2AMLogic/sky130-ldo/sim/README.md

# sim/ — the simulation harness and its evidence records

This directory holds the reproducible xschem + ngspice + sky130 harness and the
results it produces. Two rules from the root `CLAUDE.md` shape everything here:

- **Verification is the product.** No claim without a testbench. Every recorded
  result carries a PVT corner matrix unless the record states why a subset was
  used — the runner *enforces* that by refusing to write a subset record
  without a `--subset-reason`.
- **`sim/` is append-only evidence.** Records are never edited or deleted. A
  re-run — even one that corrects a mistake — mints a new record id; a
  correction points at what it replaces via a `Supersedes` field. The runner
  refuses to start if the record id it would mint already exists on disk.

The directory layout, record-id scheme and summary-record fields are ported
from the sibling [`sky130-bandgap`](https://github.com/2AMLogic/sky130-bandgap)
repo's harness (same PDK, same pin, issue #2), so the two evidence trails read
as one house style. `pdk-smoke` below is harness plumbing only (PDK/tool
liveness, not a spec claim). The block's own testbenches — `load-transient`,
`psrr-dc`, `dropout-vs-load` (issue #18), `loop-gain` (issue #25) and the three
protection/transient benches `current-limit`, `startup`, `enable-shutdown`
(issue #65) — each
exercise the LDO core-regulation-loop schematic from issue #14
(`design/ldo_3v3in_1v8out.sch`, instantiated via its companion subcircuit
symbol `design/ldo_3v3in_1v8out.sym`) against a row of
`spec/target-spec.md`. That table is **RATIFIED** (issue #1 / DR-006; the Iq
row is the one row DR-006 left open, and is set by `DR-009`, which is still
`proposed` and ratifies on its own PR merge), so every measurement bound
these testbenches use cites a ratified spec row verbatim rather than an
invented "final" number, and each experiment's `claim` says so. Records
minted before ratification quote the manifest `claim` as it then read, in
DRAFT wording — `sim/` evidence is append-only, so that wording stays as
history rather than being rewritten in place. Issues #18 and #25 stood the
harness up with explicit `--quick` subsets (3 corners, `--subset-reason`
cited in the record);
issue #19 ran the full 45-point PVT matrix declared in each experiment's
`experiment.json` for all four (`load-transient`, `psrr-dc`,
`dropout-vs-load`, `loop-gain`), plus a Monte Carlo/mismatch experiment
(`mc-output-accuracy/`, see "Monte Carlo / mismatch experiments" below) for the
one spec row that carries a statistical (population) claim rather than a
PVT-corner claim. Those full-matrix records are pinned to the *current*
schematic (post-#35/#36); the earlier `…-879f035` full-matrix set is superseded
— see "Which record set is authoritative" below. **All four testbenches still
record `FAIL`** against their spec bounds — an honest, expected finding given
this schematic's remaining known gaps (see `design/README.md`'s "Known gaps /
follow-on scope"), not a harness defect. Issue #65's three benches follow the
same two-step shape one issue later: their first records are `--quick`
subsets, and issue #74 then ran the full 45-point matrix each of their
manifests declares (39-42/45 PASS across the three; see "The protection /
transient testbenches (issue #65)" below for per-bench results and #93 for
a new finding the full matrix surfaced). Issue #19's own guardrail — that
none of this was a pass/fail verdict against a *ratified* spec, because #1 was
still open — has since been overtaken: issue #1 ratified the table (DR-006)
and closed 2026-09-18. Records minted before that date cite the row in its
then-current DRAFT wording; records minted since cite the same numbers as
ratified. Ratification fixes the targets — it does not turn any of the
`FAIL`s below into passes. Three further testbenches — `line-regulation`,
`load-regulation` and `iq` (issue #64) — landed later against the three rows
the four above don't cover; they still use discrete `.op` points rather than
the corner runner's usual `.dc`/`.tran` sweep style. They shipped
`--quick`-only at first; issue #104 then ran the full 45-point PVT matrix
each manifest declares for all three, mirroring issue #74's extension of the
#65 benches — see "Line regulation, load regulation and Iq (issue #64)"
below for why the
discrete-point convention was chosen and for the full results.

> **Record-generation note (2026-08-25, issue #69).** Issue #69 re-sized the
> thermal shutdown in the shared DUT schematic and re-ran **eight**
> experiments against it, minting a `…-4cb27f8` generation that supersedes
> the `…-81dc232` (the four PVT benches plus `mc-output-accuracy`) and
> `…-703a889` (the three #65 benches) record ids several per-testbench
> sections below still name. Those sections are kept as written because their
> *analysis* is what the superseded records actually say; for the current
> numbers and the old→new mapping, read "Which record set is authoritative,
> part 2 (issue #69)" below. One verdict changed outright: `current-limit`
> went **overall PASS** on its 3-point subset — though issue #74's later
> full-matrix record now supersedes that subset for the report's purposes,
> see part 2's parallel-landings table.
>
> **Four benches were deliberately *not* part of that re-run, because they
> landed on `main` in parallel with #69's branch and did not exist when it was
> cut**: `line-regulation`, `load-regulation` and `iq` (issue #64) and
> `thermal` (issue #66). All four instantiate the same DUT, so #69's re-sizing
> makes their committed netlist snapshots stale, and
> `measurements/characterization.md` now reports all four `STALE` — correctly,
> and by design rather than by oversight. `sim/thermal`'s 15-point record in
> particular characterizes the **pre-#69** trip points, so its 5/15 verdict
> and every trip/reset number in it must be re-read as "before the fix" until
> that bench is re-run. Two further parallel landings interact with #69's
> re-run the same way — #83's `dropout-vs-load` methodology fix and #76/#86's
> `current-limit` leg-3 enable ramp — and are spelled out in
> `design/README.md` → "Parallel landings on `main`, and what they leave
> stale".

> **Record-generation note (2026-09-23, issue #116).** #116 re-sized the shared
> DUT's **pass device** (`M_PASS` `W_total` 2500 µm → 5000 µm, and `M_SENSE`
> with it to hold the current-limit sense ratio) after DR-011 found DR-003's
> sizing derivation was taken at the wrong bias point — see
> `spec/decision-records/DR-011-pass-device-resize.md` (including its
> 2026-09-23 correction note: an early single-`.op`-point screen claimed a
> clean closure that does not reproduce — trust the full-matrix record below,
> not that screen). It re-ran **one** experiment against the re-sized DUT:
> `dropout-vs-load`, the row it was filed against. New record
> `20260923-123440-d71f4b3` supersedes `20260825-081240-4cb27f8`: **0/45 →
> 6/45 PASS** (best case 268 mV, was 365 mV) — real, substantial improvement at
> `−40 °C`/`27 °C` (all five process corners), but 125 °C corners are
> additionally volatile (5 of 15 points get numerically *worse*, consistent
> with the pre-existing mechanism-4 dc-solution-multiplicity finding
> `design/README.md` already documents, apparently made more pervasive by the
> resize) — read 125 °C `dropout-vs-load` numbers with that same caution, not
> as literal measurements.
>
> **Every other bench here instantiates the same DUT and was deliberately not
> re-run**, exactly as the #69 note above describes: their committed netlist
> snapshots are stale by construction and `measurements/characterization.md`
> reports them `STALE` — correctly, and by design rather than by oversight.
> Read every non-`dropout-vs-load` verdict in this directory as
> **"against the 2500 µm pass device"** until its bench is re-run. The
> `Stability` row deserves particular caution: a wider pass device moves the
> output pole and raises `gm_pass`, `C_COMP`/`R_CZ` were **not** re-derived,
> and `sim/loop-gain`'s 7/45 is a pre-#116 number. A follow-up issue owns the
> campaign re-run; #116's PR names it.

> **Record-generation note (2026-09-25, issue #118).** Three more of the benches
> the #116 note above leaves `STALE` have now been re-run against the re-sized
> DUT, and all three are `fresh` again:
> `mc-output-accuracy` (`20260925-110312-8280915`, supersedes
> `20260825-083111-4cb27f8`: **177/200 → 185/200**),
> `load-regulation` (`20260925-111601-7701e7e`, supersedes
> `20260910-032854-6c0436d`: **34/45 → 37/45**) and
> `line-regulation` (`20260925-114251-1f54ca6`, supersedes
> `20260910-030557-6c0436d`: **18/45 → 24/45**). Every row improved; every row
> still reports `FAIL`. `design/ldo_3v3in_1v8out.sch` is **unchanged** by #118.
>
> **More important than the counts is what #118 found underneath them**, and it
> changes how every number in these three records should be read: the failures
> are not accuracy failures at all. They are points where the circuit is not on
> its intended regulating branch — the mechanism-4 / second-stable-equilibrium
> family `#60`/`#71`/`#81` root-caused, which this issue shows binds all three
> rows and is reachable under **mismatch alone at 27 °C/1 mA**, not only at
> `#81`'s 125 °C/50 mA. Two consequences for reading this directory:
>
> - **Line regulation's own `supply_v` axis is a negative control** — the deck
>   `alter`s VIN itself, so that axis cannot reach the measured quantity — and
>   22 of 30 (group × measurement) cells disagree across it by more than 2×.
>   Its corner-level verdicts are branch-selection outcomes, not measurements.
>   (**#196 named what that axis was reaching instead**: `EN`'s high level,
>   which the bench keyed off `'vsup'` while `VIN` moved independently. With
>   `EN` at the instantaneous VIN the axis is inert by construction, and the
>   45-corner re-run under that convention — record `20260926-200304-35b7392`
>   — brings all 30 of those cells back **identical to every stored digit**:
>   the axis disagreed with itself because it was a stimulus axis after all,
>   through `EN`. See "#196" below.)
> - **On the regulating branch all three rows are inside their bounds**, with
>   exactly one exception in the whole set: `load-regulation`'s
>   `fs_125c_3.63v` at 19.93 mV against 18 mV. That single corner is the only
>   genuine DC-accuracy gap the three rows contain.
>
> The full decomposition, with the per-record numbers behind each claim, is in
> `design/README.md` → "#118: the three DC-accuracy rows do share one
> mechanism…". The design campaign it leaves open is **#164**; the `klt sim`
> request-shape gap that keeps both regulation matrices off the batch fleet is
> 2AMLogic/klayout-tools#2482.

---

## Contents

This file is the harness reference and index. The per-experiment and
per-topic sections below were moved verbatim to `sim/docs/`:

- [Initial-condition contract (issue #171)](docs/initial-condition-contract.md)
- [The LDO's own testbenches (issues #18 and #25)](docs/ldo-testbenches.md)
- [Line regulation, load regulation and Iq (issue #64)](docs/line-load-regulation-iq.md)
- [Monte Carlo / mismatch experiments](docs/monte-carlo-mismatch.md)
- [`sim/selftest.sh` — the harness acceptance test](docs/selftest.md)
- [`check:ci` vs. netlisting the LDO core (issue #38)](docs/check-ci-vs-netlisting.md)
- [Standalone regenerative thermal comparator (#229)](docs/thermal-regen-comparator.md)
- [Integrated regenerative comparator (#230)](docs/integrated-regen-comparator.md)
- [Experiment and solver freshness (#237)](docs/freshness.md)

## Quick start (cold machine)

```bash
# 1. install the pinned PDK (~1 min; see sim/pdk.json for the pin)
volare enable --pdk sky130 c6d73a35f524070e85faff4a6a9eef49553ebc2b

# 2. sanity-check the toolchain and PDK resolution
python3 sim/bin/corner-run.py --check-env

# 3. run the harness acceptance test (unit tests + a quick PVT subset)
sim/selftest.sh --quick

# 4. run the harness smoke test over the full PVT matrix (45 points, ~4 min)
python3 sim/bin/corner-run.py sim/pdk-smoke
```

Prerequisites, all machine-level (not vendored here): `ngspice`, `xschem`,
`volare`, `python3` (3.9+, standard library only). See
`docs/environment-setup.md` for the full reproducible bring-up.

### Driving the tools by hand

```bash
source sim/bin/pdk-env.sh      # exports PDK_ROOT, PDK, SKY130_MODEL_LIB, XSCHEM_RCFILE
xschem --rcfile "$XSCHEM_RCFILE" sim/pdk-smoke/testbench/tb_pdk_smoke.sch
cp sim/spiceinit ./.spiceinit  # ngspice needs these settings to read PDK libs
                               # -- and to pick the same linear solver the
                               # records were produced with (see "Reproducing
                               # a corner by hand" below)
```

`sim/bin/pdk-env.sh` is a thin wrapper around `corner-run.py --print-env`, so
interactive sessions and the runner resolve the PDK identically.

---

## How the harness is wired

| Piece | File | Role |
|---|---|---|
| PDK pin | `sim/pdk.json` | open_pdks commit, variant, model-library path, the process-corner names that actually exist in the PDK library |
| ngspice settings | `sim/spiceinit` | `ngbehavior=hsa` etc. required to read the sky130 libs; copied into the scratch run dir as `.spiceinit` |
| xschem config | `sim/xschemrc` | project-local rc that sources the PDK's own xschemrc (so `sky130_fd_pr/*.sym` resolves) and keeps generated netlists out of the tracked tree |
| corner runner | `sim/bin/corner-run.py` | netlist → deck → ngspice → parse → record; also `--check-env` / `--print-env` |
| Monte Carlo runner | `sim/bin/mc-run.py` | netlist → `klt sim` mismatch request → record; see "Monte Carlo / mismatch experiments" below |
| env helper | `sim/bin/pdk-env.sh` | `source` it for interactive xschem/ngspice work |
| acceptance test | `sim/selftest.sh` | unit tests + `--check-env` + an end-to-end PVT run; see below |
| unit tests | `sim/tests/` | PDK-free coverage of the runner's pure helper functions |
| experiment | `sim/<slug>/experiment.json` | what is being claimed, which corners, which measurements and their limits |

**PDK resolution order**: `$PDK_ROOT` → `volare path` → `default_pdk_root` from
`sim/pdk.json`; variant from `$PDK` → `variant` in `sim/pdk.json`. The runner
resolves the PDK directory symlink back to its volare version hash and
**refuses to run against a version other than the pin** unless
`--allow-pdk-mismatch` is passed — in which case the record says so.

> **The root the runner resolves is also the root `klt` reads** — which took a
> fix to be true (issue #211). A `klt sim` request names `models.lib` by a
> *relative* path, so `klt` resolves the PDK root itself if nothing says
> otherwise, and `mc-run.py` used to pass it no `PDK_ROOT`. On a host carrying
> two sky130A installs (e.g. a `volare` root and a `ciel` one, an ordinary state
> after following the tooling's own migration) that meant `mc-run.py` could
> verify one root against the pin and record `matches_pin: true` while `klt sim`
> read the *other* — a different open_pdks build whose
> `libs.tech/combined/continuous/models_fet.spice`, the FET cards a mismatch
> campaign draws from, is not byte-identical. A record naming a commit the
> simulation never read is a false provenance claim, and it is silent: the
> numbers look fine. `mc-run.py` now passes `PDK_ROOT` explicitly **and**
> asserts after the run that `klt`'s own `provenance.pdk.version` names the
> pinned commit (`--allow-pdk-mismatch` downgrades that to a warning, the same
> escape hatch the pre-run check offers), so this fails loudly instead. Any
> local `mc-output-accuracy*` record minted before #211 should be read with
> that in mind — check its response's `provenance.pdk` rather than only the
> record's `pdk` block. Filed generically upstream as
> [klayout-tools#2564](https://github.com/2AMLogic/klayout-tools/issues/2564).

**What the runner injects** (so one testbench serves the whole matrix): the
`.lib <models> <corner>` include, `.temp`, `.param vsup=<supply>`, `.option`s
from the manifest, and the `.control` block that runs the analyses, evaluates
each measurement expression into a `meas_<name>` vector and prints it. The
testbench schematic therefore contains no corner, no temperature, no numeric
supply and no analysis block.

**Per-corner artifacts**: each corner's `.log` embeds **both** inputs ngspice
was given (each prefixed with `|`) — the deck, and the `.spiceinit` that was in
the run directory, with its `sha256` — plus raw stdout/stderr, so a record is
auditable without regenerating anything. Scratch decks and xschem output live
in the gitignored `sim/build/`; only the netlist snapshot, the per-corner logs
and the record are committed.

### Reproducing a corner by hand (issue #190)

**The deck is only half the input. `.spiceinit` is the other half, and it is
not optional.** ngspice reads `.spiceinit` from its working directory at
startup; `sim/spiceinit` sets `option klu` (the KLU direct linear solver)
alongside the `ngbehavior=hsa` settings needed to read the PDK libraries. A
different linear solver can reach a different judgement about matrix
singularity on the same circuit — so a deck re-run **without** `.spiceinit` can
produce bit-identical measurements and yet emit none of the solver diagnostics
that the `#171` gate turned into the corner's recorded `FAIL` (measured; see
the `#179` section below). Reproducing a corner without it is therefore not
reproducing the corner.

The general recipe, for any corner of any record:

```bash
mkdir -p /tmp/repro && cd /tmp/repro
# 1. extract the `|`-prefixed deck from the corner log into <corner>.spice
#    (the log's own header block spells this out, including the ngspice line)
# 2. put the ngspice init settings in place -- REQUIRED, not a convenience:
cp "$REPO/sim/spiceinit" ./.spiceinit    # or the `|`-prefixed .spiceinit
                                         # block embedded in the same log
source "$REPO/sim/bin/pdk-env.sh"        # PDK_ROOT etc., same as the runner
ngspice -b <corner>.spice < /dev/null
```

Prefer the `.spiceinit` **embedded in that corner's log** over today's
`sim/spiceinit` when reproducing an older record: the log holds the settings
that record actually ran under, and the record's own `ngspice init settings`
field carries their `sha256` so you can tell whether the tree has moved since.
Logs written before `#190` embed only the deck — for those, `sim/spiceinit`
at the record's `Repo state` sha is the right source.

---

## Directory / naming convention

```
sim/
  README.md                          # this file
  pdk.json                           # PDK version pin
  spiceinit                          # ngspice init settings
  xschemrc                           # project-local xschem config
  selftest.sh                        # harness acceptance test (issue #2)
  bin/
    corner-run.py                    # PVT corner runner (+ --check-env / --print-env)
    mc-run.py                        # Monte Carlo (mismatch) runner, via `klt sim`
    yield-run.py                     # yield/capability analysis of a committed MC response, via `klt yield`
    pdk-env.sh                       # `source` for interactive use
  tests/
    test_corner_run.py               # PDK-free unit tests for corner-run.py's helpers
    test_mc_run.py                   # PDK-free unit tests for mc-run.py's helpers
    test_yield_run.py                # PDK-free unit tests for yield-run.py's helpers
  build/                             # gitignored scratch (decks, xschem netlists)
  <experiment-slug>/                 # e.g. pdk-smoke (PVT), mc-output-accuracy (Monte Carlo)
    experiment.json                  # manifest: claim, corners, measurements, limits
    testbench/                       # xschem schematic(s) for this experiment
    netlist-snapshots/
      <record-id>.spice              # frozen netlist used for this record
    corners/                         # PVT experiments only
      <record-id>/
        <corner-id>.log              # deck + raw ngspice output per PVT point
    klt-requests/                    # Monte Carlo experiments only
      <record-id>.json               # the `klt sim` request actually submitted
      <record-id>.yield-limits.json  # `klt yield` runs only (issue #203)
    klt-responses/                   # Monte Carlo experiments only
      <record-id>.json               # `klt sim`'s full per-sample response (the raw evidence)
      <record-id>.yield.json         # `klt yield` runs only — a *derived* report (issue #203)
    records/
      <record-id>.md                 # append-only summary record (human)
      <record-id>.json               # same record, machine-readable
```

- **`<experiment-slug>`** — kebab-case name for the claim under test. One
  directory per distinct claim, not per run.
- **`<record-id>`** — `<YYYYMMDD>-<HHMMSS>-<short-git-sha>` in UTC. The same id
  ties together the netlist snapshot, the per-corner logs and both record
  files for one run. Re-runs mint a new id. A **derived** record (a `klt yield`
  analysis of an already-committed sample set — see "`klt yield` records"
  below) mints its *own* id and names the source campaign's id in its
  `Source campaign` block, rather than reusing it.
- **`<corner-id>`** — `<process>_<temp>c_<supply>v`, e.g. `ss_-40c_1.62v`,
  `tt_27c_1.80v`, `ff_125c_1.98v`.
- **`testbench/`** is not versioned per record. If a testbench change could
  affect comparability across records, say so in the new record (the frozen
  netlist snapshot is what actually pins what ran).

## Summary record fields

Each run writes `records/<record-id>.md` (and a `.json` twin with every parsed
number, limit and verdict, for tooling):

| Field | Meaning |
|---|---|
| Record ID | matches the filename, the snapshot and the `corners/` subdirectory |
| Experiment | slug + title from the manifest |
| Claim | which spec parameter/line this substantiates (`spec/target-spec.md#<row>`, ratified by issue #1 / DR-006); `pdk-smoke` is harness-only, not a spec claim |
| Netlist provenance | `schematic` (`design/…`, `sim/…/testbench/…`) or `extracted` (post-layout) — required so post-layout re-runs are distinguishable |
| PDK | variant + open_pdks commit actually used, whether it matches `sim/pdk.json`, and the model library path |
| Tools | ngspice / xschem / OS / python versions used |
| ngspice init settings | `sim/spiceinit` and its `sha256` — the second input ngspice was given (copied into the run directory as `.spiceinit`); it selects the linear solver, so reproducing a corner by hand requires it (issue #190). Absent from records minted before `#190`. |
| Repo state | short sha, branch, and whether the working tree was dirty at run time |
| Corner matrix run | the (process, temperature, supply) points actually executed; must be the full PVT matrix unless a subset reason is recorded |
| Statistical convention | N samples and sigma level for distribution claims; `N/A` for corner-matrix claims |
| Result | per-corner pass/fail with measured values, plus an overall verdict |
| Links | testbench, manifest, netlist snapshot, raw logs, json record |
| Timestamp / author | UTC timestamp and who (human or agent) ran it |
| Supersedes | prior `<record-id>` this corrects or re-runs; `(none)` otherwise |

### Append-only rule

`records/*` files are never edited or deleted after creation — this applies
even to typo fixes, because the append-only guarantee is the whole point of an
evidence trail. Corrections mint a new record that references the prior one via
**Supersedes**.

### Concurrent and interrupted runs (issue #310)

Record ids are second-resolution UTC time + short sha, so two invocations for
the same experiment in the same second pick the same id. `corner-run.py`,
`mc-run.py` and `yield-run.py` therefore take an **atomic reservation** (an
exclusive `mkdir` of `sim/build/.reservations/<experiment-dir>/<record-id>/`,
git-ignored scratch) *before* creating any scratch directory or evidence and
before netlisting or submission. The loser exits with an "already reserved"
error and writes nothing; unrelated experiments or ids are not serialized.
Final publication (snapshots, requests, responses, logs, `records/*`) also
opens files exclusively, so a replacement is refused even if the reservation
were bypassed. The existing "already exists -- append-only" check stays.

- `--dry-run` and `--no-write` take no reservation and write nothing under
  `sim/<experiment>/`; their scratch lives in a `<id>.ephemeral-<pid>` directory.
- A reservation is never released or deleted by the tools: a consumed id stays
  consumed, whether the run finished, failed or was killed.
- **Recovery after an interrupted run**: just re-run (a later second mints a
  fresh id). Partial evidence under `sim/<experiment>/` is left for a human to
  review, never overwritten or auto-deleted; supersede it with a new record.
  Never delete another process's reservation or evidence. A reservation's
  `owner.json` (pid/host/time) shows who holds it; remove a stale one by hand
  only when that process is gone and no evidence carries the id.
- Reservations are per scratch tree (`sim/build/`), i.e. per checkout; the
  committed-evidence guard (#283) and the append-only check cover cross-clone
  reuse.

---

## Writing a new experiment

1. `mkdir -p sim/<slug>/{testbench,netlist-snapshots,corners,records}`
2. Draw the testbench in xschem (`--rcfile sim/xschemrc`). Leave out the
   corner include, `.temp`, the numeric supply (use `'vsup'`) and any
   `.control` block — the runner owns those. Name the nets you intend to
   measure; connectivity by `lab_pin` label is fine.
3. Write `sim/<slug>/experiment.json` — see `sim/pdk-smoke/experiment.json`
   for a worked example. Process-corner names must appear in `sim/pdk.json`
   `process_corners`.
4. Run it: `python3 sim/bin/corner-run.py sim/<slug>`
5. Commit the produced record, netlist snapshot and per-corner logs. (The
   root `.gitignore` ignores `*.log` globally but un-ignores
   `sim/*/corners/**/*.log`, which is committed evidence.)

### Writing a new diagnostic probe (issue #353)

Single-corner ngspice probes under `sim/*/diagnostics/` should import
`sim/bin/_probe_common.py` rather than copy scaffolding from an earlier probe:
`load_corner_run()` (the `corner-run.py` module), `sha()`,
`logical_lines()`/`find_card()` (netlist editing; accept a string or a list of
lines), `run_ngspice_deck(run_dir)` (returns `(log, elapsed_s, returncode)` and
writes `ngspice.log`), `git_provenance()` and `load_results()`. Existing
diagnostics run-id directories are append-only evidence and keep their own
copies unedited; the helper is forward-only. Tests: `sim/tests/test_probe_common.py`.

### Writing a new batch-fleet campaign driver (issue #574)

A campaign driver — one that netlists a testbench once, text-edits a per-case
variant of that body, writes one `klt sim` request per case and sends the lot to
the batch fleet — should import `sim/bin/_fleet_campaign.py` rather than copy an
earlier driver. It holds the whole shared core: `preamble()` (host worker cap,
refuse-to-overwrite, `pdk.json` + `PDK_ROOT`), `netlist()` (optionally with a
candidate patch applied for netlisting only), `sub_line()`, `insert_in_subckt()` /
`insert_loop_gain_probe()` + `LOOP_GAIN_PROBE` / `LOOP_TRANSFER_MEAS`, `deck()`,
`base_request()`, `submit()` and `submit_all()` (the executor, the status print and
the `SUBMIT FAILED (no local fallback)` branch — host rule: a refused submit is
reported, never re-run as a local grid).

Row shaping stays in the driver on purpose: `submit_all()` yields
`(key, meta, response, job_id)` and `corner_base()` supplies only the fields every
record shares, so each campaign keeps emitting the `summary.json` shape its own
append-only record family already uses. `sim/bin/bias-retopo-pvt.py`,
`sim/bin/rcz-fleet-confirm.py` and `sim/bin/rcz-adaptive-370.py` are the three
drivers on it. Tests: `sim/tests/test_fleet_campaign_574.py`.

### Runner options

| Flag | Effect |
|---|---|
| `--check-env` | check ngspice/xschem/volare/PDK are usable and exit (0 if all OK) |
| `--print-env` | print PDK env exports and exit |
| `--process tt,ss` / `--temp 27` / `--supply 1.8` | override a matrix axis (marks the run a subset) |
| `--quick` | run the manifest's `quick_subset` only |
| `--subset-reason "…"` | **required** for any subset; recorded verbatim |
| `--leg-order a,b,…` | for an experiment with a `window_grid`: run the legs in this order (must be a permutation of the declared legs) — the leg-order independence smoke check, "COUT/ESR window grid" below |
| `--supersedes <record-id>` | record which prior record this replaces |
| `--author`, `--timeout` | record author (default `git config user.email`), per-corner ngspice timeout |
| `--allow-pdk-mismatch` | run against a non-pinned PDK; the record flags it |
| `--backend {local,batch}` | `local` (default) runs ngspice here. `batch` is the opt-in `klt sim` batch backend, **`sim/pdk-smoke` and the `sim/load-transient` window grid only** — see "Batch backend" below |
| `--dry-run` | netlist, print the corner list and one deck, run nothing, write nothing (with `--backend batch`: print the `klt sim` requests, submit nothing) |
| `--no-write` | run every corner for real (ngspice included) but skip writing an evidence record — for CI/selftest liveness runs that should not mint new evidence on every push |

Exit status: `0` all checks passed, `2` a record was written (or would have
been, under `--no-write`) but something failed, `1` harness/setup error (no
record written).

### COUT/ESR window grid (issue #313)

An experiment may declare a `window_grid` in `experiment.json` to walk a
finite grid of an external-network window *inside one deck, per PVT corner*.
`sim/load-transient` does, for DR-002's ratified window (0.33-4.7 µF,
0-500 mΩ, no minimum ESR):

- **Grid.** COUT ∈ {0.33 µF, 4.7 µF} × ESR ∈ {0, 10 mΩ, 500 mΩ} = six legs,
  including the 4.7 µF / 10 mΩ reference point of #119. `window_grid.justification`
  says why these points; `window_grid.sampling_statement` says what they are
  not: the grid **samples** the window, it is not a continuous proof, and a
  passing grid cannot rule out an interior worst case.
- **Legs are independent.** For each leg the runner emits `reset`, `save all`,
  *all* of the leg's `alter` cards, its own `tran` (which re-solves the
  `.ic`-seeded operating point of the #171/#180 contract) and its own
  measurements. Nothing carries over between legs; `--leg-order` re-runs the
  same legs in another order so that independence can be checked (identical
  values required).
- **Zero ESR** is an electrically equivalent topology, not a tiny resistor: the
  testbench has a second capacitor `CDIR` wired straight from VOUT to ground. An
  ESR = 0 leg sets `CDIR` to the full COUT and the series `COUT`+`RESR` branch to
  0 F (open); ESR > 0 legs do the reverse.
- **Result naming.** A `per_leg` measurement template in `measurements` is
  expanded per leg to `<name>__<leg>` (e.g. `recovery_fall_us__c330n_esr500m`);
  each result row carries `leg`, `cout_f`, `esr_ohm` and `direction`
  (`rise` = 1→50 mA edge, `fall` = 50→1 mA edge) alongside the corner's
  process/temperature/supply. The 150 mV and 20 µs bounds are unchanged.
- **Baseline gate (issue #372).** The peak/recovery measurements are relative
  to the pre-step output, so each leg also carries `vout_pre_v__<leg>`
  (`direction: pre`), the absolute pre-step output bounded inclusively to the
  Output window, 1.764-1.836 V; a failing baseline fails the leg and corner.
  This adds a measurement per leg (8 per leg, 48 per corner), so grid counts
  and input fingerprints change: records made before #372 predate the gate and
  are stale for it; a new campaign mints new evidence.
- **Aggregation is conservative** (`grid_coverage` in `corner-run.py`). The
  expected set is derived from the manifest and the corner matrix, not from the
  results: the grid PASSes only if every declared (corner × COUT × ESR ×
  direction) measurement is present, finite, inside its bounds and flagged
  passing. A missing leg or corner, a NaN/unparsable value, or one failed
  condition ⇒ FAIL. The verdict is stored as the record's `window_grid` block and
  folded into `overall_pass`.
- **Two coverage axes.** The characterization report keeps PVT coverage (subset
  flag/reason) apart from COUT/ESR coverage. A record with no `window_grid`
  block — every record minted before #313 — is reported as "grid declared but
  not yet evidenced", with no claim of window qualification.
- **Scope.** Phase A (#313) is the harness, reporting and PDK-free tests plus a
  single-corner local smoke; no full-grid × PVT campaign is minted by it. The
  campaign (Phase B, #326) is separate and is never run as a local 45-corner
  grid on the dispatch worker: #326 added the batch path for it (see "Window
  grid on the batch backend (issue #326)"), and the campaign is minted only once
  the fleet runner accepts the job.

### Startup ramp monotonicity (issue #309)

`sim/startup` declares a `ramp_monotonicity` block in `experiment.json`;
`sim/bin/ramp_monotonicity.py` (standard library only, PDK-free) evaluates it
for each independent cold-enable leg of every corner: the four 10 mOhm legs
before issue #336, the twelve `window_grid` legs since (see "Startup ESR grid"
below; leg ids are `<cout>_<load>_<esr>`, e.g. `c4u7_50ma_esr500m`). This is local-only post-processing:
`--backend batch` refuses any manifest carrying the block.

- **Trace.** After each leg's `tran`, the deck runs
  `wrdata {corner_id}.{leg_id}.trace.dat v(vout)` (`{corner_id}`/`{leg_id}` are
  substituted by the runner). Writing a record copies the raw files next to the corner logs
  in `corners/<record id>/`; the per-leg sha256 is in the JSON record. Under
  `--no-write` the trace is graded but not retained.
- **Measurement window.** From the first sample at or after the enable instant
  (`t_enable_s`, 100 us) up to and including the first sample with
  `V(VOUT) >= v_low` (1.764 V, the lower edge of the ratified window). The
  metric is the maximum drawdown `running_max - v` over that window, reported
  with the interval (time of the running maximum, time of the trough) of the
  worst drawdown. Post-entry behaviour is not examined here: overshoot stays
  with `vpk_*` and the settled window with `vfloor_*`, so ramp monotonicity is
  kept distinct from post-settling ripple.
- **Verdicts.** PASS needs a valid trace with drawdown <= `tolerance_v`.
  FAIL is a valid trace with a larger drawdown. INVALID (never PASS, and the
  corner FAILs) is a missing/unreadable/empty file, mismatched columns,
  nonfinite values, non-strictly-increasing time, a trace that starts after
  enable, never enters the window, has fewer than `min_samples` window
  samples, or has a sample gap above `max_dt_s`.
- **Numerical uncertainty and resolution.** The claim is about the SAMPLED
  trace only. A dip shorter than the worst window sample gap (reported per leg
  as `resolution_s`; bounded by `max_dt_s` = 20 us, ngspice `tran` print step
  10 us) can be missed. Dips are compared at the ngspice-printed precision
  with `tolerance_v = 0.0` (strict, recorded in every result); solver noise
  below the printed precision is not distinguishable and is not separately
  budgeted. The tolerance is **not** a physical allowance: it must not be
  raised to pass a result.
- **Open decision-record question.** The ratified row says "monotonic"
  without a tolerance. If a physical dip (or noise) allowance is judged
  acceptable, that needs a decision record under `spec/`; none is chosen here
  and `spec/` is unchanged.
- **First observation (not a record).** A single-corner `--no-write` smoke
  run (tt, 27 C, 3.30 V; wiring check only, no evidence minted) shows all four
  legs at strict `tolerance_v = 0` FAIL with drawdowns of 2 uV to 32 uV: VOUT
  sags by that amount in the first ~18 us after the enable edge, while still at
  the sub-mV pre-ramp level, before the soft-start ramp takes over. That is
  physical-looking, far below any window edge, and exactly the case the open
  decision-record question above covers. The checker deliberately does not
  hide it with a tolerance; a decision record must say whether such a dip is
  acceptable (and over what window) before any tolerance is set.
- **Records.** Records minted before #309 did not measure monotonicity; they
  are untouched and, because the manifest's analyses, measurements and
  checker settings are part of the input fingerprint, the report marks them
  STALE rather than presenting them as having measured it. Full-matrix
  refresh remains #231.

### Startup ESR grid (issue #336)

`sim/startup` previously fixed R_ESR at 10 mOhm and left the ESR axis to
`sim/loop-gain`, which is a small-signal view and cannot show nonlinear startup
overshoot or ramp monotonicity at the DR-002 ESR boundaries. The operator
authorised sampling it (issue #336, 2026-10-15). The manifest now declares a
`window_grid` (the #313 mechanism) of **twelve legs**: C_out {0.33 uF, 4.7 uF}
x load {0 mA, 50 mA} x ESR {0, 10 mOhm, 500 mOhm}. The 10 mOhm legs are the
pre-#336 four points. Ratified targets, DR-002, the 3 ms reading of "a few ms",
the strict 0 V monotonicity tolerance and the sampled-trace scope are unchanged.

- **Independent cold starts.** Each leg is `reset`, `save all`, its own
  `alter cout/resr/cdir/rload`, then its own `tran` from the disabled
  (EN = 0 V until 100 us) t = 0 operating point; no leg inherits state. ESR = 0
  uses the testbench's `CDIR` direct-to-ground branch exactly as `sim/load-transient`
  does (no stand-in resistor). `--leg-order` permutes the blocks; the headless
  tests (`sim/tests/test_startup_esr_grid_336.py`) check leg expansion,
  coordinate identity, per-leg `alter` cards and that reordering changes order only.
- **Every leg retains** its `V(VOUT)` trace, `vpk_v`, `vfloor_v`, `tramp_ms`
  (names carry the leg id, `vpk_v__<leg>`) and the ramp drawdown / worst sample
  gap / window-sample count. A missing, unparsable or insufficiently sampled trace
  is INVALID and never qualifies.
- **Grid verdict.** `grid_coverage` counts the 36 per-leg measurements **and** the 12
  per-leg ramp verdicts per corner as declared conditions; a missing or failing one
  can only lower the verdict. A declared grid without results cannot qualify.
- **Sampling, not proof.** Twelve points sample the window; an interior worst case is
  not excluded. Characterization must disclose the grid actually evidenced.
- **Pilot (step 1, done).** `sim/startup/pilots/20261015-336-cold-start-pilot.md` is a
  single-corner (tt/27 C/3.30 V) independence pilot, **not** an evidence record:
  forward and reversed leg order give identical measurements and byte-identical
  traces. It also shows strict monotonicity FAILing on all twelve legs at 2-32 uV
  (the open decision-record question in "Startup ramp monotonicity" above).
- **Campaign (step 2, NOT done).** The append-only 45-point PVT record has not been
  minted. `--backend batch` still refuses `ramp_monotonicity` (it needs the raw
  `V(VOUT)` traces back, which the batch path does not hand back in the
  `wrdata` form the checker reads; klt can retain rawfiles but the converter is
  tracked upstream as 2AMLogic/klayout-tools#3360), and a 540-transient
  grid must not be hand-launched on a shared worker. Run it on an authorised capable
  runner once trace-returning execution exists; coordinate the rerun with #231.

### Batch backend (issue #298)

`python3 sim/bin/corner-run.py sim/pdk-smoke --backend batch` sends the PVT
grid to `klt sim --backend batch` instead of running ngspice here. It is
**opt-in and deliberately bounded**: the allowlist is `sim/pdk-smoke` with its
single `op` analysis and two scalar measurements (`vgs`, `isup`),
`sim/load-transient`'s COUT/ESR window grid (issue #326, below) and
`sim/dropout-vs-load`'s cold-start crossing in its validated shape (issue
#374, below) and `sim/line-regulation`'s four cold-start endpoints in their
validated shape (issue #379, below) and `sim/load-regulation`'s two
cold-start endpoints in their validated shape (issue #381, below) and `sim/iq`'s
two cold-start endpoints (issue #213, below). Every other
manifest — `current-limit`,
`enable-shutdown`, `ic-screen-125c-*`, `loop-gain`,
`psrr-dc`, `startup`, `thermal`, and the `mc-*` experiments (which have their
own runner, `mc-run.py`) — and any edited smoke, window-grid or dropout shape
is **refused before netlisting, submission or local ngspice**. The other
regulation grids stay deferred on translating their measurement cards.

- **Requests.** The supply is the netlist's `.param vsup`, not a klt corner
  axis (klt's supply override alters sources, which is not this harness's
  parameter). A full or CLI-overridden Cartesian matrix is therefore split
  **by supply**: the default run is three requests, each with five process
  values and three temperatures (45 unique points). `--quick` submits one
  singleton request per explicit tuple — never a Cartesian expansion of them.
  Each request's netlist opens with `.param vsup=<that supply>`, then the
  deck params/options (`.option wnflag=1`) and `.save all`, then the circuit.
  `options.ngspice_init` carries the non-empty lines of `sim/spiceinit`
  verbatim and in order; `PDK_ROOT` is passed to `klt` explicitly.
- **Grading stays local.** Results are reassembled in the local matrix order
  and graded by this harness: inclusive min/max limits, the `spread_checks`,
  and the strict solver-diagnostic gate applied to each retained engine log.
  klt's own verdict is never substituted for `overall_pass`, and a klt
  "recovered warning" is not the harness's gate. A missing/unreadable engine
  log cannot PASS.
- **Failures never become PASS and never fall back.** A malformed/error-envelope
  response, a nonzero tool exit without a valid response, a subprocess
  timeout, or a missing/duplicate/unexpected/malformed point, or a klt PDK
  provenance that does not name the pin (the shared check `mc-run.py` uses),
  aborts with exit `1`, **no record**, the klt stdout/stderr and any remote
  job ids kept in the scratch run dir (`sim/build/...`) and printed. There is
  no local fallback and no resubmission after an ambiguous timeout. The one
  retried failure is a fleet-capacity refusal (`exceeds
  BATCH_MAX_CONCURRENT_INSTANCES`) with no job id seen: it is resubmitted every
  90 s for at most 3 h, then aborts. Requests also carry
  `batch.capacity_wait_s` for a klt that waits on its own. An
  errored/inconclusive corner, an absent or non-finite value, or an out-of-
  limits value is a recorded FAIL (exit `2`) with its reason.
- **Evidence.** A batch record adds `klt-requests/`, `klt-responses/` (raw)
  and `klt-request-netlists/` files named `<record-id>.<request>.<ext>`, the
  per-corner engine logs under `corners/<record-id>/`, and an `execution`
  block / "Execution backend" line naming the requested backend, the
  backend, engine version and job id **as klt reported them**, and whether
  klt's PDK provenance names the pin. The record's ngspice is the remote
  executor's, and no local ngspice exit code is recorded for these corners.
  Local records are unchanged. The same append-only overwrite refusal,
  `--dry-run` and `--no-write` rules apply.

#### Window grid on the batch backend (issue #326)

`python3 sim/bin/corner-run.py sim/load-transient --backend batch` runs the
COUT/ESR window grid off-host. `sim/bin/batch_window_grid.py` (PDK-free)
translates `window_grid.leg_analyses` into a `klt sim` **`analysis_steps`**
request (klt >= 0.7) with exactly one step per leg:

| local leg block | klt request |
|---|---|
| `reset` | **one request per supply × leg**: every (corner, leg) is its own ngspice process, so nothing carries over between legs (klt's step sequence has no `reset`, 2AMLogic/klayout-tools#3103, so legs are never packed as several steps of one request) |
| `save all` | klt's control block already saves all |
| `alter <elem> = {placeholder}` | the step's `alter` map, same numbers as the local deck (`leg_values`, shared by both paths) |
| `tran 200n 3m` | the step's `analysis` (exactly one) |
| `meas tran <name> ...` | a step measurement with the card as `spice` |
| `let <name> = <expr>` | inlined, parenthesised, into each graded expression (a klt step measurement must be a scalar, so the vector helpers `outband`/`w_rise`/`w_fall` cannot be declared on their own; see 2AMLogic/klayout-tools#3055) |

- **Shape guard.** The leg block must be exactly that vocabulary (`reset`,
  `save all`, alters with a `{placeholder}`, one `tran`, then `meas tran`/`let`),
  every measurement must be `per_leg`, `deck.analyses` must be comments only and
  there must be no `spread_checks`; anything else is refused before netlisting.
  `--leg-order` is refused under `--backend batch` (no in-deck order exists).
- **Requests.** Full matrix: 3 supplies × 6 legs = **18 requests** of 15 points
  (5 process × 3 temperatures); `--quick`: 3 points × 6 legs = 18 singletons.
  Keys are `<supply group>-<leg>`, e.g. `v3.30-c330n_esr0`.
- **Reassembly.** klt reports `<leg>.<template name>`; the harness maps that
  back to `<template name>__<leg>`, merges the six leg parts of each corner into
  one result (manifest order; the corner passes only if every leg part passed;
  each leg's engine log is concatenated into the corner log under a
  `window leg <id>` header), then grades and aggregates (`grid_coverage`)
  exactly as for a local run. A failing leg request aborts the run with no
  record and no fallback, like any other batch request.
- **Parity probe (2026-10-11, recorded in #326's PR).** One leg at one corner
  (tt / 27 °C / 3.30 V) was run through `klt sim --backend local` (single unit)
  and reproduced the local harness's values for that corner exactly
  (`c4u7_esr10m` hand-built, and the harness-generated `c330n_esr0` request).
  The same single-unit request submitted with `--backend batch` was **refused
  by the fleet runner** (`batch_runner_version_mismatch`, runner klt 0.5.0 vs
  client 0.7.0; 2AMLogic/klayout-tools#2948). Until the runner image is
  updated, the Phase B campaign cannot run; it is not run locally instead.

#### Dropout cold-start crossing on the batch backend (issue #374)

`python3 sim/bin/corner-run.py sim/dropout-vs-load --backend batch` runs the
dropout matrix off-host. `sim/bin/batch_dropout.py` (PDK-free) translates the
manifest's deck into a klt **`analysis_steps`** request with **one step**,
`dropout`, per fixed supply (default run: 3 requests of 5 process × 3
temperatures; `--quick`: 3 singletons). klt renders that step back into the
same control commands the local deck runs, in the same order:

| local deck (`deck.analyses`) | klt request |
|---|---|
| `tran 10u 14m uic` | the step's `analysis` (`kind: tran`, `args` verbatim): the `uic` cold start, no operating-point solve |
| `meas tran dropout_vin_x find v(vin) when v(vout)=1.764 fall=1 td=6m` | a step measurement with the card as `spice` (klt emits `meas tran ...` against the step's own plot) |
| `meas tran vout_at_max_vin_v avg v(vout) from=5.5m to=6m` | likewise; graded directly, since the measurement's `expr` is the card |
| `let meas_dropout_v = dropout_vin_x - 1.764` | a step `expr` measurement `dropout_v` (klt emits `let dropout_v = dropout_vin_x - 1.764`) |
| VIN ramp, EN edge, 50 mA load step | the netlist, sent verbatim (`.param vsup=<supply>` first) |

Results come back as `dropout.<name>` and are graded **locally** with the
manifest's own bounds (`dropout_v < 0.3` strict, `max_inclusive: false`, so
exactly 0.300 V fails; issue #335). Grading uses the same `grade_bounds` as
the local path.

- **Shape gate (before netlisting).** The deck must be one
  `tran <tstep> <tstop> uic` followed only by `meas tran` cards of two forms:
  a crossing `find v(a) when v(b)=X fall|rise|cross=N td=T` (at least one)
  or a window `avg v(a) from=T1 to=T2`. Each graded measurement is either a
  card (identity) or an expression over card names, numbers and `+ - * / ( )`.
  `window_grid`, `per_leg` and `spread_checks` are refused. This is not a
  general SPICE translator.
- **Renewal pin.** `BATCH_ALLOWLIST["dropout-vs-load"]["manifest_sections"]`
  pins the record input-fingerprint digests of the manifest's execution
  sections: `analyses` (deck options, params and commands; comments ignored),
  `measurements` (names, expressions, bounds and inclusivity) and `matrix`
  (axes and `quick_subset`). **Any** intentional change to them (a bound, the
  threshold, the time grid, an option, a corner) refuses the batch backend
  until someone re-validates the translation and updates the pins.
  `TestDropoutShapeGate.test_pins_equal_the_committed_manifest` fails at the
  same moment, so the change cannot land unnoticed. Edits to prose (`claim`,
  `note`, comment lines) do not affect the pin.
- **Netlist gate (before any request is written).** The VIN/EN/load stimulus
  lines must equal the validated ones exactly (one definition each), and the
  netlist may not carry `.ic`, `.nodeset`, `.control`/`.endc`, analysis
  cards, `.meas`/`.measure` or `.temp`, because each would change the cold
  start or conflict with klt's control block. A testbench stimulus change
  therefore also needs renewed validation.
- **Never PASS without a completed, compatible remote run.** In addition to
  the general batch rules above: the response must name a remote job whose
  state is `done` (or `failed` with a ran-to-report exit 0/3/4), and
  `runner_compatibility` must be `match`. `mismatch` or `unknown` means klt
  could not confirm that the runner honoured `options.ngspice_init` (the
  solver settings) and `expr` measurements (2AMLogic/klayout-tools#2917).
  Otherwise the run aborts with exit 1, writes no record and does not fall
  back. A missing crossing (klt: `value: null`, `status: "error"`, an
  error-severity diagnostic), any error-severity or `step_failed` klt
  diagnostic, a solver-diagnostic marker in the retained engine log, a
  missing log, or a missing, duplicate or non-finite value is a recorded
  FAIL.
- **Provenance.** Records carry the usual batch `execution` block plus
  `execution.adapter` (step, analysis, cards, graded names, the pinned
  digests and the stimulus lines) and a "Batch adapter" line. The input
  fingerprint, subset disclosure (`--subset-reason`), PDK/tool provenance
  and append-only handling are the same as for any other record.
- **Fixtures.** `sim/tests/test_batch_dropout_374.py` is headless. It covers
  the dry-run content, translation, the strict 0.300 V boundary, no
  crossing, solver/step diagnostics, missing and duplicate corners, remote
  error envelopes, unfinished or incompatible jobs, and the shape, pin and
  netlist gates. It also includes two **real** klt 0.7.0 responses captured
  with `klt sim --backend local` under `sim/tests/fixtures/issue-374/`: the
  harness-generated tt / 27 °C / 3.30 V request (`dropout_v` 0.397658 V,
  `vout_at_max_vin_v` 1.798832 V) and a PDK-free RC deck whose crossing
  never fires.

**Client-side parity (2026-10-11, single corner, host ngspice-46).** The
harness-generated request for tt / 27 °C / 3.30 V was run once through
`klt sim --backend local`. It reproduced the local harness on the same
netlist exactly: `dropout_v` = 0.397658 V and `vout_at_max_vin_v` =
1.798832 V. These match record `20261011-092557-7a4e0cc`. The klt engine log
shows "Operating point simulation skipped by 'uic'" and no solver
diagnostic. This validates the translation on this host. **It is not a
remote result.**

**Live fleet qualification: NOT performed (blocked).** `batch-preflight.py`
was run twice on 2026-10-11 (shortly after 22:06 UTC and at 22:16 UTC). Both times it exited
`1` before any job existed:
`batch-fleet-provision.sh launch failed (exit 1): error: 12 instance(s)
already running + 1 requested exceeds BATCH_MAX_CONCURRENT_INSTANCES=8`
(fleet concurrency cap, 2AMLogic/klayout-tools#2917). The runner/client
version question (2AMLogic/klayout-tools#2948) was therefore not reached.
The paired check is tracked in #375 and runs after the preflight exits `0`:

```bash
python3 sim/bin/batch-preflight.py                       # must exit 0 first
python3 sim/bin/corner-run.py sim/dropout-vs-load --backend batch \
    --process tt --temp 27 --supply 3.3 \
    --subset-reason "issue #374 paired local/remote baseline check" --no-write
python3 sim/bin/corner-run.py sim/dropout-vs-load \
    --process tt --temp 27 --supply 3.3 \
    --subset-reason "issue #374 paired local/remote baseline check" --no-write
```

Run both at the same commit. **Comparison tolerance:** equal at the printed
precision, |Δ| ≤ 1 µV on `dropout_v` and `vout_at_max_vin_v`, when the
remote `engine_version` equals the local ngspice. If the engine versions
differ, report Δ together with both versions and the request netlist sha256
(klt `environment.netlist_sha256`), and do not claim equivalence. Do not
widen the tolerance to absorb tool drift. A failed or incompatible preflight
only defers this check. It does not permit a local multi-corner campaign.
After a passing paired check, the full campaign is
`python3 sim/bin/corner-run.py sim/dropout-vs-load --backend batch`. That is
the batch command above without `--process/--temp/--supply`,
`--subset-reason` or `--no-write`.

#### Line regulation endpoints on the batch backend (issue #379)

`python3 sim/bin/corner-run.py sim/line-regulation --backend batch` is
**opt-in** (local stays the default). `sim/bin/batch_line_regulation.py`
(PDK-free) translates the deck's four independent cold-start points into
**one single-step `klt sim` request per supply group x endpoint**. The step is
named `tran<N>` after the local plot it replaces, so klt returns
`tran<N>.<card>`, the same plot-qualified identity the manifest's expressions
use.

| local deck | klt request |
|---|---|
| `set vinpt` / `alter vvin` / `alter @ven[pwl]` / `alter iload` | that endpoint's **complete source state in the request netlist**: `VVIN VIN 0 <vin>`, `VEN EN 0 dc 0 pwl(0 0 100u 0 101u <vin> 10 <vin>)`, `ILOAD VOUT 0 <iload>` (EN's high level is the same literal as VIN, full rail, issue #196) |
| `tran 10u 200m uic` | the step's `analysis` verbatim (cold start, no operating-point solve) |
| `meas tran ... avg\|min\|max v(vout) from=199m to=200m` | a step measurement with the card as `spice` (windows unchanged) |
| `abs(1000*(tran2.x - tran1.y)/(3.63-2.97))` and the `tranN.card` identities | **not sent**: graded locally from the raw card values by `batch_line_regulation.evaluate`, with the manifest's own bounds and `grade_bounds` (slope < 5 mV/V strict; endpoint averages and tail min/max inside 1.764-1.836 V inclusive) |

Endpoint states (VIN / load): `tran1` 2.97 V / 1 mA, `tran2` 3.63 V / 1 mA,
`tran3` 2.97 V / 50 mA, `tran4` 3.63 V / 50 mA. The `alter iload = 50m`
carries into points 3 and 4 exactly as in the local deck; points 1 and 2 keep
the pinned netlist default (1 mA), so no request inherits another's load.

- **Why one request per endpoint, not four steps.** klt refuses a step
  `alter` on a source declared with an explicit PWL waveform and has no step
  field for `alter @ven[pwl]` (friction reported as
  2AMLogic/klayout-tools#3117), and steps have no `reset` between them
  (#3103). The per-point state therefore travels in the netlist. Each
  `uic` endpoint is independent by construction.
- **Requests.** Full matrix: 3 supply labels x 4 endpoints = **12 requests**
  of 15 points (5 process x 3 temperatures). The supply label is unused by
  this deck's stimulus, but its multiplicity is kept (the three supply
  columns are expected identical, a harness reproducibility check).
  `--quick`: each explicit tuple is a singleton request per endpoint (3 x 4 =
  12), never a Cartesian expansion. Keys are `<supply group>-tran<N>`.
- **Shape gate (before netlisting).** The deck must be exactly four points of
  the vocabulary above (EN's pwl tokens must be the pinned
  `0 0 100u 0 101u $vinpt 10 $vinpt`, so EN can never differ from VIN),
  each with a cold-start `tran ... uic` and `avg|min|max` cards with explicit
  windows; every graded expression must parse over `tran<N>.<card>`
  references, numbers, `abs`, `+ - * / ( )`. `window_grid`, `per_leg` and
  `spread_checks` are refused. This is not a general SPICE translator.
- **Renewal pin.** `BATCH_ALLOWLIST["line-regulation"]["manifest_sections"]`
  pins the `analyses`, `measurements` (bounds and inclusivity) and `matrix`
  digests, as for dropout; any intentional change refuses the batch backend
  until re-validated and re-pinned
  (`test_pins_equal_the_committed_manifest` fails at the same moment).
- **Netlist gate (before any request is written).** The baseline `VVIN`,
  `VEN` and `ILOAD` lines must equal the pinned ones (one definition each),
  and `.ic`, `.nodeset`, `.control`, `.tran`/`.dc`/`.ac`/`.op`, `.meas` and
  `.temp` cards are refused.
- **Response gate.** An unfinished/incompatible remote job, a malformed,
  missing, duplicate or unexpected corner, or an error envelope aborts with no
  record and no fallback. Per corner, an errored status, a klt error/
  `step_failed` diagnostic, a missing/duplicate/errored/non-finite endpoint
  value, an unexpected result identity, a missing log or a solver diagnostic
  in any endpoint's log is a recorded FAIL. The corner's log is the four
  endpoint logs concatenated under `line-regulation endpoint tran<N>` headers.
- **Provenance.** A batch record's `execution.adapter` is
  `line-regulation-endpoints` (issue 379) with each endpoint's VIN, load,
  source lines and cards, and the validated digests.
- **Offline vs paired validation.** `sim/tests/test_batch_line_regulation_379.py`
  is headless and PDK-free: four endpoint states, VIN/EN coherence, 50 mA
  load handling, windows, slope mapping, inclusive window and strict slope
  bounds, negative controls, request-matrix preservation and unchanged local
  behaviour. It proves translation and grading only. **No paired local/fleet
  comparison has been performed**, so remote equivalence is **unqualified**.
  After `python3 sim/bin/batch-preflight.py` exits `0`, run one corner both
  ways at the same commit and compare the raw endpoint values and both slopes:

  ```bash
  python3 sim/bin/batch-preflight.py                       # must exit 0 first
  python3 sim/bin/corner-run.py sim/line-regulation --backend batch \
      --process tt --temp 27 --supply 3.3 \
      --subset-reason "issue #379 paired local/remote baseline check" --no-write
  python3 sim/bin/corner-run.py sim/line-regulation \
      --process tt --temp 27 --supply 3.3 \
      --subset-reason "issue #379 paired local/remote baseline check" --no-write
  ```

  Comparison tolerance (an equivalence check, never a spec limit): when the
  remote `engine_version` equals the local ngspice, every endpoint average,
  min and max must agree to |Δ| <= 1 uV and both slopes to |Δ| <= 0.01 mV/V
  (1 uV over 0.66 V is 1.5e-3 mV/V per endpoint pair, so the slope bound is
  the propagated endpoint tolerance, rounded up). If the engine versions
  differ, report Δ with both versions and the request netlist sha256 and do
  not claim equivalence. A blocked preflight only defers the check; it does
  not permit a local multi-corner campaign. The full 45-point refresh belongs
  to #231 after equivalence is evidenced.

  **Paired check performed (issue #384, 2026-11-04, single corner tt / 27 C /
  3.30 V only): equivalence NOT established.** Preflight was accepted and
  both halves graded PASS, but the fleet runner used ngspice 46 and this
  worker's local ngspice is 42, so no equivalence claim is possible. The
  slopes agree (< 1e-6 mV/V) but `vout_50ma_hi_min`/`_max` differ by
  +62/-65 uV (limit 1 uV; the local half only prints 6 significant digits, so
  sub-5 uV rows are inconclusive). Evidence, comparison and reproduction:
  `sim/line-regulation/diagnostics/issue-384/` (checker:
  `sim/bin/compare_line_regulation_paired.py`). Broader PVT equivalence is
  unclaimed. Handoff for #231: **defer** until a same-engine local run with
  full-precision values exists.

#### Load regulation endpoints on the batch backend (issue #381)

`python3 sim/bin/corner-run.py sim/load-regulation --backend batch` is
**opt-in** (local stays the default). `sim/bin/batch_load_regulation.py`
(PDK-free) translates the deck's two independent cold-start points into
**one single-step `klt sim` request per supply group x endpoint** (`tran1` =
0 A, `tran2` = 50 mA), reusing the line-regulation request, preflight,
response-validation, provenance and record plumbing and its small shared
helpers (expression evaluator, measurement check, response extraction,
netlist forbidden-card/one-definition check). Admission rules are separate and
stricter-by-shape: exactly two endpoints, each `tran <tstep> <tstop> uic`
followed by exactly one `avg`, one `min` and one `max` `meas tran` card with an
explicit window; point 1 runs at the netlist's own load and point 2 carries
exactly one `alter iload = <amps>` to a different load; any other card
(`set`, `alter` of VIN/EN, `op`, `ic`, `reset`, ...) is refused. This is not a
general SPICE translator.

| local deck | klt request |
|---|---|
| (no VIN/EN `alter`) VIN = `'vsup'`, EN = `dc 0 pwl(0 0 100u 0 101u 'vsup' 10 'vsup')` | unchanged baseline lines in **every** request netlist: VIN and full-rail EN stay the corner supply (`.param vsup=<supply>` opens each request), not a copied number |
| point 1 at the netlist load; `alter iload = 50m` before point 2 | that endpoint's **complete load in the request netlist**: `ILOAD VOUT 0 0` (`tran1`) or `ILOAD VOUT 0 50m` (`tran2`), so no request inherits another's state |
| `tran 10u 200m uic` | the step's `analysis` verbatim (cold start, no operating-point solve; the 200 ms settling period is a documented method choice and is not shortened) |
| `meas tran ... avg\|min\|max v(vout) from=199m to=200m` (six cards) | six step measurements with the card as `spice`, windows unchanged, returned as `tran1.vout_0ma[_min\|_max]` and `tran2.vout_50ma[_min\|_max]` |
| `abs(tran2.vout_50ma - tran1.vout_0ma)`, `100*abs(...)/1.8` and the `tranN.card` identities | **not sent**: graded locally from the raw values with the manifest's own expressions and bounds (`load_reg_v` < 18 mV and `load_reg_pct` < 1 %, both strict so exactly 18 mV / 1 % FAIL; endpoint averages and tail min/max inside the 1.764-1.836 V Output window, inclusive) |

- **Renewal pin.** `BATCH_ALLOWLIST["load-regulation"]["manifest_sections"]`
  pins the `analyses`, `measurements` (bounds and inclusivity) and `matrix`
  digests; any intentional change refuses the batch backend until
  re-validated and re-pinned (`test_pins_equal_the_committed_manifest` fails
  at the same moment). `window_grid`, `per_leg` and `spread_checks` are refused.
- **Netlist gate (before any request is written).** One definition each of
  `VVIN`, `VEN` and `ILOAD`, equal to the pinned baseline (`'vsup'`-linked VIN
  and EN, `ILOAD VOUT 0 0`); `.ic`, `.nodeset`, `.control`, `.tran`/`.dc`/
  `.ac`/`.op`, `.meas` and `.temp` cards are refused.
- **Requests.** Full matrix: 3 supply values x 2 endpoints = **6 requests** of
  15 points, together preserving all 45 declared corner identities. `--quick`:
  each explicit tuple is a singleton request per endpoint (3 x 2 = 6), never a
  Cartesian expansion. Keys are `<supply group>-tran<N>`.
- **Response gate / provenance.** As for line regulation: any missing,
  duplicate, unexpected, errored or non-finite value, missing log or solver
  diagnostic is a recorded FAIL; structural problems abort with no record and
  no fallback. A batch record's `execution.adapter` is
  `load-regulation-endpoints` (issue 381) with each endpoint's state, source
  lines and cards, and the validated digests; the log is the two endpoint logs
  concatenated under `load-regulation endpoint tran<N>` headers.
- **Offline vs paired validation.** `sim/tests/test_batch_load_regulation_381.py`
  is headless and PDK-free: independent 0 A / 50 mA states, supply-linked
  VIN/EN, unchanged duration/windows, all six raw cards, plot-qualified
  mapping, both derived differences, strict delta bounds, inclusive window,
  negative controls (equal out-of-window endpoints, in-window averages with
  out-of-window extrema) and request-matrix preservation. It proves
  translation and grading only and does **not** establish local/fleet
  numerical equivalence. **Paired check performed (issue #381, 2026-11-05,
  single corner tt / 27 C / 3.30 V only): equivalence NOT established.**
  Preflight was accepted and both halves graded PASS, but the fleet runner
  used ngspice 46 and this worker's local ngspice is 42. All six raw values and
  both differences agree at the printed 7 significant digits (1 uV, equal to
  the raw tolerance), so no breach was seen, but no equivalence claim is
  possible. Evidence and reproduction:
  `sim/load-regulation/diagnostics/issue-381/` (checker:
  `sim/bin/compare_load_regulation_paired.py`). **Re-run 2026-11-06 (new
  record `run-20261106/`, same single corner):** the host ngspice is now 46,
  equal to the runner's, and the pair is `equivalent` (all six values and both
  differences within tolerance, with the committed logs and a runnable local
  deck). That covers tt / 27 C / 3.30 V only; the 45-corner matrix is
  unverified, so remote equivalence stays **unqualified** beyond that corner.
  Procedure: once `python3 sim/bin/batch-preflight.py` exits `0`, run one
  corner both ways at the same commit and compare:

  ```bash
  python3 sim/bin/batch-preflight.py                       # must exit 0 first
  python3 sim/bin/corner-run.py sim/load-regulation --backend batch \
      --process tt --temp 27 --supply 3.3 \
      --subset-reason "issue #381 paired local/remote baseline check" --no-write
  python3 sim/bin/corner-run.py sim/load-regulation \
      --process tt --temp 27 --supply 3.3 \
      --subset-reason "issue #381 paired local/remote baseline check" --no-write
  ```

  Comparison tolerance (an equivalence check, never a spec limit): when the
  remote `engine_version` equals the local ngspice, every endpoint average,
  min and max must agree to |Δ| <= 1 uV and both derived differences to
  |Δ| <= 2 uV / 1.2e-4 % (the propagated endpoint tolerance, rounded up). If
  the engine versions differ, report Δ with both versions and the request
  netlist sha256 and do not claim equivalence. Retain the raw logs. A blocked
  preflight only defers the check; it does not permit a local multi-corner
  campaign. The full 45-point refresh belongs to #231 after equivalence is
  evidenced.

#### Runner preflight (issue #356)

`python3 sim/bin/batch-preflight.py` is the one shared check for "does the
fleet runner accept this client yet?" (`batch_runner_version_mismatch`,
2AMLogic/klayout-tools#2948). It submits **one** single-unit `sim/pdk-smoke`
request (tt / 27 C / 1.8 V, built by `corner-run.py`'s own batch request
builder and runner) and reads `environment.remote`. klt 0.7.0's `klt sim` has
no compatibility-only check, so a single-unit submit is the cheapest probe;
run it once per re-check, never in a loop. Issues #345, #341 and #327 cite it
as their unblock check.

| exit | meaning |
|---|---|
| `0` | accepted: the runner ran the job to a completed, usable result (issue #359) — a remote job id, a terminal successful remote state (`done`, or `failed` with a ran-to-report `exit_code` 0/3/4), exactly one corner and it is the tt / 27 C smoke corner, that corner `pass` or `fail`, and no error-severity diagnostic or runner code |
| `3` | version mismatch (`runner_compatibility: mismatch` / `batch_runner_version_mismatch`); reported, never worked around; wins over any other finding |
| `1` | any other failure (no/malformed response, job still running or failed for another reason, missing/duplicate/unexpected or incomplete smoke corner, error diagnostics, missing klt/xschem/PDK), with the reason printed |

A completed measurement FAIL on the smoke corner still exits `0`: the probe
answers "does the fleet run this client to completion?", not "does the
circuit pass?" — electrical grading stays with `corner-run.py`.

It prints the job id and the runner/client klt versions (`--json` adds a
machine-readable line, `--keep` retains the scratch dir). It is a probe, not
evidence: scratch lives in a temp dir and nothing is written under any
`sim/<experiment>/` directory. Unit tests (canned responses only) are in
`sim/tests/test_batch_preflight.py`.

### Writing a new Monte Carlo experiment

Same testbench-authoring rule as above (no corner include, no numeric supply,
no `.control` block), but the manifest and runner differ — see "Monte Carlo /
mismatch experiments" below for the mechanism, and `sim/mc-output-accuracy/`
for a worked example manifest (`mc_corner`, `mc_analysis`, `mc_measurements`,
`monte_carlo_defaults` keys instead of `corners`/`deck`/`measurements`/
`quick_subset`). Run it with `python3 sim/bin/mc-run.py sim/<slug> --n <N>
--seed <seed>` (`--seed` is required and recorded verbatim — the seed
contract is what makes an MC record reproducible); commit the produced
record, netlist snapshot, and the `klt-requests/`/`klt-responses/` JSON.

---

## `pdk-smoke` — the harness's own testbench

`sim/pdk-smoke/` is not a spec claim. A 1 MΩ resistor biases a diode-connected
sky130 core `nfet_01v8` and the runner measures `vgs` and the supply current.
Both quantities are strongly process- and temperature-dependent, so this
experiment proves four things at once: the PDK models load, xschem netlists
headlessly, ngspice parses the deck, and the corner/temperature/supply knobs
actually reach the simulator (asserted by the `vgs` spread check, not just
eyeballed).

It deliberately uses the 1.8 V **core** device family (`nfet_01v8`), not the
pass-device flavor the "sky130 porting question" in `spec/target-spec.md`
settled (framing A — `pfet_g5v0d10v5` — ratified per DR-001 / issue #1, over
framing B's 1.8 V core devices) — this testbench is harness plumbing, stood up
ahead of and independent of that ratification decision, and its device choice
neither implements nor revisits it.

Keep it green: it is the first thing to run when a testbench misbehaves, to
tell "my circuit is wrong" apart from "my harness is broken".

## PSRR C_eff x ESR reduced sweep (issue #314, Phase 1 -- tooling only)

`sim/psrr-dc/cap-esr-sweep.json` declares a sampled grid (3 corners = the
`psrr-dc` `quick_subset`, C_eff {0.33, 1, 4.7} uF, ESR {0, 10 m, 500 m} ohm, both
load points). `sim/bin/psrr_cap_sweep.py` builds the per-point `klt sim` analysis steps
(`build_steps`; ESR 0 is a real zero-ESR topology via the `add_direct_cap` alters)
and selects the worst sampled point per sub-metric (min over corners, ties -> lower C_eff then lower ESR; any missing or
non-finite cell -> no finding, listed). Tests: `sim/tests/test_psrr_cap_sweep.py`.
The grid samples the window; it cannot prove the continuous-window or 45-corner
worst case.

**Runner (`sim/bin/psrr-cap-sweep-run.py`).** `corner-run.py --backend batch` still
refuses `psrr-dc` (its allowlist is untouched). This dedicated runner sends the sweep
to `klt sim` instead, as **one request per corner**. Each corner's deck walks every
point as ordered `analysis_steps`: for each point and load, an `op` step whose
`alter`s set COUT, RESR, CDIR and RLOAD explicitly, followed by the `ac lin 3 1e3 1e5`
step. The testbench's `.nodeset` seed (#171/#179) applies to every one of these
operating-point solves. Zero ESR uses the #313 realisation: the request netlist gains
a direct `CDIR` VOUT-to-ground branch, and an ESR = 0 point puts C_eff on CDIR and
opens the series branch (COUT = 0 F). The nominal 1 uF / 10 mOhm point is re-run at
the end of each deck, and its values must match the first run (order independence).

- `--backend batch` (default) submits every corner to the fleet. Any failed submit
  aborts with **no record and no local fallback**.
- `--backend local` runs **exactly one** `--corner`, as a spot check, and never
  writes a record.
- A record (`sim/psrr-dc/records/<id>.{json,md}`, `evidence_kind:
  "psrr-cap-esr-sweep"`) is minted only when all three corners return from the
  fleet. The characterization report's campaign-record selector skips it. Raw
  requests, responses, request netlists and engine logs go under
  `klt-requests/`, `klt-responses/`, `klt-request-netlists/` and `corners/<id>/`.
- `-o` is always passed as an absolute path. A relative `-o` makes `klt sim`'s
  local backend error out before ngspice starts (klayout-tools#2892).

**Status (2026-11-12): record minted.** The three-corner sweep ran on the fleet
(runner klt 0.9.2.dev850, ngspice 46, jobs `klt-sim-3cff2d3e59b5`,
`klt-sim-3279e45a866d`, `klt-sim-dc42591bb493`, all pass) and minted
`sim/psrr-dc/records/20261112-123922-1177e742.{json,md}`: the evidence path for
issue #314 Phase 1. The earlier runner-version wall (klayout-tools#2948) and the
capacity refusal are gone; the runner now passes `--wait-for-capacity 600` on every
batch submit. Worst sampled point per sub-metric (min over the 3 corners, fixed
rule; a sampled-grid finding, not the continuous-window or 45-corner worst case):
1 kHz / 1 mA at 4.7 uF, 0 ohm (21.304 dB, ff); 100 kHz / 1 mA at 0.33 uF, 0 ohm
(21.165 dB, ss); 1 kHz / 50 mA at 4.7 uF, 0 ohm (22.536 dB, ff); 100 kHz / 50 mA at
1 uF, 0 ohm (10.982 dB, ss). The nominal point (tt, 1 uF / 10 mOhm) agrees with
record `20260926-033606-4a9ec09` within 1e-5 dB on all four sub-metrics, including
100 kHz / 50 mA (11.3201 vs 11.3201 dB), so the earlier 0.03 dB spot-check gap did
not reproduce. No threshold or spec row was changed; the decision record (Phase 2)
and 45-corner qualification (Phase 3) remain separate follow-ups.

#### iq endpoints on the batch backend (issue #213)

`python3 sim/bin/corner-run.py sim/iq --backend batch` is **opt-in**.
`sim/bin/batch_iq.py` (PDK-free) translates the deck's two cold-start points
(no load, then `alter iload = 50m`) into **one single-step `klt sim` request per
supply group x endpoint** (6 requests for the full 45-point matrix), exactly the
load-regulation shape (issue #381): VIN and full-rail EN stay the corner supply
`'vsup'`, only the load differs per request. Each endpoint carries an
`avg v(vout)` and an `avg i(vvin)` card over 199 ms-200 ms; the affine Iq
expressions and the `min: 0` / Output-window gates are graded locally from the
raw `tran<N>.<card>` values. The manifest is pinned by digest in
`BATCH_ALLOWLIST["iq"]` and `sim/tests/test_batch_iq_213.py` is headless.

**Status (2026-10-14): no record.** The submit was accepted
(`batch-preflight.py` exit 0, runner klt 0.7.0) but the first job
(`klt-sim-d3e081d972dd`) failed in about 5 s with "request is missing required
field: analysis" on all 15 points: the fleet runner is the 0.7.0 release, which
predates `analysis_steps[]` (landed after the tag). The run aborted with no
record and no local fallback, and no result of any kind is claimed. Tracked
upstream as klayout-tools#3249. The 45-corner re-run (`--supersedes
20260910-034648-6c0436d`) still has to be done once the runner image carries
`analysis_steps`.

**Status (2026-11-05): record `20261105-052332-05df7a01`, FAIL, 40/45 corners
PASS.** The runner image was rebaked to klt 0.9.0; `batch-preflight.py` exited 0
and the full 45-point matrix ran as 6 `klt sim` requests (`--supersedes
20260910-034648-6c0436d`). Results against the seeded `tran ... uic` deck:

- **Solver-diagnostic gate (#171): 0/45** corners tripped it. (The superseded
  unseeded `.op` record tripped it on all 45.)
- **Regulation gate (#133): 45/45** within the 1.764-1.836 V Output window,
  every `iq_*` value > 0. #133's two named corners, `ss_-40c_3.30v` (no load,
  1.80157 V) and `ff_-40c_2.97v` (full load, 1.79895 V), now regulate and PASS;
  once seeded they were not non-regulating.
- **Iq budget (< 30 uA): 5 FAIL**, all `iq_full_load_ua` above max at 3.63 V on
  the fast-NMOS corners: `ff_-40c_3.63v` (31.3), `ff_27c_3.63v` (31.3),
  `ff_125c_3.63v` (30.7), `fs_-40c_3.63v` (30.4), `fs_27c_3.63v` (30.2).
  No-load Iq peaks at 16.7 uA. Gates and bounds were not changed; the FAIL is
  the recorded outcome.

The record's JSON twin lives in the artifact store (issue #436), so
`measurements/build_characterization_report.py` (which selects on committed
`records/*.json`) does not yet see this record: the Iq row of
`measurements/characterization.md` and the signoff item 8 pins were **not**
regenerated here and still cite `20260910-034648-6c0436d`.

## Bound inclusivity (issue #335)

A measurement's `min` / `max` are inclusive by default (value == bound passes).
Set `"min_inclusive": false` / `"max_inclusive": false` to make a bound strict
(value == bound fails), only where the ratified `spec/target-spec.md` row is a
strict `<` / `>`. Flags must be JSON booleans (anything else is a harness
error). One grader, `grade_bounds()` in `corner-run.py`, serves the local,
window-grid and klt-batch paths, and each check records both flags. In the
effective-input fingerprint the flags are added only when not `true`, so legacy
manifests (flags omitted or default) keep their previous digest; flipping a
flag to strict changes the `measurements` digest, so records made before the
change are reported as input-stale rather than regraded (records are
append-only and are never rewritten).

## Evidence bytes go to the artifact store (issue #436)

Runs of `corner-run.py`, `mc-run.py` and `yield-run.py` that write evidence no
longer commit the JSON twin, netlist snapshot, per-corner logs or batch
request/response files: they are stored with `klt artifact put` and the commit
carries `manifests/artifacts/<bench>-<run-id>.manifest.json` plus the
`records/<run-id>.md` summary (name, size, sha256 per object). Record `links`
name objects as `sim/<bench>/...` store names. `--dry-run` and `--no-write`
need no broker. Set `$KLT_ARTIFACT_BROKER` (environment only); with it unset,
`klt artifact put` missing, or the broker unreachable the runner exits nonzero
before simulating and writes nothing. See `manifests/README.md`. Records minted
before this change keep their committed files.

## Thermal-hysteresis staircase on the batch fleet (issue #511)

`sim/thermal/run_hysteresis.py` now has a batch route (default) for the #231
PVT qualification: 5 process x 3 supply corners, `hot` (T_reset) and `cold_exc`
(T_trip) searches.

- **Route**: `klt sim --batch-set`, one single-step `tran 400n 170u uic` request
  per (corner, scenario) carrying that round's temperatures as the klt
  temperature axis. The `klt sim --dry-run` of a request validated, so the
  Spot repo-script job kind is not needed: stimulus (`vsup`, `ix_amp`,
  `en_dip`) are `.param` cards in the request netlist and the observations are
  `.meas tran ... find v(xldo.ts_cmp) at=<t>u` cards (`sim/bin/batch_thermal_staircase.py`).
  Interpolated `find ... at` replaces the local nearest-sample read.
- **Rounds**: round 1 submits the 10 C grid; each later round one bisection
  midpoint per open (corner, scenario), until `--tol`. `plan()` is a pure
  function of recorded results, so a resume reproduces the same points.
- **Records**: each point is an exclusive-create file in
  `sim/thermal/hysteresis/<rec-id>/points/` (job id under `remote`). Refusals and
  flagged points go to append-only `refusals.jsonl` / `failures.jsonl`.
  `--resume <rec-dir>` skips recorded points and never rewrites one; an
  incomplete run writes `result-incomplete-*.json`, only a finished one `result.json`.
- **No local fallback**: a capacity refusal (after `--capacity-retries`, default 2,
  plus the request's `capacity_wait_s`) is recorded and the run exits 3.
  `--backend local` is accepted for exactly one corner (`--corners tt:3.30`).
  A solver diagnostic (#171) or a runner-version mismatch fails the point.
- **Dependent round (#541)**: once a corner's T_reset and T_trip brackets are
  recorded, one more `--batch-set` carries its cold-start (`cold`), EN re-enable
  (`en`, `en_dip=0`, DR-005) and amplitude (`hot_ix+0.25uA`, ... `cold_exc_ix-1uA`)
  points, chosen by the local flow's formula (`dependent_points`) and recorded
  like the staircase points (the scenario label is part of the key). States are
  recorded; no threshold is applied. `klt netlist` replaces raw `xschem`.
- **Smoke**: `hysteresis/20261105-191708-3609d978-batch-smoke` (tt / 3.30 V) gives
  T_reset 159.21875 C and T_trip 172.34375 C, brackets identical to the local
  record `20261008-190150-0275a8b-dev1`.
- **Smoke (#541)**: `hysteresis/20261112-083033-8b03ff5f-batch-dependent-smoke`
  (tt / 3.30 V, 22 dependent points, 18 fleet jobs under `result.json` `jobs`):
  same brackets, and every cold-start, EN re-enable and amplitude outcome equals
  the local record `20261008-190150-0275a8b-dev1`; EN-low comparator voltage
  differs by <= 0.1 mV (interpolated `find ... at` vs nearest sample). No
  disagreement to report.
- **15-corner qualification (#231)**: `hysteresis/20261112-095143-16b7450c-qual-15corner-dependent`
  (682 points, `result.json` complete) extends the staircase record
  `20261105-202028-97cd9a9e-qual-15corner` (left byte-unchanged) with the dependent
  round at all 15 corners. Minimum hysteresis 12.19 C (> 2 C, tol 0.3125 C), lowest
  trip 161.9 C (>= 150 C, DR-005); EN re-enable does not latch. ff is bisected only
  up to 180 C (`--grid-top`, default `ff:180`): ff at 188-190 C fails
  `timestep_too_small`, a disclosed PDK-model extrapolation limit, and dependent
  points above a process's bound are not run (`ff-bound-disclosure.md`). No spec row
  or DR-005 threshold changed. Hysteresis records do not feed
  `measurements/characterization.md`, so it is not regenerated.
