2AMLogic/sky130-ldo/layout/README.md

# layout/ — the klayout-tools (`klt`) DRC/LVS flow

Issue #2's layout-flow deliverable: a headless, repeatable DRC/LVS flow driven
by [`klayout-tools`](https://github.com/2AMLogic/klayout-tools) (`klt`),
**first proven on a trivial known-good cell** (`trivial-cell/`, below) before
being extended to the LDO's own layout (`ldo-core/`, issue #15 — see
"Extending to the LDO core" below): a placed floorplan skeleton for
`design/ldo_3v3in_1v8out.sch`, DRC-clean, with extraction/LVS deferred to
issue #17.

Two rules from the root `CLAUDE.md` shape this directory the same way they
shape `sim/`:

- **Verification is the product.** A DRC/LVS "pass" claim ships with the
  actual reports it came from, plus a negative control proving the flow can
  also report failure.
- **Friction protocol, with force.** Every `klt` gap/awkwardness hit while
  standing this up gets checked against the public
  [`2AMLogic/klayout-tools`](https://github.com/2AMLogic/klayout-tools)
  tracker and filed (or, if already tracked, cross-confirmed) there —
  tool-gap description only, never this repo's design/spec content.

## Quick start (cold machine)

```bash
# 1. install the pinned klt build (~10-60s; see requirements.txt for the pin)
layout/bin/setup-venv.sh

# 2. sanity-check the sky130A PDK resolves (same pin as sim/pdk.json)
layout/.venv/bin/klt pdk find --pdk sky130A

# 3. run the trivial-cell DRC/LVS proof (~a few seconds)
layout/bin/run-trivial-cell-flow.sh
```

The last command writes a fresh, timestamped record under
`trivial-cell/reports/<record-id>/` and updates
`trivial-cell/reports/LATEST` to point at it. **Read the newest
`trivial-cell/reports/<record-id>/record.md` first** — it is the actual
pass/fail evidence this issue delivers, not this README.

## Why `klt`, and why a git-commit pin (not a PyPI version)

`klayout-tools`'s PyPI release lags `main` by several verbs. This flow needs
`gen` (to build the trivial cell), `extract`, and `lvs` — documented on
`main` but not yet in a PyPI release
([2AMLogic/klayout-tools#342](https://github.com/2AMLogic/klayout-tools/issues/342)
tracks cutting one). The project's own README names installing from a git ref
as the sanctioned way to get the latest development verbs; `requirements.txt`
pins an **exact commit**, not floating `main`, for the same reproducibility
discipline `sim/pdk.json` applies to the PDK version. This repo's pin is the
same commit the sibling `sky130-bandgap` repo's own trivial-cell flow already
proved against this same sky130 PDK pin, so this repo's first layout-flow run
starts from a known-good baseline rather than an unverified new pin.

**There are two pins, deliberately.** `requirements.txt` is the build every
committed DRC/LVS/PEX record was produced on; those records are append-only
evidence, so bumping it invalidates their stated provenance and is done only
alongside a re-run. `erc-requirements.txt` is a second, newer pin for the
`klt erc` supply-spec flow, which needs capability (`nets[].kind`,
`stackup[0].active_layer`, `devices[]`, isolated `ties[]` extraction,
`well_layer: null` + `well_boxes`) that landed upstream long after the first
pin. That file names each capability and the upstream issue behind it. Two
pins, each naming the build its own evidence was produced on, beats one pin
that is wrong for one of the flows — cross-check any report against the
`provenance.klt_version` it carries.

## The flow

```
klt gen mos_array --pdk sky130A         (1) build the trivial known-good cell
        |
        v
klt drc <cell>.gds --deck sky130        (2) DRC against the sky130 deck
        |
        v
klt extract <cell>.gds --deck sky130    (3) layout -> schematic-equivalent netlist
        |
        v
klt lvs (extracted vs. hand-written      (4) LVS: topology compare
         reference netlist)
```

**The trivial cell**: `klt gen mos_array`'s documented defaults (a 2x2 array
of unit NMOS devices with a one-column dummy guard on each side, `nfet`
flavor, no well) are chosen because the project's own docs guarantee every
generator's default `params` pass `klt drc --deck sky130` clean — exactly a
"trivial known-good cell". `res_array` (the resistor-array generator — closer
in spirit to this repo's own poly-resistor-heavy topology, matching the
sibling `sky130-bandgap` finding) is not used for this proof: as of this
repo's `klt` pin, its output does not round-trip through `klt extract`'s
resistor recognition (already tracked upstream, see "Friction protocol"
below) — `mos_array` has no such gap.

**The reference netlist** (`trivial-cell/reference.spice`) is hand-written to
match `mos_array`'s pinned-default topology: 4 independent *real* unit NMOS
devices, each with its own isolated source/drain/gate net, bodies tied to one
shared `vsubs` pin. `klt lvs`/`NetlistComparer` compares topology, not net
*names* (see
[`docs/cli/lvs.md`](https://github.com/2AMLogic/klayout-tools/blob/main/docs/cli/lvs.md)
in the `klayout-tools` repo), so the reference's arbitrary net names do not
need to match the extracted netlist's own arbitrary `$N`-style names.
`mos_array` still physically draws 8 units (4 real + 4 dummy); at this repo's
pinned `klt` commit, sky130's curated deck recognizes the 4 dummy-column
units as dummies (no schematic counterpart by construction) and `klt extract`
drops them from the comparison, so the reference only needs to state the 4
that matter.

**Two negative controls** (`reference.broken-device.spice`,
`reference.broken-topology.spice`) prove the flow actually *fails* on a real
defect, not just that it produces a report — per `klt lvs`'s own documented
guidance, a device-parameter-only corruption and an independent topology
(shorted-net) corruption, since a single corruption class can pass by
accident on a compare that ignores the other axis. Both must (and do) report
`status: "mismatch"`.

## Directory layout

```
layout/
  README.md                  # this file
  requirements.txt           # pinned `klt` install for the DRC/LVS/PEX flows (git commit SHA)
  erc-requirements.txt       # SECOND pin, for the `klt erc` supply-spec flow (and why it differs)
  cap-requirements.txt       # THIRD pin, for the #254 MiM + rail overlay demonstrator (and why)
  bin/
    setup-venv.sh             # create/refresh a venv from one of the requirements files
    run-trivial-cell-flow.sh  # the repeatable driver: gen -> drc -> extract -> lvs -> report
    render-record.py          # renders + verdict-checks a record's record.md
    run-ldo-layout-flow.sh    # LDO-core driver: xschem netlist -> gen -> gen-compose -> route -> drc -> report
    gen-ldo-blocks.py         # netlist-driven klt gen + placement + gen-compose + the channel router
    render-ldo-record.py      # renders + verdict-checks an ldo-core record's record.md
    run-ldo-lvs-flow.sh       # issue #17: LDO-core LVS driver: xschem netlist -> reference -> extract -> lvs -> report
    gen-ldo-reference-netlist.py  # translates the schematic's xschem netlist into an LVS reference
    render-ldo-lvs-record.py  # renders + verdict-checks an ldo-core LVS record's record.md
    run-ldo-erc-flow.sh       # issue #112: T1 item 11 driver: pre-flight -> klt erc -> 4 controls -> record
    check-erc-supply-spec.py  # re-derives the spec's claims ABOUT the layout before each erc run
    render-ldo-erc-record.py  # renders + verdict-checks an ldo-core ERC record's record.md
    run-folded-res-qual-flow.py   # issue #253: resistor-only folded-series qualification (gen -> drc -> extract -> lvs -> .op)
    gen-folded-res-qual.py        # draws the unsplit / folded / open-chain resistor test blocks
    render-folded-res-qual-record.py  # renders a folded-res-qual record's record.md from summary.json
    _folded_res_analysis.py       # stdlib helpers (tolerance, .op deck, verdicts) -- unit-tested
    run-cap-rail-demo-flow.sh # issue #254: MiM + rail overlay demonstrator -> drc x2 -> extract -> lvs + controls
    gen-cap-rail-demo.py      # draws the stacked-MiM capacitors + rails, writes plan.json + LVS reference
    _cap_rail_plan.py         # stdlib-only sizing / plate / footprint arithmetic (unit-tested)
    render-cap-rail-record.py # renders + verdict-checks a demonstrator record's record.md
  .venv/                      # gitignored -- `klt` install, created by setup-venv.sh
  .venv-erc/                  # gitignored -- the ERC flow's own pinned `klt` install
  .venv-cap/                  # gitignored -- the #254 demonstrator's own pinned `klt` install
  cap-rail-demo/              # issue #254 demonstrator: README.md + reports/<record-id>/ (NOT the core)
  ldo-core/                   # the real LDO layout (see "Extending to the LDO core")
    floorplan.md               # device-to-block mapping, placement + routing rationale
    erc-supply-spec.json       # issue #112: the T1 item 11 `klt erc` supply spec (heavily commented)
    reports/
      LATEST                    # newest gen/compose/route/drc record, PASS or FAIL (#260:
                                # curated + official sky130A_mr.drc, see ldo-core/floorplan.md)
      LATEST-LVS                 # newest LVS record
      LATEST-ERC                 # newest ERC supply record
      <record-id>/             # xschem_out/, gen.<device>.json/<device>.gds per device,
                                # compose.*.json, floorplan.json, ldo_core.placed.gds,
                                # ldo_core.gds, drc.json, report.md, record.md
      <lvs-record-id>/         # xschem_out/, reference.spice, extract.json,
                                # ldo_core.extract.spice, lvs.request.json, lvs.json,
                                # report.md, record.md (see "LVS" below)
      <erc-record-id>/         # erc_supply.json, erc_control_C[1-4].json,
                                # erc-supply-spec.json, layout-record-id.txt,
                                # record.md (see "ERC supply spec" below).
                                # No GDS copy: the report's own input
                                # content-hash is of the layout record's
                                # committed ldo_core.gds, which
                                # layout-record-id.txt names.
  folded-res-qual/             # issue #253: resistor-only folded-series qualification (see its README)
    cases.json                 # cases + single-operating-point electrical settings
    reports/LATEST, <record-id>/  # append-only records; read <record-id>/record.md
  trivial-cell/
    reference.spice                    # known-good LVS reference netlist
    reference.broken-device.spice      # negative control 1: device.property corruption
    reference.broken-topology.spice    # negative control 2: net.merged corruption
    reports/
      LATEST                    # plain-text pointer to the newest record id
      <record-id>/              # <YYYYMMDD-HHMMSS>-<short-git-sha>, one per run
        gen.json, trivial_mos_array.gds
        drc.json
        extract.json, trivial_mos_array.extract.spice
        lvs.request.json, lvs.json
        lvs.broken-device.request.json, lvs.broken-device.json
        lvs.broken-topology.request.json, lvs.broken-topology.json
        reference*.spice           # snapshot of the reference(s) used for this record
        report.md                  # `klt report --format github-summary` rendering
        record.md                  # human-readable pass/fail summary (read this first)
```

`<record-id>` mirrors `sim/`'s `<YYYYMMDD>-<HHMMSS>-<short-git-sha>` (UTC)
convention (see `sim/README.md`) so the two evidence trails read the same
way. Unlike `sim/`, this flow does not yet enforce a PDK-version pin the way
`sim/bin/corner-run.py` does — `record.md` surfaces the resolved PDK version
as a manual cross-check against `sim/pdk.json` instead.

## Friction protocol: what was found

Standing this flow up on this repo surfaced no *new* `klt` gaps — the same
trivial-cell flow was already proven end to end against this same sky130 PDK
pin by the sibling `sky130-bandgap` repo, whose own friction filing already
covers the two real gaps that flow hit
([`klt gen res_array` doesn't draw the resistor-ID marker its own PDK deck
needs](https://github.com/2AMLogic/klayout-tools/issues/369),
[PyPI lagging `main` by several verbs](https://github.com/2AMLogic/klayout-tools/issues/342)).
Confirming this repo's own run reproduces the identical four-way verdict
(DRC clean, LVS match on the good reference, LVS mismatch on both negative
controls) is itself evidence those two gaps are still the only ones live at
this pin — no re-filing needed.

If a *new* gap (not already covered by the above) turns up in follow-on
layout issues — most likely once real LDO device geometry (poly resistors,
the `pfet_g5v0d10v5`/`pfet_01v8` pass-device candidates once #1 ratifies) is
drawn — file it at `2AMLogic/klayout-tools` per the root `CLAUDE.md`:
tool-gap description only, no spec values or design content from this repo.

### What routing the LDO core hit (issue #33)

Two `klt` gaps shaped how `ldo-core/` is generated. **Both were already
tracked upstream**, so this repo cross-confirmed rather than re-filed
(`klayout-tools` [#1116](https://github.com/2AMLogic/klayout-tools/issues/1116)),
and both have since been resolved on `klayout-tools`' `main` — *after* the
commit `layout/requirements.txt` pins:

- **`gen-compose`'s router was two-pin only**, and rejected any route
  crossing another block's bounding box — so no shared rail or fanout net in
  a real block was routable
  ([#1073](https://github.com/2AMLogic/klayout-tools/issues/1073), closed by
  bundle routing; the broader "no netlist -> placed+routed layout verb" gap
  is [#1116](https://github.com/2AMLogic/klayout-tools/issues/1116), still
  open). `gen-ldo-blocks.py` draws its own channel route instead.
- **`mos_array`'s `fingers>1` drew a series chain** with unstrapped interior
  diffusions and uncontactable gates, which extracts as N series devices
  rather than one folded device
  ([#777](https://github.com/2AMLogic/klayout-tools/issues/777)). Every
  device here is therefore drawn with `fingers=1`, splitting width across
  parallel `cols` units instead.

Bumping the pin to pick those up is a deliberate act (see
`requirements.txt`'s own note) that would need the whole ldo-core flow
re-verified against the new build — worth doing on its own issue, not as a
side effect of a layout change.

Issue #142 was that issue: the pin moved `acb0ae6c` → `040f3406` to pick up
sky130 voltage-flavor support, and the whole ldo-core flow (layout + DRC,
extract + LVS, then `sim/pex-post-layout`) was re-run against the new build
and re-landed as fresh records. Neither of the two gaps above changed how
this flow is generated — `gen-ldo-blocks.py` still draws its own channel
route and still uses `fingers=1` — so picking them up is available future
work, not something the bump did on its own. `requirements.txt`'s "Pin
history" section is the authority on what each pin does and does not carry.

### What the ERC supply spec hit (issue #112)

One new gap, filed at
[`klayout-tools#2389`](https://github.com/2AMLogic/klayout-tools/issues/2389):
**`klt erc`'s envelope never names a drawn conductor layer the spec's
`stackup` omits.** `nets[]` connectivity is computed only through declared
roles, and a committed supply spec is a long-lived artifact whose
correctness is a property of the layout it was written against — but nothing
in the report records that the stream drew a level the spec does not
mention, so the model can silently narrow as a block is re-routed.
`klt drc` already answers exactly this question about itself
(`coverage.layers_in_stream_without_rules`, which
`docs/design-evidence-tiers.md` item 3 leans on directly); `klt erc` has no
counterpart, so the equivalent item-11 disclosure cannot be made from the
envelope at all.

That is why `bin/check-erc-supply-spec.py` exists here: it is a local
stand-in for the missing disclosure, diffing "layers drawn" against "layers
declared" (and re-deriving the substrate assertion) with `klayout.db` before
every run. It should shrink to nothing if #2389 lands.

Everything else this flow needed was already present upstream, and several
of the item-11 capabilities it depends on are *recent* fixes to gaps other
canaries filed — isolated `ties[]` extraction
([#2169](https://github.com/2AMLogic/klayout-tools/issues/2169)), the
`poly ∩ diff` antenna denominator
([#1979](https://github.com/2AMLogic/klayout-tools/issues/1979)),
device-body carve-outs
([#2183](https://github.com/2AMLogic/klayout-tools/issues/2183)), and the
native-substrate tie
([#2255](https://github.com/2AMLogic/klayout-tools/issues/2255)). That is
what `erc-requirements.txt`'s second pin buys. It was a second pin rather
than a bump of the first because, when it was written, the DRC/LVS pin was
`acb0ae6c`, which predates all of them. Since #142 the DRC/LVS pin is
`040f3406`, which descends from the ERC pin `cb79a84f`, so one pin could now
serve both flows. Collapsing them is a deliberate follow-up; see
`erc-requirements.txt`.

## Extending to the LDO core (issues #15/#33)

`ldo-core/` is the real block layout for `design/ldo_3v3in_1v8out.sch`: one
`klt gen` block per active schematic device, placed via `klt gen-compose`'s
`placement.strategy: "explicit"`, wired net-for-net, DRC-clean and
LVS-matched. It is separate from `trivial-cell/` above (that stays tool-flow
proof only).

```bash
layout/bin/setup-venv.sh            # once, or after bumping requirements.txt
layout/bin/run-ldo-layout-flow.sh   # regenerate the layout + DRC record
layout/bin/run-ldo-lvs-flow.sh      # extract + LVS against the schematic
```

Read the newest `ldo-core/reports/<record-id>/record.md` for the DRC
evidence, the newest `<lvs-record-id>/record.md` for the LVS verdict, and
`ldo-core/floorplan.md` for the device-to-block mapping, the placement
rationale, and the routing topology.

**The device set is read from the schematic at run time** — the flow
netlists `design/ldo_3v3in_1v8out.sch` with `xschem` and generates one block
per element it finds, so the layout cannot describe a different circuit than
the schematic. Issue #15's first cut instead carried a hand-transcribed
device table; that table is what went stale (see "LVS" below), which is why
issue #33 replaced it rather than extending it.

### DRC (issue #16)

Issue #16 formalized the DRC-clean claim for this block as its own T1 re-read
(#12) item 3 evidence: re-running the flow fresh and confirming the clean
result reproduces. That still holds, and the coverage caveat it recorded no
longer applies.

Issue #16's record ran against a placed-but-unrouted skeleton, so
`drc.json`'s `coverage.rules_skipped` listed every `met1`/`met2`/`via`/`mcon`
rule (no metal existed to check) and `coverage.layers_checked` covered 4 of
the deck's 8 layers. Now that the block is routed, the newest record checks
**all 8 layers with 0 rules skipped** — the metal/via rules that were
structurally unexercised before are exercised for the first time, and the
result is still `status: clean`.

## LVS against the schematic (issue #17)

```bash
layout/bin/setup-venv.sh          # once, or after bumping requirements.txt
layout/bin/run-ldo-layout-flow.sh # (re)generate the layout/DRC record first
layout/bin/run-ldo-lvs-flow.sh    # xschem netlist -> reference -> extract -> lvs -> report
```

Read the newest `ldo-core/reports/<lvs-record-id>/record.md` (also pointed to
by `ldo-core/reports/LATEST-LVS`) for the actual evidence. **As of issue #33
this reports `status: match`** — every schematic net, device and port paired.

Three request-level hooks make that compare well-posed, each disclosed as its
own `warning` in `lvs.json` so a match reached through them is never
indistinguishable from one reached without (see `run-ldo-lvs-flow.sh`'s
header):

- `options.combine_devices` folds the layout's parallel unit devices (a wide
  device is drawn as N strapped units) back into the single `W_total`-wide
  device the reference states;
- `layout.declared_pins` keeps the block's interface to the schematic's own
  four ports, since every routed net is labelled with its schematic name;
- `reference.device_bulk` supplies the bulk net for the third terminal
  `klt extract` gives a drawn poly resistor and a schematic netlist has no
  node for.

**The first run (issue #17) reported `mismatch`**, against the then-committed
placed-but-unrouted skeleton: a device table that had gone stale against the
schematic, `M_PASS` drawn at `W` rather than `W * mult`, and no inter-block
routing. That record is kept as append-only evidence; issue #33 closed all
three gaps — structurally for the first (netlist-driven generation), not by
re-transcribing the table.

### What a `match` here does and does not certify

- It **does** certify that every drawn MOS/resistor device and every drawn
  net corresponds 1:1 with the schematic's, including both body nets (the
  layout draws a real n-well tie and a real substrate tie).
- It **does not** cover the schematic's four capacitors: the core flow
  does not integrate them, so they are drawn on neither side. (This once
  read "`klt gen` has no capacitor generator"; that tool gap closed with
  klayout-tools#1117's `cap_array`. The remaining gap is full-core
  integration -- see `ldo-core/floorplan.md`'s "Known gap".) The compensation network is exactly what the loop's stability
  depends on most, so this is a real coverage gap, not a formality.
- It **does not** distinguish device voltage flavor: `klt lvs` compares
  `klt extract`'s generic `nfet`/`pfet` classes, which the drawn `hvi`
  (75/20) marker does not split (re-measured at the current pin — see
  "Known klt-deck limitations" below). The marker *is* drawn on every MOS
  block and *is* load-bearing, but for `klt extract --pdk`'s model binding
  (`sim/pex-post-layout`), not for this compare.
- It says nothing about parasitics (issue #20). It also said nothing about
  whether the routing this flow draws is adequate for the load current
  `VIN`/`VOUT` actually carry — see "Power routing for the load-current nets"
  below, which replaces that caveat with a drawn, sized conductor and a
  measured statement about what can and cannot be verified about it here.

## Power routing for the load-current nets (issue #154)

Until issue #154 this flow drew **every** net as the same 0.30 µm met1
channel trunk, `VIN` and `VOUT` included — a signal-grade wire on the two
nets that carry every milliamp the block delivers. That is no longer true:
`gen-ldo-blocks.py` identifies the load-current nets mechanically (the widest
drawn MOS's own drain and source, so the layout cannot name a different pair
than the schematic does) and draws each of them as a strapped two-level rail
above the device row instead of a trunk below it.

**The width is computed, not chosen.** `layout/bin/_spec_constants.py` reads
the ratified `Load` and `Dropout @ 50 mA` rows out of `spec/target-spec.md`
itself — the same discipline `MOS_MODELS`/`MOS_VOLTAGE_FLAVORS` follow, and
the same reason issue #33 stopped transcribing the device table — and the
sheet resistances come from `klt`'s own parasitics deck, the deck the landed
layout is measured against. Each rail is then exactly as wide as it must be
for the ratified load current to drop no more than its share (5%, split
evenly across the two rails) of the ratified dropout budget across the span
over which it actually carries that current. The required width, the drawn
width, the resulting resistance and the resulting IR drop are all reported in
the layout record's own `floorplan.json`, and a clamp against the floorplan
cap would be reported rather than silent.

Each load-current terminal's li1 source/drain pad is also strapped over its
full height by met1 with an mcon every 2 µm, instead of being contacted at
one point mid-pad — without that, a 100 µm-tall unit device's share of the
load current runs up to half a device height along ~12.8 Ω/□ local
interconnect before it reaches metal.

### What this is verified against, and what it is not

- **DRC stays clean** on the resized geometry (`violation_count=0`, all
  layers checked) and **LVS still matches** — both in this directory's own
  newest records. The wider rails and the extra met3 level introduced no new
  width/spacing violation.
- **The drawn conductor's resistance is a computed claim, not a measured
  one.** It follows from the deck's own sheet resistances and the drawn
  geometry, and the arithmetic is unit-tested in `layout/tests/`, but no tool
  in this flow re-measures it from the stream.
- **`klt extract --parasitics` cannot confirm it at this pin**, and this is
  measured rather than assumed. Its lumped per-net R model reduces a net's
  geometry on each conductor level to one equivalent rectangle and then
  **sums the levels in series**, so (a) N parallel fingers read as one
  N-times-longer series wire and (b) strapping a rail onto a second level
  *raises* the reported resistance. Extracting the pre-#154 and post-#154
  GDS with `--parasitics` and comparing the per-level breakdown:

  | Net | role | pre-#154 | post-#154 |
  | --- | --- | --- | --- |
  | `VOUT` | `metal0` (li1, 12.8 Ω/□) | 165 467 Ω | 153 677 Ω |
  | `VOUT` | met1 + met2 | 386 Ω | 813 Ω |
  | `VIN` | `metal0` (li1) | 171 621 Ω | 160 404 Ω |
  | `VIN` | met1 + met2 + met3 | 1 012 Ω | 2 530 Ω |

  The routing levels this issue actually controls are **under 1%** of the
  reported total in both records; 98–99% of it is the li1 term, which is the
  device generator's own source/drain pads and is invariant under every knob
  this flow has (the modelled square count works out to `W_total / w_pad`
  however the width is folded). So the extracted netlist's full-load rows
  stayed non-physical after this fix — see `sim/pex-post-layout/README.md`
  for the record and the numbers.

  Filed generically per the friction protocol as
  [`klayout-tools#2458`](https://github.com/2AMLogic/klayout-tools/issues/2458)
  (per-level series summation), and cross-confirmed on the already-tracked
  [`klayout-tools#2391`](https://github.com/2AMLogic/klayout-tools/issues/2391)
  (parallel fragments summed in series) rather than re-filed.

**The honest summary**: the load-current nets are now drawn as power
conductors sized from the ratified spec, and that is a real change in the
layout; but this repo cannot yet *measure* the improvement, because the only
instrument it has for post-layout resistance is blind to conductor width on
exactly this geometry. Do not read a post-layout full-load number as a
statement about this routing until that instrument can distinguish the two
GDS files above. That is tracked as issue #162, blocked on the two upstream
issues.

One acceptance criterion a power conductor needs is also **not** checked here:
current density / electromigration. The curated sky130 deck `klt drc` runs
against declares no current-density rule, so "no new DRC violation" is not
"this rail carries the ratified load current indefinitely". The drawn widths
are far above any plausible EM minimum at this current, but that is an
argument, not a check.

## ERC supply spec — T1 item 11, power delivery (structural) (issue #112)

```bash
# its OWN pinned klt build -- see layout/erc-requirements.txt for why
layout/bin/setup-venv.sh --requirements layout/erc-requirements.txt
layout/bin/run-ldo-erc-flow.sh    # pre-flight -> klt erc -> 4 controls -> record
```

No PDK install is needed for this one: `klt erc --pdk sky130` reads its
antenna-limit table from `klt`'s own built-in transcription of SkyWater's
published rule tables, not from a local PDK tree.

Read the newest `ldo-core/reports/<erc-record-id>/record.md` (also pointed
to by `ldo-core/reports/LATEST-ERC`) for the actual evidence.
[`ldo-core/erc-supply-spec.json`](ldo-core/erc-supply-spec.json) is the spec
itself, and it carries an inline comment block justifying every layer number
against **two** independent sources — the sky130 PDK's own
`libs.tech/klayout/tech/sky130A.lyp` and klayout-tools' curated `sky130`
deck layer table — rather than copying them from another PDK's spec.

**What item 11 grades, and what it does not.** The item is the *structural*
power-delivery question ("is the supply connected to what it powers"), read
from the report's connectivity half:

- every declared supply (`VIN`, `0`, both `"kind": "supply"`) resolves to
  exactly **one** electrical island — no `erc.unconnected_net`, no
  `erc.supply_short`;
- zero `erc.missing_tie`, **from ties the run actually checked**.

It is *not* read from the report's top-level `status`, which is the antenna
verdict (klayout-tools#1994), and it deliberately excludes IR-drop and EM
(`klt power`) — the *analysis* question.

Three things about this repo's spec are worth knowing before reading it:

- **Both ties are declared and graded.** Issue #112 was written expecting
  the opposite: omit `ties[]`, because klayout-tools#2169 made a declared
  tie collapse a routed design into one island and report a false
  `erc.supply_short`. That is fixed on the pin in
  `erc-requirements.txt` (a tie now gets its own isolated extraction), and
  it matters for the verdict rather than for tidiness — a spec with zero
  `ties[]` grades `supply_spec_incomplete` (**unmet**), and a
  `ties_disclosure` of either kind grades unmet too.
- **The substrate tie rests on an asserted region.** sky130 NMOS sit in the
  native p-substrate and this block draws no pwell shape, so the substrate
  region is declared with `well_layer: null` + `well_boxes`
  (klayout-tools#2255) — a caller assertion, graded in its own
  `erc_coverage.checked_by_well_assertion` bucket.
  `layout/bin/check-erc-supply-spec.py` re-derives the box from the GDS
  before every run and fails if the committed one has gone stale or loose,
  so a floorplan change cannot leave the assertion standing unexamined.
- **Every run records four falsification controls.** Each item-11 check
  passes by reporting *nothing*, so the flow also mutates the committed spec
  four ways and records that each mutation does fire the rule the clean
  verdict is claiming the absence of (a moved substrate box, a tie pointed
  at the wrong rail, an undrawn supply name, and the feedback divider read
  as wire with the `devices[]` carve-out removed). They are generated from
  the committed spec at run time rather than committed as four more files —
  a control that silently stopped mutating the real spec would be worse than
  no control.

**What a clean ERC verdict here does and does not certify.**
`erc.missing_tie` asks a connectivity question — does each well (or asserted
substrate region) hold a tap that reaches its declared net. It says nothing
about tap **density**, and this block draws exactly one n-well tap and one
substrate tap across a 2.4 mm span. Latch-up and body-bias robustness are
layout-quality questions for DRC and the floorplan, outside what this item
can see.

## Known klt-deck limitations relevant to later, LDO-specific layout issues

Not gaps to file (documented, deliberate scope limits of the curated
`sky130` deck, not bugs) but worth flagging now for whichever later issue
takes on the LDO's own layout, since this issue's own scope stops at the
trivial-cell proof:

- **NMOS substrate-tap extraction needs a drawn tap** (superseded in
  practice, kept for the trivial cell). The curated deck falls back to a
  single global `vsubs` net when no substrate tie is drawn
  (`docs/cli/extract.md` → "Coverage"), which is what the trivial cell hits
  and what its `record.md`'s `device.body_unverified` note records. The deck
  *does* resolve a real tie: sky130's `tap.drawing` split by `nwell`
  containment gives a well tie inside the well and a substrate tie outside
  it. `ldo-core/` draws one of each, so its NMOS bodies extract as the
  schematic's own `0` rail and that warning does not appear on its LVS
  record.
- **No voltage-flavor distinction on MOS devices — on the LVS path.** `klt
  extract`'s `nfet`/`pfet` classes are flavor-agnostic — a 5 V-flavor
  (thick-oxide) device and a core-voltage device both extract as the same
  generic class, with no `L`/`W`/oxide-thickness-based disambiguation. This
  matters directly because the pass-device flavor is already ratified as
  `pfet_g5v0d10v5` (framing A, per DR-001 / issue #1) rather than the 1.8 V
  core devices: a future LVS reference netlist will need `hints`/manual review
  to confirm the *intended* flavor correspondence, since `klt lvs` cannot check
  it structurally.

  **Still true at the `040f3406` pin, and re-measured rather than assumed**
  (2026-09-24, issue #142): the newest LVS record's own `extract.json`
  reports `device_classes: ['nfet', 'pfet', 'pnp', …]` and
  `device_counts: {'nfet': 18, 'pfet': 74, …}` — generic classes, with the
  drawn `hvi` marker making no difference to them. `gen-ldo-reference-
  netlist.py` therefore still collapses both `g5v0d10v5` model names onto
  `nfet`/`pfet` and needs no flavor distinction of its own; adding one would
  only create a mismatch against a layout side that cannot express it.

  **The `--pdk` binding path is a different story, and is where the marker
  pays off.** `klt extract --pdk sky130A` binds each extracted gate to a real
  PDK subcircuit, and *that* table is marker-scoped: a gate overlapping `hvi`
  (75/20) binds `sky130_fd_pr__{n,p}fet_g5v0d10v5`, and an unmarked one binds
  the 1.8 V core flavor. `gen-ldo-blocks.py` draws that marker on every MOS
  block (see its `MOS_VOLTAGE_FLAVORS`, keyed on the same schematic model
  token as `MOS_MODELS`), which is what makes `sim/pex-post-layout`'s
  extracted-side leg re-simulate the design's own devices. So the flavor is
  expressed in the layout and checked by the `--pdk` bind — just not by
  `klt lvs`.
- The deck does recognize `pnp` (vertical bipolar) and poly-resistor
  sheet-rho flavors as distinct device classes (see `klt extract`'s own
  `device_classes` field) — the primitive families this repo's LDO will
  need are already modeled in principle; the `res_array` generator gap
  above is the one concrete blocker on the resistor family specifically,
  and only for the `klt gen`-generated fixture path, not for hand-drawn or
  PCell-instanced resistor geometry that already carries the marker layer.

## Core-area record (issue #236)

The ratified Area row (`< 0.1 mm²`, pass FET included, pads/sealring excluded)
is judged by `layout/bin/render-ldo-area-record.py`, which measures the routed
`ldo_core.gds` named by `reports/LATEST` with `layout/bin/_gds_area.py` (standard
library only; its module docstring is the single statement of the geometry
convention: the top cell's flattened bounding rectangle over all layers,
hierarchy and path widths included, database units read from the stream, strict
`<` so exactly 0.1 mm² fails). It mints a NEW append-only
`reports/<UTC>-<sha>/` directory (`area.json` + `record.md`, citing the GDS by
path and SHA-256) and moves `reports/LATEST-AREA`; earlier records are never
edited. `measurements/build_characterization_report.py` reads the record's
`verdict` verbatim and marks the Area row STALE when the routed GDS in the
current `LATEST` record no longer hashes to the recorded value -- re-run the
layout flow, then mint a new area record. The first record
(`20261008-161046-f4fbb86`) is a **FAIL**: 2430.17 µm × 183.86 µm = 0.4468 mm²,
cross-checked against `klt stats`. The target is unchanged; compaction is a
separate task. Tests: `layout/tests/test_gds_area.py`.

## ERC supply-spec checker tests (issue #249)

`layout/tests/test_check_erc_supply_spec.py` pins the three pre-flight checks in
`layout/bin/check-erc-supply-spec.py` (stackup covers drawn routing, drawn-well
narrative, substrate `well_boxes` assertion) with tiny in-memory `klayout.db`
layouts: one passing case and one negative control each, plus the `main()`
exit-code contract. No PDK is needed, but the `klayout` module is: the tests run
in the layout ERC venv (`layout/.venv-erc`) and are skipped, with an explicit
reason, where `klayout` is not importable (CI's headless `checks` job installs
no klayout wheel).

## MiM capacitor + supply-rail overlay demonstrator (issue #254)

`layout/cap-rail-demo/` holds a bounded demonstrator -- not the core -- that
draws the schematic's four capacitors as stacked sky130 MiM arrays over the
planned core outline, with the load-current rails on a proposed metal
assignment that confines met3 rail use to the column above the pass device.
`layout/bin/run-cap-rail-demo-flow.sh` checks it with the curated `klt drc`
deck, the PDK's own `sky130A_mr.drc`, `klt extract` (devices and parasitics) and
`klt lvs` against a schematic-derived reference plus two negative controls, and
renders a feasibility verdict against the unchanged Area row. It runs on its own
klt pin (`cap-requirements.txt`), so the ldo-core records keep theirs. See
`layout/cap-rail-demo/README.md` for the metal assignment, every disclosed LVS
condition and the five klayout-tools issues it filed. Tests:
`layout/tests/test_cap_rail_plan.py` (stdlib only).
