2AMLogic/sky130-ldo/sim/pex-post-layout/README.md

# `pex-post-layout`: post-layout (parasitic-extracted) verification (issue #20)

Item 7 ("Post-layout verification") of the T1/bronze checklist re-read (#12).
Produces a post-layout, parasitic-extracted netlist for the routed
`ldo_core` layout (#15/#17/#33) via `klt pex`, and re-runs a re-simulation
against it, per-corner, alongside the schematic-side run for comparison.

## Why this directory, not `sim/<slug>/experiment.json`

`klt pex <layout> <testbench>... --deck sky130` (Phase 1a of
[klayout-tools#709](https://github.com/2AMLogic/klayout-tools/issues/709))
takes `klt sim`-format request JSON files as its testbenches -- a different
schema from this repo's own `sim/<slug>/experiment.json` + `corner-run.py` +
xschem-`.sch`-testbench convention. This directory holds a `klt
sim`/`klt pex`-native testbench pair instead:

- `testbench/ldo_core_schematic_dut.spice` -- the schematic-side DUT (a
  `.SUBCKT ldo_core <pins>` circuit body).
- `testbench/tb_pex_post_layout.spice` -- the testbench: `.include`s the DUT
  above, adds sources/an output network, and instantiates it.
- `testbench/tb_pex_post_layout.request.json` -- the `klt sim` request
  (corners, analysis, measurements) both the schematic-side and
  extracted-side legs run under.
- `bin/gen-pex-testbench.py` -- regenerates the two `testbench/*.spice`
  files above from the current schematic + landed layout (see "Regenerating"
  below). The `.request.json` is static and not regenerated.
- `bin/run-pex.sh` -- regenerates the testbench pair, runs `klt sim`
  (schematic-side, standalone) and `klt pex` (both legs + delta) against the
  landed layout, and writes a new record.
- `bin/render-pex-record.py` -- called by `run-pex.sh`; renders the
  `records/<id>.{json,md}` pair below from the raw `klt` responses.
- `klt-requests/<record-id>.request.json`, `klt-responses/<record-id>.{sim-schematic,pex}.json`,
  `netlist-snapshots/<record-id>.{schematic-dut,pex.extract}.spice`,
  `records/<record-id>.{json,md}` -- append-only evidence per run, same flat
  per-record-id-file convention `sim/dropout-vs-load/`,
  `sim/mc-output-accuracy/`, etc. already use (a later run mints a new
  `<record-id>`, never overwrites an earlier one).

`layout/` and `design/` are read-only inputs to this experiment -- nothing
here modifies either.

## Why a fresh xschem netlist, not the committed LVS reference

Issue #17's LVS flow (`layout/bin/run-ldo-lvs-flow.sh`) and its committed
`layout/ldo-core/reports/<record>/reference.spice` translate the schematic
into a **generic-device-class** netlist (`nfet`/`pfet`/`res_high_po`/
`res_xhigh_po`, via `layout/bin/gen-ldo-reference-netlist.py`) for
topological LVS comparison -- adequate for `klt lvs`, but two problems for
*this* experiment:

1. **Staleness.** A landed LVS report pins the schematic commit it ran
   against (its own `record.md`'s "Schematic freshness" line). The schematic
   can move on after that record is cut -- it did: the currently-landed LVS
   record (`20260818-034303-d0b244d`) was cut against `design/
   ldo_3v3in_1v8out.sch` as of commit `d0b244d`, and a later commit
   (`fdd6ebf`, already on `main`) renamed a duplicate-named component
   (`M_ENP4` -> `M_ENP5`) that `d0b244d`'s netlist still carries under the
   old, colliding name -- confirmed by direct trial: `ngspice` refuses that
   stale `reference.spice` outright ("device already exists, bail out").
   Purely a naming fix (same symbol/geometry/connections both before and
   after, per `git diff d0b244d..HEAD -- design/ldo_3v3in_1v8out.sch`), so
   it does not change circuit behavior -- but it does mean the *committed*
   reference netlist cannot be directly ngspice-simulated as of current
   `main`. This experiment's generator (`bin/gen-pex-testbench.py`) always
   netlists `design/ldo_3v3in_1v8out.sch` fresh (the same headless
   invocation `run-ldo-lvs-flow.sh` uses) rather than reusing a committed
   report, so it is never stale relative to whatever schematic commit it is
   run against.
2. **Generic device classes turned out not to be directly simulatable for
   this layout at all** -- see "Why `--pdk sky130A`" below. The DUT this
   experiment uses is therefore the schematic's own **real**,
   `sky130_fd_pr__nfet_g5v0d10v5`/`pfet_g5v0d10v5`-modelled netlist (the
   same xschem output `design/README.md`'s "Validating this schematic"
   section documents), not the LVS translator's generic-class output.

## Why `--pdk sky130A` (and its cost -- read this before trusting a number)

`klt pex`'s own internal `klt extract` call has no `--pins` flag (unlike
`run-ldo-lvs-flow.sh`'s explicit `--pins VOUT,VREF,EN,VIN`), so its
extraction promotes **every** labelled net in the layout to a top-level pin
-- 28 of them for `ldo_core`, not just the schematic's 4 ports. `bin/
gen-pex-testbench.py` re-derives that exact 28-pin order live (a throwaway
probe extraction against the landed GDS) and widens the DUT's `.SUBCKT
ldo_core` header to match, so the testbench's single `X` instantiation wires
identically on both legs.

Two device-model choices were tried, in order, both confirmed by direct
trial rather than assumed:

1. **Bare (no `--pdk`) generic-class extraction.** `klt extract`'s
   sky130 deck always writes its drawn-resistor classes (`res_high_po`,
   `res_xhigh_po`) as a **3-terminal** `R` card
   (`R$68 VIN NB 0 1160477.00515 res_high_po` -- the third node is the
   resistor's own bulk/tap terminal), regardless of `--parasitics`. ngspice's
   native `R` element only ever accepts 2 nodes; simulating this card against
   a bare `.model res_high_po r` fails outright:
   `Error on line ...: unknown parameter (res_high_po)`. `docs/cli/extract.md`'s
   "Verified compatible with `klt sim`'s netlist convention" section
   documents the 2-terminal case (`res_generic_po`); sky130's 3-terminal
   resistor classes are a real, structural exception this repo's own trial
   surfaced, not a documented gap as of 2026-08-18 (searched
   `2AMLogic/klayout-tools` issues for "res_high_po"/"3-terminal
   resistor"/"resistor bulk terminal"/"unknown parameter" -- nothing found
   matching). **This means the bare, generic-class path is not currently
   usable for this design's post-layout re-simulation at all** -- filed as
   [klayout-tools#1157](https://github.com/2AMLogic/klayout-tools/issues/1157)
   (friction protocol, generic -- no design-specific detail); see that issue
   for status.
2. **`--pdk sky130A` binding (used here).** Sidesteps the resistor problem
   entirely -- every device (MOS and resistor alike) becomes a real PDK `X`
   subcircuit call, which supports arbitrary pin counts. Its own disclosed
   cost: `klt extract --pdk`'s MOS model-binding table
   (`src/klayout_tools/pdk_models.py`) is hardcoded to sky130's **01v8**
   core-device flavor, one flavor per class, with no caller override. This
   design's schematic uses the 5V-tolerant **g5v0d10v5** flavor throughout
   (`design/ldo_3v3in_1v8out.sch`'s own xschem netlist,
   `sky130_fd_pr__nfet_g5v0d10v5`/`pfet_g5v0d10v5`).

   **Update (2026-08-24, issue #67):** originally tracked as
   [klayout-tools#1089](https://github.com/2AMLogic/klayout-tools/issues/1089)
   ("#552's warning-only fix (PR #577) leaves DRC threshold selection and MOS
   model binding wrong for voltage-domain-marked geometry"). #1089 has since
   **closed** (2026-08-24, "tracking issue, work complete"), decomposed into
   #1110 (DRC-side) and #1111 (MOS-model-binding side) -- but re-checked live
   against current `main` (`3c14ac2`), both landed **gf180mcu-only**;
   #1111's own body states sky130 needs its `hvi` layer registered as a
   prerequisite first and is explicitly out of scope there.
   `pdk_models.py`'s `_MOS_MODEL_FLAVOURS` table confirms this directly: it
   has marker-scoped entries for `("gf180mcu", "gf180mcu")` and
   `("sg13g2", "sg13g2")` but none for `("sky130", "sky130")`, and
   `decks/sky130.py`'s `UNMODELED_VOLTAGE_MARKERS` is still empty. So this
   caveat is **unchanged in substance** -- every sky130 MOS device still
   binds to `*_01v8` regardless of its drawn flavor -- but #1089 no longer
   accurately describes it as tracked, since neither #1089 nor its
   sub-issues cover sky130. Re-filed sky130-specific as
   [klayout-tools#1369](https://github.com/2AMLogic/klayout-tools/issues/1369)
   (friction protocol, generic -- no design-specific detail; verified no
   existing open issue covered this before filing).

   **Update (2026-09-23, issue #122): #1369 is fixed upstream.** PR #1381
   (already contained in release `v0.5.0`) added the marker-scoped
   `("sky130", "sky130")["hvi"]` -> `sky130_fd_pr__{n,p}fet_g5v0d10v5`
   entry to `_MOS_MODEL_FLAVOURS`, with the `hvi` 75/20 pair
   cross-checked against three independent PDK sources, plus a follow-up
   (`a261706c`, #1912) fixing the `klt gen` side. The binding is
   **marker-scoped**: a device binds the g5v0d10v5 model only when its
   gate region overlaps an `hvi` (75/20) polygon. At that point the landed
   `ldo_core` GDS contained **no** `hvi` polygons at all (verified by a
   direct layer scan of `layout/ldo-core/reports/<LVS-record>/ldo_core.gds`:
   15 layer/datatype pairs, 75/20 absent), so all 67 MOS devices still bound
   `*_01v8` -- no longer an upstream gap but a repo-local layout omission,
   tracked in #142.

   **Update (2026-09-24, issue #142): the repo-local half is closed too.**
   `layout/bin/gen-ldo-blocks.py` now passes `voltage_flavor="hvi"` on every
   MOS block, keyed on the schematic's own model token
   (`MOS_VOLTAGE_FLAVORS`, the same schematic-derived discipline its
   `MOS_MODELS` map already followed) rather than a hand-transcribed
   per-device list, and hard-fails if `klt gen`'s
   `drc_hints.voltage_flavor_mark_present` comes back false instead of
   silently drawing nothing. The marker is now really in the stream and the
   bind really follows it -- both measured on the 2026-09-24 record, not
   assumed; see the record note at the end of this file for the numbers.

## A third gap: `--pdk`'s resistor X-card geometry convention itself fails

Running the actual `klt pex` command (not just a standalone `klt sim` on the
schematic side) surfaced a **third**, independent, and more severe gap:
`klt extract --pdk`'s resistor binding writes explicit-SI-unit-suffixed
geometry (`l=180U w=0.42U`), matching its own documented MOS-binding
rationale ("an explicit SI unit suffix is parsed identically by ngspice
regardless of any `.option scale`"). Confirmed by direct trial against the
**real, fetched** `sky130_fd_pr__res_xhigh_po` vendor subcircuit: this
convention is incompatible with that subcircuit's own internal `.param`
formula (`leff = l-0.0592`, which assumes `l` arrives as a **bare
micron-scale number**, not an absolute-SI value) -- the SI-converted `l`
(`1.8e-4`) is dwarfed by the `0.0592` offset, driving `leff` negative and
`log(leff/w)` to `NaN`, **regardless of the actual resistor dimension
chosen** (reproduced with a minimal, `klt`-free reproducer: bare `l=180
w=0.42` converges to a sane operating point; unit-suffixed `l=180U w=0.42U`
-- the exact form `--pdk` writes -- fails identically). Filed as
[klayout-tools#1159](https://github.com/2AMLogic/klayout-tools/issues/1159)
(friction protocol, generic -- confirmed real via a `klt`-free reproducer
before filing).

**Update (2026-09-23, issue #122): fixed upstream.** #1159 (and #1157
with it) closed COMPLETE via `2dc66ece` (PR #2336: "bare-mode 3-terminal
resistor cards become X subckt calls (#1157); lock sky130 resistor bare-um
geometry + vendor proof (#1159)"). The 2026-09-23 run below confirms both
fixes live at the pinned commit: the extracted netlist's resistor X-cards
carry bare-micron geometry (`l=180 w=0.42`) and the real
`sky130_fd_pr__res_{high,xhigh}_po` vendor models converge.

**Consequence: the extracted-side leg of `klt pex` does not converge for
this layout today**, for three independent, real, disclosed reasons (none
within this repo's control): the bare/generic path is blocked by #1157 (a
3-terminal resistor class ngspice cannot simulate as an `R` card at all);
the `--pdk` path resolves that but hits #1159 (NaN in the real resistor
vendor model, from `--pdk`'s own geometry-unit convention) *and* carries
the disclosed #1369 MOS-flavor-substitution caveat (sky130-specific; see the
"Update (2026-08-24, issue #67)" note above -- supersedes the now-closed,
gf180mcu-only #1089) even where it does converge. The latest
`klt-responses/<record-id>.pex.json` is the honest,
recorded result of the actual `klt pex` invocation against the landed
layout: `status: "error"`, every `delta[]` row's extracted-side leg
`null`/`"error"` (schematic-side values are real and populated). This is
**not a fabricated pass** -- it is the literal, reproducible output of the
command run against the landed layout and committed testbench, with root
cause traced and disclosed rather than hidden. It still satisfies issue
#20's actual acceptance criteria: a post-layout extracted netlist *is*
produced and committed (`extraction` step of `klt pex` succeeds
independently of the simulation step that follows it -- see the matching
`netlist-snapshots/<record-id>.pex.extract.spice`), and post-layout
verification *is* run and recorded as append-only evidence against the
layout as landed -- the evidence is an honestly-labeled `error`, not a
`pass` dressed up as one. The schematic-side leg's own full 45-point PVT
sweep (`klt-responses/<record-id>.sim-schematic.json`, run directly via
`klt sim` against the same testbench/DUT) is clean (`passed: 45`) and is
the closest thing to a spec-comparable number this experiment produces --
still not usable against `spec/target-spec.md`'s ratified rows, since there is
no matching extracted-side number to diff it against. See
`records/<record-id>.md` for the latest run's own summary and links.

**Update (2026-09-23, issue #122): the extracted-side leg now runs --**
**108/135 delta rows pass; the 27 surviving errors share one repo-local**
**root cause.** With the `klt` pin moved to the `040f3406b485` main-branch
commit (see the pin section below -- no release contained the #1157/#1159
fixes at recording time), the extracted leg converges and produces real
extracted-vs-schematic numbers: record
[`20260923-183915-d9900b5`](records/20260923-183915-d9900b5.md) reports
`passed: 108, failed: 0, errored: 27` (superseding
`20260825-125102-3b4e121` above), the 27 being 9 `ss`-corner delta rows x
3 measurements. Their root cause is the flavour substitution described in
the #1369 update above: with no `hvi` markers in the layout, all 67 MOS
devices bind `*_01v8` at g5v0d10v5 geometries, and at `ss` corners the
substituted model's binning fails ngspice's BSIM4 parameter check
outright (`Fatal: Pclm = -0.00876203 is not positive`, `dc
simulation(s) aborted` -- read in the run's own
`sim/build/pex-post-layout/<record-id>/pex/.../extracted/ss_*/ngspice.log`).
That is a **repo-local** layout task now (#142 draws the marker), not an
upstream gap; the residual upstream friction -- `klt extract --pdk` stays
silent when a deck declares flavour markers but the layout contains none
-- is filed as
[klayout-tools#2417](https://github.com/2AMLogic/klayout-tools/issues/2417)
(friction protocol, generic). Until #142 lands and this experiment is
re-run, **T1 item 7 remains unmet** (item 7 accepts a `klt pex` report
and nothing else; 27 errored corners are 27 errored corners).

**Update (2026-09-24, issue #142): every corner now runs -- and what that
exposes is a *different* problem, one this repo owns.** With the `hvi`
marker drawn (see the #142 update above), record
[`20260924-181248-50554fe`](records/20260924-181248-50554fe.md) reports
`status: pass, passed: 135, failed: 0, errored: 0`, exit code `0`
(superseding `20260923-183915-d9900b5`). The 27 `ss`-corner aborts are gone:
the extracted netlist binds `sky130_fd_pr__{n,p}fet_g5v0d10v5` on all 92 MOS
devices (18 n + 74 p, counted directly out of
`netlist-snapshots/20260924-181248-50554fe.pex.extract.spice`), so ngspice
no longer hits the `Pclm` BSIM4 parameter check that the substituted
`*_01v8` model's binning failed. Every `ss` extracted-corner log under
`sim/build/pex-post-layout/20260924-181248-50554fe/pex/.../extracted/ss_*/`
is clean.

**Do not read that `pass` as agreement between the two legs.** At the time of
that record this experiment's request
(`testbench/tb_pex_post_layout.request.json`) declared **no limits** on any of
its three measurements, so `klt pex` graded every `delta[]` row against
nothing and `pass` meant only "both legs produced a number". (Limits were
declared as of the next record — issue #154, see the 2026-09-24/#154 update
below — so this caveat is historical for `20260924-181248-50554fe` and does
not apply to the current record.) The record's own `delta[]`-spread table is
the number that matters, and it is large:

| Measurement | median \|delta\| % | max \|delta\| % |
| --- | --- | --- |
| `vout_light_load_v` (1 mA) | 1.9 | 161 |
| `vout_full_load_v` (50 mA) | 385 | 3543 |
| `vin_minus_vout_full_load_v` (50 mA) | 633 | 4775 |

At light load the extracted leg tracks the schematic within ~2% at most
corners -- a plausible parasitic delta. At **full load it is non-physical**:
the extracted `VOUT` lands at -5.7 V (`tt/2.970V/-40C`) to -61.9 V
(`ss/3.300V/-40C`).

The traced cause is this flow's routing, not the flavour fix and not the
extraction: `gen-ldo-blocks.py` draws every net as a `TRUNK_W_UM = 0.30`um
met1 trunk -- signal-grade, and the same "says nothing about whether the
signal-grade routing this flow draws is adequate for the load current
`VIN`/`VOUT` actually carry" caveat `layout/README.md` has carried since
issue #17. The extracted `VOUT` net's lumped star resistance runs 102 Ω to
**64.3 kΩ** per terminal across its 51 terminals (`VIN`: 259 Ω to 29.4 kΩ
across 145), so at 50 mA the IR drop swamps the loop and the solver leaves
the regulating branch entirely. **This is a real layout defect the
flavour-substitution error was previously masking** -- it is tracked
as #154 and is *not* in #142's scope, which was to make the extracted
netlist describe the design's own transistors.

**Update (2026-09-24, issue #154): the power routing was fixed, the
measurement barely moved, and the reason is now itself measured.** Record
[`20260924-230726-a947aa8`](records/20260924-230726-a947aa8.md) is cut against
a layout in which `VIN`/`VOUT` are no longer 0.30 µm signal trunks: they are
strapped two-level rails whose width is computed from the ratified full-load
current and dropout budget (0.15 Ω each by construction -- see
`layout/README.md`, "Power routing for the load-current nets"), and every
load-current terminal's li1 pad is strapped over its full height by met1. DRC
is still `clean` and LVS still `match` on that layout.

The full-load rows are still non-physical:

| Measurement | `20260924-181248` (pre-#154) | `20260924-230726` (post-#154) |
| --- | --- | --- |
| `vout_full_load_v` extracted, min | −61.937 V (`ss/3.300V/-40C`) | −37.909 V (`sf/2.970V/-40C`) |
| `vout_full_load_v` extracted, max | +1.635 V (`ff/3.630V/-40C`) | −3.801 V (`ss/3.630V/125C`) |
| `vout_full_load_v` extracted, median | −5.354 V | −5.141 V |
| corners with negative extracted `VOUT` | 44 of 45 | **45 of 45** |
| `vout_full_load_v` median / max \|delta\| % | 385 / 3543 | 381.5 / 2207 |
| `vin_minus_vout_full_load_v` median / max \|delta\| % | 633 / 4775 | 613.4 / 5043.6 |

The worst corner improved a lot (`ss/3.300V/-40C`: −61.9 V → −4.7 V) and the
spread tightened, but the median hardly moved and the one previously
non-negative corner went negative. (That corner was never a control worth
having: `ff/3.630V/-40C`'s *schematic* `vout_full_load_v` is 3.423 V, i.e. the
design itself is out of regulation there, so its +1.635 V extracted reading
was a coincidence rather than a regulating point.)

**Why, measured rather than inferred.** Extracting the pre-#154 and post-#154
GDS with `klt extract --parasitics` and reading the per-level breakdown
(`by_layer`, klayout-tools#1701):

| Net | role | pre-#154 | post-#154 |
| --- | --- | --- | --- |
| `VOUT` | `metal0` (li1, 12.8 Ω/□) | 165 467 Ω | 153 677 Ω |
| `VOUT` | met1 + met2 | 386 Ω | 813 Ω |
| `VOUT` | **total** | 165 901 Ω | 154 538 Ω |
| `VIN` | `metal0` (li1) | 171 621 Ω | 160 404 Ω |
| `VIN` | met1 + met2 + met3 | 1 012 Ω | 2 530 Ω |
| `VIN` | **total** | 172 681 Ω | 162 982 Ω |

98–99 % of the modelled resistance is the li1 term, and the routing levels
this repo actually controls are under 1 % of it. Two properties of `klt
extract --parasitics`' lumped-R model produce that:

1. **Parallel fingers are modelled as one series wire.** The per-level R is
   `sheet_rho x _n_squares(merged area, merged perimeter)`, which fits a
   single equivalent rectangle to the level's whole merged geometry. For N
   parallel `w x h` fingers that gives `W ~ w`, `L ~ N*h`, so `~N*h/w` squares
   -- N times *one* finger's resistance, where the physical parallel value is
   `(h/w)/N`. A wide device drawn the standard way (N parallel unit devices
   with strapped terminals) presents exactly that geometry on li1, and the
   modelled square count works out to `W_total / w_pad` however the width is
   folded -- invariant under every knob this flow has. Tracked upstream as
   [klayout-tools#2391](https://github.com/2AMLogic/klayout-tools/issues/2391);
   **cross-confirmed there rather than re-filed**, per `CLAUDE.md`'s friction
   protocol.
2. **Strapped levels are summed in series.** `base_r_ohm[net] += metal_r_ohm`
   per conductor level, so tying two levels together with a via array to halve
   a rail's resistance *raises* the reported number -- visible above as
   `VOUT`'s met1+met2 going 386 Ω → 813 Ω and `VIN`'s 1 012 Ω → 2 530 Ω. Filed
   generically as
   [klayout-tools#2458](https://github.com/2AMLogic/klayout-tools/issues/2458).

Both biases point the same way, so the reported per-net R for a power
conductor is **essentially insensitive to how that conductor is drawn**. That
is the operative finding: this experiment currently cannot tell an adequate
power rail from an inadequate one, so a full-load number out of it is not
evidence about the routing in either direction.

**What #154 did and did not settle.** It closed the layout defect it was filed
for -- the load-current nets are no longer drawn as signal wires, and the
sizing is derived from the ratified spec rather than picked. It did not make
the full-load rows physical, and the measurement above shows it could not
have: the drawn routing was under 1 % of what the model was reporting. The
residual -- making these rows physical, which now depends on the `klt` pin
moving to a build whose parasitic-R model can distinguish the two GDS files
above -- is tracked as **#162**, blocked on the two upstream issues.

**T1 item 7 status (unchanged in substance).** A `klt pex` report exists that
ran the design's real devices at all 45 corners, which is what item 7 asks
for, and as of this record its rows are graded against declared limits rather
than against nothing. But the full-load rows remain non-physical, so nothing
in it is comparable to `spec/target-spec.md` at full load. Item 7 stays
*substantiable in kind but not in substance*; the blocker has moved from this
repo's routing to the extractor's lumped-R model (the two `klayout-tools`
issues above). `signoff/block-manifest.json` therefore still declines to cite
a passing record for item 7 -- deliberately; see `signoff/README.md`, "Item 7
has a passing record that this manifest declines to cite".

**Update (2026-10-22, issue #162): the pin moved, the rows did not.** The
`klt` pin is now `dc136150` (carries klayout-tools#4038, so `klt pex
--resistance-graph` exists; DRC `PASS` and LVS `MATCH` re-verified on it --
see `layout/requirements.txt`'s pin history, and note the LVS reference now
adds the deck's width-normalized head term). `run-pex.sh` passes
`--resistance-graph --resistance-graph-r-cut 9.3` (the sky130A PDK's `mcon`
contact resistance, the largest per-cut value in its `contact` table).
Record [`20261022-232148-56dd87fe`](records/20261022-232148-56dd87fe.md)
is the result: **0 of 28 nets are graph-derived** -- every net, `VIN` and
`VOUT` included, reports `resistance_source: legacy` with
`unsupported_geometry` ("contact/via landing(s) lie in the interior of a
conductor; ports are only attached at conductor edges"; 4542 interior
landings on `VIN`, 5648 on `VOUT` in the post-#154 layout). The extracted
netlist therefore carries the legacy lumped values and the full-load rows are
still non-physical (median `vout_full_load_v` |delta| 378 %). The pre-/post-#154
GDS cannot be separated by the graph either. This is an extractor limit, not
a routing result; it is filed generically as klayout-tools#4061. `r_cut` 0
and 9.3 gave the same `unsupported` verdict. Item 7 stays unciteable, and no
spec, bound or rail sizing was changed.

**Limits are declared as of this record (issue #154).** All three measurements
now carry `limits`, so a `delta[]` row's `pass` means the extracted value sits
inside a bound rather than merely being non-null. The `vout_*_v` bounds are
the ratified `Output` row verbatim (1.764 V .. 1.836 V). The
`vin_minus_vout_full_load_v` bound is **not** the ratified `Dropout @ 50 mA`
row: this testbench sweeps `Iload` at a *fixed* `vvin`, so that measurement is
the supply-to-output headroom, not the dropout voltage (dropout is
`sim/dropout-vs-load`'s testbench). Its bounds are derived from this request's
own declared supplies and the ratified `Output` row -- `2.97 − 1.836 = 1.134 V`
to `3.63 − 1.764 = 1.866 V` -- so the row is a physicality check that asserts
no spec line this testbench cannot measure. See the request's own
`_limits_comment` for the full derivation; an earlier draft of these limits
did read the dropout row onto this measurement and failed 41 of 45 corners on
the *schematic* side as a result, which is how the category error was caught.

**`body_bias` (read per issue #122's scope).** The current record's
`body_bias` block reads `status: "biased", unbiased_device_count: 0,
unbiased_nets: []` -- unchanged across the last three records -- so no device
body sits on an anonymous deck-synthesized net and the
physically-wrong-resimulation hazard of
[klayout-tools#1983](https://github.com/2AMLogic/klayout-tools/issues/1983)
does not bite for this layout as landed. Any claim made from this
experiment must state this alongside the numbers (`klt signoff` surfaces
the block but does not grade on it).

**On the standalone schematic-side leg's timeouts.** Record
`20260923-183915-d9900b5`'s standalone `klt sim` leg reported 36/45 passed
with 9 `timeout` errors (`ngspice did not complete within 120s, killed` -- the
testbench's own `options.timeout_s: 120` knob) at cold/low-supply corners,
while the pex run's own schematic leg *completed* those same corners (every
delta row carried a real schematic value). The timeouts were host-load-induced
under the 120 s per-corner cap, not a model or deck failure, and have not
recurred in either record since; raise `timeout_s` in
`testbench/tb_pex_post_layout.request.json` if the standalone leg is needed
standalone again on a loaded host.

## Narrative summary for the latest record (hand-maintained here, not in `measurements/characterization.md`)

`measurements/characterization.md` is generated end-to-end by
[`measurements/build_characterization_report.py`](../../measurements/build_characterization_report.py),
and its "Post-layout PEX detail" paragraph can only ever reproduce the terse
`- Result:` lines that this directory's own `records/<record-id>.md` carries.
The triage *conclusions* below -- the `klt` pin, the per-corner root-cause
attribution, the issue cross-references -- are not fields in the record's
companion `.json` and cannot be regenerated from it, so **this file is where
they live**.

Hand-editing that generated paragraph (or its matching "Limitations" bullet)
into a richer form makes `build_characterization_report.py --check` report
`characterization.md` as stale indefinitely, because no generator run can ever
reproduce prose the record does not contain -- exactly the failure issue #146
was filed for. **When a new record is minted, update this section and re-run
the generator; do not hand-edit `characterization.md`.**

### Record `20260924-230726-a947aa8` (`klt 0.6.0+g040f3406b485`) — current

First record cut against a layout whose load-current nets are drawn as sized
power rails rather than 0.30 µm signal trunks (issue #154), and the first
whose `delta[]` rows are graded against declared limits.

- `klt sim` (schematic-side leg, standalone): `status=fail, corners=45,
  passed=38, failed=7, errored=0`. **This is the first record whose
  schematic-side leg can fail at all** — limits were declared for the first
  time here, and the 7 failures are 4 corners where the design misses the
  ratified `Output` row at full load (plus its derived headroom window) and 3
  where it misses it at light load. They are the design's own, already-known
  spec gap (`measurements/characterization.md`, Output row FAIL), not an
  extraction artefact. No `timeout` errors.
- `klt pex` (schematic + extracted legs + delta): `status=fail, passed=39,
  failed=96, errored=0, pin_count_mismatch=None`, exit code `3` (a delta row
  failed its own declared limits — the documented "ran, graded, something is
  out of bounds" code, not a tool failure). Extraction: `deck=sky130,
  device_count=97, net_count=28`.
- **The power routing was fixed and the measurement barely moved.** Extracted
  `vout_full_load_v` now spans −37.909 V (`sf/2.970V/-40C`) to −3.801 V
  (`ss/3.630V/125C`), median −5.141 V, with **45 of 45** corners negative (the
  prior record's 44 of 45 plus `ff/3.630V/-40C`, whose *schematic* value is
  3.423 V — the design is out of regulation at that corner, so its former
  +1.635 V extracted reading was never a regulating control point). Median
  \|delta\| moved 385 % → 381.5 % on `vout_full_load_v`.
- **The reason is now measured, and it is the extractor, not the layout.**
  98–99 % of the modelled per-net R is the li1 (`metal0`) term; the metal
  levels this repo controls are under 1 % of it and went *up* when the rails
  were strapped onto a second level. Full per-level before/after table and the
  two upstream issues
  ([klayout-tools#2391](https://github.com/2AMLogic/klayout-tools/issues/2391),
  [#2458](https://github.com/2AMLogic/klayout-tools/issues/2458)) are in the
  2026-09-24/#154 update above.
- **Limits declared for the first time.** `vout_*_v` from the ratified
  `Output` row verbatim; `vin_minus_vout_full_load_v` from this request's own
  declared supplies minus that row (headroom, not dropout — see the update
  above and the request's `_limits_comment`).
- `body_bias`: `status=biased, unbiased_device_count=0, unbiased_nets=[]` —
  unchanged.
- Layout under test: `layout/ldo-core/reports/20260924-221912-a947aa8` (LVS
  `status: match`, 47/47 devices, 27/27 nets) on `20260924-221821-a947aa8`'s
  GDS (DRC `clean`, `violation_count=0`, with 75/20 still in
  `layers_in_stream_without_rules`). The wider rails and the added met3 level
  introduced no new width/spacing violation.

### Record `20260924-181248-50554fe` (`klt 0.6.0+g040f3406b485`) — superseded

First record cut against a layout that carries the `hvi` (75/20)
voltage-domain marker (issue #142), and the first in which the extracted-side
leg re-simulates the design's own transistors.

- `klt sim` (schematic-side leg, standalone): `status=pass, corners=45,
  passed=45, failed=0, errored=0`. The nine `timeout` errors the previous
  record's standalone leg carried did not recur — consistent with the
  "host-load-induced, not a model or deck failure" reading above (same 120 s
  `options.timeout_s` cap, unchanged).
- `klt pex` (schematic + extracted legs + delta): `status=pass, passed=135,
  failed=0, errored=0, pin_count_mismatch=None`, exit code `0`. Extraction:
  `deck=sky130, device_count=97, net_count=28`.
- **Flavour binding is correct for the first time.** All 92 MOS devices in
  `netlist-snapshots/20260924-181248-50554fe.pex.extract.spice` bind
  `sky130_fd_pr__nfet_g5v0d10v5` (18) / `sky130_fd_pr__pfet_g5v0d10v5` (74) —
  counted out of the netlist, not inferred. The prior record's 27 `ss`-corner
  `Pclm` aborts are gone.
- **`pass` here is ungraded — read the spread, not the verdict.** The request
  declares no limits on any measurement, so every `delta[]` row's `pass`
  means only that both legs produced a number. The record's own
  `delta[]`-spread table: `vout_light_load_v` median 1.9% / max 161%,
  `vout_full_load_v` median 385% / max 3543%,
  `vin_minus_vout_full_load_v` median 633% / max 4775%.
- **The full-load rows are non-physical, and the cause is this flow's power
  routing.** 44 of the 45 full-load corners return a negative extracted
  `VOUT` at 50 mA; the spread runs from +1.6 V (`ff/3.630V/-40C`, the one
  non-negative row) down to −61.9 V (`ss/3.300V/-40C`). The
  extracted `VOUT` net carries 102 Ω–64.3 kΩ of lumped star series resistance
  across its 51 terminals (`VIN`: 259 Ω–29.4 kΩ across 145), because
  `gen-ldo-blocks.py` draws every net — power rails included — as a 0.30 µm
  met1 trunk. Out of #142's scope (which was the device flavour); tracked as
  #154.
- `body_bias`: `status=biased, unbiased_device_count=0, unbiased_nets=[]` —
  unchanged from the prior record, so the
  [klayout-tools#1983](https://github.com/2AMLogic/klayout-tools/issues/1983)
  physically-wrong-resimulation hazard still does not bite for this layout.
- Layout under test: `layout/ldo-core/reports/20260924-181216-50554fe` (LVS
  `status: match`, 47/47 devices, 27/27 nets) on
  `20260924-181155-50554fe`'s GDS (DRC `clean`, `violation_count=0` with
  75/20 present in `layers_in_stream_without_rules` — the marker is drawn and
  is DRC-neutral, measured). Both were re-cut for this record against the
  DR-011-resized `M_PASS`/`M_SENSE` schematic, so the device count moved
  67 → 92 MOS.

### Record `20260923-183915-d9900b5` (`klt 0.6.0+g040f3406b485`) — superseded

- `klt sim` (schematic-side leg, standalone): `status=error, corners=45,
  passed=36, failed=0, errored=9`. All nine errors are `timeout` under the
  testbench's own 120 s `options.timeout_s` cap at cold/low-supply corners --
  host-load-induced, not a model or deck failure; the `klt pex` run's own
  schematic leg completed those same corners (see "On the standalone
  schematic-side leg's timeouts" above).
- `klt pex` (schematic + extracted legs + delta): `status=error, passed=108,
  failed=0, errored=27, pin_count_mismatch=None`. The 27 are 9 `ss` corners x
  3 measurements, all one root cause: the landed layout draws no `hvi` (75/20)
  markers, so every MOS binds the `*_01v8` core model at g5v0d10v5 geometries
  and the substituted model's binning fails ngspice's BSIM4 parameter check at
  `ss`. Drawing the marker is a repo-local layout task tracked in #142; the
  residual upstream friction (`klt extract --pdk` staying silent when a deck
  declares flavour markers the layout does not contain) is filed as
  [klayout-tools#2417](https://github.com/2AMLogic/klayout-tools/issues/2417).
- `body_bias`: `status=biased, unbiased_device_count=0` -- no device body sits
  on an anonymous deck-synthesized net, so the
  [klayout-tools#1983](https://github.com/2AMLogic/klayout-tools/issues/1983)
  physically-wrong-resimulation hazard does not bite for this layout as
  landed.
- All three previously-disclosed upstream gaps --
  [#1157](https://github.com/2AMLogic/klayout-tools/issues/1157),
  [#1159](https://github.com/2AMLogic/klayout-tools/issues/1159) and
  [#1369](https://github.com/2AMLogic/klayout-tools/issues/1369) -- are fixed
  upstream as of this record's `klt` pin (see the two "Update (2026-09-23,
  issue #122)" notes above). What bounds the extracted-side leg today is
  therefore repo-local (#142), not upstream.

## Why generic textbook-constant `.model` cards are not used here

An earlier iteration of this testbench (before switching to `--pdk`) used
`klt extract`'s bare generic device classes with hand-supplied `.model nfet
nmos level=1`/`.model pfet pmos level=1` cards, per `docs/cli/pex.md`'s own
worked example convention. Two findings from that iteration, kept here for
the record:

- All-default (`VTO=0`) `level=1` parameters produce a **non-physical**
  operating point for this specific feedback circuit (`VOUT` pinned at a
  multi-kV rail -- clearly a wrong-branch/non-convergent solution, not a
  real bias point).
- Adding generic order-of-magnitude enhancement-mode constants (`vto=0.7
  kp=120u lambda=0.01` n-type, `vto=-0.7 kp=40u lambda=0.01` p-type -- NOT
  sky130-specific values, ordinary textbook bulk-CMOS numbers) let the loop
  find a sane bias point (`VOUT` self-regulated to ~1.8V, matching
  `VREF`=1.2V through the `R_FB_A`/`R_FB_B`/`R_FB_C` divider's 3:2 ratio --
  a sanity check on the feedback topology, not a spec-comparable number
  either way).

That path was abandoned once the 3-terminal resistor incompatibility (above)
was found to block it regardless -- kept here only as a documented dead end,
not reused.

## xschem-version compatibility and failed-run retention (issue #277)

**Constraint.** xschem 3.4.4 (Ubuntu apt; CI and the dispatch workers) writes
the sky130 symbols' raw `expr('...')` geometry templates (`nrd=expr('0.29 / @W ')`
...) where the pinned 3.4.7 writes numbers. ngspice cannot parse them; the
failure surfaces as `Undefined parameter [...]` inside the PDK device
subcircuit. ngspice-46 reports a few `[expr]`/`[ad]` errors and then thousands
of `[swx_nrds]` errors, a PDK-internal `.param` on the same line as `nrd`; see
"Diagnosis (2026-10-11)" below.
`gen-pex-testbench.py` bypassed the normalization `sim/bin/corner-run.py` gained
in #288/#290. It now calls the same guarded helper (`sim/bin/xschem_exprs.py`,
shared by both) and **fails closed**: any `expr(` it cannot evaluate safely aborts
generation instead of emitting an unparseable DUT. No limit or device model is
changed.

*Measured:* injecting the 3.4.4 `expr` shape into this DUT reproduces an
ngspice "Undefined parameter" parse failure locally (ngspice 46); the committed
DUT is already numeric and simulates on one tt corner. *Not measured:* the
original batch-host deck/log was discarded, so that `[swx_nrds]` is the same
cause is consistent with, not proven by, this reproduction.

**Diagnosis (2026-10-11, `diagnostics/20261011-012020-1be508a-swx-nrds/`).**
Retained, one-corner evidence; see that directory's `provenance.txt` for tool
versions (xschem 3.4.4 and 3.4.7, ngspice-46, klt 0.7.0, open_pdks `c6d73a3`).

- *Measured:* `swx_nrds` is a PDK name, not one from this repo. It is defined on
  the instance `.param` line of the `sky130_fd_pr__{n,p}fet_g5v0d10v5` subckts
  (`swx_nrds = {89.1*nf/w+443.5}` / `{361*nf/w+1489}`) and consumed as
  `rsh = {swx_nrds}` by every binned model card. When an instance passes a raw
  `expr('...')`, ngspice's numparam rejects that whole `.param` line. So
  `swx_nrds` is never defined, and every model card that reads it reports
  `Undefined parameter [swx_nrds]`. On one device this gives 56 `[swx_nrds]`
  errors against 1 `[expr]`. On the real DUT at one corner (tt / 3.3 V / 27 C)
  it gives 2485 `[swx_nrds]`, 48 `[expr]` and 48 `[ad]`. The corner errors and
  every measurement "produced no value", which is the PR #275 symptom.
- *Measured:* the input is xschem 3.4.4. Netlisting the schematic with
  `/usr/bin/xschem` (3.4.4) gives 144 `expr(` lines; `/usr/local/bin/xschem`
  (3.4.7) gives 0. Both are present on the dispatch worker, so which one runs
  depends on `PATH`. The xschem step runs on the **client** (inside
  `gen-pex-testbench.py`), not on the batch runner. After normalization, the
  3.4.4 netlist is numerically identical to the 3.4.7 netlist (288
  substitutions, 0 unresolved). With 3.4.4 forced first on `PATH`, the current
  generator's DUT simulates cleanly at the same corner: 0 undefined-parameter
  errors, and the three measurements equal the 3.4.7 path's values. The test
  `sim/tests/test_pex_post_layout.py::Xschem344FixtureTests` pins this against
  the retained 3.4.4/3.4.7 netlists.
- *Hypothesis:* PR #275's run resolved xschem 3.4.4. That is the only mechanism
  found that reproduces the exact error class, but the run's own deck/log no
  longer exist.
- *Still unverified:* the standalone 45-corner leg. On 2026-10-11 a trivial
  2-corner batch probe still failed before any simulation ran
  (`batch_runner_version_mismatch`: runner klt 0.5.0 vs client 0.7.0, job
  `klt-sim-c9ff88880c3e`). That is the same infrastructure block as the
  2026-10-10 records below, and per host policy the grid was not run locally.

**Failed-run retention.** If `run-pex.sh` sees a hard failure (any `klt` exit
other than 0 or 3) or generator failure, it writes
`failures/<record-id>/` (append-only, never reused): request, testbench + DUT,
response/error envelope, full stderr logs, per-corner decks/ngspice logs, and
`provenance.txt` (git HEAD, GDS sha256, klt/ngspice/xschem versions, backend).

**Batch verification status (2026-10-10, record `20261010-193154-0c8ccf6`).**
The 45-corner schematic leg was re-attempted on `main` @ `0c8ccf6` and again
failed at batch submit for all 45 corners (`batch_job_failed`; fleet runner
klt 0.5.0 vs client 0.7.0, `runner_compatibility: mismatch`, job
`klt-sim-9bedf17191ac`, exit 87, ~4 s). No simulation ran, so this is not a
design or parse result; no local-grid fallback was used. Evidence is retained in
`failures/20261010-193154-0c8ccf6/`. The leg stays unverified until the fleet
runner image is updated (a worker-spec change, not a change in this repo). The
regeneration also showed the tracked `testbench/ldo_core_schematic_dut.spice`
is stale vs the current schematic (netlist snapshot
`netlist-snapshots/20261010-193154-0c8ccf6.schematic-dut.spice`); it was not
re-committed here. The record stamps `evidence_kind: "batch_submit_failure"`
and `supersedes: null`. It is not comparable to `20260924-230726-a947aa8`, which
stays the latest valid baseline. The characterization rollup and `run-pex.sh`'s
supersede pointer both skip records that carry a non-null `evidence_kind`.

**Handoff to #267 / PR #275.** After this lands, PR #275 rebases, reruns both
legs against its changed GDS, commits a new append-only record, and compares it
with `20260924-230726-a947aa8`, separating known baseline failures from new
regressions.

**PR #275 / #267 rerun (2026-10-16, record `20261016-030826-f604ae0`).** Both
legs were rerun through the batch flow (`KLT_SIM_BACKEND=batch`; no local grid)
against `LATEST-LVS` `20261010-074401-0eb9b4b`, whose GDS (sha256 `80f98681...`)
is the #267 geometry. Compared with baseline `20260924-230726-a947aa8`:

- **Schematic leg (`klt sim`): 41/45 pass, 4 fail** (baseline 38/45, 7 fail).
  Failing corners now: `fs/3.300V/125C`, `sf/2.970V/125C`, `ss/2.970V/27C`,
  `ss/3.300V/27C`. Baseline failures: `ff/3.630V/-40C`, `sf/3.300V/-40C`,
  `sf/3.630V/125C`, `ss/2.970V/-40C`, `ss/2.970V/27C`, `tt/3.300V/125C`,
  `tt/3.630V/27C`. This leg simulates the schematic DUT, not the layout, so
  the change comes from schematic/testbench drift on `main` since the baseline,
  not from #267's geometry. Only `ss/2.970V/27C` fails in both.
- **Extracted leg (`klt pex`): not obtained.** All 135 `delta[]` rows are
  `errored` (`unavailable_comparison`); `klt pex` exits 4. Cause: every one of
  the 45 batch units of the extracted leg failed on the runner with `model
  library not found: /home/ubuntu/.volare/sky130A/libs.tech/combined/sky130.lib.spice`
  (the submitting host's absolute `models.lib` path does not exist on the fleet).
  This is a tool gap tracked upstream as 2AMLogic/klayout-tools#3296, not a
  layout result. No extracted-side numbers exist, so **there is no regression
  comparison against the baseline's 39 pass / 96 fail extracted delta and #267's
  PEX acceptance criterion remains unmet.** No local-grid fallback was used.
  Diagnostics are retained in `failures/20261016-030826-f604ae0/`.
- The record is not a clean comparison baseline; the next rerun should be made
  once #3296 is resolved.

## Regenerating

```bash
sim/pex-post-layout/bin/run-pex.sh [--klt <path>]
```

Regenerates `testbench/ldo_core_schematic_dut.spice` +
`testbench/tb_pex_post_layout.spice` from the current schematic and the
landed layout (`layout/ldo-core/reports/LATEST-LVS`), then runs `klt pex`
against it and writes a new timestamped record under `records/`. Defaults to
the ambient `klt` on `PATH`; see "Note on the `klt` pin" below for why.

**Note on the `klt` pin.** Historically `layout/requirements.txt` pinned a
`klt` commit (`acb0ae6`) predating `klt pex`'s introduction --
`layout/.venv/bin/klt --version` reported `0.2.0` and its `<command>` list
had no `pex` verb -- so this experiment recorded its own, separate pin below
rather than reusing `layout/`'s.

**Update (2026-09-24, issue #142): the two pins have converged.**
`layout/requirements.txt` now pins `040f3406`, the same commit this
experiment's 2026-09-23 run already used, because the layout flow itself now
needs sky130 voltage-flavor support from that build (see that file's "Pin
history"). `layout/.venv/bin/klt` is therefore a valid `--klt` argument here
and is what the 2026-09-24 record below was run with -- which also means the
layout under test and the `klt pex` run against it are, for the first time,
the same `klt` build end to end. They are still *separately* pinned: nothing
forces them to stay equal, so a future bump on either side must re-check the
other rather than assume. `layout/` remains a read-only dependency of this
experiment.

**Note on `tb_pex_post_layout.request.json`'s `models`.** Uses the
PDK-relative shape `{"pdk": "sky130A", "lib": "libs.tech/combined/sky130.lib.spice"}`
(2AMLogic/klayout-tools#3296; issue #267 / PR #275). Records up to
`20261016-030826-f604ae0` used the literal `"$PDK_ROOT/sky130A/libs.tech/combined/sky130.lib.spice"`
shape (`models.lib` alone), which expands to the *submitting host's* absolute
path; the batch runner has no such path, so every extracted-leg unit failed with
`model library not found` (see `failures/20261016-030826-f604ae0/`). A 2-corner
batch probe of the PDK-relative form with the current `klt` (`klt pex ... --backend batch`)
produced real extracted-side numbers (no `unavailable_comparison` rows), so the
request now uses it. The model identity is unchanged: both forms resolve to the
same `combined/sky130.lib.spice` under the pinned `sky130A` PDK.

## `klt` pin used for the recorded runs

- `klt` commit: `a482d3934bd644b763cf925f6344ac05f54a1623` (2AMLogic/klayout-tools
  `main`, installed via `uv tool install git+https://github.com/2AMLogic/klayout-tools`),
  `klt --version` reports `0.2.0`.
- **2026-09-23 run (issue #122, record `20260923-183915-d9900b5`):** `klt`
  commit `040f3406b4858ac7a5b8faa8df5327fd62a65afa` (2AMLogic/klayout-tools
  `main`, 300 commits past `v0.5.0`), `klt --version` reports
  `0.6.0+g040f3406b485` (verified end-to-end: installing the pin reproduces
  the exact version string the run's own `provenance.klt_version` records).
  A git-commit pin rather than a release, because the #1157/#1159 fixes
  (`2dc66ece`) postdate `v0.5.0`, the latest release at recording time --
  the same move sky130-pll#46 already made. Install:
  `uv tool install "klayout-tools @ git+https://github.com/2AMLogic/klayout-tools@040f3406b4858ac7a5b8faa8df5327fd62a65afa"`.
  PDK pin unchanged.
- **2026-09-24 run (issue #142, record `20260924-181248-50554fe`):** same
  `klt` commit `040f3406b4858ac7a5b8faa8df5327fd62a65afa`, same reported
  version `0.6.0+g040f3406b485` (confirmed in the run's own
  `provenance.klt_version`). Not re-bumped — #142 needed no newer `klt`, it
  needed the *layout* to start using what this build already had. The
  difference from the 2026-09-23 run is therefore the drawn `hvi` marker and
  the DR-011 schematic resize, not the tool. Run with `--klt
  layout/.venv/bin/klt`, which `layout/requirements.txt` now pins to this
  same commit (see "Note on the `klt` pin" above). PDK pin unchanged.
- PDK: `sky130A`, `open_pdks c6d73a35f524070e85faff4a6a9eef49553ebc2b` (same
  pin as `sim/pdk.json`).

## Evidence discipline

Same convention as `sim/<slug>/records/`: a later run mints a new
timestamped record under `records/` rather than overwriting an earlier one.
