2AMLogic/sky130-ldo/sim/loop-gain/diagnostics/20261011-104648-c7772a4-mitigation-screen/README.md

# Issue #324 -- phase-margin mitigation screen (bleed + passive compensation), tt/ss/ff individual probes

Diagnostic evidence, not a characterization record: nothing here is a `sim/loop-gain/records/` entry, no
spec value or decision-record status is touched (DR-007 unchanged, DR-009 Iq target unchanged), and
`design/ldo_3v3in_1v8out.sch` is NOT modified. Candidates are netlist-level edits of the current
schematic's testbench netlist (see "Method"). Append-only: a re-run mints a new `runs/<run-id>/`.

Source commit `c7772a4` (`origin/main` at start of work; schematic hashes in each `result.json`).
All numbers below are regenerated by `python3 -I compare.py . > tables.md` from `runs/*/result.json`;
the full per-point tables (PM / GM / crossover for every run) are in [`tables.md`](tables.md).

## Method (reuses the repo harness)

- `mitigation_probe.py` imports `sim/bin/corner-run.py` for xschem netlisting
  (`sim/loop-gain/testbench/tb_loop_gain.sch` -> current `design/ldo_3v3in_1v8out.sch`), `build_deck`,
  PDK resolution and the solver-diagnostic detector. The analyses are `sim/loop-gain/experiment.json`'s
  seven-point deck VERBATIM (same `.nodeset` branch seed, same `op` + `ac` per point, same measurement
  expressions), plus `print`s of the seeded-`op` VOUT and VIN current. Exactly one `ngspice -b`
  per invocation, run sequentially; no grid, no parallelism; ~3 s per run. No `klt sim` batch
  submission was made (nothing here needed a grid; see handoff for the batch gate).
- Seven points per run: C_out 0.33 uF / 10 mOhm at 50, 1, 0 mA; C_out 4.7 uF / 10 mOhm at 50, 1, 0 mA;
  C_out 0.33 uF / 500 mOhm at 50 mA. (Two capacitance endpoints; ESR 10 mOhm plus the one 500 mOhm leg.)
- Edits (applied to the xschem-generated netlist text; raw and edited netlists both saved and hashed):
  `RBLEED VOUT 0 (1.8 V / I)` for the bleed, `C_COMP` value, `XR_CZ` length (W fixed). R_CZ scaling was
  checked against the model (`rcz_resistance/`): L=26/52/104 um -> 150.2k / 300.6k / 601.3k ohm at tt/27C,
  i.e. 0.4998x / 1x / 2.0006x.
- Iq = VIN current (-i(VVIN) of the seeded `op`) minus external load current (VOUT / R_LOAD).
  The bleed resistor is internal, so it stays IN Iq. Cross-check against the `sim/iq` method
  (cold-start settled 200 ms transient, its own `experiment.json` deck, same netlist): Iq 13.871 uA /
  27.61 uA (transient) vs 13.871 uA / 27.604 uA (op method) at tt/27C/3.30V -- agree (run
  `iqxcheck2_*`). `iqxcheck_*` is the first attempt: the ngspice results are identical but the driver's own
  validity key names were wrong (reported `valid=False`); it is kept (append-only) and superseded by `iqxcheck2_*`.
- Validity rules (`classify()` in the driver; unit-tested in `sim/tests/test_mitigation_probe.py`): a point is
  INVALID, never PASS, if the operating point is non-regulating (VOUT outside 1.7-1.9 V), the unity-gain
  crossing, the phase at crossing or the -180 deg crossing (GM) is missing, or the run raised an ngspice
  solver diagnostic (`singular matrix`, `gmin stepping failed`, `out of range for ^`).
- Provenance in every `result.json`: source commit, SHA-256 of driver / experiment.json / testbench / DUT /
  raw and edited netlist / deck / spiceinit, PDK pin match, ngspice 42 and xschem 3.4.4 (both match the
  `sim/pdk.json` tool pins), ngspice exit code and elapsed time. Complete stimulus = `runs/*/deck.spice`;
  solver output = `runs/*/ngspice.log`.
- Disclosure: the driver was edited twice before the runs that are kept (a `dcg` print added to every
  point; the iq-bench key names fixed). The first three baseline runs were discarded UNCOMMITTED and re-run
  after the `dcg` change (their PM/GM were identical). `driver_sha256` differs between `base_tt_*` (and the
  other early loop-gain runs) and the `repro_*` runs solely because of the later iq-bench-only fix; the
  loop-gain code path is unchanged and `repro_*` reproduce `base_tt` / `rcz0p5_tt` bit-for-bit on every
  PM, GM, crossover, VOUT and Iq value with identical deck and netlist hashes.
- Lint-only edit (review fix, PR #344): `_kind` rename at line 100 to satisfy ruff F841 changes the driver SHA-256 to `71d58d8aa70e65bb63c0d556cf6a77314104aab54b8f5d652dfb9dc9410498b2`; the loop-gain code path is unchanged and no run was repeated, so all recorded `result.json` driver hashes (earlier driver) are left as-is.

## Sampled coverage (what was and was not run)

Run: tt/27C/3.30V (everything), ss/-40C/2.97V and ff/125C/3.63V (baseline + two variants). 16 loop-gain
decks + 2 repro decks + 2 iq transients (one superseded). NOT run: sf, fs, other temperatures and
supplies (the other 42 of the 45 PVT points), any ESR other than 10 mOhm (500 mOhm only at 0.33 uF / 50 mA),
any C_out other than the two endpoints, 1/0 mA at 500 mOhm, Monte Carlo. Nothing is extrapolated to unrun
conditions. No invalid probe occurred: all 20 loop-gain/iq runs exited 0 with no solver diagnostic, and
every point has a regulating operating point (VOUT 1.7987-1.8104 V; the 1.8104 V at ff/125C/0 mA is the
finite-DC-gain regulating branch, loop gain 41 dB there, not a pass-device-full-on state) and both
crossings. The only invalid *record* is the superseded `iqxcheck_*` driver flag described above.
The historical record's other-worst-corner question is not resolved by this PR: the three conditions are
the issue's named ones; the three sampled conditions showed different worst points (below), which is itself
evidence that three probes cannot select a single worst corner.

## 1. Current baseline (no edits) -- PM deg (GM dB), PASS iff PM >= 45 and GM >= 10

| point | tt/27C/3.30V | ss/-40C/2.97V | ff/125C/3.63V |
|---|---|---|---|
| 0.33 uF / 10 m / 50 mA | 40.5 (17.5) FAIL | 38.3 (17.2) FAIL | 44.5 (18.2) FAIL |
| 0.33 uF / 10 m / 1 mA | 82.6 (28.2) | 80.3 (27.5) | 85.8 (29.5) |
| 0.33 uF / 10 m / 0 mA | 19.7 (68.6) FAIL | 15.5 (68.0) FAIL | 89.1 (71.6) |
| 4.7 uF / 10 m / 50 mA | 83.3 (30.2) | 81.6 (29.9) | 86.0 (30.8) |
| 4.7 uF / 10 m / 1 mA | 51.9 (42.0) | 55.4 (41.2) | 47.3 (43.4) marginal |
| 4.7 uF / 10 m / 0 mA | 53.1 (72.4) | 38.1 (73.2) FAIL | 90.4 (76.3) |
| 0.33 uF / 500 m / 50 mA | 52.6 (27.4) | 51.1 (27.6) | 55.8 (27.4) |

Findings, separated by load: (a) the **50 mA / 0.33 uF / 10 mOhm** point fails at all three sampled
conditions (38-44.5 deg), so the gap is not exclusively 0 mA; the same C_out passes at 500 mOhm ESR.
(b) **0 mA** fails at 0.33 uF at tt and ss (15-20 deg, GM 68 dB: a low-frequency dip with a ~300 Hz
crossover, not a near-oscillation) and at 4.7 uF at ss (38 deg); it passes at ff/125C (crossover only 2-34 Hz,
loop gain ~41 dB at DC). (c) **1 mA** passes at every sampled condition; the 4.7 uF point is the thinnest
(47.3 deg at ff/125C). The spec narrative "all loads >= 1 mA are stable" is therefore not contradicted at 1 mA
here, but it does not cover 50 mA.
**Iq baseline (a finding, independent of any candidate):** 13.87 / 27.60 uA at 0 / 50 mA (tt),
11.82 / 23.92 uA (ss), 15.38 / **30.68 uA (ff/125C/3.63V, over the 30 uA target at 50 mA)**. Iq grows with
load current (about +13.7 uA at 50 mA vs 0 mA at tt; cause not extracted here), so the headroom is: tt 2.40 uA, ss 6.08 uA, ff/125C none (-0.68 uA) at 50 mA;
at 0 mA the headroom is 16.1 / 18.2 / 14.6 uA.

## 2. Bleed screen (tt/27C/3.30V; equivalent current at VOUT = 1.8 V)

| bleed | Iq 0 mA (d) | Iq 50 mA (d) | budget (<30 uA, tt) | 0.33uF/0mA PM | 4.7uF/0mA PM | other points |
|---|---|---|---|---|---|---|
| 0 (baseline) | 13.87 | 27.60 | ok | 19.7 | 53.1 | -- |
| 1 uA | 14.87 (+1.00) | 28.60 (+1.00) | ok (1.4 uA left) | 17.4 FAIL | 34.4 FAIL | no change (50/1 mA PM within 0.1 deg) |
| 3 uA | 16.88 (+3.01) | **30.60 (+3.00)** | REJECTED: 50 mA over budget | 19.2 FAIL | 24.7 FAIL | no change |
| 10 uA | 23.89 (+10.02) | **37.60 (+10.00)** | REJECTED: 50 mA over budget | 26.5 FAIL | 18.2 FAIL | no change |
| 100 uA (diagnostic only, outside the bound) | 114.0 | 127.6 | REJECTED (not a candidate) | 62.5 PASS | 22.4 FAIL | no change |

Rejections are by measured baseline plus cost (27.60 + 3 > 30) and the 3/10 uA runs were still performed
and recorded so that rejected options stay visible. No in-budget bleed improves any failing point; the
1 uA bleed makes both 0 mA points worse. The 100 uA row is a mechanism probe only (it is ~7x the 0 mA
Iq and far over budget).

## 3. Passive compensation screen (tt/27C/3.30V, one factor at a time)

PM deg at each point (GM and crossover in `tables.md`; no Iq change -- passives carry no DC current,
Iq identical to baseline to 0.001 uA):

| variant | 0.33u/50m | 0.33u/1m | 0.33u/0m | 4.7u/50m | 4.7u/1m | 4.7u/0m | 0.33u/500m/50m |
|---|---|---|---|---|---|---|---|
| baseline | 40.5 F | 82.6 | 19.7 F | 83.3 | 51.9 | 53.1 | 52.6 |
| C_COMP x0.5 (75 pF) | 40.6 F | 76.7 | 24.1 F | 75.7 | 37.7 F | 65.9 | 52.7 |
| C_COMP x2 (300 pF) | 40.4 F | 85.4 | 17.3 F | 86.9 | 67.9 | 40.7 F | 52.6 |
| R_CZ x0.5 (150 k) | 79.0 | 90.1 | 17.5 F | 87.8 | 33.9 F | 52.9 | 91.1 |
| R_CZ x2 (601 k) | 23.7 F | 53.3 | 23.8 F | 54.5 | 72.1 | 53.6 | 35.0 F |
| R_CZ x0.5 + C_COMP x2 (follow-up) | 79.0 | 102.9 | 14.2 F | 103.1 | 46.6 | 40.2 F | 91.5 |

(F = fails PM >= 45; GM >= 10 dB held at every valid point.) The 50 mA / 0.33 uF crossover (~178 kHz)
does not move with C_COMP (x0.5 to x2) yet moves with R_CZ, while the PM there moves strongly with R_CZ
(23.7 / 40.5 / 79.0 deg at x2 / x1 / x0.5). R_CZ trades the heavy-load points against the
4.7 uF / 1 mA point (33.9 at x0.5 vs 72.1 at x2); C_COMP x2 recovers part of that. No one-factor setting
touches the 0 mA failures (best: 24.1 deg).

## 4. Paired variant comparison (at most two): V1 = R_CZ x0.5, V2 = R_CZ x0.5 + C_COMP x2

Selected from section 3 as the best 50 mA fix (V1) and the fix plus a C_COMP compensation of V1's 1 mA
regression (V2; keeps the R_CZ*C_COMP zero constant while doubling C). Each ran at tt, ss and ff against the
paired baseline from the same session (full PM/GM/fc deltas in `tables.md`). Iq delta is 0.000 uA at 0 and 50
mA at all three conditions (absolute values in section 1). PM deg, baseline -> V1 -> V2:

| point | tt | ss | ff |
|---|---|---|---|
| 0.33u/50m | 40.5 -> 79.0 -> 79.0 | 38.3 -> 74.4 -> 74.4 | 44.5 -> 88.0 -> 88.2 |
| 0.33u/1m | 82.6 -> 90.1 -> 102.9 | 80.3 -> 92.5 -> 103.5 | 85.8 -> 86.4 -> 102.0 |
| 0.33u/0m | 19.7 -> 17.5 -> 14.2 | 15.5 -> 13.0 -> 11.3 | 89.1 -> 89.1 -> 87.8 |
| 4.7u/50m | 83.3 -> 87.8 -> 103.1 | 81.6 -> 89.2 -> 103.4 | 86.0 -> 86.4 -> 103.4 |
| 4.7u/1m | 51.9 -> **33.9** -> 46.6 | 55.4 -> **36.4** -> 50.0 | 47.3 -> **31.2** -> **42.6** |
| 4.7u/0m | 53.1 -> 52.9 -> **40.2** | 38.1 -> 37.6 -> **27.9** | 90.4 -> 90.4 -> 90.3 |
| 0.33u/500m/50m | 52.6 -> 91.1 -> 91.5 | 51.1 -> 87.6 -> 87.8 | 55.8 -> 98.7 -> 99.2 |

Neither variant meets the Stability row at all sampled conditions: both leave 0.33 uF / 0 mA failing at tt
and ss (14.2 and 11.3 deg for V2); V1 additionally fails 4.7 uF / 1 mA at all three; V2 fails 4.7 uF / 0 mA
at tt and ss and 4.7 uF / 1 mA at ff. Iq: both are Iq-neutral; the baseline's own ff/125C 50 mA Iq
(30.68 uA) already exceeds 30 uA, so no screened candidate "meets both targets" at that condition.
At the sampled conditions V2 does repair every 50 mA point (including the ESR-500 mOhm one) with ample GM
(>= 20.2 dB) at zero Iq cost; that is the part of the evidence that a passive change CAN address.

## 5. Recommendation: what the evidence supports and refutes

- **Refuted (within the sampled conditions): a fixed internal bleed within the Iq budget as the 0 mA fix.**
  1 uA is the only bleed that fits the tt/50 mA headroom (2.4 uA) and it lowers both 0 mA margins; 3 and 10 uA
  are over budget (and also do not help); at ff/125C there is no 50 mA headroom at all.
- **Partially supported, not within budget: a load-dependent low-frequency pole/doublet at 0 mA.**
  Raising the minimum current moves the 0.33 uF / 0 mA crossover up (283 Hz -> 4.5 kHz at 100 uA) and recovers
  PM only at that cost (62.5 deg at ~100 uA, ~7x the 0 mA Iq), while the 4.7 uF / 0 mA point does not recover
  (22 deg) and dips non-monotonically with bleed (53 -> 34 -> 25 -> 18 -> 22). The PM dip is non-monotonic in
  both bleed and C_COMP, consistent with the crossover landing inside a pole-zero doublet; it is not shown
  here to be a single load-dependent pole (no pole/zero extraction was run).
- **Supported: the 50 mA / 0.33 uF failure is governed by the R_CZ zero/Miller network** (PM follows R_CZ,
  is insensitive to C_COMP and to bleed), and a passive change fixes it at zero Iq cost at all three
  sampled conditions. It is NOT the same mechanism as the 0 mA failure.
- **No screened candidate meets both targets at the sampled conditions.** The 0 mA failures (and, for V1/V2,
  a 4.7 uF / 1 mA regression) remain. "Meets both targets" is also false for the unmodified ff/125C 50 mA Iq.
- **Load-adaptive compensation hypothesis (for a later design issue; not built here).** The data say the
  best R_CZ differs by load: ~0.5x at heavy load (>= ~10 mA) for the 0.33 uF point, ~1x-2x at <= 1 mA for
  4.7 uF. Hypothesis: make R_CZ load-adaptive by splitting it, R_CZ = R_a + (R_b || triode PMOS switch) with
  R_a ~ 0.5x and R_b ~ 0.5x of today's 300 k (so R_CZ_eff between 150 k and 300 k), the switch gate driven
  from the existing sense-mirror current (assumed to scale with load; not verified here, so any light-load Iq adder must be measured)
  with a threshold bounded to 1-10 mA of load. Bounded parameters to explore: R_a/R_b split 0.4-0.6x, threshold
  1-10 mA, switch Iq adder <= 0.5 uA at 0 mA. This addresses 50 mA and 1 mA only; the 0 mA doublet needs a
  separate light-load lever (suggested first look: a two-parameter C_COMP x R_CZ scan below 1 mA, and the
  error-amp tail current, neither screened here). Not developed further, per the issue.

## 6. Qualification handoff (nothing here certifies the window)

A follow-up qualification issue must: carry the selected variant (V2 is the best 50 mA / 1 mA repair
but regresses 4.7 uF at 0 mA and does not fix 0.33 uF at 0 mA, so a selection is a design decision still
open) and reproduce, through the batch backend, the FULL 45-point matrix
({tt,ss,ff,sf,fs} x {-40,27,125 C} x {2.97,3.30,3.63 V}) for BOTH baseline and candidate, including
no-load and full-load Iq (the ff/125C 50 mA Iq finding above needs its own look against DR-009).
Gates and coordination:
- **#327**: the batch runner/client incompatibility gates any fleet claim; #327's closure alone is not
  sufficient (it owns a PEX campaign) -- verify a compatible `klt sim` batch run of the loop-gain and iq
  experiments before qualifying. This PR made no batch submission, hence no batch failure to report.
- **#338**: expanded AC boundary/ESR/load coverage. The seven legs here (and three individual PVT probes)
  do not cover the continuous ESR/load window; the qualification deck should use #338's expanded deck.
- **#323**: 50 mA operating-point validity -- every 50 mA point here regulates (VOUT 1.7987-1.7988 V) with no
  solver diagnostic, but only at three conditions.
- DR-007 stays open; this evidence feeds that decision but changes no spec row or DR status.

## Files

- `mitigation_probe.py` (driver), `compare.py` (tables), `tables.md` (all tables), `rcz_resistance/` (R_CZ scale
  check), `runs/<run-id>/{result.json,deck.spice,netlist.raw.spice,netlist.edited.spice,ngspice.log,.spiceinit}`.
- Run ids: `base_*`, `bleed{1,3,10}uA_tt_*`, `diagbleed100uA_tt_*`, `ccomp{0p5,2}_tt_*`, `rcz{0p5,2}_tt_*`,
  `combo_rcz0p5_ccomp2_{tt,ss,ff}_*`, `rcz0p5_{ss,ff}_*`, `repro_{base,rcz0p5}_tt_*`, `iqxcheck{,2}_base_tt_*`.
- Reproduce one run: `python3 -I mitigation_probe.py --outdir <new-dir> --run-id X --process tt --temp 27 --supply 3.3 [--bleed-ua U] [--ccomp-scale S] [--rcz-scale S]`
  (host policy: one invocation at a time).
- Tool friction: none requiring a klayout-tools issue (this work used only the in-repo harness, xschem and ngspice).
