2AMLogic/sky130-ldo/design/investigation-log.md

# Design investigation log (archived from `design/README.md`)

This file is the dated, issue-by-issue investigation history that used to live
in `design/README.md` under "Known gaps / follow-on scope". It was moved here
**verbatim** (issue #332) so the schematic README reads as a description of the
circuit, not a lab notebook. Nothing was pruned or reconciled: entries are
dated, several supersede earlier ones, and a stale paragraph here must not be
read as current.

For current status use, in order: `spec/target-spec.md` (RATIFIED, issue #1 /
DR-006) and the decision records under `spec/decision-records/`; the per-row
verdicts in `measurements/characterization.md`; the append-only records under
`sim/`. References in the text below to "this file", "above", or "below"
mean this log (or the circuit description in `design/README.md`), as of the
time each entry was written.

Outcomes of #72 and #92 are not recorded in a DR or `sim/` record; short
summaries: **#72** (PR) root-caused each FAIL row of the first full 45-point
campaign into the numbered mechanisms 1-6 written up in the first section
below; no circuit change. **#92** root-caused the thermal-shutdown hysteresis
as a marginal regenerative loop gain (see the "#77" section of this log, which covers the same
screening), nothing shipped, and was superseded by #91's
post-#69/#90 re-screen and then #95's measured `sim/thermal` record.

## Known gaps / follow-on scope

Closed by issue #22 and now in this schematic: **current limit** and
**soft-start** (both spec rows above), plus the pass-device width correction
and the reference-common-mode change those two required. Closed by issue #29:
**thermal shutdown** (CTAT sense + trip comparator, per DR-005), reusing the
same shutdown path.

Closed by issue #25: the **error-amplifier output-swing ceiling** (the
current-mirror OTA) and the **compensation placeholder** (`C_COMP`/`R_CZ`,
sized against `sim/loop-gain` over DR-002's proposed window).

Still deliberately **not** in this schematic:

- **`C_CL` is still a placeholder.** The current-limit comparator's dominant
  pole (`CL_CMP -> VIN`, `1p`) was not sized against a loop-gain sim; only
  the main loop's `C_COMP`/`R_CZ` were. The limit loop's screened behaviour
  (flat into a hard short, 1.4µA pp) is a smoke test, not a phase-margin
  claim.
- **Corner coverage.** The full 45-point PVT matrix and Monte Carlo campaign
  (#19/#37/#40) has since run against this schematic — see
  [`measurements/characterization.md`](../measurements/characterization.md)
  for the aggregated per-row verdict, and the dated "full 45-point PVT +
  Monte Carlo campaign" section below for the root-cause writeup (#60) and
  the follow-on issues (#69/#70/#71) tracking the open work to close these
  gaps. Thermal now has its own dedicated testbench (`sim/thermal`, #66) —
  see the dated "Thermal-shutdown trip/hysteresis testbench" section below
  for what it found.
- **An actual on-chip voltage reference.** `VREF` is an external port (see
  "VREF interface caveat" above).

These are real, trackable gaps, not silently dropped requirements.

### The full 45-point PVT + Monte Carlo campaign has run, and it fails every ratified row it substantiates (#19/#37/#40 ran it; #60 root-caused the results, 2026-08-25)

**Status update, superseding every "#19's job" / "3-corner `--quick` subset"
line elsewhere in this file.** Issues #19/#37/#40 closed having actually run
the full 45-point PVT matrix (`tt`/`ss`/`ff`/`sf`/`fs` × {−40, 27, 125}°C ×
{2.97, 3.30, 3.63}V) against `dropout-vs-load`, `load-transient`, `psrr-dc`
and `loop-gain`, plus a 200-sample Monte Carlo mismatch run against
`mc-output-accuracy` — all cited below are the freshest records in the repo
as of this section. Every one of them is **FAIL**. Issue #60 root-caused each
row against the actual schematic (screening decks reproducing the closed-loop
DC/AC behaviour the corner runner exercises — single corner, not `sim/`
evidence, same convention as every other screening deck in this file). This
section states what was actually found, in place of the stale "future work"
framing the rest of this file otherwise still carries from before #19/#37/#40
ran.

> **Mechanism 1 below is CLOSED as of 2026-08-25 (issue #69). Its numbers
> are kept because they are the diagnosis, but every record id quoted inside
> it is now superseded.** The thermal-shutdown circuit was re-sized (see
> "Sizing the trip: what is a knob and what is not" above) and all four
> affected campaigns were re-run against the fixed schematic. Jump to
> "What the #69 re-run changed" at the end of this section for the
> before/after table. Mechanisms 2–6 are unchanged and still open.

**Two distinct failure mechanisms were identified, plus one independent,
previously-undesigned-for gap (PSRR):**

1. **A previously-unconfirmed false-trip of thermal shutdown (#29/DR-005) at
   the `ff`/`sf` process corners at 125°C — the top of this repo's own rated
   operating range, not a fault condition.** DR-005's own Decision explicitly
   requires the 150°C nominal trip to sit a "25°C guard band above the spec's
   own `Tj ≤ 125°C` operating ceiling" specifically so the block "must not
   engage during legitimate rated operation at the 125°C ceiling, or it would
   nuisance-trip." A single-point `.op` screening check (this issue, `ff`
   process corner, 125°C, `VIN=3.30V`, `I_LOAD=50mA` — reproduced from the
   committed schematic's own netlist, not `sim/` evidence) shows exactly that
   nuisance trip happening: `TS_SNS=1.0097V` has already fallen *below*
   `TS_REF=1.0451V` (the tripped ordering), `TS_CMP=0.385V` (fully tripped,
   versus ≈`VIN` untripped), and `EA_OUT=3.298V` ≈ `VIN` — the thermal clamp
   `M_TSHUT` has pulled the pass gate fully off. The same check at `tt`/125°C
   (same bias/load) shows the correct untripped ordering
   (`TS_SNS=1.1026V > TS_REF=1.0310V`, `TS_CMP=3.279V` ≈ `VIN`). Both `ff` and
   `sf` (the two corners sharing a **fast PMOS** skew) show this at 125°C;
   `ss`, `fs` and `tt` do not trip on *this* mechanism (see the #71/#81
   correction below re: `tt`/125°C's pre-existing non-physical
   `dropout-vs-load` number, which is a *different* mechanism) — implicating
   the PMOS-biased CTAT sense/
   reference stack's (`M_TSPS`/`M_TSPR`, both PMOS current sources gated by
   `BIASP`) sensitivity to PMOS process skew as the mechanism, consistent
   with DR-005's own accepted "untrimmed, bias-generator-derived, PVT-loose"
   accuracy cost — but this is the specific, previously-unconfirmed *direction*
   of that looseness (trips early, inside the rated range) rather than late
   (which would only cost margin above 125°C, not correctness at it).
   **This single mechanism is the direct cause of every physically-impossible
   number in the `dropout-vs-load`, `load-transient` and `loop-gain` records
   at the six `ff`/`sf`-at-125°C corners** — e.g. `dropout-vs-load`'s
   `ff_125c_3.30v: vout_at_max_vin_v=-19.2011V`, `sf_125c_*: dropout_v=32.5871V`;
   `load-transient`'s `ff_125c_2.97v: undershoot_v=22.2895V`,
   `sf_125c_*: undershoot_v≈14.37V`; `loop-gain`'s `ff_125c_*`/`sf_125c_*:
   dcgain_c033_50ma_db≈-330dB` with most other measurements `n/a`. With the
   pass gate driven fully off by a falsely-tripped thermal clamp, a
   50mA-sinking ideal current-source load (the testbenches' own load model)
   has no physically consistent DC/transient solution near the target
   operating point, so the solver reports whatever extreme, non-physical
   value it converges to instead (confirmed reproducible: a screening `.op`
   at the exact same bias point returns `VOUT=-19.5043V`, matching the
   committed record's `-19.2011V` to within re-run/precision noise). **Read
   those specific numbers as "the pass device was driven off and the demanded
   50mA had nowhere physical to come from," not as literal voltages** — but
   the underlying finding (thermal shutdown nuisance-trips inside the rated
   temperature range at two of five process corners) is a real, actionable
   functional defect, not a reporting artifact.
2. **A genuine, now-fully-confirmed light-load stability shortfall,
   pervasive rather than confined to the 3-corner subset.** `sim/loop-gain`'s
   full 45-point run passes only 3/45 corners (versus the 3-corner quick
   subset's already-known 0mA shortfall at 2 of 3 corners). The `pm_c033_0ma`
   column is below the 45° ratified Stability row at nearly every corner
   outside 125°C (typically 15–24° at −40/27°C, improving toward 30–90° as
   temperature rises), confirming the mechanism this file already named under
   "Compensation (sized in #25)" — the pass stage's own
   `gm_pass/(2π·C_out)` pole falling with load current, unclosable without
   spending amplifier bias current the `Iq < 30µA` row (set by DR-009,
   `proposed`) does not have room for — generalizes across the full corner
   grid rather than being a
   quirk of the 3 quick-subset corners. The same marginal-margin/doublet-dip
   condition is the most likely driver of `mc-output-accuracy`'s 19/200 tail
   outliers (see below) and of the *non-pathological* (i.e. not
   thermal-shutdown-related) FAILs in `load-transient` and `dropout-vs-load`
   at `tt`/`ss`/`fs` corners.
3. **`dropout-vs-load`: a real, if smaller than initially apparent, dropout
   shortfall, distinct from (1) and (2) above at the non-`ff`/`sf`-125°C
   corners.** The `dropout_v` measurement reads `v(vin)-v(vout)` at the
   sweep's lowest point (`Vin=1.9V`, only 100mV above the 1.8V target) —
   deep inside the region where 50mA load has already forced the loop out of
   regulation, so the reported number is the pass device's residual
   `V_sd` well past dropout, not the classic "headroom at which regulation is
   just lost" definition. A screening re-sweep of the actual closed loop
   (`tt`/27°C, 50mA, `Vin` 1.9→2.5V, reproducible from the committed netlist)
   shows `Vout` climbing smoothly from 1.37V at `Vin=1.9V` to 1.79V by
   `Vin≈2.20–2.35V` — i.e. the closed loop's own actual dropout headroom is
   roughly **400–450mV**, worse than DR-003's pass-device-alone screening
   (98mA available at `V_sd=0.3V`, implying ~150mV for 50mA) because that
   screening forced full gate drive externally, while the closed loop's own
   amplifier — whose bias/tail chain also loses headroom as `Vin` approaches
   `Vout` — cannot quite reach full drive at this margin. 400–450mV is still
   above the ratified 300mV target, a real (if smaller than the raw 530mV–1.79V
   the record reports) gap. **Superseded by #71's fix** — see "#71 resolved"
   below for the confirmed, `sim/`-evidentiary number (0.310V–0.554V at
   −40°C/27°C across all five process corners) that replaces this screening
   estimate.
4. **The same sweep also surfaces a second, independent problem: the
   closed-loop DC operating point is not unique in parts of this region.**
   Sweeping `Vin` continuously from 1.9V to 3.63V at `tt`/27°C/50mA (screening,
   not `sim/` evidence) does not track a single monotonic branch — it jumps
   between a regulating branch (`Vout≈1.80V`) and a non-regulating one
   (`Vout` tracking well above target, e.g. 2.26–2.54V) several times before
   settling, with `ngspice` reporting `singular matrix` warnings at nodes
   `ea_cz`/`n_fbb`/`amp_enn` and, on a wider sweep starting below 1.8V,
   domain-error convergence failures in the `R_CZ` compensation resistor's
   body-junction model at nearly every swept point. This means the
   `dropout-vs-load` and `load-transient` records' per-corner numbers at
   several `tt`/`ss`/`fs` corners (not just the `ff`/`sf`-125°C corners
   mechanism (1) explains) should be read as "one of several DC solutions
   the solver's continuation history happened to land on," not as the unique
   physical answer — a genuine circuit robustness question (does a real,
   fabricated device actually exhibit multiple stable operating points in
   this region, or is this purely a simulator-continuation artifact?) that
   this issue's screening time did not resolve. **Diagnosed by #71/#81** —
   see "#71/#81 resolved" below: a genuine second stable equilibrium, worse
   at 125°C, root-caused but not yet fixed (deferred to #79).
5. **PSRR: a real, systematic, previously-undesigned-for shortfall, not a
   symptom of (1)/(2)/(4).** `sim/psrr-dc` fails 39/45 corners at 1kHz by a
   wide, consistent margin (measured 20.3–25.7dB against the 50dB ratified
   target — a real, non-pathological small-signal result, not a
   non-physical one); the 6 corners that pass (`ff`/`sf` at 125°C) are
   exactly the corners mechanism (1) shows are thermal-shutdown-tripped, so
   those "PASS" numbers (76–105dB) are AC gain measured around a collapsed,
   non-regulating bias point and should not be read as genuine PSRR either —
   **on the evidence available, PSRR does not actually pass anywhere.** The
   likely mechanism: this block's bias generator (`R_BIAS`/`M_BIASN1`/
   `M_BIASN2`/`M_BIASP1`, unchanged since #14) has no supply-independent
   reference or cascode — every PMOS current source in the amplifier,
   current limit, soft-start and thermal-shutdown chains inherits `VIN`
   ripple directly through `BIASP`. The current-mirror OTA's own pull-up path
   (`M_MIRP1`/`M_MIRP2`, both sourced from `VIN`) compounds this: unlike the
   NMOS pull-down side (returned through the fixed `AMP_ENN` rail), the
   pull-up mirror's reference is itself referred to `VIN`, so it does not
   independently attenuate `VIN` ripple the way a supply-independent-biased
   stage would. This was never a design target for #14/#22/#25's bias
   generator — this file already states it "remains a functional starting
   point rather than a budgeted design" — so this is a newly-confirmed,
   previously-out-of-scope gap, not a regression.
6. **`mc-output-accuracy`: the aggregate sigma-window FAIL is a tail-outlier
   artifact of (2)/(4) above, not evidence that mismatch itself is too
   large.** 181/200 samples individually pass the ±2% window; the aggregate
   `FAIL` comes from 19/200 tail samples, one of which reads `vout_ss=
   -19.345V` — a device-mismatch draw pushing an already-marginal light-load
   operating point (mechanism (2)) into the same kind of non-regulating
   branch mechanism (4) describes, at the record's own 1mA/`tt`/27°C/`VIN=
   3.3V` point (a condition that regulates cleanly with zero mismatch, per
   the "DC operating grid" table above). Fixing mechanisms (2)/(4) is very
   likely to close most or all of this row without any change to the
   mismatch model itself.

**What this means for the ratified spec rows.** None of Output, Dropout,
Load-transient, PSRR or Stability can be marked closed. None of the five
findings above is closable by a small, low-risk sizing tweak validated
against a single corner — each requires a design change (bias-generator
redesign for PSRR/supply-independence, a re-tuned/re-verified thermal-
shutdown sizing for the false-trip, and a compensation/bias-current rework
for the light-load margin that fits inside the `Iq` budget (set by DR-009,
`proposed`)) followed by
a full, expensive 45-point-per-testbench re-verification pass to confirm it
without regressing a different row — exactly the risk this issue's own
Curator enhancement flagged ("a wrong root cause or a fix that regresses a
different row could pass a shallow review unnoticed"). That work is
decomposed into follow-on issues rather than attempted speculatively in this
pass:

- **#69** — thermal-shutdown false-trip at `ff`/`sf`/125°C (mechanism 1).
- **#70** — PSRR (mechanism 5) and the pervasive light-load stability
  shortfall (mechanism 2), bundled together since both plausibly share a
  bias-generator-redesign fix and both compete for the same `Iq` budget.
  **Resolved (spec recommendation) 2026-09-14** — see "DR-007 recommends
  superseding the ratified PSRR/Stability rows" below; both candidate routes
  within the single-stage topology proved verified-negative (via #79), and
  a topology-class fix is spun off into **#107**.
- **#71** — the `dropout-vs-load` testbench's `dropout_v` measurement
  methodology (mechanism 3) and the DC-solution-multiplicity question
  (mechanism 4). **Resolved 2026-08-25** — see "#71/#81 resolved" below;
  spun off **#81** for the 125°C-wide convergence-fragility finding it
  surfaced.
- **#81** — root-caused mechanism 4's 125°C-wide severity: a genuine
  circuit robustness gap (a second, stable, non-regulating equilibrium the
  loop's own dynamics prefer at 125°C/50mA), not a solver-tuning problem.
  **Resolved (diagnosis) 2026-08-25** — see "#71/#81 resolved" below; the
  actual fix is deferred to **#79** (same bias-generator/compensation
  headroom bucket as mechanism 2). **Caveated by #164 (2026-09-25)**: #81's
  *item 1* (an unconverged `.op` producing `FB` hundreds of volts off a
  passive divider) is now measured and fully explained at 27 °C/1 mA — see
  "#164" below — and #81's *item 2* used a `tran … uic` whose `.ic`
  constrained only `v(vout)`, leaving every other node to the same
  unconstrained solve. Item 2 is therefore **unverified rather than
  refuted**, and should be repeated with the full node set constrained
  before its design-change conclusion is relied on. **Withdrawn by #169
  (2026-09-25)**: repeated that way (and cold, and with #81's own method on
  #81's own circuit), every start regulates at 125 °C/50 mA; item 2's
  reported values are the regulating state's `EA_OUT`/`TS_SNS`/`TS_REF` — see
  "#169" below. The deferral to #79 no longer applies.

`mc-output-accuracy`'s tail-outlier FAIL (mechanism 6) has no issue of its
own — it is expected to close mostly or entirely as a side effect of #70.

#### #71/#81 resolved: `dropout-vs-load`'s `dropout_v` methodology fixed, mechanism 4 diagnosed and root-caused (2026-08-25)

**Methodology (mechanism 3).** `sim/dropout-vs-load/experiment.json`'s deck
now sweeps `VIN` downward (3.63V → 1.5V, 20mV resolution, vs #18's original
50mV upward 1.9V → 3.63V) and `dropout_v` is measured as the `Vin`-`Vout`
margin at the `Vin` where `Vout`, decreasing, first falls through 98% of the
1.8V target (`.meas dc ... find v(vin) when v(vout)=1.764 fall=1`) — the
classic "regulation just lost" definition — rather than the old fixed
`Vin=1.9V` endpoint (which measured deep past dropout). The new full
45-point record (`20260825-055423-c000414`, supersedes
`20260818-032811-81dc232`) confirms the screening estimate: at −40°C/27°C,
across all five process corners, `dropout_v` ranges **0.310V–0.554V**
(worst: `ff`/27°C; best: `ss`/−40°C) — still above the ratified 300mV target (a
real gap, not a testbench artifact) but well below the raw 530mV–1.79V the
old fixed-endpoint measurement reported. 125°C corners are excluded from
this range for the reason below.

**Mechanism 4 (DC-solution-multiplicity) — diagnosed, not one finding but
two depending on temperature.**

- **At −40°C/27°C: predominantly a `dc`-sweep continuation artifact, not
  genuine circuit bistability.** Independent per-point checks at several
  jump points (a fresh, unseeded `.op` with no sweep-continuation history;
  the same `.op` with a `.ic` seed copied node-for-node from a neighboring
  regulating point; and `.options gminsteps=0` to disable `ngspice`'s
  gmin-stepping homotopy fallback, forcing a direct Newton-Raphson solve)
  reliably reconverge to the *regulating* branch, matching the physically
  continuous curve neighboring corners trace out — i.e. it is the default
  `dc` sweep's continuation path that occasionally lands on a second,
  reachable-but-not-physically-preferred algebraic solution, not a second
  stable equilibrium the real circuit would settle into. These jumps were
  confirmed to never dip below the 1.764V departure threshold at these
  temperatures, so the new `dropout_v` measurement is unaffected by them.
- **At 125°C: markedly worse, and NOT confined to the `ff`/`sf`
  thermal-shutdown false-trip (mechanism 1) — it affects all five process
  corners.** A downward sweep at `tt`/125°C, 50mA frequently fails to find
  or hold the regulating branch at all: independent `.op` checks at
  `Vin=3.51–3.53V` converge to non-physical states (e.g. `FB=-985.7V`,
  `N_FBB=-1974.5V` — exactly the nodes `ngspice`'s "singular matrix"
  warnings already flag), and the continued `dc` sweep produces an outright
  non-physical point (`Vout≈-20.29V`) at the same corner. **Confirmed NOT
  the thermal-shutdown false-trip**: `TS_SNS`/`TS_REF` stay in the correct
  untripped ordering at this `tt`/125°C point. This also **corrects** an
  inaccuracy in mechanism 1's original writeup above ("`ss`, `fs` and `tt`
  do not [show physically-impossible numbers at 125°C]") — the pre-#71
  record (`20260818-032811-81dc232`) already contained
  `tt_125c_3.30v: vout_at_max_vin_v=-20.3922V`, a non-physical number at a
  `tt` corner that mechanism 1's single-point `Vin=3.30V` screening check
  didn't catch because it wasn't itself sweeping `Vin`. `fs`/125°C stayed
  numerically well-behaved across all three supply-corner variants
  (`dropout_v≈0.44V`, consistent with the −40/27°C trend), so a real
  solution is reachable there — this reads as a solver-conditioning problem
  at 125°C, not "no valid regulating solution exists," but it was not
  further isolated within this issue's scope.

**Consequence for reading this record**: `dropout-vs-load`'s 125°C corners
(all five processes — this widens mechanism 1's `ff`/`sf`-only exclusion)
should be read with the same "solver artifact, not a literal measurement"
caution already applied to mechanism 1's numbers, not evaluated as real
dropout results. The −40°C/27°C corners are trustworthy under the new
methodology.

#### #81 resolved: mechanism 4's 125°C severity root-caused — a genuine circuit robustness gap, not a solver-tuning problem (2026-08-25)

> **Corrected by #169 (2026-09-25) — item 2 below is withdrawn; read "#169"
> near the end of this file before relying on it.** Re-run as committed
> `sim/` experiments at `tt`/`ss`/`ff`/`sf`/`fs` × 125 °C × {3.30, 3.60,
> 3.63} V / 50 mA, #81's own method (`.ic v(vout)=1.8` only, `uic`), a full
> eleven-node seed with and without `uic`, and a cold EN-edged start all
> regulate at 1.7985–1.7987 V on all 60 points, agree with each other to
> ≤ 6 µV on every dumped node, and emit no solver diagnostics. #81's method on
> a frozen copy of #81's own circuit also regulates at `tt`/`ss`/`fs`, and its
> settled `EA_OUT`/`TS_SNS`/`TS_REF` are exactly the "`Vout`/`FB`/`N_FBB`"
> item 2 reports below (e.g. `tt`: 2.09267 / 1.11360 / 1.04796 V against
> "2.093 / 1.114 / 1.048 V"). There is no second equilibrium; item 2's numbers
> are other nodes of the regulating state, and its `FB`:`N_FBB` anomaly is
> `TS_SNS`:`TS_REF`. **Item 1 is unaffected** (#164 explains it). So the
> conclusion below that "no harness-level fix … can make `dropout-vs-load`'s
> 125°C corners produce trustworthy regulating-branch numbers" and that this
> is "a genuine circuit robustness gap requiring a design change" no longer
> has a basis: the remaining 125 °C problem is item 1, a bench problem
> (#168/#138). The section is kept as written because it is what #81
> recorded.

**Isolated to two distinct, compounding phenomena, both worse at 125°C than
−40/27°C (screening, reproduced from the committed schematic's own netlist,
not `sim/` evidence):**

1. **Outright Newton non-convergence at many `Vin` points, giving
   physically self-inconsistent garbage.** An independent (no
   sweep-continuation history) `.op` scan at `tt`/125°C/50mA across
   `Vin=3.63V→3.30V` shows values that do not even satisfy the feedback
   divider's own algebra (e.g. `Vin=3.63V`: `Vout=3.320V` with
   `FB=-985.6V` — a passive resistor divider cannot produce a node voltage
   400x its input) at most points tried (`3.63V`, `3.60V`, `3.57V`,
   `3.54V`, `3.53V` all inconsistent), while `Vin=3.52V` alone converges to
   a fully self-consistent point (`Vout=1.798V`, `FB=1.199V`,
   `EA_OUT=2.008V`). This is the direct cause of the campaign's most
   extreme numbers (`FB=-985.7V`, `N_FBB=-1974.5V`, etc.) — not a second
   real solution, just the solver's last unconverged iterate at nodes its
   own "singular matrix" warnings already flag (`ea_cz`/`n_fbb`/`amp_enn`).
2. **A second, genuinely self-consistent, stable equilibrium that a
   settled transient reaches instead of the intended 1.8V point — the
   deeper root cause.** Rather than trusting a single-shot `.op`/`.nodeset`
   result (which mechanism 4's -40/27°C diagnosis already showed can be
   steered by the solver's continuation path, not real dynamics), this
   issue ran a `tran ... uic` with `VOUT`'s own capacitor (`C_OUT`, the one
   node with a true reactive state in this loop) initialized exactly at the
   intended `1.8V` operating point (`.ic v(vout)=1.8 ...`), at
   `Vin=3.60V`/50mA/125°C, run 800µs (long enough to fully settle — final
   values flat to 6 significant figures) — a check that does not depend on
   Newton converging to the "right" branch on the first try, since the
   physically real state variable starts exactly where the intended branch
   says it should be. At every process corner tried this way (`tt`, `ss`,
   `fs`), `VOUT` **reliably drifts away from 1.8V to a different, stable
   equilibrium**: `tt`→`Vout=2.093V` (`FB=1.114V`, `N_FBB=1.048V`),
   `ss`→`Vout=2.014V` (`FB=1.191V`, `N_FBB=1.073V`),
   `fs`→`Vout=2.199V` (`FB=1.286V`, `N_FBB=1.100V`) — all with `EA_OUT`
   mid-rail (not saturated to either supply) and `TS_SNS`/`TS_REF` in the
   correct untripped ordering (confirmed not mechanism 1's thermal-shutdown
   false-trip). **This is a real, reproducible finding, not solver noise**:
   the one true state variable in the loop was placed exactly at the
   intended answer and the circuit's own dynamics carried it somewhere
   else. At this second equilibrium the `FB`:`N_FBB` ratio (≈0.94:1) is far
   from the ≈2:1 a passive divider of three equal resistors
   (`R_FB_A`/`R_FB_B`/`R_FB_C`, all `sky130_fd_pr__res_xhigh_po`) would
   produce, implicating a non-resistive current path into these nodes —
   most likely the same resistor family's body-junction leakage this file
   already flagged as a 125°C convergence hazard ("domain-error convergence
   failures in the `R_CZ` compensation resistor's body-junction model")
   becoming large enough at 125°C (junction leakage is exponential in
   temperature) to measurably distort the divider. Not confirmed to a
   specific model-parameter level — that would need device-level probing
   beyond this issue's screening scope.

**Hardening attempted, did not fix it — supports "genuine circuit
robustness gap," not "needs better solver options":**

- `.nodeset` seeded exactly at the intended 1.8V/1.2V/0.6V point on a plain
  `.op` at `tt`/125°C/`Vin=3.51V`: **no effect** — converges to the
  identical non-physical result as the unseeded run.
- `.options gminsteps=0` (the option that reliably fixes the −40/27°C
  continuation artifact per the diagnosis above): **no effect** at
  `tt`/125°C/`Vin=3.51V` (identical non-physical result), and at
  `ss`/125°C/`Vin=3.51V` combined with `.nodeset` seeding, this option made
  the point **worse** — the solve did not converge at all within 2 minutes
  (versus sub-second solves at −40/27°C), where it timed out and was
  killed.
- A properly self-consistent `.ic`-seeded settled transient (item 2 above)
  is the strongest test available and still does not hold the intended
  branch.

Because the deeper cause (item 2) is a real second stable equilibrium the
closed loop's own dynamics prefer at 125°C/50mA, not a solver-seeding
problem, no harness-level fix (`.nodeset`, `.ic`, `gminsteps`, a per-point
independent `.op` mode) can make `dropout-vs-load`'s 125°C corners produce
trustworthy regulating-branch numbers — **this is recorded as a genuine
circuit robustness gap requiring a design change, not fixed in this
issue.** It most plausibly shares root cause with mechanism 2's
already-documented light-load stability shortfall and the bias-generator/
compensation headroom questions #70 investigated (reverted, no fix shipped)
and **#79** continues — the same generalization mechanism 2's own writeup
above already anticipated ("the pass stage's own pole falling with load
current... unclosable without spending amplifier bias current"), now shown
to be severe enough at 125°C to cost the *existence* of a robust intended
operating point at 50mA, not just phase margin. **Recommendation for
#79**: verify any bias-generator/compensation redesign candidate against
this specific check (a `tt`/`ss`/`fs`/125°C/`Vin≈3.60V`/50mA settled
transient seeded at the intended `Vout`) before considering it a fix for
mechanism 2, since a redesign that only restores phase margin at moderate
temperature would not by itself address this.

**Campaign re-run: not repeated for `dropout-vs-load`.** The just-landed
`20260825-055423-c000414` record already reflects the 125°C-wide exclusion
this issue's diagnosis confirms is correct (and, per the above, not
resolvable by a harness change) — no `experiment.json`/testbench deck
change was made by this issue, so a fresh 45-point run against the
identical deck and PDK pin would reproduce the same numbers, not add
verification value; not run here to avoid a purely-redundant append-only
record. A future campaign naturally supersedes this one once #79 (or a
successor) actually changes the circuit.

**`load-transient` checked, no widened issue found.** Unlike
`dropout-vs-load`'s `dc` sweep, `load-transient` is a transient analysis
that starts from a single computed operating point and applies a load
step, rather than continuation-sweeping across many `Vin` points — the
exact mechanism (a long, ill-conditioned continuation path) implicated
above. The existing record
(`sim/load-transient/records/20260818-032755-81dc232.md`) confirms this
in practice: at 125°C, `tt`/`ss`/`fs` all report plausible, physically
sane `undershoot_v`/`overshoot_v` values (0.157V–0.284V — real spec
misses against the 0.15V ratified target, not solver artifacts), while only
`ff`/`sf` show the extreme non-physical values (`undershoot_v` up to
22.29V) mechanism 1's thermal-shutdown false-trip already explains. No
re-run needed — the existing record already answers this issue's
check.

### Bias-generator redesign investigated, reverted (#70)

**Status: investigated, not shipped.** Issue #70 set out to fix the PSRR
shortfall (mechanism 5 above) and the pervasive light-load stability
shortfall (mechanism 2) via a bias-generator and/or compensation redesign,
per its own acceptance criteria's instruction to screen any candidate at a
single corner (PSRR at 1 kHz/100 kHz, phase margin at 0 mA) before
committing to an expensive full 45-point re-run. Two PSRR candidates and
one stability candidate were built and screened; **none was shippable**,
so `ldo_3v3in_1v8out.sch` is **unchanged** by this issue — this section is
the record of what was tried, per this repo's "verification is the
product" discipline (a well-verified negative result is still evidence).
Follow-on work continues in **#79**, seeded with the data below so the
next attempt does not repeat the same failed sizing.

**Candidate 1: self-biased ("beta-multiplier") bias-generator reference.**
The suspected root cause named a bias generator with "no supply-independent
reference or cascode" — the standard textbook fix (e.g. Razavi ch.5) is a
self-biased reference: a PMOS mirror (`M_BIASP1`/`M_BIASP2`) forcing two
NMOS legs' currents equal regardless of `VIN`, with an unequal-width pair
(`M_BIASN2`/`M_SBN2`, `K=4`) plus a degeneration resistor `R_SB` pinning
the equilibrium current to `R_SB` and the device ratio instead of to
`VIN/R`, and a passive startup trickle (`M_ENSTART`/`R_START`) to break the
loop's degenerate `I=0` solution. This was fully implemented in place of
`R_BIAS`/`M_BIASN1`/`M_BIASN2`/`M_BIASP1`.

- *A real bug, found and fixed en route.* Both new resistors (`R_SB`,
  `R_START`) were missing their third (body) `lab_pin` terminal that
  `sky130_fd_pr__res_high_po`/`res_xhigh_po` require — xschem silently
  auto-named the unconnected pin a floating net (`net1`/`net2`) rather than
  erroring, and ngspice reported `"singular matrix: check node net1"` on
  every `.op`. Fixed by tying the body pin to `0`, the same convention
  `R_BIAS` already used.
- *After that fix, the loop still does not settle at its intended
  operating point.* A real transient startup check (`EN` ramping 0→`VIN`
  over a few µs, not a bare cold `.op` — this repo's own established
  convention for exactly this class of question, see "Thermal shutdown"
  and the `enable-shutdown` testbench's rising-edge note in
  `sim/README.md`) settles into a genuine, stable-but-wrong high-current
  branch at every load point tried (`tt`/27°C, `VIN=3.3V`, 0/1/50 mA):
  `NB` pulled to ≈3.297 V (≈`VIN`), `BIASP` pulled to ≈0.673 V, and total
  supply current ≈1 mA at 0 mA external load — over 30× the Iq
  `< 30 µA` row (set by DR-009, `proposed`), with `VOUT` collapsed to a few
  hundred µV to a few mV.
  This reproduces from a *settled* transient (500 µs, values steady well
  before the end of the run), not a one-shot `.op` artifact, and is
  independent of `.nodeset` hints biasing the solver toward the intended
  low-current point — the solver keeps returning to the same bad branch.
- *Working, not-fully-proven diagnosis.* `M_BIASN2` (narrow, its gate
  driven externally by `NB`) and the `M_BIASP1`/`M_BIASP2` mirror appear to
  form a positive-feedback path: `NB` rising turns `M_BIASN2` on harder,
  which pulls `BIASP` down, which raises `M_BIASP1`/`M_BIASP2`'s own
  `Vsg`, which mirrors *more* current back into `NB` — reinforcing the rise
  rather than correcting it. A rough hand estimate of the *intended*
  equilibrium (weak inversion, `Vgs1−Vgs2 ≈ n·V_T·ln(K)` with `K=4`, set
  against `R_SB≈1.22MΩ`) lands at tens of nA — three orders of magnitude
  below where the simulated bad branch actually settles — suggesting the
  positive-feedback loop's gain may never actually drop below unity at the
  intended weak-inversion point with this sizing, rather than this being a
  simple startup-kick sizing problem. Confirming that (and re-deriving a
  sizing where the loop gain genuinely does cross unity, a real large-
  signal stability analysis, not a trial-and-error re-tune) is **#79**'s
  scope, not this issue's.

**Candidate 2: cascode only the OTA's own PMOS pull-up mirror.** Narrower
than Candidate 1: keep the original `R_BIAS`-referenced generator
unchanged, and address only the second mechanism #60/#70's root-cause data
named — "the current-mirror OTA's own pull-up path (`M_MIRP1`/`M_MIRP2`)...
unlike the NMOS pull-down side..., the pull-up mirror's reference is
itself referred to `VIN`." Added `M_MIRP1C` (a diode-connected PMOS
stacked below `M_MIRP1`, generating a cascode-bias node `PBC`) and
`M_MIRP2C` (cascoding `M_MIRP2`, gate=`PBC`, inserted between `M_MIRP2`'s
drain and `EA_OUT`) — a standard low-voltage cascode-mirror bias generation
(Razavi ch.9), not a new gain stage (both new turnaround nodes are still
low-impedance/diode-loaded).

- Netlisted cleanly and **regulated correctly at all three DR-002 load
  points** (0/1/50 mA, `tt`/27°C/3.3V: `VOUT` 1.8007–1.8035V), unlike
  Candidate 1 — this alone is a real, isolated, working change.
- **Screened PSRR at 1 kHz did not show a material improvement, and
  regressed at one corner.** Quick 3-corner subset (`tt_27c_3.30v`/
  `ss_-40c_2.97v`/`ff_125c_3.63v`), against the pre-#70 baseline
  (`sim/psrr-dc` record `20260818-015127-01b7905`, 1 kHz: 23.3/23.6/22.4 dB):

  | Corner | Baseline (pre-#70) | Candidate 2 (cascode only) |
  |---|---|---|
  | `tt_27c_3.30v` | 23.3 dB | 23.2 dB (unchanged) |
  | `ss_-40c_2.97v` | 23.6 dB | **17.6 dB (regression)** |
  | `ff_125c_3.63v` | 22.4 dB | 76.6 dB* |

  \*`ff_125c_3.63v` is the thermal-shutdown false-trip corner #69 already
  root-caused — its high number is AC gain around a collapsed,
  non-regulating bias point, not real PSRR headroom, in either record.
  100 kHz PSRR improved modestly at `ss` (37.0 dB vs. the baseline record's
  31.7 dB) but both already clear the 20 dB bound there, so it changes no
  verdict. Given no material 1 kHz improvement and an outright regression
  at one corner, this candidate was **not committed** either.
- *Working theory for why cascoding the feedthrough path did not help.*
  1 kHz sits well below this bias point's own loop crossover — the
  0 mA/1 mA points' crossover is far lower than the 50 mA/0.33 µF corner's
  measured 150–190 kHz (see "Compensation (sized in #25)"), so PSRR at
  1 kHz is more likely **loop-gain-limited** than feedthrough-limited at
  this bias point, consistent with this file's existing "PSRR at a given
  frequency tracks loop gain at that frequency" note. Cascoding a
  feedthrough path that is not the dominant term at 1 kHz would not be
  expected to move the number much either way — which is what was measured.

**Candidate 3 (stability side): a preload resistor from `VOUT` to
ground.** Per #70's own "Suspected Cause" (b), raising the light-load pass
current should raise `gm_pass` and push the pass-stage pole up in
frequency, directly targeting the documented 15–24° 0 mA phase-margin
shortfall.

- A hand-rolled AC screening deck (fresh cold `.op`, `RLOAD` swept from
  1 MΩ down to 100 kΩ in parallel with the internal feedback divider, not
  routed through `corner-run.py`) showed the loop crossover frequency
  rising markedly — 283 Hz → 1647 Hz, ~5.8× — as total quiescent current
  rose from ≈13 µA to ≈31 µA. Directionally promising.
- **This result is not trustworthy evidence for the real 0 mA branch,
  and was not further pursued in this pass.** A real `sim/loop-gain
  --quick` corner run against the identical (Candidate-2, then fully
  reverted) schematic measured `pm_c033_0ma_deg` = 19.19°/15.64° at
  `tt`/`ss` — matching this file's already-documented baseline almost
  exactly. But the hand-rolled deck's own phase-margin figure at the
  nominal same operating point computed to ≈177°, wildly different. The
  most likely explanation: `corner-run.py`'s deck reaches the 0 mA point
  by `alter`-ing `rload` down from the 50 mA point's already-converged
  operating point, while the hand-rolled deck solved a fresh cold `.op`
  directly at the light-load point — and this schematic already has a
  documented DC-solution-multiplicity finding (mechanism 4 above, sibling
  issue **#71**'s scope) where a cold solve and an alter-continuation
  solve can land on different valid branches for the same nominal bias
  condition. **The crossover-frequency trend is real evidence the preload
  current changes the small-signal behaviour, but it was measured on a
  branch that is not confirmed to be the same branch the documented
  15–24° PM shortfall lives on**, so it is not treated as a validated fix
  here.
- Independent of that ambiguity, the `Iq` headroom for any preload is
  tight regardless: "Quiescent and shutdown current" above measures
  24.9 µA at 50 mA against the `Iq < 30 µA` row (set by DR-009, `proposed`),
  leaving only ≈5 µA
  of room for a preload that adds current at *every* load point (not just
  at 0 mA) before that row itself would be missed.

**Net effect on the ratified spec rows.** PSRR and Stability remain **open**,
exactly as mechanisms 2 and 5 in the campaign section above describe —
this investigation did not close either. Per `CLAUDE.md`'s "a row that
proves unmeetable is superseded by a new decision record, never silently
loosened" discipline, no ratified row was touched: both the 50 dB PSRR row
and the 45° Stability row stand as written, and the two screened-but-
rejected candidates above are recorded as real, if negative, findings
rather than folded into a claim of progress. **#79** carries the
investigation forward with this section's data as its starting point.

### Self-biased bias-generator re-derived and fixed; preload re-validated against the real branch — neither closes PSRR/Stability (#79, 2026-08-25)

**Status: both candidates investigated to a real, verified conclusion;
`ldo_3v3in_1v8out.sch` is unchanged by this issue too.** #70's own writeup
left two open threads: (1) whether Candidate 1's self-biased reference
could be *fixed* rather than merely re-tuned (its own working diagnosis:
"this needs a genuine large-signal loop-gain/stability re-derivation... not
a trial-and-error re-tune"), and (2) whether Candidate 3's preload-resistor
trend was real on the *actual* branch `sim/loop-gain`'s corner runner
reaches (its own finding: measured on a branch "not confirmed to be the
same branch the documented 15-24° PM shortfall lives on"). This issue
resolves both questions — (1) with a genuine fix, (2) with a real
negative result — and neither, once resolved, closes the PSRR or
Stability ratified rows.

#### 1. Self-biased reference: root-caused #70's regenerative-loop defect and fixed it

**Root cause, derived by hand before any resizing (per this issue's own
scope instruction).** #70's Candidate 1 wired the textbook beta-multiplier
with `M_BIASN1` (diode-connected, drain=gate=`NB`) as the *wide* (`K=4`)
device and `M_BIASN2` (externally driven, gate=`NB`, drain=`BIASP`) as the
*narrow*, source-degenerated-by-`R_SB` device. Writing the loop's DC
small-signal return ratio around `NB` (`M_BIASP1`/`M_BIASP2` PMOS mirror,
ratio `m`, closing the loop back into `NB` through the diode-connected
NMOS) gives, in the strong-inversion square-law approximation:

```
LG(m, K) = sqrt(m/K) + 2*(1 - sqrt(m/K))   [R_SB on the WIDE/diode leg]
         = 2 - sqrt(m/K)
```

For a 1:1 PMOS mirror (`m=1`, the natural default and what #70 built),
`LG = 2 - 1/sqrt(K)`, which is **strictly greater than 1 for every `K>1`**
— this specific device-role assignment is *structurally* regenerative, not
merely mis-sized. That single derivation explains #70's entire finding:
the loop was never going to settle at its intended few-µA point regardless
of which `K`/`R_SB` values were tried, because the topology as wired makes
the intended equilibrium an unstable fixed point (a latch, not a
regulator) — consistent with the ~1mA rail-clamped branch #70 actually
measured.

**The fix: put `R_SB` on the externally-driven (narrow) leg instead of the
diode leg, and re-derive.** Re-deriving the same loop with `R_SB` moved to
`M_BIASN2`'s source (leaving `M_BIASN1` an *undegenerated* diode) and
solving the same KVL/KCL gives a materially different result:

```
LG(m, K) = sqrt(m/K) / (2*sqrt(m/K) - 1)          [R_SB on the NARROW/driven leg]
```

This is monotonically *decreasing* in `r = sqrt(m/K)`, from `LG=1` at the
`m=K` boundary down to `LG->0.5` as `m/K->infinity` — i.e. **any mirror
ratio `m` exceeding the width ratio `K` gives `LG<1`**, the opposite
requirement from the failed placement, and with a comfortable design
margin available (not just barely crossing 1). This also resolves the
apparent contradiction in the R_SB-placement choice: with `R_SB` on the
diode leg, a physically valid (`R_SB>0`) solution requires `m<K`, which is
incompatible with `LG<1`(`m>K`) — the two requirements can never both hold
for that placement, which is *why* Candidate 1 could not have been fixed
by resizing alone, only by moving the resistor.

**Verified in SPICE (sky130 device models, not just the hand square-law
formula) three independent ways, per this issue's "not just `.op`/`.tran`"
instruction:**

1. **`.dc` loop-break sweep of the candidate feedback node**, `K=1`
   (`M_BIASN1`/`M_BIASN2` both `W=4 L=1`, no width mismatch needed — the
   derivation above shows only the ratio `r=sqrt(m/K)` matters, so `K`
   does not need to be large), `m=1.7` (`M_BIASP2` `W=17 nf=2` vs.
   `M_BIASP1`'s `W=10 nf=2`), `R_SB` tuned (`res_high_po` `W=0.42 L=16`,
   ~13.8kΩ) to reproduce the pre-#79 design's own `BIASP`/`I1` operating
   point (see below). Breaking the loop at `NB` and sweeping an
   independent drive from 0V to `VIN` finds **exactly one self-consistent
   crossing** across the full range (`NB_drive ≈ NB_out ≈ 0.89V`) with a
   measured local return-ratio slope of **0.74** — matching the hand
   estimate (`LG≈0.81` at this `m`,`K`) in both sign and rough magnitude,
   and confirming *no second (bad) branch exists anywhere in the swept
   range* — unlike #70's Candidate 1, which settled onto a real,
   reachable second branch.
2. **A settled transient startup check** (`EN` ramping 0→`VIN` over 1-3µs,
   the same convention #70 used and #70's Candidate 1 failed), with a
   passive startup trickle `R_START` (`res_high_po` `W=0.42 L=10000`,
   ~8.1MΩ, `VIN`→`NB` — replacing #70's reverted switched
   `M_ENSTART`/`R_START`; self-quenches at `EN=0` the same way the
   original `R_BIAS` did, since `M_ENN` cutting `M_BIASN1`'s ground return
   lets `NB` float to `VIN`, leaving 0V across `R_START` too): settles
   within ~3µs to `NB=0.900V`, `BIASP=2.237V` and holds flat through
   500µs — matching the `.op`/loop-break equilibrium, not a rail-clamped
   branch.
3. **A 15-point process×temperature spot-check** (`{tt,ss,ff,sf,fs}` x
   `{-40,27,125}°C`, `VIN=3.3V`, `.op` with a `.nodeset` near the expected
   point to work around a `125°C` cold-Newton convergence slowness this
   circuit shares with the rest of the schematic — see "#71/#81 resolved"
   above for the same phenomenon on the main loop): every corner converges
   to a physically sane point, `I1` ranging **1.46-3.56µA** monotonically
   with temperature and only mildly with process — no runaway branch found
   at any of the 15 points.

**Sizing was chosen to reproduce the pre-#79 operating point, not to
minimize current.** The pre-#79 `R_BIAS`-referenced design measures
`NB=0.864V`, `BIASP=2.236V`, `I1≈2.0µA` (`tt`/27°C/`VIN=3.3V`, `M_BIASP1`
unchanged `W=10 nf=2` in both designs) — `M_TAIL`/`M_CLP`/`M_SSCHG`/
`M_TSPS`/`M_TSPR`/`M_TSHYSB` all mirror off `BIASP`'s *voltage*, not off
`I1` directly, so matching `BIASP` (not just qualitatively "a few µA")
keeps every downstream bias current within its pre-#79 value and avoids
re-triggering #22's current-limit/soft-start timing or #25's compensation
sizing, which is out of this issue's scope. The chosen `R_SB`/`m` hit
`BIASP=2.238V`/`I1=2.05µA` at `tt`/27°C — a close match. The unavoidable
cost of the fix is the second leg's own current, `I2≈m*I1≈3.2-3.4µA`
(measured via total `VIN` current minus `I1`), which the pre-#79 topology
did not have to pay (a single-leg resistor reference has no second leg).
Against "Quiescent and shutdown current" above (24.91µA measured at
50mA/3.63V against the `Iq<30µA` row (set by DR-009, `proposed`), ~5µA
headroom), this ~3.3µA
addition is real but survivable in isolation.

**Does not move PSRR or 0mA phase margin — the reference-loop-stability
question and the PSRR/Stability spec gaps are different questions.**
Per this issue's own instruction ("re-screen PSRR at 1kHz/100kHz and 0mA
phase margin... before committing to any full 45-point re-run"), this
candidate was screened with the schematic edit actually in place (single
run, then reverted — see below) against the same 3-corner quick subset
#70 used:

| Corner | Baseline PSRR@1kHz (pre-#70/#79) | This candidate |
|---|---|---|
| `tt_27c_3.30v` | 23.3dB | 23.5dB (unchanged) |
| `ss_-40c_2.97v` | 23.6dB | **22.3dB (regression)** |
| `ff_125c_3.63v` | 22.4dB* | 76.6dB* |

\*`ff_125c_3.63v` is the #69 thermal-shutdown false-trip corner in both
records — not real PSRR evidence either way, same caveat as #70's table.

`pm_c033_0ma_deg` (0mA phase margin, `loop-gain --quick`): `tt=19.65°`,
`ss=14.63°` — statistically identical to the already-documented baseline
(`19.19°`/`15.64°`), not the material improvement a shippable candidate
would need. A standalone VIN-sensitivity check of the reference current
itself (independent `.op` at `VIN={2.97, 3.3, 3.63}V`, avoiding the same
`.dc`-continuation-branch pitfall "#71/#81 resolved" flags) shows a real
but modest reduction in `I1`'s own fractional VIN-sensitivity — **26.3%
(baseline `R_BIAS`) → 16.1% (this candidate)** across the ±10% `VIN`
window, roughly a 4dB improvement referred to the bias current alone —
but `BIASP`'s own *voltage* still tracks `VIN` at ~0.98V/V in both
designs (an inherent property of a PMOS-diode-referenced rail, not fixed
by what sets the diode's current), so the downstream mirror gate rail
still passes most of any `VIN` ripple through. This is consistent with
this file's own pre-existing diagnosis ("PSRR at a given frequency tracks
loop gain at that frequency") and with #70's Candidate 2 finding (cascoding
a feedthrough path that is not dominant at 1kHz does not move the number)
— **1kHz PSRR here is genuinely loop-gain-limited, and a bias-generator
supply-rejection fix, however well-verified its own internal stability is,
does not reach the actual bottleneck.** `pm_c033_0ma_deg` is independently
already explained by this file's "pass stage's own pole falling with load
current" mechanism (see the 45-point campaign section above), which a
bias-generator change does not touch either.

**Net effect: reverted, per the same "no material improvement -> not
committed" discipline #70 used for its own Candidate 2.** The derivation
and verification above are recorded as a genuine, useful result in their
own right — the open question of *whether a stable self-biased reference
is achievable for this topology at all* is now answered (yes, with `R_SB`
on the correct leg and `m>K`), closing that specific thread #70 left open
— but since it does not move either target metric and costs real,
non-refundable `Iq` budget (~3.3µA against a ~5µA headroom) for no
measured benefit, it is not shipped. `ldo_3v3in_1v8out.sch` is unchanged.

#### 2. Preload resistor: re-validated against the real corner-runner branch — does not cleanly fix it either

**Per this issue's scope, re-validated against `sim/loop-gain`'s actual
`corner-run.py` deck** (which reaches the 0mA point via `alter rload`
from the already-converged 50mA operating point — see its
`experiment.json`), not #70's hand-rolled cold-`.op` deck. A screening
`R_PRELOAD` (`res_xhigh_po`, `VOUT`->`0`) was added to the schematic (not
part of any shipped change — reverted after screening, see below) and run
through `sim/loop-gain --quick` at two sizes:

| Measurement | Baseline (no preload) | `R_PRELOAD≈300kΩ` (~6µA) | `R_PRELOAD≈600kΩ` (~3µA) |
|---|---|---|---|
| `tt_27c_3.30v` `pm_c033_0ma_deg` | 19.31° | **22.67° (+3.4°)** | 19.24° (~unchanged) |
| `tt_27c_3.30v` `pm_c47_0ma_deg` | 52.03° (PASS) | **20.12° (regression, now FAIL)** | 24.39° (regression, now FAIL) |
| `ss_-40c_2.97v` `pm_c033_0ma_deg` | 15.60° | **24.14° (+8.5°)** | 19.67° (+4.1°) |
| `ss_-40c_2.97v` `pm_c47_0ma_deg` | 38.06° | **16.88° (regression)** | 19.30° (regression) |

The 300kΩ preload's `pm_c033_0ma_deg` improvement (#70's own hoped-for
result, now confirmed real on the branch that matters, closing #70's own
"not confirmed to be the same branch" caveat) is genuine — but it comes
at the cost of a *larger* regression at the 4.7µF/0mA corner, which
**passed** at baseline and now fails by a wider margin than the 0.33µF
corner used to fail by. The 600kΩ (lighter) preload nearly eliminates
both the gain and the damage, netting out close to a wash. **Working
explanation, consistent with this file's own existing "two-sided
optimum, not a bigger-is-better knob" note about `R_CZ`:** the preload's
extra `gm_pass` shifts the pass-stage's output pole relative to the fixed
compensation zero (`R_CZ`/`C_COMP`) differently depending on `C_out`,
improving the pole/zero spacing at 0.33µF (where the pole was too low)
while worsening it at 4.7µF (where the pole was already reasonably
placed and gets pushed past the zero the other way) — a single passive
preload current cannot independently tune both corners of DR-002's
C_eff window at once, the same structural limit a fixed-value `R_CZ` has.

**Iq cost is real and, like the self-biased candidate, not free**: 300kΩ
costs ≈6µA and 600kΩ ≈3µA against the same ~5µA headroom "Quiescent and
shutdown current" above measures, present at *every* load point (not
just 0mA) as #70 already flagged — on top of costing budget, neither size
is a clean net win on phase margin. **Net effect: reverted, not shipped.**
`ldo_3v3in_1v8out.sch` is unchanged.

**What this resolves for #70's own open question.** #70 could not tell
whether its promising crossover-frequency trend was measured on the real
branch. It now is confirmed to be real *and* to genuinely raise
`pm_c033_0ma_deg` on the actual `sim/loop-gain` branch — but that trend
alone was never sufficient evidence of a net fix, and checking it against
the DR-002 window's *other* corner (`pm_c47_0ma_deg`) — which #70's
screening never covered — shows why: a preload is a one-parameter knob
being asked to fix a two-corner problem.

**Net effect on the ratified spec rows.** PSRR and Stability remain **open**,
same as after #70. Both avenues #70 identified as promising have now been
carried to a definitive, verified conclusion (one fixed a real defect but
does not move the metric; one is confirmed real on the correct branch but
does not net a clean win) rather than left as an open question for a
future issue to re-litigate. Per `CLAUDE.md`'s discipline, no ratified row
is touched. **What remains unexplored**, based on this and #70's combined
findings: closing `pm_c033_0ma_deg`/PSRR appears to require spending
additional amplifier-side (not bias-generator- or preload-side) `Iq` —
directly raising `M_TAIL`'s own tail current, which issue #25's own
"Quiescent and shutdown current" section already measured as effective
("keeps improving the no-load phase margin, up to ~40°" at 6x `M_TAIL`)
but rejected for exceeding the `Iq` row (33.6µA vs. 30µA, set by DR-009,
`proposed`) — meaning
a durable fix plausibly needs either a compensation/amplifier topology
change that does not cost `Iq` linearly, or a revisit of the
`Iq<30µA` row itself — the row `DR-009` sets (`proposed`; it ratifies on
its own PR merge) — through a new decision record superseding DR-009 (a
decision this repo's `CLAUDE.md` reserves for a spec decision record, not
a Builder default; issue #1, the original ratification gate, closed
`completed` 2026-09-18 and cannot set it). Filing a further follow-on
issue for that specific, narrower question is left to Curator/human triage
rather than decided here.

### DR-007 recommends superseding the ratified PSRR/Stability rows; no circuit change (#70, PR #106, 2026-09-14)

**Status: `proposed`, pending #1's two-key market-comparison mechanism. No
schematic change ships with this record — `design/ldo_3v3in_1v8out.sch`
remains exactly as #25 sized it and #70/#79 left it.** With both #70's own
candidates (PR #82) and #79's follow-on candidates (PR #88) carried to
definitive, verified-negative conclusions (see the two sections above), the
operator's 2026-09-14 scoping comment on #70 directed the next increment:
draft a decision record recommending one of the two paths #70's original
framing posed — spend further amplifier `Iq` chasing the ratified targets, or
treat the two negative results as evidence the ratified PSRR/Stability rows are
unmeetable by the shipped topology and need revision — rather than parking
the issue indefinitely as `loom:operator-only`/`loom:operator-decision`.

`spec/decision-records/DR-007-psrr-stability-vs-iq.md` recommends the
latter. It argues the ratified 50dB-@-1kHz PSRR row and 45°-PM-@-0mA
(worst-corner) Stability row are structurally unmeetable by the current
single-stage current-mirror OTA plus its shared, un-cascoded bias generator
within the `Iq < 30µA` row (set by DR-009, `proposed`) — not an unexhausted
design space a further
Iq-spend attempt is likely to close, since the one lever that ever moved
0mA phase margin at all (issue #25's 6x `M_TAIL` screen) already exceeds the
Iq budget by 12% and still misses the 45° floor by 5°, with no PSRR data
either way. It proposes replacement rows read directly off the existing
`sim/psrr-dc` (`20260825-082845-4cb27f8`) and `sim/loop-gain`
(`20260825-081257-4cb27f8`) records — PSRR ≥18dB @ 1kHz / ≥28dB @ 100kHz,
and PM ≥45°/GM ≥10dB for `I_load ≥ 1mA` with no floor stated at the literal
0mA point — against two public comparables (onsemi NCP170, Microchip
MCP1801) that both clear the original 50dB target at or below this design's
own Iq budget, so the market-comparison mechanism has real, cited numbers to
rule on rather than an unsubstantiated ask. The `Iq < 30µA` row itself (set
by DR-009, `proposed`)
is left untouched — neither verified-negative attempt showed it to be the
binding constraint.

**Documentation-only, per the operator's explicit scoping** ("do not
implement a circuit change or relax any `spec/target-spec.md` row in the
same PR" — #70, 2026-09-14). DR-007's own Consequences section notes a
genuine fix most plausibly needs a higher-DC-gain amplifier architecture
(two-stage or cascoded gain stage) rather than further `Iq` spent inside the
current topology — that is scoped to a new, future issue (**#107**)
informed by #70/#79/DR-007's combined data, not a further decomposition of
#70's own lineage, which DR-007 treats as closed by its two verified-negative
results (this record's own acceptance-criteria bookkeeping, not a claim that
#1's ratification question is settled).

### #60 closed: root-cause + decomposition is complete; #107 owns what remains (2026-09-15)

**Status re-check, not a new finding.** With #69, #70/#79/#81 and #71 all now
closed, this is a fresh read of `measurements/characterization.md` (verified
current: `python3 measurements/build_characterization_report.py --check`
passes as of this commit) against #60's own Acceptance Criteria, to confirm
their closure is real rather than assumed.

**Current evidence — none of the five rows #60 opened against has flipped to
PASS**, and none should have: no schematic change has landed since the
post-#69 thermal-shutdown resize (`design/ldo_3v3in_1v8out.sch` is unchanged
since PR #90), so the 2026-08-25 campaign (`*-4cb27f8`/`*-933dfdd` records)
remains the freshest evidence and needed no re-run this pass:

| Row | Verdict | Evidence |
|---|---|---|
| Output | FAIL | `mc-output-accuracy` `20260825-083111-4cb27f8` — 177/200 individual MC samples pass; aggregate sigma-window fails |
| Dropout @ 50mA | FAIL | `dropout-vs-load` `20260825-081240-4cb27f8` — 0/45 corners pass |
| Load transient | FAIL | `load-transient` `20260825-081255-4cb27f8` — 25/45 corners pass |
| PSRR | FAIL | `psrr-dc` `20260825-082845-4cb27f8` — 0/45 corners pass |
| Stability | FAIL | `loop-gain` `20260825-081257-4cb27f8` — 7/45 corners pass |

**Reading this against #60's own Acceptance Criteria:**

1. **Root-cause each FAIL row** — done (PR #72, this file's mechanisms 1–6
   above), and every mechanism has since been independently confirmed or
   resolved by its owning follow-up (#69/#70/#79/#71/#81), not merely
   asserted.
2. **Fix the design, or document a spec-change rationale, per row** —
   satisfied unevenly across the five rows, and that unevenness is the
   honest state, not a gap this issue can close alone:
   - **PSRR and Stability**: satisfied via a documented, evidence-backed
     spec-change rationale — DR-007 (status `proposed`, pending #1's
     market-comparison mechanism), which proposes specific replacement
     numbers read off the records above, cited against public comparables.
   - **Dropout, Load transient, Output accuracy**: *not* closed by a fix or
     by their own spec-change rationale. Each has a dated, traced
     explanation in this file of why it cannot close without a design
     change (dropout's real −40/27°C headroom is 0.310–0.554V, mechanism 3;
     the DC-solution-multiplicity finding at 125°C, mechanism 4/#81; the
     pervasive light-load stability shortfall driving both load-transient's
     non-thermal-shutdown FAILs and output accuracy's MC tail outliers,
     mechanism 2/6) — and each traces to the same bias-generator/
     compensation-headroom limitation DR-007 documents for PSRR/Stability,
     not an independent cause. No decision record proposes replacement
     numbers for these three rows specifically; the live path to closing
     them is a design fix, not a spec change, per **#107**'s scope (a
     higher-DC-gain amplifier architecture) — DR-007's Consequences section
     already flagged that a two-stage/cascoded topology is the most
     plausible route, and #107 is expected to inform all three of these
     rows as a side effect of its PSRR/Stability work, not just the two
     rows it names directly. #107 had not landed a result as of this pass.
3. **Re-run the full 45-point campaign after any design change** — no design
   change has landed since the post-#69 resize, so there is nothing new to
   re-run; the table above is the freshest evidence and still current.
4. **Regenerate `measurements/characterization.md`** — already current
   (`--check` passes); nothing to regenerate against.
5. **Update this "Known gaps" section** — done, repeatedly, by #72/#70/#71/
   #81's own landings and this section.

**Disposition.** #60's own job — root-cause each FAIL row, decompose the
fix-or-defer decision per row, and track each slice to either a landed fix
or a documented rationale — is complete. It has no further independent
code-level increment to contribute: the remaining path to flipping Dropout,
Load transient, Output accuracy, PSRR or Stability to PASS on the ratified
table runs entirely through **#107** (open, separately tracked), not through
a new #60 increment that would just restate this same conclusion. Closing
#60 on that basis, per this repo's "issues are suggestions" convention —
not because the underlying FAILs are gone, but because this issue's own
scope is exhausted and #107 is the correctly-scoped successor already
carrying it forward.

### Thermal-shutdown trip/hysteresis testbench ships (issue #66, 2026-08-25)

The Thermal ratified spec row's evidence gap — no dedicated `sim/` testbench for
the thermal-shutdown circuit's (#29/DR-005) actual trip/reset behavior — is
now closed by `sim/thermal/`. Two things had to happen first, per this
issue's own acceptance criteria:

1. **The 125 °C-vs-150 °C corner-coverage decision.** DR-005's Consequences
   section named this gap in advance: DR-004 pins this repo's PVT-corner
   verification temperature axis at `{−40, 27, 125} °C`, but DR-005's
   150 °C nominal trip target sits above it. **Decided: extend, scoped to
   this one testbench** — see DR-005's `2026-08-25 addendum` for the full
   reasoning, the empirical check that justified it, and the accepted
   tradeoff (points above 125 °C run the pinned models in extrapolation
   beyond DR-004's characterized range). This does not touch DR-004's
   binding for `load-transient`/`psrr-dc`/`dropout-vs-load`/`loop-gain`.
2. **An ngspice measurement-technique pitfall, found and worked around
   before the authoritative record.** `.meas dc ... find/when ... fall=1`
   returns a nonsensical result (observed: `1.15e7` instead of ≈`101`) when
   the crossing falls inside the sweep's very first interval. The first
   run (`20260825-050729-6fac47d`, superseded) hit this at `sf_27c_3.30v`
   with a 100 °C sweep floor; widening the floor to 80 °C (safely below
   every corner's actual trip point) fixed it for the authoritative record.
   See `sim/thermal/experiment.json`'s own comments for the full writeup —
   this is a testbench/tooling limitation, not a circuit finding.

**Method**: a continuous ngspice `.dc temp` sweep, 80→180 °C ascending then
180→80 °C descending in one session (DC continuation, so the descending leg
starts from the ascending leg's final operating point — the standard
technique for characterizing a hysteretic comparator's two trip points),
watching `V(VOUT)` collapse (trip) and recover (reset, auto-restart) across
the full `process × supply_v` matrix (`temperature_c` is a fixed manifest
placeholder — the real temperature axis is the swept analysis variable, not
a corner-matrix dimension, so `sim/thermal`'s auto-generated record's "Full
PVT matrix declared..." line renders the standard −40/27/125 °C boilerplate
inherited from the shared harness; read the experiment's own `claim` and
this section for the accurate picture instead).

**Authoritative record**: `sim/thermal/records/20260825-054043-6fac47d`
(supersedes `20260825-050729-6fac47d`), full 15-point `process × supply_v`
matrix:

| Corner | `trip_temp_c` | `reset_temp_c` | `hysteresis_c` | Verdict |
|---|---|---|---|---|
| `tt_27c_2.97v` | 135.0 | 137.0 | −2.0 | FAIL (hysteresis) |
| `tt_27c_3.30v` | 135.0 | 137.0 | −2.0 | FAIL (hysteresis) |
| `tt_27c_3.63v` | 135.0 | 135.0 | 0.0 | PASS |
| `ss_27c_2.97v` | 149.0 | 157.0 | −8.0 | FAIL (hysteresis) |
| `ss_27c_3.30v` | 145.0 | 145.0 | 0.0 | PASS |
| `ss_27c_3.63v` | 145.0 | 149.0 | −4.0 | FAIL (hysteresis) |
| `ff_27c_2.97v` | 121.0 | 121.0 | 0.0 | FAIL (trip < 125 °C) |
| `ff_27c_3.30v` | 117.0 | 123.0 | −6.0 | FAIL (trip < 125 °C, hysteresis) |
| `ff_27c_3.63v` | 115.0 | 121.0 | −6.0 | FAIL (trip < 125 °C, hysteresis) |
| `sf_27c_2.97v` | 99.0 | 105.0 | −6.0 | FAIL (trip < 125 °C, hysteresis) |
| `sf_27c_3.30v` | 101.0 | 101.0 | 0.0 | FAIL (trip < 125 °C) |
| `sf_27c_3.63v` | 95.0 | 105.0 | −10.0 | FAIL (trip < 125 °C, hysteresis) |
| `fs_27c_2.97v` | 165.0 | 165.0 | 0.0 | PASS |
| `fs_27c_3.30v` | 167.0 | 167.0 | 0.0 | PASS |
| `fs_27c_3.63v` | 165.0 | 165.0 | 0.0 | PASS |

**Overall: FAIL (5/15 PASS)** — an honest, expected finding given #69 was
already open before this testbench existed. Two distinct findings:

1. **Confirms and substantially quantifies #69.** `ff` trips at
   115.0–121.0 °C and `sf` at 95.0–101.0 °C — both process corners fall
   below the spec's own 125 °C operating ceiling at **every** supply corner
   tested, more severe than #69's single confirmed `.op` point (`ff`/125 °C/
   3.30 V) suggested. `tt` (135.0 °C), `ss` (145.0–149.0 °C) and `fs`
   (165.0–167.0 °C) all trip comfortably above 125 °C — `fs` in fact trips
   *above* the 150 °C nominal target. Still #69's job to fix, not re-scoped
   here.
2. **New finding, filed as #77: measured hysteresis is non-positive at every
   one of the 15 corners.** DR-005's Decision requires `reset_temp_c` to sit
   *below* `trip_temp_c` (auto-restart only after cooling further than the
   trip point). The data shows the opposite or a wash at every corner tested
   — `reset_temp_c ≥ trip_temp_c` at 10/15, exactly `0 °C` measured
   hysteresis at the remaining 5. See DR-005's `2026-08-25 addendum` and #77
   for the full writeup; not fixed by this issue.

### #77: thermal-shutdown hysteresis root-caused — a marginal regenerative loop gain, not a simple sign error (investigated, not shipped, 2026-08-25)

**Status: investigated, not shipped.** #77 set out to determine whether the
non-positive hysteresis the `#66` section above measured at every one of 15
corners is a real circuit-sizing defect or a DC-continuation
measurement-methodology artifact, and to fix it if a real defect was found.
**Answer: both, and neither cleanly** — a genuine but *marginal*
(corner-dependent) regenerative loop gain around `M_TSHYS`'s current
injection into `TS_REF`, which the default measurement technique also
mismeasures. `ldo_3v3in_1v8out.sch` is **unchanged** by this issue — this
section is the record of what was found and tried, per this repo's
"verification is the product" discipline, the same shape as the
"Bias-generator redesign investigated, reverted (#70)" section above.
Follow-on work continues in **#91**, seeded with this section's data.

**Diagnostic 1 — a nodeset-forced bistability probe proves a real (if
narrow) hysteresis window exists at `tt_27c_3.30v`, and that the default
sweep loses it.** At `T=134°C` — one 2°C grid step below the vanilla `.dc
temp` sweep's measured 0°C-hysteresis crossing (135°C) — an independent
`.op` seeded with a `.nodeset` biasing every hysteresis-path node toward the
*tripped* state converges to a genuine, self-consistent tripped solution:
`V(TS_REF)`≈1.065V (matching this same corner's naturally-tripped value at
`T=136°C`, ≈1.064V, and matching the schematic's own "raising the reference
by tens of mV" design-intent comment above — the boost mechanism does
exactly what it was designed to do), `V(TS_CMP)`≈0.48V (tripped),
`V(VOUT)`≈0 (collapsed). The default sweep's Newton continuation — despite
starting from the immediately-prior tripped point at 136°C — does not track
this branch, reconverging to the untripped branch at the very next 2°C step
instead. Re-running with `.options gminsteps=1` (reducing ngspice's default
gmin-stepping homotopy fallback — the same option the `#71`/`#81` section
above already found disrupts DC continuation on this schematic for an
unrelated bistability question) surfaces the real branch: measured
hysteresis flips from 0°C to a small, correctly-signed **+2°C**
(`trip_temp_c=133°C`, `reset_temp_c=131°C`) at this one corner.

**Diagnostic 2 — a fine-grid re-sweep at the worst-offending corner shows no
clean crossing exists at all.** `ss_27c_2.97v` (screening-reproduced against
current `HEAD`: `trip_temp_c≈147°C`, `reset_temp_c≈157°C`,
`hysteresis_c≈−10°C` — a couple of degrees off the
`20260825-054043-6fac47d` record's `149°C`/`157°C`/`−8°C` for this corner,
plausibly that record's own noted "working tree dirty at run time" rather
than a schematic difference; `git log 6fac47d..HEAD --
design/ldo_3v3in_1v8out.sch` returns no commits) does **not** show a clean
single crossing in either sweep direction even at a 0.25°C grid: `V(VOUT)`
flickers erratically between the tripped (~0V) and untripped (~1.8V) states
across a ~12°C-wide band (144–156°C on the ascending leg), including at
least one spurious intermediate operating point (~2.98V — matching neither
the regulated nor the tripped state), which a converged DC solve should not
produce. `.options gminsteps=1` does **not** resolve this corner (hysteresis
stays ≈−10°C) — unlike `tt_27c_3.30v`, this corner's loop gain is apparently
close enough to unity that the algebraic DC system has no single
well-defined answer over a wide band, not merely a narrow window the default
methodology loses track of.

**Interpretation: one root cause, two failure signatures.** A marginal,
corner-dependent regenerative loop gain explains both patterns the `#66`
section's table shows: the exact-`0°C` corners (`tt_27c_3.63v`,
`ss_27c_3.30v`, all three `fs` corners) most plausibly have a narrow, real,
correctly-signed window the default continuation-plus-gmin-stepping
methodology loses (as demonstrated for `tt_27c_3.30v` above); the strongly
negative corners (`ss`, `ff`, `sf` at several supplies) most plausibly sit in
a genuinely marginal/flickering regime where no single crossing is
well-defined and the first-crossing `.meas` reports whichever branch the
solver's exact numerical path happens to land on.

**Hardening attempted at `ss_27c_2.97v`, none shippable:**

- Scaling `M_TSHYSB`'s injected current 2×/3×/4×/13×/20×/30× the baseline
  width (`W=1.5, L=2`): none produced a clean, well-separated,
  correctly-signed trip/reset pair. Because `M_TSHYS`'s pre-trip "off"
  conduction is not exactly zero — the comparator's own finite gain lets
  `TS_CMP` droop gradually as the die approaches the crossing, so
  `Vsg(M_TSHYS)` is not exactly 0 pre-trip — a larger `M_TSHYSB` also couples
  progressively more current into `TS_REF`'s *pre-trip baseline*, dragging
  the entire transition colder as the boost grows (trip fell from ≈147°C at
  baseline to ≈95–97°C at the largest boosts tried). At those magnitudes
  this pushes the trip point well below the already-open #69 floor
  violation — worsening that finding rather than fixing this one
  independently.
- Strengthening the comparator's own gain instead (4× `M_TCTAIL`'s tail
  current, `W=1→4`, injection current unchanged): reduced but did not
  eliminate the sign inversion (−10°C → −4°C) without the trip-point
  collapse the injection-current approach caused — directionally the more
  promising of the two single-knob attempts on its own. Combining it with
  even a modest (2×, `W=1.5→3`) injection increase made the result *worse*
  (−12°C), evidence this is a multi-parameter loop-gain problem, not a
  single-knob fix reachable by trial-and-error sizing within this issue's
  own screening budget.

**Net effect.** Per `CLAUDE.md`'s "a row that proves unmeetable is
superseded by a new decision record, never silently loosened" discipline, no
ratified row or DR-005 Decision text is touched — DR-005's own `2026-08-25`
addendum (second one) records the same finding formally. This needs a
genuine large-signal loop-gain redesign of the trip-comparator/hysteresis
cluster (most plausibly a real regenerative latch/Schmitt-style element,
rather than a linear current injected into a diode-connected reference node
whose own DC operating point that same injection perturbs) — **#91** carries
the investigation forward with this section's data as its starting point.
**No new `sim/thermal` record was minted**: neither the testbench deck nor
the circuit changed, so a fresh 15-point run against the identical schematic
and PDK pin would reproduce the same numbers, not add verification value
(the same "no purely-redundant record" reasoning the `#71`/`#81` section
above already applied to `dropout-vs-load`) — `20260825-054043-6fac47d`
remains the authoritative record, and
`measurements/build_characterization_report.py --check` still passes
against it unchanged. **#69 unaffected**: none of the hardening attempts
above were shipped, so #69's own (still-open) `ff`/`sf` nuisance-trip
finding is neither worsened nor improved by this issue landing.

#### What the #69 re-run changed (2026-08-25): mechanism 1 closed, campaign re-run

Issue #69 re-sized the thermal shutdown (see "Sizing the trip: what is a
knob and what is not" above) and re-ran **every** experiment that
instantiates this schematic, because changing the shared DUT invalidates all
of their netlist snapshots at once. New append-only records, all pinned to
`4cb27f8`, each carrying a `Supersedes` pointer at the record it replaces:

| Experiment | Superseded record | New record | Verdict |
|---|---|---|---|
| `dropout-vs-load` | `20260818-032811-81dc232` | `20260825-081240-4cb27f8` | 0/45 → **0/45** PASS |
| `load-transient` | `20260818-032755-81dc232` | `20260825-081255-4cb27f8` | 23/45 → **25/45** PASS |
| `loop-gain` | `20260818-032819-81dc232` | `20260825-081257-4cb27f8` | 3/45 → **7/45** PASS |
| `psrr-dc` | `20260818-032803-81dc232` | `20260825-082845-4cb27f8` | 6/45 → **0/45** PASS (see below — this is a *correction*, not a regression) |
| `current-limit` | `20260825-045313-703a889` | `20260825-082847-4cb27f8` | 2/3 → **3/3 PASS, overall PASS** (3-point subset) |
| `startup` | `20260825-044139-703a889` | `20260825-082906-4cb27f8` | 3/3 → 3/3 PASS (3-point subset) |
| `enable-shutdown` | `20260825-044140-703a889` | `20260825-082908-4cb27f8` | 3/3 → 3/3 PASS (3-point subset) |
| `mc-output-accuracy` | `20260818-032827-81dc232` | `20260825-083111-4cb27f8` | 181/200 → 177/200 samples PASS, overall still FAIL |

**Every non-physical number mechanism 1 was blamed for is gone.** Not one of
the six `ff`/`sf`-at-125°C corners produces an out-of-range value in any of
the three campaigns any more:

| Quantity | Before (#60's evidence) | After (#69's re-run) |
|---|---|---|
| `dropout-vs-load` `dropout_v`, 45-corner range | 0.365 … **32.59 V** | 0.365 … **1.548 V** (no corner above 2 V; was 3) |
| `dropout-vs-load` `vout_at_max_vin_v`, negative values | **−19.2 V, −20.4 V, −29.0 V ×3** | **none** — every corner is now positive and physical |
| `load-transient` `undershoot_v`, 45-corner range | 0.102 … **22.29 V** | 0.102 … **0.393 V** (no corner above 1 V; was 6) |
| `loop-gain` measurements returning `n/a` | 6–9 corners per measurement | **0** |
| `loop-gain` `dcgain_c033_50ma_db`, 45-corner range | **−349.7** … 61.72 dB | **56.33 … 61.72 dB** |
| `loop-gain` `pm_c033_50ma_deg` failures | 6/45 (all the degenerate corners) | **0/45** |
| `current-limit` at `ff`/125°C/3.63 V | output collapsed to ~2 µV, ~0 mA of limit current, **FAIL** | regulates at **1.7977 V**, 148 mA short-circuit level, **PASS** |

**Three results in that table need reading carefully rather than
celebrating.**

- **`psrr-dc` went from 6/45 to 0/45 PASS, and that is the report becoming
  *more* accurate.** All six of the old "passes" (76–105 dB at 1 kHz) were
  the falsely-tripped corners — AC gain measured around a collapsed,
  non-regulating bias point, which #60 already flagged as not-real PSRR
  ("on the evidence available, PSRR does not actually pass anywhere"). With
  the trip gone those corners return honest numbers and the whole 1 kHz
  column collapses to **20.31–25.68 dB** (was 20.31–76.79 dB) against the
  50 dB ratified bound. #60's inference is now a measurement. Mechanism 5
  (#70) is untouched and unchanged by this fix.
- **`load-transient` gained four corners and lost two.** The two that
  regressed (`ff_27c_3.30v`, `ff_27c_3.63v`) did not get a worse transient
  — they moved onto the anomalous DC branch mechanism (4) describes. That
  branch is identifiable in the data: it is exactly the set of corners
  reporting `overshoot_v ≈ 0`, and it **shrank from 9/45 corners to 4/45**.
  Within the healthy branch every corner now measures `undershoot_v ≤
  0.268 V`; before, the same branch spanned up to 22.29 V. So the net
  movement is a smaller anomalous set and a strictly smaller spread, with
  two corners' membership reshuffled — a mechanism-(4)/#71 effect, not a
  transient regression.
- **`mc-output-accuracy` moved slightly the wrong way (181 → 177 of 200
  samples) and that is expected to be noise, not signal.** Its single
  sampled point is `tt`/27°C/1 mA, where the thermal clamp never tripped
  under any sizing, so #69 cannot help it; changing the DUT simply
  reshuffles which mismatch draws land on mechanism (4)'s non-regulating
  branch. The distribution actually tightened (stddev 2.154 → 1.544 V, worst
  outlier −19.3 → −18.8 V) while the individual-sample count moved the other
  way. Mechanism 6 still closes with #70/#71, not here.

**What is still open after #69.** Mechanisms 2, 4, 5 and 6 above are
untouched by this fix: `psrr-dc` is now honestly 0/45 (#70/#79),
`loop-gain`'s light-load `pm_c033_0ma` column still fails 36/45 (#70/#79),
`mc-output-accuracy`'s tail still fails its sigma window, and mechanism 4's
125 °C non-regulating equilibrium — root-caused above as a genuine circuit
robustness gap, with its fix deferred to **#79** — is untouched too and is
what moves two `load-transient` corners in the table above. Mechanism 3 is
no longer open: #71/#83 fixed `dropout-vs-load`'s `dropout_v` methodology
while this branch was in flight (see the "#71/#81 resolved" section above),
though the row is still `FAIL` — 0/45 before and after, on either method.
**The one ratified row #69 does move all the way is Current limit**, whose
only failing corner was this nuisance trip read through a resistive load.

Two further gaps #69 opens rather than closes, both named and neither
hidden: the layout (`layout/ldo-core`) has **not** been redrawn for the new
device sizes, so its DRC/LVS records join the already-stale PEX record in
being correctly reported `STALE` by `measurements/characterization.md`
(**issue #89** tracks the redraw and the re-run); and no Monte Carlo run of
the *trip point itself* exists, so the trip window's mismatch sensitivity is
estimated (≈2.5 °C per 10 mV of offset) rather than measured.

##### Parallel landings on `main`, and what they leave stale

#69's re-run covered every experiment that existed when its branch was cut.
Six records landed on `main` in parallel and are therefore **not** part of
the `…-4cb27f8` generation. None of them is wrong; each is simply pinned to
a tree that differs from the merged one, and the merge makes that visible
rather than papering over it:

| Landed by | Record(s) | Interaction with #69 | State after the merge |
|---|---|---|---|
| #66/#80 — `sim/thermal` ships | `20260825-054043-6fac47d` | Bench did not exist when #69 was cut; it measures the **pre-#69** CTAT pair | `STALE` at merge time. **Re-run and closed by #95** — see below. |
| #64/#73 — `line-regulation`, `load-regulation`, `iq` ship | `20260825-0405/0407/0409-6fac47d` | Benches did not exist when #69 was cut; all three instantiate the re-sized DUT | `STALE` at merge time. **Re-run and closed by #95** — see below. |
| #76/#86 — `current-limit` leg-3 cold EN ramp | `20260825-070327-d0bb614` | Revised `tb_current_limit.sch` **after** #69's re-run | #69's `…-4cb27f8` supersedes it by date but predates the bench revision, so the row reported `STALE`. Its **3/3 overall PASS** held for the pre-#86 deck only. Superseded in turn by #95's full-matrix re-run (below), which is fresh against the current deck. |
| #71/#83 — `dropout-vs-load` `dropout_v` methodology | `20260825-055423-c000414` | Rewrote the deck in `experiment.json`; touched only comments in the `.sch` | The freshness check compares schematic netlists, not decks, so `…-4cb27f8` still reads `fresh` despite being measured with the **superseded fixed-endpoint method**. Verdict is 0/45 either way; the `dropout_v` *numbers* to cite are #83's (0.310–0.554 V at −40/27 °C). Not touched by #95 — this bench's own deck did not change again, so no re-run was needed; the freshness-check blind spot itself remains open (see the "Two things that are not re-runs" note in issue #95). |
| #77/#92 — hysteresis root-cause, nothing shipped | (no new record) | Investigated the **pre-#69** sizing; `ldo_3v3in_1v8out.sch` unchanged by it | Superseded by **#91**'s post-#69/#90 manual re-screen (below), itself now corroborated by #95's measured `sim/thermal` record. |
| #74/#94 — full 45-point matrices for the three #65 benches | `20260825-085216-64c17cb` (`current-limit`), `…-073320-64c17cb` (`startup`), `…-073259-64c17cb` (`enable-shutdown`) | Ran breadth against the **pre-#69** DUT while #69 ran freshness against the new one | `STALE` at merge time; `current-limit`'s later run had the report citing **39/45 FAIL** there, while `startup`/`enable-shutdown` kept #69's fresher 3-point rows and lost matrix breadth. **All three re-run at full 45-point breadth against the post-#69 schematic by #95 — see below and `sim/README.md` → "#74 and #69 crossed".** |

#### #95: the seven parallel-landing gaps re-run against the merged (post-#69/#90) schematic (2026-08-25)

Issue #95 re-ran every bench the table above left `STALE` (or breadth-losing)
after PR #90 merged #69 into `main`, pinning each new record to `933dfdd` —
the commit `design/ldo_3v3in_1v8out.sch` was at post-merge — and pointing it
back at the record it replaces via `Supersedes`:

| Bench | Superseded record | New record (`933dfdd`) | Corners | Verdict |
|---|---|---|---|---|
| `sim/thermal` | `20260825-054043-6fac47d` | `20260825-104426-933dfdd` | 15/15 | **FAIL**, 12/15 PASS |
| `sim/line-regulation` | `20260825-040532-6fac47d` | `20260825-104914-933dfdd` | 3/3 (subset, per #64's precedent) | **FAIL**, 1/3 PASS |
| `sim/load-regulation` | `20260825-040748-6fac47d` | `20260825-105113-933dfdd` | 3/3 (subset, per #64's precedent) | **PASS**, 3/3 |
| `sim/iq` | `20260825-040934-6fac47d` | `20260825-105157-933dfdd` | 3/3 (subset, per #64's precedent) | **PASS**, 3/3 |
| `sim/current-limit` | `20260825-085216-64c17cb` (#74's full matrix) | `20260825-105322-933dfdd` | 45/45 | **PASS**, 45/45 |
| `sim/startup` | `20260825-082906-4cb27f8` (#69's 3-point re-run, the record the merged report actually cited) | `20260825-110456-933dfdd` | 45/45 | **PASS**, 45/45 |
| `sim/enable-shutdown` | `20260825-082908-4cb27f8` (#69's 3-point re-run, the record the merged report actually cited) | `20260825-111526-933dfdd` | 45/45 | **PASS**, 45/45 |

Three findings worth stating plainly:

- **#74's diagnosed `sf_125c`/`ff_125c` failures are confirmed fixed, at
  full-matrix breadth this time.** `current-limit`, `startup` and
  `enable-shutdown` all read a clean 45/45 `PASS` against the post-#69
  schematic — the six corners #74's pre-#69 matrices failed at (attributed to
  mechanism 1, the nuisance trip #69 re-sized) now pass, closing the question
  #93 posed on pre-#69 evidence. `startup`/`enable-shutdown` also regain the
  full-matrix breadth the merge's record-selection-by-timestamp quirk had
  cost them (`sim/README.md` → "#74 and #69 crossed" documents that quirk in
  full); their `Supersedes` field points at the 3-point `…-4cb27f8` record
  the merged report was actually citing, not at #74's pre-#69 45-point one,
  since that is the record this new one directly replaces in
  `measurements/characterization.md`.
- **`sim/thermal` turns #69's `.op`-screened trip estimate, and #91's manual
  re-screen, into a measured 15-corner `sim/` record.** `ff` trips at
  147.0–157.8 °C and `sf` at 138.8–149.0 °C — both comfortably above the
  125 °C rated ceiling, matching #90's own `.op`-screened 155.1–175.0 °C
  window. It also **corroborates #91's finding on #69's re-sized hysteresis
  rather than changing it**: `trip_temp_c`/`reset_temp_c`/`hysteresis_c` at
  all 15 corners match #91's manual re-screen table to three significant
  figures (e.g. `ss_27c_2.97v`: −2.37 °C here vs. #91's −2.4 °C), so the same
  three corners (`tt_27c_3.63v`, `ss_27c_2.97v`, `ff_27c_3.63v`) still read a
  small negative hysteresis. #91's redesign-needed conclusion stands; this
  record is the first `sim/`-evidence-trail substantiation of it, so #91's
  "no new `sim/thermal` record was minted" note (its "Net effect" paragraph)
  is superseded — `20260825-054043-6fac47d` is no longer the authoritative
  `sim/thermal` record, `20260825-104426-933dfdd` is.
- **`line-regulation` moves from `FAIL` (2/3) to `FAIL` (1/3), and the
  *failing corner moved*, not just the count — worth flagging plainly rather
  than glossing over.** Pre-#69, `ff_125c_3.63v` was the sole failure
  (1005.8/1010.2 mV/V, the documented mechanism-1 thermal-false-trip
  signature) and `tt_27c_3.30v`/`ss_-40c_2.97v` both read cleanly
  (0.2–0.4 mV/V). Post-#69, `ff_125c_3.63v` now reads cleanly
  (0.500/0.422 mV/V, consistent with the resize fixing that corner as
  expected) but `tt_27c_3.30v` newly fails both legs (1739/1317 mV/V) and
  `ss_-40c_2.97v` newly fails its 50 mA leg (2477 mV/V, its 1 mA leg still
  clean at 0.217 mV/V). The magnitude (three orders over the 5 mV/V bound) is
  the same non-physical signature already associated with this schematic's
  documented DC-solution-multiplicity behavior on sequential `alter`-based
  `.op` points (mechanism 4, `sim/README.md`'s "six degenerate corners"), now
  apparently landing on a different subset of corners post-resize rather than
  a new mechanism — but that is stated as the most likely explanation, not a
  confirmed root cause; #95's scope was re-running the bench, not diagnosing
  this. Flagged here as a genuinely new PVT-boundary observation for a future
  issue to root-cause if pursued, rather than left for a reader to notice
  quietly in the raw numbers. `load-regulation` and `iq` both move
  `FAIL → PASS` and `PASS → PASS` respectively (both already-PASS at their
  PVT subset), with the same `ff_125c_3.63v` corner fixed cleanly and no
  comparable new failure appearing at the other two points.

`measurements/characterization.md` is regenerated against these seven new
records; `python3 measurements/build_characterization_report.py --check`
passes.

**#74's failures are this fix's own strongest re-run argument.** All three
of its full matrices fail at `sf_125c` on all three supplies and attribute
it to mechanism 1 — the very nuisance trip re-sized here — so those six
`ff`/`sf` 125 °C corners are, in the merged tree, *diagnosed but not
retested* at full-matrix breadth. #93 (`sf` more susceptible than `ff`
during a ramped enable) rests entirely on that pre-#69 evidence.

**The consequential one is `sim/thermal`.** It is the only bench that
measures the very circuit #69 re-sized, so its record is the direct
before-picture of this fix (`ff` 115–121 °C, `sf` 95–101 °C — both below the
125 °C ceiling) and re-running it against `4cb27f8` is what will turn #69's
`.op`-screened trip estimate into a measured 15-corner result. It is also
the only way to settle whether #69's re-size moves #77's non-positive
hysteresis, which #92 root-caused as a marginal regenerative loop gain on
the old sizing and carried forward to **#91** — #69 changes `M_TSHYSB`
(`W=1.5 → 4.5`), one of the two knobs #92's screening swept, so that
question is genuinely re-opened rather than answered here. That re-run is
follow-on work, not part of this fix: it needs the same append-only
treatment every other record here gets, and #92's own `.options gminsteps=1`
/ nodeset-seeded technique rather than a vanilla continuation sweep.

### #91: re-screened against the #69/#90-resized circuit — still marginal, one new knob tried and also unshippable (investigated, not shipped, 2026-08-25)

**Status: investigated, not shipped.** #91 picked up exactly the question
the "Parallel landings" table above left open: does #69/#90's re-size (which
changed `M_TSD1`/`M_TSD2`/`M_TSR1`/`M_TSPR`/`M_TSPS`/`M_TSHYSB` but not the
comparator itself) move #77's non-positive-hysteresis finding? **Answer:
no — the same marginal, corner-dependent regenerative loop gain persists,
essentially unchanged in character**, and a new candidate knob #77 did not
try (the comparator's own differential-pair/mirror channel length) also
fails to produce a clean, correctly-signed window at more than one corner.
`ldo_3v3in_1v8out.sch` is **unchanged** by this issue, for the same
"verification is the product, no partial fix" reason `design/README.md`'s
`#70` and `#77` sections already used.

**Re-screen of the committed (post-#90) schematic, vanilla `.dc temp`
continuation sweep (the exact `sim/thermal` methodology, `.spiceinit` as
committed), all 15 corners** (screening decks — not `sim/` evidence; the
committed netlist is unchanged since `488bd61`, so a fresh `sim/thermal` run
would reproduce these within the harness's own timeout noise):

| Corner | trip_temp_c | reset_temp_c | hysteresis_c |
|---|---|---|---|
| `tt_27c_2.97v` | 155.9 | 155.9 | 0 |
| `tt_27c_3.30v` | 150.6 | 150.6 | 0 |
| `tt_27c_3.63v` | 147.0 | 149.0 | **−2.0** |
| `ss_27c_2.97v` | 150.6 | 153.0 | **−2.4** |
| `ss_27c_3.30v` | 144.8 | 144.8 | 0 |
| `ss_27c_3.63v` | 138.9 | 138.9 | 0 |
| `ff_27c_2.97v` | 157.8 | 157.8 | 0 |
| `ff_27c_3.30v` | 156.1 | 156.1 | 0 |
| `ff_27c_3.63v` | 153.0 | 161.0 | **−8.0** |
| `sf_27c_2.97v` | 149.0 | 149.0 | 0 |
| `sf_27c_3.30v` | 144.6 | 144.6 | 0 |
| `sf_27c_3.63v` | 138.8 | 138.8 | 0 |
| `fs_27c_2.97v` | 163.0 | 163.0 | 0 |
| `fs_27c_3.30v` | 158.5 | 158.5 | 0 |
| `fs_27c_3.63v` | 153.0 | 153.0 | 0 |

12/15 corners read exactly `0°C` (same "vanilla sweep loses a real window"
signature #77's Diagnostic 1 demonstrated on the pre-#90 sizing) and 3 read
small-but-real negative values — the same two-signature pattern #77's
Interpretation paragraph already named, now reproduced on the re-sized
circuit rather than resolved by it. `ss_27c_2.97v` remains the
worst-behaved corner, as it was pre-#90.

**New candidate tried: comparator differential-pair/mirror channel length
(`M_TCN1`/`M_TCN2`/`M_TCP1`/`M_TCP2`, `L=2 → L=3`, +50%, `W` unchanged).**
Rationale: at the sub-µA bias currents this comparator runs at, the diff
pair and mirror load sit deep in weak inversion, where a simple 5T OTA's
intrinsic gain (`gm·ro`) scales roughly with channel length rather than with
bias current — the physical reason #77's tail-current scaling (which
raises `gm` and lowers `ro` together, leaving `gm·ro` close to flat) moved
the result so little. Full 15-corner re-screen of this candidate, same
methodology:

| Corner | trip_temp_c | reset_temp_c | hysteresis_c |
|---|---|---|---|
| `tt_27c_2.97v` | 154.1 | 154.1 | 0 |
| `tt_27c_3.30v` | 150.5 | 150.5 | 0 |
| `tt_27c_3.63v` | 146.7 | 146.7 | 0 |
| `ss_27c_2.97v` | 171.5 | 148.4 | **+23.1** |
| `ss_27c_3.30v` | 144.7 | 144.7 | 0 |
| `ss_27c_3.63v` | 139.0 | 139.0 | 0 |
| `ff_27c_2.97v` | 159.2 | 159.2 | 0 |
| `ff_27c_3.30v` | 157.0 | 157.0 | 0 |
| `ff_27c_3.63v` | 152.3 | 152.3 | 0 |
| `sf_27c_2.97v` | 147.8 | 147.8 | 0 |
| `sf_27c_3.30v` | 144.3 | 144.3 | 0 |
| `sf_27c_3.63v` | 138.7 | 138.7 | 0 |
| `fs_27c_2.97v` | 160.1 | 160.1 | 0 |
| `fs_27c_3.30v` | 159.0 | 159.0 | 0 |
| `fs_27c_3.63v` | 153.0 | 153.0 | 0 |

The hypothesis was directionally right — `ss_27c_2.97v` flips from a
small negative (`−2.4°C`) to a clean, well-separated, correctly-signed
`+23.1°C`, the best single-corner result either this issue or #77 produced
— but 14 of 15 corners stay exactly flat at `0°C`, unmoved. This is not a
"needs more of the same knob" situation: bracketing `L` at `ss_27c_2.97v`
(the one corner the knob visibly affects) shows the usable window is a
knife-edge, not a margin —

| `L` (`M_TCN1`/`M_TCN2`/`M_TCP1`/`M_TCP2`) | `ss_27c_2.97v` hysteresis_c |
|---|---|
| 2 (baseline) | −2.4 |
| 3 | **+23.1** (clean) |
| 4 | 0.0 (collapsed back to no-window) |
| 5, 6 | never resets across the entire 80–180 °C descending sweep — a **permanent trip**, i.e. a direct violation of DR-005's auto-restart requirement, not merely a measurement miss |

— a 50% step in `L` (2→3) fixes the corner; the next 33% step (3→4) undoes
it; the step after that (4→5) turns it into a latch. That is the same
"marginal, corner-dependent, sometimes barely-above/below-unity loop gain"
character #77 already found with the injection-current and tail-current
knobs, now demonstrated on a third, independent knob.

**Combined attempt, at a corner the length knob alone does not move.**
`tt_27c_3.30v` (flat at `0°C` with `L=3` above) with `M_TSHYSB` also widened
past #69/#90's `W=4.5`: `W=6.75` (1.5×) → still exactly `0°C`
(`146.5 °C`/`146.5 °C`); `W=9` (2×) → still exactly `0°C` (`140.6 °C`/
`140.6 °C`), and the trip point itself drags colder as `W` grows (`146.5 →
140.6 °C`) — reproducing, on the new `L=3` baseline, the same "a bigger
`M_TSHYSB` also couples more current into `TS_REF`'s pre-trip baseline"
side effect #77 already characterized. More injection current does not
rescue a corner the comparator's own gain leaves flat.

**Ruling out a measurement artifact at the flat corners.** Two checks, both
at `tt_27c_3.30v` with `L=3`:

- Fine-grid re-sweep (0.25 °C, 130–170 °C both directions, #77's Diagnostic
  2 technique): `trip_temp_c` and `reset_temp_c` agree to sub-`0.001 °C`
  precision (`151.047 °C` both directions) — not a grid-discretization
  artifact; the point is genuinely flat at this resolution.
- `.options gminsteps=1` (#77's Diagnostic 1 technique, which flipped a
  lost window to a real `+2 °C` reading on the *pre-#90* schematic at this
  same corner): **no effect** here (`0 °C` with or without it), and no
  effect either at `ss_27c_2.97v`'s already-clean `+23.1 °C` reading. Unlike
  #77's `tt_27c_3.30v` finding, this is not a case of the continuation
  solver losing a real branch a different homotopy path would find — to the
  precision these two techniques can resolve, there is no branch to lose.

**Does not worsen #69/#90's nuisance-trip finding.** Across every corner
the `L=3` candidate was screened at, `trip_temp_c` stays in `138.7–171.5 °C`
— comfortably above the 125 °C rated ceiling and close to #90's own
measured `155.1–175.0 °C` baseline window at the 14 corners the candidate
leaves otherwise unmoved. Confirming this was part of this issue's own
acceptance criteria; it is confirmed for the one candidate that reached
full-matrix screening, even though that candidate does not ship for the
reasons above.

**Net effect.** Same disposition #70 and #77 already established for this
repo's two hardest open loop-gain problems: no ratified row or DR-005 Decision
text is touched (DR-005 gains an append recording this, not an edit).
`ldo_3v3in_1v8out.sch` is unchanged. **No new `sim/thermal` record was
minted** — the committed schematic did not change, so a fresh 15-point run
would reproduce the table above rather than add verification value (the
same "no purely-redundant record" reasoning `#71`/`#81` and `#77` already
applied); `20260825-054043-6fac47d` remains the authoritative (and, per
`measurements/characterization.md`, correctly `STALE`-flagged against the
`#69`/`#90` schematic change) record. A genuine fix needs the large-signal
regenerative-latch/Schmitt-style redesign #77 already identified as the
likely shape — three independent knobs (injection current, comparator tail
current, and now comparator channel length) have each moved one corner at a
time without ever producing a margin that holds across the corner set
simultaneously, which is itself evidence *against* any remaining linear
sizing knob on this topology closing the gap. That redesign, plus a
decision on whether `sim/thermal`'s own testbench should adopt the
nodeset/`gminsteps=1` technique as standard practice (mirroring `#71`/`#83`'s
fix to `dropout-vs-load`'s methodology) so a future record measures the
real branch rather than whichever one a vanilla continuation happens to
find, is future follow-on scope — no new issue is filed by #91 itself since
the repo's existing #77-authored trail already describes the needed shape
of work; a future builder picking this up should file the redesign as a new
issue once someone is ready to spend a full circuit-design cycle on it,
rather than inheriting a third open issue number for the same
still-unsolved problem.

### Cascoded NMOS mirror screened, does not close PSRR/Stability either — verified-negative (#107, 2026-09-15)

**Status: investigated, not shipped.** At the time of this investigation
`spec/target-spec.md` was still DRAFT — issue #1 had not yet ratified it;
it did on 2026-09-18, per DR-006 — and DR-007's proposed replacement
PSRR/Stability rows are still `proposed`, not ratified. So this
investigation screened against the same `Iq < 30µA` row DR-007 and #70/#79
used, then DRAFT; ratification (DR-006, Option A: ratify unchanged) carried
that number forward, and it is now set by `DR-009` (`proposed`).
`design/ldo_3v3in_1v8out.sch` is **unchanged** by this issue — the one
candidate built and screened here did not clear the screening bar, so per
this repo's "verification is the product, no partial fix" convention
(already used by `#70`, `#77`, `#91` above) it was reverted rather than
shipped.

**What this issue picked up.** DR-007's Consequences section named a
higher-DC-gain amplifier architecture — "two-stage or cascoded gain stage"
— as the most plausible remaining fix for the ratified PSRR/Stability rows,
and explicitly scoped that investigation to a new issue rather than a
further decomposition of #70/#79's lineage. This issue is that
investigation. Two candidate classes exist; only one was rebuilt and
screened fresh, for the reasons below.

**Candidate A: full NMOS-side cascode current mirror on the OTA's output
pull-down (`M_MIR1`/`M_MIR2`) — built, netlisted, screened, does not help.**
`#70`'s own Candidate 2 (`design/README.md` §"Bias-generator redesign
investigated, reverted (#70)") had already cascoded *only* the PMOS pull-up
mirror (`M_MIRP1`/`M_MIRP2`) and measured "no material improvement and a
regression at one corner" on 1kHz PSRR. That result has a clean
explanation once you write down `EA_OUT`'s small-signal output resistance
as `R_out ≈ ro,PMOS ‖ ro,NMOS`: raising only `ro,PMOS` cannot move a
resistance that is dominated by whichever side is *smaller* — and it also
cannot matter at all if the loop's crossover is set by `Gm/(2π·C_COMP)`
(true for a Miller-dominant-pole loop, which "Compensation (sized in #25)"
above establishes this one is), because in that regime loop gain at any
fixed frequency above the dominant pole is `≈ GBW/f`, independent of DC
gain — raising `R_out` only pushes the dominant pole *down* in frequency
without moving the −20dB/decade line the crossover sits on. That is a
textbook consequence of dominant-pole (single-stage) compensation, not
specific to which side of the mirror was cascoded, but #70's Candidate 2
did not test the NMOS side, so this issue built and screened it rather than
relying on the algebra alone: convert the plain `M_MIR1`/`M_MIR2` mirror
into a standard 4-device cascode current mirror (Razavi ch.9 textbook
technique — not derived from any third party's implementation) by adding
two NMOS devices, `M_MIR1C` (cascode diode stacked on `M_MIR1`, gate=drain=
`EA_D1`, source=new internal node `N_CASN`) and `M_MIR2C` (cascode mirror
stacked on `M_MIR2`, gate=`EA_D1`, drain=`EA_OUT`, source=new internal node
`N_CASN2`), both `L=4 W=10 nf=2` matching the devices they stack on. The
PMOS pull-up (`M_MIRP1`/`M_MIRP2`) was deliberately left untouched, so the
upper output-swing ceiling issue #25 fixed (`EA_OUT` must reach near `VIN`
at light load) is not reintroduced — only the *lower* end of `EA_OUT`'s
swing (needed at heavy load) gains an extra series device.

Screening method: same convention as the "Screening checks" section above
and DR-007's own citations — single corner (`tt`, 27°C, `VIN=3.30V`), via
`sim/bin/corner-run.py <experiment> --process tt --temp 27 --supply 3.3
--no-write --subset-reason "..."` (screening only, no `sim/` record
written), against the committed harness's own `sim/loop-gain` and
`sim/psrr-dc` testbenches, matching the acceptance criteria's "screen
cheaply... before committing to a full corner run."

- **DC operating grid unaffected.** A `.op` sweep at the same nine `VIN` x
  load points "Screening checks" §1 uses (2.97/3.30/3.63V x 0/1/50mA)
  regulates at every point, `VOUT` 1.786–1.790V (vs. baseline 1.798–1.802V,
  a consistent ≈−0.6% shift, still inside the ratified ±2% row) and `EA_OUT`
  essentially unchanged from baseline at every point, including the
  light-load/high-`VIN` ceiling case (`VIN=3.63V`/0mA: `EA_OUT`=3.0726V
  candidate vs. 3.0726V baseline) — confirming the PMOS-side swing ceiling
  #25 fixed is **not** reintroduced, as intended.
- **1kHz PSRR: no material change**, exactly as the algebra above predicts
  and exactly the pattern #70's PMOS-side cascode already showed:
  `psrr_1khz_db` = **23.19dB** (candidate) vs. **23.25dB** (baseline,
  re-measured this session at the same corner) — a 0.06dB difference, noise
  not signal. `psrr_100khz_db` is likewise unchanged (33.04dB vs. 33.0dB
  baseline).
- **0mA phase margin: not merely unimproved, but unmeasurable — a
  regression, not a wash.** Baseline `pm_c033_0ma_deg` = 19.3° (matches the
  documented `sim/loop-gain` record). With the cascode candidate, the same
  `meas ac fc when lgdb=0 cross=1` statement **fails to find any 0dB
  crossing** at both 0mA sub-points (`pm_c033_0ma_deg` and `pm_c47_0ma_deg`
  both read `n/a`) — the loop gain magnitude does not cross unity anywhere
  in the swept band at the operating point the testbench's `alter`-sequence
  reaches (50mA → 1mA → 0mA, not a cold `.op`; see `sim/loop-gain/
  testbench/tb_loop_gain.sch`'s own header for why it reaches 0mA that way).
  A hand-rerun of the same deck confirms the failure is a genuine "no
  crossing found," not a harness fluke. This is evidence the candidate's
  small-signal behavior at light load is *different in kind*, not just
  degree, from baseline — not the outcome a gain-only change was expected
  to produce.
- **50mA/0.33µF corner (already-passing) regressed.** `dcgain_c033_50ma_db`
  dropped **59.51dB → 53.16dB** and `gm_c033_50ma_db` dropped **19.13dB →
  18.47dB** (`pm_c033_50ma_deg` essentially unchanged, 58.51° → 58.31°). The
  likely mechanism: at this corner `EA_OUT` sits at its lowest measured
  value (1.36–2.06V across the `VIN` range, per the DC grid above), closest
  to the new cascode device `M_MIR2C`'s own headroom limit — the classic
  cascode swing/gain tradeoff (trading output-swing headroom for output
  resistance) landing exactly where this design's headroom is already
  tightest, per DR-003's device-characterization framing. This was not
  re-derived further since the PSRR/0mA results already settle the
  screening verdict.

**Candidate A does not screen well: no PSRR improvement, a broken (not
merely unimproved) 0mA phase-margin measurement, and a regression at the
one corner that was already passing.** Per the issue's acceptance criteria
("if a candidate screens well" / "if no candidate screens well... document
the negative result"), this stops here — no full `sim/psrr-dc` /
`sim/loop-gain` / `sim/mc-output-accuracy` 45-point re-run was performed,
and `measurements/characterization.md` is unchanged. The schematic edit was
reverted; it never reached a committed state.

**Candidate B: a second gain stage — not rebuilt, on the strength of
already-verified-negative data plus this issue's own reasoning.** Issue #22
already built and screened a PMOS common-source second stage (`M_G2`:
`VIN → EA_OUT`, gate=stage-1 output) — see "Closed in #25: light-load
regulation" above. It closed the *DC-accuracy* gap (since superseded by
#25's current-mirror-OTA fix, on the same schematic this issue also leaves
untouched) but oscillated at exactly the corner this issue's own hypothesis
names as the risky one (`C_out=0.33µF`/50mA/`VIN=3.63V`: 351mV pp on
`VOUT`), and the oscillation survived every compensation remedy #22 tried
(`C_COMP`=10p and 30p, a Miller cap around stage 2, a lower-gain stage 1, a
higher stage-2 bias current) — a genuinely exhausted, not merely
under-explored, design space for that specific second-stage topology. This
issue did not spend a fresh build-and-screen cycle re-testing it, for two
reasons stated plainly rather than left implicit: (1) #22's oscillation is
a three-pole-loop compensation failure, not a sizing shortfall — the same
class of problem Candidate A's algebra above describes (a second
high-impedance node adds a pole a single Miller cap cannot place correctly
against the pass stage's own load-proportional pole), so a fresh attempt
without a materially different compensation architecture (nested Miller,
feedforward, or an RHP-zero-cancellation scheme #22 never tried) would very
likely reproduce the same failure; (2) even setting the oscillation aside,
Candidate A's own measured result — 1kHz PSRR unchanged despite a DC-gain-
raising change — demonstrates empirically, on this exact schematic's
compensation, that raising DC gain alone does not raise loop gain at 1kHz
in this dominant-pole-compensated loop. A second gain stage's DC-gain
contribution would face the identical GBW-invariance limit unless paired
with a compensation scheme that also raises crossover — which is a
materially different (and more invasive) redesign than "add a stage,"
matches DR-007's own diagnosis ("more DC gain alone... runs into the same
bandwidth wall"), and is a large enough departure that it deserves its own
issue with its own screening, not a same-session rebuild grafted onto this
one's already-answered verdict.

**Verified-negative conclusion.** Per DR-007's own diagnosis and this
issue's data, closing the ratified PSRR/Stability rows within the Iq
`< 30µA` row (set by DR-009, `proposed`) needs either raising the OTA's
`Gm` (input-pair
transconductance, i.e. more tail current — already screened by issue #25's
6x `M_TAIL` candidate, which DR-007 cites as exceeding the Iq budget by 12%
while still missing the 45° floor by 5°) or a compensation architecture
that raises crossover alongside any added gain (nested Miller, feedforward,
or similar) — not a plain cascode (screened here, no effect) and not a
second gain stage retried on the same compensation architecture #22 already
showed oscillates. No lever tested across #25, #70, #79, and this issue has
closed the PSRR gap; DR-007's recommendation to supersede the ratified
PSRR/Stability rows via #1's ratification mechanism stands unchanged by
this issue. No new decision record is filed — DR-007's Consequences section
already anticipates exactly this outcome ("Hands to design, unresolved":
this issue was that hand-off, and it comes back with a negative result, not
a topology change that would need a superseding DR). A materially different
compensation architecture, if anyone wants to pursue it, is new,
differently-shaped issue's scope — screened from a real crossover-raising
design, not a further decomposition of this issue's own two candidates.

### Stability: binding mechanism confirmed, a feedback-divider feedforward zero screened and reverted, coupling thesis tested against the other four DRAFT-turned-RATIFIED rows and not confirmed (#115, 2026-09-23)

**Status: investigated, not shipped.** `spec/target-spec.md`'s Stability row
is now **RATIFIED** (DR-006/#1) at `PM >= 45 deg, GM >= 10 dB worst corner,
0-50 mA` — this issue does not touch that row, per `CLAUDE.md`'s "never
relax a ratified spec line to make a result pass." `design/ldo_3v3in_1v8out.sch`
is **unchanged** by this issue: one new compensation-network candidate was
built, netlisted, and screened; it did not clear the bar, so per this repo's
established "verification is the product, no partial fix" convention
(`#70`, `#77`, `#91`, `#107` above) it was reverted rather than shipped.

**1. Binding mechanism — re-confirmed, not re-derived.** The record this
issue was filed against
([`sim/loop-gain/records/20260825-081257-4cb27f8.md`](../sim/loop-gain/records/20260825-081257-4cb27f8.md))
and this file's own "Compensation (sized in #25)" section and DR-007's
Context section already establish the mechanism in full, and re-reading the
raw per-corner JSON (`sim/loop-gain/records/20260825-081257-4cb27f8.json`)
confirms it rather than finding anything new:

- **It is a margin shortfall, not outright instability.** Gain margin at
  every failing corner's binding sub-metric is 68.9-72.2 dB (`gm_c033_0ma_db`)
  — tens of dB clear of the 10 dB floor. The failure is a phase-margin
  *doublet dip* (the loop's phase swings toward -160 deg while the magnitude
  is still far from crossing unity), not a magnitude/phase pair that ever
  gets close to a genuine 0 dB/-180 deg coincidence.
- **The binding sub-metric is `pm_c033_0ma_deg`/`pm_c47_0ma_deg` — the
  literal-0 mA points** — at every corner except the 125 C row. Of the 38
  FAIL corners, **36** fail on a 0 mA sub-metric (`below min 45` on
  `pm_c033_0ma_deg` and/or `pm_c47_0ma_deg`). The two exceptions are
  `ff_125c_2.97v` and `fs_125c_2.97v`, which fail *only* on the 1 mA
  sub-metric `pm_c47_1ma_deg` (44.38 deg and 44.09 deg against the 45 deg
  floor) with both of their 0 mA sub-metrics passing comfortably (59.3 deg /
  87.1 deg and 78.9 deg / 89.3 deg respectively). They do not change the
  conclusion: both sit in the 125 C row this bullet already excepts — the hot
  row where the `gm_pass` argument below predicts the 0 mA points recover —
  and both miss by under a degree, the same margin-shortfall character as the
  other 36 rather than a different failure mode. The 1 mA and 50 mA
  sub-metrics clear 45 deg almost everywhere (see DR-007's Context section
  for the exact counts: 50 mA clears at all 45 corners, 1 mA at 40/45 — and
  those 5 shortfalls are exactly the 5 `125c_2.97v` corners, two of which are
  the exceptions named here).
- **The 7 PASS corners are exactly the 7 `125 C` corners in the matrix**
  (`{tt,ff,fs}_125c_{3.30v,3.63v}` + `ss_125c_3.63v`) — temperature is what
  moves this corner from FAIL to PASS, not process or supply, because the
  pass stage's own `gm_pass = I_load/(n*V_T)` in weak inversion rises with
  `V_T` (thermal voltage) at fixed (near-zero) `I_load`, pushing the
  collapsing output pole back up in frequency enough to clear 45 deg at the
  hottest corner. This is the same physical mechanism DR-007's Context
  section and this file's "Compensation" section already name — confirmed
  again here at the full-matrix level rather than re-derived.

**2. Re-compensation attempt: a feedback-divider feedforward capacitor —
a genuinely untried lever, screened, does not close the gap either.**
Three prior decomposed campaigns already exhausted the compensation-network
and topology-change design space this issue's own scope item 2 asks about:
issue #25's `R_CZ`/`C_COMP` two-sided-optimum sweep and `M_TAIL` 2x/6x
screen (this file's "Compensation" section), #70/#79's bias-generator
redesign and preload-current candidates, and #107's NMOS-cascode and
second-gain-stage candidates (all cited above, all verified-negative). None
of them tried reshaping the *feedback path* itself. A capacitor in parallel
with `R_FB_A` (`VOUT -> FB`, the divider's top unit resistor) is a classic,
textbook (Razavi-class, non-reverse-engineered) feedforward-zero technique
that places a zero at `1/(2*pi*R_FB_A*C_FF)` in the loop's feedback factor,
independent of `Iq` — a materially different lever from anything tried
before, so this issue built and screened it rather than assuming the
compensation space was exhausted without testing it.

Screening method: same convention as the sections above — single corner
(`tt`, 27 C, `VIN=3.30V`), `sim/bin/corner-run.py sim/loop-gain --process tt
--temp 27 --supply 3.3 --no-write --subset-reason ...`, against the
committed `sim/loop-gain` testbench, sweeping `C_FF` from 10 fF-class
(effectively off) to 20 nF:

| `C_FF` | `pm_c033_0ma_deg` | `pm_c033_50ma_deg` | `pm_c033_esr500m_50ma_deg` |
|---|---|---|---|
| 0 (baseline) | 19.3 | 58.5 | 70.4 |
| 10 pF | 19.7 | 48.8 | 62.95 |
| 50 pF | 21.1 | 47.1 | 61.2 |
| 300 pF | 27.8 | 46.8 | 60.9 |
| 500 pF | 29.7 | 46.8 | 60.9 |
| **550-600 pF (peak)** | **29.7** | **46.7-46.8** | 60.8-60.9 |
| 1 nF | 27.5 | 46.7 | 60.8 |
| 5 nF | 19.7 | 46.7 | 60.8 |
| 20 nF | 17.8 | 46.7 | 60.8 |

A genuine two-sided optimum, same shape as `R_CZ`'s own table in
"Compensation (sized in #25)": `pm_c033_0ma_deg` peaks at **29.7 deg**
around `C_FF` = 550-600 pF (a real +10.4 deg gain over baseline) and falls
off on both sides — but that peak is still **15.3 deg short of the 45 deg
floor**, and it is bought by degrading the already-passing 50 mA corner from
58.5 deg to 46.7-46.8 deg (still nominally PASS at this one screened corner,
but with far less margin against the rest of the 45-point PVT grid than
baseline carries, and the ESR-ceiling sub-metric drops 70.4 -> 60.9 deg
alongside it). A combined candidate (`C_FF`=550 pF plus `R_CZ` doubled,
`L=52 -> L=104`, ~300k -> ~600k ohm) pushes `pm_c033_0ma_deg` further to
34.4 deg but **breaks** the 50 mA corner outright (`pm_c033_50ma_deg` =
25.9 deg, `pm_c033_esr500m_50ma_deg` = 40.2 deg, both below the 45 deg
floor) — trading a hard new FAIL for a softer partial improvement elsewhere,
net negative. Per this issue's own screen-before-full-run instruction and
the "if no candidate screens well, document the negative result" fallback,
this stops here: no full `sim/loop-gain` 45-point re-run was performed for
either candidate, and the schematic edits were reverted (`git checkout --`
on `design/ldo_3v3in_1v8out.sch`) rather than committed.

**Why this result is expected, not surprising, once written down
algebraically.** DR-007's own diagnosis (dominant-pole/Miller compensation
means crossover ~= `Gm/(2*pi*C_COMP)`, largely independent of the feedback
factor's own high-frequency shape) explains why a feedback-path zero moves
the picture only modestly: `C_FF` changes *where the loop's phase recovers*
near the doublet, but the doublet itself is still set by the same
`gm_pass(I_load)` collapse this file's "Compensation" section already
names, and pushing the zero low enough to meaningfully help the 0 mA case
inevitably drags it into the frequency range the 50 mA/`0.33 uF` corner's
own crossover (~174-224 kHz) needs clear of the feedback path's own
poles/zeros. Same two-sided-optimum shape, same root cause, new lever,
same outcome.

**Ratified `C_out`/ESR window: unchanged, and not itself the blocker.**
No candidate in this issue touches DR-002's ratified 0.33-4.7 uF / 0-500 mOhm
/ no-minimum-ESR window, and nothing in this screening campaign suggests the
window's numeric bounds (as opposed to the compensation network behind them)
are what is unreachable — consistent with the existing "Compensation" section's
own finding that even DR-002's own 500 mOhm ESR ceiling would place its zero
three decades above the light-load crossover and would not help either.

**Conclusion: this issue adds a fourth verified-negative data point to the
lineage DR-007 already closed (#25, #70/#79, #107), and does not surface
anything that would change DR-007's standing recommendation.** `DR-007`
(`proposed`, pending #1) already recommends superseding the RATIFIED
Stability row with a floor scoped to `I_load >= 1 mA` (no 0 mA floor) on
exactly this evidence trail; this issue's new `C_FF`/`R_CZ` data is
consistent with, not contradictory to, that recommendation, and is added
here rather than triggering a new decision record, per DR-007's own
Consequences section anticipating exactly this kind of follow-on negative
result. No spec row is touched by this issue, per `CLAUDE.md` and per the
issue's own guardrail.

**3. Full 45-point `sim/loop-gain` re-run: not performed, on purpose.**
Since no schematic change ships, a fresh 45-point run would reproduce
[`20260825-081257-4cb27f8`](../sim/loop-gain/records/20260825-081257-4cb27f8.md)
to within simulator noise — the same "not run against the committed
(unchanged) schematic since it is byte-identical to the prior baseline"
convention `#79`/`#107` used above. `measurements/characterization.md` is
unchanged; `python3 measurements/build_characterization_report.py --check`
passes against the pre-existing records.

**4. Coupling thesis — tested against the full 45-corner grid, not
confirmed.** Issue #115's own framing hypothesized that the Stability row's
7/45 pass rate is "upstream" of the Load transient (25/45), Load regulation
(34/45), Line regulation (18/45), and PSRR (0/45) rows, and asked that the
coupling be *confirmed rather than assumed*. A per-corner join of all five
current `fresh` records
([`sim/loop-gain/records/20260825-081257-4cb27f8`](../sim/loop-gain/records/20260825-081257-4cb27f8.md),
[`sim/load-transient/records/20260825-081255-4cb27f8`](../sim/load-transient/records/20260825-081255-4cb27f8.md),
[`sim/load-regulation/records/20260910-032854-6c0436d`](../sim/load-regulation/records/20260910-032854-6c0436d.md),
[`sim/line-regulation/records/20260910-030557-6c0436d`](../sim/line-regulation/records/20260910-030557-6c0436d.md),
[`sim/psrr-dc/records/20260825-082845-4cb27f8`](../sim/psrr-dc/records/20260825-082845-4cb27f8.md))
on the shared `corner_id` key gives, for the 7 corners where Stability
PASSes (all and only the 125 C corners named above):

| Downstream row | Overall PASS rate | PASS rate *at the 7 Stability-PASS corners* | Reading |
|---|---|---|---|
| Load transient | 25/45 (55.6%) | **0/7 (0%)** | **Anti-correlated.** Every one of the 7 corners where Stability passes *fails* Load transient, on the `undershoot_v` peak-excursion sub-metric (e.g. `tt_125c_3.30v`: 171.3 mV vs. the 150 mV ceiling, `phase margin` a comfortable 69.9-92.2 deg at every sub-point). Peak excursion at 125 C is not phase-margin-limited here — a different, temperature-dependent mechanism (large-signal recovery dynamics, not small-signal loop shape) is what fails this row at the corners where the loop is best-behaved. |
| Load regulation | 34/45 (75.6%) | 6/7 (85.7%) | Marginally above the base rate, but `n=7` and the base rate is already 75.6% — not a clean signal, and the one mismatch (`tt_125c_3.63v`: Stability PASS, Load regulation FAIL) shows the two are not simply tied together either. |
| Line regulation | 18/45 (40.0%) | 4/7 (57.1%) | Mildly above the base rate; `n=7` is too small to call this a confirmed effect either way. |
| PSRR | 0/45 (0%) | **0/7 (0%)** | **Uninformative for confirming coupling, but directly consistent with DR-007's independent finding that 1 kHz PSRR here is loop-gain-limited by the dominant-pole crossover, not by the specific 0 mA phase-margin-doublet mechanism** — if Stability were straightforwardly upstream of PSRR, the 7 best-behaved-loop corners would be the most likely to clear at least the easier PSRR sub-metric, and none do. |

**Conclusion: the coupling thesis is not confirmed by this data, and is
actively contradicted for the row it predicted most clearly (Load
transient).** The two rows with the clearest signal both point away from a
simple "fix the loop, the rest follows" story: Load transient is
anti-correlated with Stability at the corner level, and PSRR fails
uniformly regardless of Stability's own pass/fail state (matching DR-007's
independent loop-gain-limited diagnosis for PSRR specifically). Load and
line regulation show weak, statistically thin positive skew that a 7-corner
sample cannot distinguish from noise. **Practical consequence for the
sibling rows in #114's decomposition** (`#116` dropout, `#117` PSRR, `#118`
DC accuracy, `#119` load transient): none of them should be sequenced to
wait on a Stability fix, and a future Stability fix (if #1 ratifies a
topology change or DR-007's replacement row makes one worth attempting)
should not be assumed to move any of the four downstream rows without its
own re-verification — exactly the caution `CLAUDE.md`'s "no claim without a
testbench" discipline already asks for, now with corner-level data behind
it rather than an assumption either way.

### #117: the PSRR row's 50 mA half is now testbenched — and the 100 kHz sub-metric fails there (measured, no circuit change, 2026-09-23)

**Status: testbench corrected and re-run; `design/ldo_3v3in_1v8out.sch` is
unchanged.** Three circuit candidates aimed specifically at this row were
screened and all three were rejected on measured evidence; they are recorded
below with their numbers, per this file's "#70/#77/#91/#107" convention of
writing down verified-negative results rather than discarding them.

**What was actually wrong with the evidence, not just the circuit.**
`spec/target-spec.md`'s ratified PSRR row names **four** conditions — two
frequencies × two load points (`> 50 dB @ 1 kHz and > 20 dB @ 100 kHz, at
1 mA (light-load, binding) and at 50 mA`) — and the row's own status column
said so: *"0/45 PVT corners **at the ~1 mA point currently covered**; 50 mA
point not yet testbenched."* The v1 `sim/psrr-dc` deck measured two of the
four. Its stated reason was correct **when it was written and is now
obsolete**: the pre-#25 five-transistor amplifier had an output-swing
ceiling pinned to the reference common mode and did not hold regulation at
50 mA, so there was no valid DC operating point to linearize an AC sweep
around. Issue #25's current-mirror-OTA rebuild removed that ceiling. A
direct `.op` re-check at `tt`/27 °C/3.30 V measures **`VOUT` = 1.7980 V at a
36 Ω (50 mA) load — regulating**, so the caveat no longer holds and the deck
now sweeps both load points (`alter rload = 36`, the same single-deck /
multi-point pattern `sim/loop-gain` uses for the DR-002 window).

**Result of the corrected 45-corner run**
([`sim/psrr-dc` record `20260923-125412-d71f4b3`](../sim/psrr-dc/records/20260923-125412-d71f4b3.md),
supersedes `20260825-082845-4cb27f8`). The two 1 mA sub-metrics reproduce
the superseded record **digit-for-digit** at every corner, so the deck change
is a pure extension, not a re-measurement:

| Sub-metric | Ratified floor | Measured range, 45 corners | Verdict |
|---|---|---|---|
| `psrr_1khz_1ma_db` | > 50 dB | 20.31 dB (`fs_125c_2.97v`) – 25.68 dB (`sf_-40c_3.63v`) | **0/45** |
| `psrr_100khz_1ma_db` | > 20 dB | 31.53 dB (`fs_-40c_3.63v`) – 34.77 dB (`ss_125c_2.97v`) | **45/45 PASS** |
| `psrr_1khz_50ma_db` | > 50 dB | 20.25 dB (`fs_125c_2.97v`) – 25.70 dB (`sf_-40c_3.63v`) | **0/45** |
| `psrr_100khz_50ma_db` | > 20 dB | **13.80 dB** (`ff_-40c_2.97v`) – **16.06 dB** (`ss_125c_2.97v`) | **0/45** |

**The new fact is the last row.** The row has *two* failing sub-metrics, not
one, and they fail for different physical reasons. This also bears directly
on `DR-007`, which states of the 100 kHz sub-metric *"this sub-metric was
never the problem and the row should say so"* and recommends a replacement
floor of `≥ 28 dB` — a recommendation derived, correctly for the evidence
that existed, from the 1 mA-only data (31.53–34.77 dB). At the 50 mA point
the same sub-metric measures 13.80–16.06 dB, i.e. it misses **both** the
ratified 20 dB floor and DR-007's own proposed 28 dB floor. That is input
for whoever next revisits DR-007 through #1's ratification mechanism; it is
**not** changed here, since decision records are append-only and the
spec row is an operator gate, not a design-time knob.

**Why 1 kHz fails: measured, not inferred — it is loop gain at 1 kHz, and
nothing else.** DR-007 and #107 reached this conclusion from the
GBW-invariance algebra; this issue measured the two terms separately. Break
the loop at the feedback tap (a 1 GH series inductor from the divider tap to
`M_IN1`'s gate plus a 1 GF shunt to ground — DC path intact, AC path open)
and sweep the same stimulus at `tt`/27 °C/3.30 V, 1 mA:

| Quantity at 1 kHz | Measured |
|---|---|
| Open-loop supply→output gain (loop broken at `FB`) | **−1.12 dB** |
| Closed-loop PSRR | **23.25 dB** |
| ⇒ loop gain available at 1 kHz | **≈ 24.4 dB** |

To reach the 50 dB floor from a −1.12 dB feedthrough the loop would need
≈51 dB of gain at 1 kHz, i.e. a crossover near **355 kHz** at the *light-load*
operating point — against a measured crossover of ≈4 kHz there. That is the
"bandwidth wall" DR-007 names, now with the two terms measured individually
rather than deduced.

**The compensation trade, measured as a frontier rather than described.**
`C_COMP` is the one knob that moves 1 kHz PSRR at all. Screening convention
as elsewhere in this file: single corner (`tt`, 27 °C, `VIN = 3.30 V`),
`sim/bin/corner-run.py --no-write`, no `sim/` record minted. PSRR column:
`C_COMP` varied alone, `R_CZ` left at its shipped ≈300 kΩ. Phase-margin
columns: `R_CZ` scaled to hold `R_CZ·C_COMP` (the nulling zero, ≈3.5 kHz)
constant, so the comparison is bandwidth-vs-bandwidth and not a zero
displacement:

| `C_COMP` | PSRR @ 1 kHz, 1 mA | PM 0.33 µF/50 mA | PM 0.33 µF/1 mA | PM 0.33 µF/0 mA | PM 4.7 µF/50 mA | PM 4.7 µF/1 mA | PM 4.7 µF/0 mA | PM 500 mΩ/50 mA |
|---|---|---|---|---|---|---|---|---|
| **150 pF (shipped)** | **23.25 dB** | 58.5° | 90.0° | **19.3°** | 90.4° | 50.8° | 52.0° | 70.4° |
| 50 pF | 32.43 dB | **22.6°** | 50.3° | **31.7°** | 57.7° | 62.2° | 71.9° | **34.5°** |
| 15 pF | 42.71 dB | **10.8°** | **18.0°** | 49.4° | **22.4°** | 51.3° | 83.5° | **22.1°** |
| ≈0 (1 fF, bound only) | 69.09 dB | — | — | — | — | — | — | — |

(Bold = below the ratified 45° floor. The 1 fF row is a bandwidth ceiling
probe, not a candidate.)

The PSRR column is a clean **+20 dB per decade of `C_COMP` reduction**, which
is what a Miller-dominant-pole loop must give. Extrapolating it, the 50 dB
floor needs `C_COMP ≈ 7 pF` — more than a decade below the point at which
the 0.33 µF/50 mA corner has already fallen to ≈11°. The two ratified rows
are therefore not merely *hard* to satisfy together on this topology: they
are on **opposite sides of a single monotone knob**, with no overlap
anywhere along it. Note also that reducing `C_COMP` *helps* the 0 mA
stability corner (19.3° → 31.7° → 49.4°) — the currently-failing stability
sub-metric — while destroying the 50 mA one, which is why "just recompensate"
does not resolve either row.

**Three candidates aimed at the newly-exposed 100 kHz/50 mA failure —
screened, all rejected.** Unlike the 1 kHz half, the 100 kHz half *is*
supply-feedthrough-limited (`gm_pass · v_sg · Z_out`, plus the pass device's
own `ro` divider), so it is attackable without more loop bandwidth. It was
attacked, and the attacks cost stability:

1. **Gate-ripple feedforward cap `C_PSR` (`VIN → EA_OUT`)** — a textbook
   `C_gs`-boost that makes the pass gate follow its own source at high
   frequency, so `v_sg → 0`. It works, and by a lot: 100 kHz/50 mA PSRR
   **14.80 → 24.50 dB** at 20 pF and **→ 31.45 dB** at 50 pF, clearing the
   20 dB floor, with 1 kHz untouched (23.25 → 23.18 dB) exactly as the
   loop-gain diagnosis predicts. But the cap is a real load on the
   high-impedance `EA_OUT` node, and the loop-gain deck says so: at 20 pF,
   PM at 0.33 µF/50 mA falls **58.5° → 36.1°**, at the 500 mΩ ESR ceiling
   **70.4° → 41.6°**, and at 4.7 µF/1 mA **50.8° → 43.3°** — three
   currently-*passing* stability sub-metrics converted to failures to fix
   one PSRR sub-metric. It also deepens the (unspecified) mid-band notch,
   9.32 dB at ≈40 kHz vs. 13.84 dB baseline. Not shipped.
2. **Longer pass device at constant `W/L`** (so dropout is unchanged) —
   raises `ro,pass` and hence lowers the `VIN → VOUT` conductive divider.
   `L = 0.5 → 1 µm`, `W_total = 2.5 → 5 mm`: 100 kHz/50 mA **14.80 →
   18.44 dB**, still short of the 20 dB floor, and PM at 0.33 µF/50 mA falls
   **58.5° → 40.6°** with the 500 mΩ point **70.4° → 48.0°**. `L = 2 µm`,
   `W_total = 10 mm` does clear it (**30.93 dB**) but was ruled out on area
   before a stability screen: ≈20,000 µm² of gate area against a 0.1 mm²
   total-core row that already carries ≈75,000 µm² of `C_COMP` MIM. Not
   shipped.
3. **Output-stage output resistance** (`M_MIR1`/`M_MIR2` `L = 4 → 16`,
   `W = 10 → 40`, `W/L` held so the mirror ratio is unchanged) — 1 kHz PSRR
   **23.25 → 23.25 dB**, unchanged to four digits. This independently
   reproduces #107's cascode-mirror result by a different mechanism (plain
   channel lengthening rather than a cascode), and is further confirmation
   that DC gain is not the binding term. A companion null test — replacing
   `R_BIAS` with an ideal, supply-independent 2 µA source — likewise moved
   1 kHz PSRR by **0.01 dB** (23.25 → 23.24 dB), reproducing #79's
   bias-generator conclusion. Neither is a candidate; both are recorded as
   the controls they were.

**Conclusion, unchanged in direction from DR-007 but sharper in content.**
The 1 kHz half of the ratified PSRR row is unreachable on this topology by
any compensation setting, and the measured frontier above says by how much
(a decade and a half of `C_COMP`). The 100 kHz half is reachable at 50 mA by
feedforward or by pass-device geometry, but only at a stability or area cost
that trades a passing ratified sub-metric for a failing one — which is not a
fix. Both halves point at the same place DR-007 does: a compensation
architecture that raises crossover (buffer-driven pass gate with an
output-pole-dominant loop, nested Miller, or similar), which is a different
design, not a re-sizing of this one, and belongs to its own issue with its
own screening.

### Dropout: 0/45 → 6/45 — the pass device was under-sized, and re-sizing it is real but partial progress (#116, DR-011, 2026-09-23)

**First ratified row this campaign has moved off a whole-matrix failure, but
not to a clean pass — read the corner count, not just the headline.**
`Dropout @ 50 mA` was failing **0/45** corners (best case 365 mV against a
`< 300 mV` row) on record `20260825-081240-4cb27f8`. The re-sized device's own
full 45-corner record (`20260923-123440-d71f4b3`) goes to **6/45 PASS** (best
case 268 mV) — real, substantial, physically-coherent improvement at
`−40 °C`/`27 °C` (dropout down 60–880 mV across all five process corners
there; `ss` closes the row outright), but **not** the clean closure an earlier
draft of this section and of DR-011 claimed from a single `.op`-point screen.
That screen does not reproduce (see DR-011's own correction note) and its
"regulates to `V_in` = 2.000 V, dropout < 236 mV" number should not be cited.
125 °C corners are additionally noisy — 5 of 15 get numerically *worse*,
consistent with (and apparently worsened by the resize, not newly caused by
it) the already-documented mechanism-4 dc-solution-multiplicity fragility a
few sections below.

Issue #116 asked for the `gf180-ldo#139` check first — *is `M_PASS` built to
the width this repo's own derivation called for?* — and the answer is **yes**:
2500 µm against DR-003's ≥ 2468 µm, matching to 1 %. **The derivation was the
defect.** DR-003 finding 3 measured `R_on` in deep triode (`V_sd` = 50 mV) and
spent it at the row's own `V_sd` = 300 mV (15 % optimistic), and assumed an
ideal 0 V gate the amplifier cannot supply (`EA_OUT` floors at 0.24–0.31 V, a
further ~30 %). Compounded, the real requirement is 3709 µm, not 2468 µm — and
at the binding `sf`/125 °C corner the shipped 2500 µm device delivered only
44.0 mA at `V_sd` = 300 mV *with an ideal 0 V gate*, i.e. it missed the
ratified row at **every** gate drive — that part of the diagnosis is
device-level current-table screening (not a closed-loop `.op` point) and does
reproduce. Shipped: `M_PASS` `mult` 25 → 50 (5000 µm), `M_SENSE` `mult` 1 → 2
(0.84 µm) so the 1:5952 current-limit sense ratio is held. Full derivation,
the corrected consequences, and the rejected alternatives:
[`DR-011`](../spec/decision-records/DR-011-pass-device-resize.md); design
narrative: "[Pass-device re-size (#116/DR-011)](#pass-device-re-size-116dr-011)"
above.

**Three findings this issue produced that are *not* in the change**, recorded
so they are not re-discovered:

- **A single isolated `.op` point is not a reliable closed-loop dropout
  measurement for this circuit at this device size.** The same screening
  script, same schematic, same nominal operating point gave a healthy
  regulating answer on some runs and a non-physical (singular-matrix-flagged)
  answer on others. Always use the continuation-based `dc` sweep
  (`sim/bin/corner-run.py`'s own methodology) for a closed-loop dropout claim;
  see DR-011's correction note for the detail.

- **The amplifier's tail is collapsed at the ratified dropout test point.**
  With the 1.2 V input common mode, `EA_TAIL` pins near 2.09 V regardless of
  `VIN`, leaving `M_TAIL` **6.7 mV** of `V_sd` at `VIN` = 2.10 V. Real, but not
  this row's root cause — the 0.6 V-common-mode fix for it was built and
  measured and moves `VOUT` by 7 mV against the ~90 mV needed. See the
  "Rejected here, but real" subsection above.
- **DR-003's sizing *methodology* generalises past this block.** Any
  pass-device screen that holds the gate at 0 V and measures `R_on` in deep
  triode will over-promise by ~1.5× at a 300 mV dropout point. DR-011 states
  the amended rule.

**What this deliberately leaves open, rather than silently absorbing.** A wider
pass device moves the output pole and raises `gm_pass`, and `Stability` was
already at 7/45; `C_COMP`/`R_CZ` are **not** re-derived here and the re-size is
**not** claimed to be stability-neutral. #116's own scope note asks for the two
to be coordinated rather than landed independently — so the dropout row lands
with its own evidence and the interaction goes to a named follow-up, instead of
an unmeasured compensation re-design riding along inside a sizing fix. The
125 °C dc-sweep volatility noted above (5 of 15 points get numerically worse)
is likewise handed to a follow-up (#138) rather than root-caused here, since
it is the same loop-dynamics question #81/#79 already own. *(#169, 2026-09-25:
there is no such loop-dynamics question — #81's second equilibrium does not
exist, see "#169" below — so #138 is a `dc`-sweep initial-condition question
in `#168`'s family, not one waiting on a design change.)* Every other `sim/` bench
instantiates this DUT, so their committed netlist snapshots are stale against
it and `measurements/characterization.md` reports them `STALE` — the same
correct-by-design outcome #69's re-run produced, and a follow-up owns
re-running the campaign against the re-sized DUT. `layout/ldo-core`'s DRC/LVS
records characterize the 2500 µm device and are likewise stale by
construction.

### #118: the three DC-accuracy rows do share one mechanism — but it is not matching, loop gain or supply rejection (measured, no circuit change, 2026-09-25)

**Status: investigated and re-measured; `design/ldo_3v3in_1v8out.sch` is
unchanged, and deliberately so.** Issue #118 grouped three rows — `Output`
(Monte Carlo), `Line regulation` and `Load regulation` — on the reasoning that
"three DC-accuracy rows fail together, which is usually one mechanism rather
than three," and proposed three candidate mechanisms: device **mismatch** for
`Output`, DC **supply rejection** for `Line regulation`, and **loop gain** for
`Load regulation` ("loop-gain-bound almost by definition"). The premise is
right and all three candidates are wrong. Each row's own evidence, read
sample-by-sample and corner-by-corner instead of as an aggregate pass count,
shows the same thing: **wherever the circuit is on its intended regulating
branch, all three rows sit comfortably *inside* their ratified bounds; every
failure is a point that is not on that branch at all.** The binding mechanism
is the mechanism-4 DC-solution-multiplicity / second-stable-equilibrium family
`#60`/`#71`/`#81` already root-caused above, not an accuracy shortfall.

All three rows were re-run in full against the current (post-#116) DUT, since
the records #118 was filed against all predate that re-size and
`measurements/characterization.md` reported all three `STALE`. Each new record
supersedes the one the issue cites, and all three rows now read `fresh`:

| Row | Record #118 cites | New record | Then → now |
|---|---|---|---|
| Output | `20260825-083111-4cb27f8` | [`20260925-110312-8280915`](../sim/mc-output-accuracy/records/20260925-110312-8280915.md) | 177/200 → **185/200** |
| Line regulation | `20260910-030557-6c0436d` | [`20260925-114251-1f54ca6`](../sim/line-regulation/records/20260925-114251-1f54ca6.md) | 18/45 → **24/45** |
| Load regulation | `20260910-032854-6c0436d` | [`20260925-111601-7701e7e`](../sim/load-regulation/records/20260925-111601-7701e7e.md) | 34/45 → **37/45** |

Every row improved and every row still reports `FAIL`. The improvement is
#116's pass-device re-size, not anything this issue shipped — and the
decomposition below is why the *remaining* failures will not move for any
amount of accuracy work.

Because no candidate mechanism this issue was asked to size against turned out
to be binding, **no sizing change was made** — per this file's standing
"verification is the product, no speculative fix" convention (`#70`, `#77`,
`#91`, `#107`, `#115`). Widening the divider's unit-resistor string or the
error-amp input pair for matching, which #118's Scope asked for conditionally
("*if* nominal is centred and 23/200 samples fall outside"), is specifically
**contra-indicated** by the decomposition below and was not done.

**1. `Output` (Monte Carlo): not a spread failure, and never has been.**
`sim/bin/mc-run.py` now computes a nominal-vs-spread decomposition into every
MC record (see that function's docstring for the reading rule), so this is
stated in the evidence rather than only here. New record
[`20260925-110312-8280915`](../sim/mc-output-accuracy/records/20260925-110312-8280915.md)
supersedes [`20260825-083111-4cb27f8`](../sim/mc-output-accuracy/records/20260825-083111-4cb27f8.md)
(N=200, `tt_mm`, 27 °C, VIN=3.3 V, 1 mA, seed `20260817` — same seed contract,
so the sample sequence is the prior record's, re-run against the post-#116
DUT):

| Population | n | Reading |
|---|---|---|
| In the ratified ±2 % window | **185** | mean **1.80168 V**, stddev **8.33 mV**, full range 1.77941–1.82498 V |
| Out of window, valued | **12** | **11 of them at 3.284–3.308 V** (VOUT pinned at/just above VIN), **1 at −18.09 V** |
| Errored (no measurement) | 3 | `mc36`, `mc70`, `mc122` |

- **Nominal is centred.** The in-window mean is **+1.68 mV** from the window
  centre — **+0.093 %** of the 1.8 V target, against a ±2 % (±36 mV) window.
  There is nothing to re-centre.
- **Spread is not the constraint either.** That population's own 3σ is
  **±25.0 mV** inside a ±36 mV window; the nearer window edge is **4.12σ** from
  its mean (the far edge 4.52σ). A normal population with exactly these
  moments puts **≈22 ppm** outside the window — a **99.998 %** yield. The
  observed failure rate is **6.1 %**, four orders of magnitude larger. No
  plausible matching improvement closes a gap that matching is not opening.
- **The failures are a separate mode with an empty gap in between.** Not one
  sample of 197 lands between 1.825 V and 3.284 V. The nearest out-of-window
  sample is **174σ** past the window edge. Eleven of the twelve are VOUT sitting
  at the input rail: the pass device fully on, the loop not regulating.
- **This is a settled-transient result, not a `.op` artifact.** The bench runs
  `tran 10u 3m` and averages 2.5–3 ms, i.e. the one true state variable
  (`C_OUT`) is carried there by the circuit's own dynamics over 3 ms. That is
  exactly the strong test `#81` item 2 used to distinguish a real second stable
  equilibrium from a solver-seeding artifact — so these are real equilibria,
  now shown to be reachable at **nominal 27 °C and 1 mA** under mismatch alone,
  not only at `#81`'s 125 °C/50 mA.
- **It has been this mode in every generation, and #116 halved it.** Re-reading
  all four committed MC responses on the same axis:

  | Record | in-window n | mean | σ | out-of-window population |
  |---|---|---|---|---|
  | `20260817-235656-e500d71` | 194 | 1.8165 V | 7.33 mV | 5 at 3.28–3.31 V, **1 genuine tail miss at 1.840 V** |
  | `20260818-032827-81dc232` | 181 | 1.80039 V | 8.71 mV | 17 at 3.28–3.31 V, 2 at ≈−19 V |
  | `20260825-083111-4cb27f8` | 177 | 1.80065 V | 9.13 mV | 22 at 3.28–3.31 V, 1 at −18.8 V |
  | **`20260925-110312-8280915`** | **185** | **1.80168 V** | **8.33 mV** | **11 at 3.28–3.31 V, 1 at −18.1 V** |

  Across four generations and 800 samples, **exactly one** sample has ever
  missed the window by a genuine distribution tail (1.840 V, in the pre-#25/#36
  record). Every other miss is the rail mode. σ has never exceeded 9.2 mV, so
  the regulating population has always fit the window with >3.9σ to spare.
  #116's pass-device re-size cut the rail-mode rate from 22/200 to 11/200 —
  real, measured progress, and corroboration that the mode is about the pass
  stage's operating point rather than about matching.

**2. `Line regulation`: its own corner matrix contains a negative control, and
the measurement fails it.** `sim/line-regulation`'s testbench wires VIN to a
**fixed literal** (`VVIN VIN 0 3.3`) and only the enable pin to the corner
runner's supply (`VEN EN 0 'vsup'`); the deck then `alter vvin`s to 2.97 V and
3.63 V at every one of its four measured points. So `corners.supply_v` cannot
reach the measured quantity at all — it changes only how far above threshold a
logic-high enable sits, and it sets the DC starting point the first `.op` solve
begins from. **The three supply points inside one (process, temperature) group
must therefore return the same number.** New full-matrix record
[`20260925-114251-1f54ca6`](../sim/line-regulation/records/20260925-114251-1f54ca6.md)
(supersedes [`20260910-030557-6c0436d`](../sim/line-regulation/records/20260910-030557-6c0436d.md);
**24/45 PASS**, up from 18/45 against the pre-#116 pass device), joined on that
axis:

- **22 of 30** (group × measurement) cells vary by more than **2×** across it,
  and **21** of those by more than **10×** — e.g. `ff_125c` at 1 mA:
  **85.16 / 0.1828 / 0.5613 mV/V**; `ss_-40c` at 50 mA:
  **1519 / 2557 / 0.2817 mV/V**.
- Exactly **one** group (`ff_-40c`) is self-consistent to within 1.1× on both
  measurements, and it agrees to **four significant figures**
  (1 mA: 0.2412 / 0.2416 / 0.2417 mV/V; 50 mA: 0.2714 / 0.2793 / 0.2793 mV/V).
  That is what a well-posed measurement on a variable it does not depend on
  looks like — so the spread in the other 14 is not numerical noise, it is
  branch selection.
- **On the regulating branch the row passes with room to spare**: every
  in-bound reading is **0.017–1.62 mV/V** at 1 mA (n=34) and
  **0.093–3.14 mV/V** at 50 mA (n=29), against a **5 mV/V** ratified bound.
- The five readings that are neither clearly on-branch nor grossly off it
  (**6.7, 18.3, 31.2, 43.9, 85.2 mV/V**) all occur at **`*_125c_2.97v`** — one
  single point on the negative-control axis, at the temperature `#81` already
  identified as the fragile one. They cannot be read as a partially-degraded
  physical line-regulation number either, for the same reason the gross ones
  cannot.

A DC supply-rejection shortfall cannot be a function of a variable the
measurement does not depend on. Line regulation is not supply-rejection-bound
here; it is branch-selection-bound.

> **Resolved (2026-09-26, issues #196 / #200).** The clause above that says
> `corners.supply_v` "changes only how far above threshold a logic-high enable
> sits" named the whole mechanism without following it: because `EN` was driven
> at `'vsup'` while the deck `alter`-ed VIN to 3.63 V, that axis reached the
> measurement **through `EN`** — at the `*_2.97v` corners the high-VIN point ran
> with `EN` 0.66 V *below* VIN, and this block's shutdown clamps
> (`M_ENP`/`M_ENP2`/…) are PMOS with their sources at VIN, so their gate drive is
> `VIN − EN`. That is #187's geometry, measured there at 39 pA → 1.377 µA and
> 62 pA → 1.639 µA of clamp current against a 1.003 µA amplifier tail. The
> "branch selection" this section attributes to the DUT was therefore, for this
> bench, largely the **bench's own conventions** selecting the branch — in two
> distinct instalments, both of them harness-side. Counting the same
> (group × measurement) cells that disagree across the negative-control axis by
> more than 2×: **22 / 30** in the record this section reads
> (`20260925-114251-1f54ca6`), **15 / 30** after #172 replaced the unconstrained
> `.op` with the #171 cold-start contract (`20260926-001833-228fbc7`), and
> **0 / 30** after #196 put `EN` at the instantaneous VIN. With that convention
> the 45-corner matrix
> [`20260926-200304-35b7392`](../sim/line-regulation/records/20260926-200304-35b7392.md)
> is **45/45 PASS** at 0.2167–0.5955 mV/V (1 mA) and 0.2712–0.3682 mV/V (50 mA)
> against the 5 mV/V bound, and the negative-control axis is now **exactly**
> negative: all 15 groups agree across their three supply columns to 0.000000
> mV/V. The bullets above
> stand as the #118-era reading of the #118-era records and are not rewritten;
> this note records what they turned out to be measuring. **No design change
> follows from it** — the DUT is unchanged, and the mismatch/rail-mode findings
> in item 1 and the genuine `load-regulation` miss in item 3 are untouched.
> Full evidence: `sim/README.md` → "#196".

**3. `Load regulation`: bimodal, non-monotonic in the one axis that is real —
and exactly one genuine miss.** Unlike line regulation, this bench's
`corners.supply_v` does reach VIN (`VVIN VIN 0 'vsup'`), so the axis is
physical. New full-matrix record
[`20260925-111601-7701e7e`](../sim/load-regulation/records/20260925-111601-7701e7e.md)
(supersedes [`20260910-032854-6c0436d`](../sim/load-regulation/records/20260910-032854-6c0436d.md);
**37/45 PASS**, up from 34/45):

- **37 corners read 2.62–14.50 mV** against the **18 mV** ratified bound (1.2×
  to 6.9× inside it). **7 corners read 881 mV – 1.62 V.** Nothing lands between
  19.93 mV and 881 mV — a **44×** empty band. A loop-gain-limited DC error is a
  continuum; it does not produce an empty band a decade and a half wide.
- **The 45th corner is the interesting one.** `fs_125c_3.63v` reads
  **19.93 mV (1.107 %)** — an 11 % overshoot of the bound, and the only reading
  in the entire matrix that is a *marginal* miss rather than either clean or
  catastrophic. Its own group is monotone and physically coherent
  (`fs_125c`: **10.99 / 14.50 / 19.93 mV** rising with VIN). **This is the one
  place in all three rows where a real, loop-limited DC accuracy shortfall is
  visible**, and it is 2 mV over the bound at the single hottest, fastest-NMOS
  corner — an ordinary design-margin problem, nothing like the 8-corner failure
  count the aggregate verdict reports.
- **4 of the 5 groups that contain a gross failure are non-monotonic in VIN**:
  `ff_-40c` and `fs_-40c` fail only at the *middle* supply while both
  neighbours pass; `sf_27c` fails only at the *highest*; `tt_125c` fails at
  both ends and passes in the middle. More headroom cannot make a
  loop-gain-bound DC error worse, and no physical mechanism is non-monotonic in
  three samples. The verdict pattern is not a function of the physical axis
  either.

**Conclusion, and what it means for the three rows.** One mechanism, as #118
suspected — the non-regulating-branch family of `#60` mechanism 4 as root-caused
by `#71`/`#81`, now shown to bind all three DC-accuracy rows and, via the MC
evidence above, to be reachable under mismatch alone at nominal temperature and
light load rather than only at 125 °C/50 mA. The practical consequences:

- **Matching sizing is contra-indicated** for the `Output` row and was not
  done. Upsizing the divider string or the input pair would buy margin on the
  one axis that already has 4.1σ of it, and would move the rail-mode rate not
  at all.
- **Neither regulation row's pass count should be read as an accuracy result.**
  Both are a mixture of two populations, so the count measures how often the
  intended branch was found, not how well the loop regulates when it is. On the
  branch, `Line regulation` clears its 5 mV/V bound at **every** point measured
  (worst 3.14 mV/V), and `Load regulation` clears its 18 mV bound at every point
  but one (`fs_125c_3.63v`, 19.93 mV). **That single corner is the only real
  DC-accuracy gap in all three rows**, and it is the honest remaining target —
  a 2 mV margin problem at one hot corner, not a 34-corner failure.
- **This is consistent with, and independent of, `#115`'s coupling finding.**
  `#115` tested whether these rows move with `Stability` and could not confirm
  it (Load regulation 6/7, Line regulation 4/7 at the 7 Stability-PASS corners,
  `n=7`). This section explains *why* that join was uninformative: the rows'
  verdicts are set by branch selection, which is not what the `Stability` row
  measures. Sequencing them behind a compensation fix remains the wrong call,
  for a now-positively-identified reason rather than only a null result.
- **No ratified bound is touched**, per `CLAUDE.md`'s "spec is a gate". The
  ±2 % / <5 mV/V / <1 % rows stand exactly as ratified; this section changes
  what the failures are attributed to, not what is required.

**What this leaves open, handed to a follow-up rather than absorbed here.**
`#81` closed with the second stable equilibrium characterized at 125 °C/50 mA
and explicitly *not* fixed ("a genuine circuit robustness gap requiring a
design change"). The MC evidence above extends its reach — same failure shape,
at 27 °C, at 1 mA, triggered by mismatch alone, at a ≈6 % rate — and that
extension is invisible to `sim/startup`, which reports 45/45 PASS because it
runs nominal devices only. Closing it is a design campaign (the amplifier's
start-up/anti-latch behaviour under mismatch), not a measurement change, and is
filed as **#164** rather than attempted inside a DC-accuracy issue. #164 also
carries the harness corollary: #133 already reports `sim/iq` grading
non-physical numbers at non-regulating corners, and this decomposition shows
that is general — no bench in `sim/` currently gates its measurement on
"was the DUT regulating at this point?", so a point that is off-branch is
scored as an accuracy result in whichever direction its bound happens to face.

> **Corrected by #164 (2026-09-25) — read the next section before relying on the
> `Output` half of this one.** #164 dumped the settled node set of the twelve
> out-of-window samples and they are not circuit states: `FB` sits at ±668 V to
> 1.3e15 V *above* the `VOUT` node that is the only thing feeding it through a
> passive divider. The "settled transient, therefore a real equilibrium"
> argument above does not hold, because the `tran` inherits the suspect `.op`
> as its initial condition — 43 of those 200 draws carry `singular matrix`
> warnings at the `res_xhigh_po` instances. Given any physically realizable
> start, all 200 draws regulate. This is `#81` **item 1** (unconverged `.op`)
> reaching 27 °C/1 mA, not item 2. This section is kept as written because its
> *analysis* is what the record it cites actually says — the same convention the
> #69 record-generation note uses — but its "real equilibria at nominal 27 °C
> and 1 mA" reading is superseded. Its matching-is-contra-indicated conclusion
> and its two regulation-row decompositions are **not** affected.

**Harness note: why these two matrices still ran locally.** `sim/bin/mc-run.py`
gained a `--backend batch` passthrough for this issue, and the `Output` re-run
above executed on the remote fleet (the record names the job id and the remote
engine version). `sim/bin/corner-run.py` has no equivalent, and cannot easily
get one: both regulation benches define their figure **across several `.op`
solves within one corner**, with `alter` cards between them, and a `klt sim`
request declares exactly one `analysis` per corner with `.meas`-card
measurements scoped to it. There is no way to express either deck as a request,
so neither grid can reach any `klt sim` backend. Filed generically as
2AMLogic/klayout-tools#2482 per `CLAUDE.md`'s friction protocol; until it
closes, these two matrices run serially through `corner-run.py` (one `ngspice`
at a time, `nice -n 19`), which is what produced the records cited below.

### #164: the 27 °C/1 mA "rail mode" is the bench's operating-point seed, not a second equilibrium — `design/ldo_3v3in_1v8out.sch` is unchanged (measured, 2026-09-25)

**Status: characterized and closed with a testbench change, not a circuit
change.** Issue #164 was filed off the section above to own what #118 would not
attempt: the ≈6 % of `mc-output-accuracy` mismatch draws that settled with VOUT
at the input rail at the block's most benign operating point (27 °C, VIN 3.3 V,
1 mA), read as `#81` item 2's *second stable equilibrium* reaching a nominal
corner. Its Scope asked for an anti-latch / start-up-assist / input-stage
re-bias. **None was designed, because the characterization it asked for first
shows the mode is not an equilibrium of this circuit at all.** It is `#81`
item 1 — the solver's own unconverged operating point — reaching 27 °C/1 mA,
mistaken for item 2 because the bench's `tran` inherits that `.op` as its
initial condition, which makes "it is a settled transient" *not* the
independent evidence #118 took it for.

**1. The settled node set is not a circuit state (Scope item 1).** The MC
record `#118` cites reports only `vout_ss`, so the campaign was re-run on the
batch fleet against the *same* netlist snapshot, seed (`20260817`) and N (200),
with fourteen extra hierarchical `.meas` cards added purely to dump the settled
node set. It reproduced the record exactly — 185 pass / 12 fail / 3 error — and
the twelve are this (record
[`20260925-145526-5168438`](../sim/mc-ic-screen-a/records/20260925-145526-5168438.md),
whose `klt-responses/` twin carries all 15 measurements on all 200 samples):

| Node | The 185 regulating draws | The 12 "rail mode" draws |
|---|---|---|
| `VOUT` | 1.779–1.825 V | 3.284–3.308 V (`mc17` at −18.09 V) |
| `FB` | 1.19–1.21 V | **±668 V to ±1984 V**, and **1.34e15 V** (`mc152`) |
| `N_FBB` | 0.59–0.60 V | **±651 V to ±1974 V**, and **1.33e15 V** (`mc27`) |
| `EA_CZ` | = `EA_OUT` | ±7.6e14 V on `mc17`/`mc97` |
| `EA_OUT` | 2.37–2.39 V | 1.38–1.68 V (mid-rail) on 11 of 12; `mc17` 4.35 V |
| `SS` | 3.30 V | 3.30 V — soft-start fully released |
| `TS_CMP` | 3.30 V | 3.30 V — thermal shutdown **not** tripped |
| `CL_CMP` | 3.298 V | 0.95–2.40 V on 11 of 12 (`mc17` 3.30 V) — current limit **not** the holder |
| `AMP_ENN` | ≈2 mV | 1.7–254 mV — enable path **not** holding the amp off |

`mc17` is called out separately in three rows above because it is the one draw
whose `VOUT` went *negative* (−18.09 V) rather than to the rail: its `EA_CZ`
blew up to −7.58e14 V and its `EA_OUT`/`CL_CMP` sit at the top rail instead of
mid-rail. It is the same defect wearing a different sign — `EA_CZ` is a
`res_xhigh_po` terminal too — but it is not a "rail mode" draw, and the ranges
quoted for the mode itself are the other eleven.

Scope item 1 asked which of soft-start, the enable path, the current-limit
comparator or the amplifier's input-stage inversion holds `EA_OUT` low enough
to keep the pass device fully on. **The answer is none of them, and `EA_OUT` is
not low** — it sits mid-rail at 1.4–1.7 V, with `SS` released, `TS_CMP`
untripped, `CL_CMP` off its rail and `AMP_ENN` at ground. The input stage *is*
inverted on some draws (`mc97`: `EA_D1`/`EA_D2` = 0.21/0.94 V against 0.875/0.875 V
regulating), but that is *driven by* `FB`, not a cause of it.

**And `FB` is above `VOUT`.** `FB` is the tap of a passive three-leg
`sky130_fd_pr__res_xhigh_po` string whose only source is `VOUT`, so any
realizable state has `0 ≤ V(N_FBB) ≤ V(FB) ≤ V(VOUT) ≤ VIN`. A draw with
`VOUT = 3.285 V` and `FB = +1984 V` violates the divider's own algebra by three
orders of magnitude — the identical argument `#81` item 1 already made about its
`FB = −985.6 V` points ("a passive resistor divider cannot produce a node
voltage 400× its input"), and the reason it classified *those* as the solver's
last iterate rather than a second solution.

**2. What admits it: the poly resistor's voltco term, measured.**
`sky130_fd_pr__res_xhigh_po`'s body element is
`rbody0 · (1 − bp2 + bp2·sqrt(1 + (bq2·|v(t1,t2)|·Efac)²))` with
`bp2 = −0.1228`, `bq2 = 1.304` — a multiplier that is *non-monotone* in the
voltage across the element and crosses zero. Measured on one W=0.42 unit by DC
sweep (`ngspice-46`, `tt`, 27 °C, local single-point probe):

| V across the element | 1 V | 400 V | 1200 V | 1300 V | 1400 V | 1800 V |
|---|---|---|---|---|---|---|
| Chord resistance, L=180 µm | 1.041 MΩ | 793 kΩ | 105 kΩ | 24.9 kΩ | 3.46 kΩ | 800 Ω |

A 1300× collapse, asymptoting onto the two 107 Ω head resistors. The fitted
multiplier's zero crossing is at `|v|·Efac = 6.97`, i.e. **≈1.32 kV for the
L=180 µm divider legs** and **≈440 V for the L=52 µm `R_CZ`** — both ~400×
outside anything the model was fitted over. Probing the divider's internal body
nodes in the pathological state puts `XR_FB_A`'s body at
`t1 = 2.904 V → t2 = 1984.0 V`, i.e. **1981 V across it, 1.5× its zero
crossing, with 3.56 mA flowing from the low side to the high side** — an
effective `rbody` of **−556 kΩ** against its nominal +360 kΩ. The leg is acting
as a ~2 kV source pumping the `FB` node up. That is the whole mechanism.

**3. It needs no mismatch, and it is locally reproducible.** With **nominal**
devices (`tt`, no `_mm`) and a deliberately hostile
`.nodeset v(xldo.fb)=1984 v(xldo.n_fbb)=996 v(vout)=3.29 v(xldo.ea_out)=1.55`,
a plain `.op` converges to `VOUT = 3.2849 V`, `FB = 1983.6 V`,
`N_FBB = 997.5 V`, `EA_OUT = 1.591 V` — the campaign's failing draws to three
decimals — and a subsequent `tran 10u 3m` holds it flat for the full 3 ms.
**Mismatch is therefore not the trigger**; it only perturbs which branch an
unseeded Newton finds. The issue's framing ("triggered by per-instance
mismatch alone") and #118's rate arithmetic ("6 % of mismatch draws") both
describe the solver's hit rate, not a device-variation sensitivity — which is
also why #116's pass-device re-size "halved" it (22/200 → 11/200) without
touching anything causal.

**4. Neither a start-up failure nor a latch (Scope item 2).** The pair `#81`
item 2 used, run as two full 200-sample campaigns on the batch fleet plus two
more to decompose the fix — the four-variant screen. **All four have committed
record quadruplets** (`records/` + `klt-requests/` + `klt-responses/` +
`netlist-snapshots/`); every number in this table is re-derivable from them with
`jq`, and the three diagnostic variants live in their own experiment slugs for
the reason given under "Where the screen's evidence lives" below:

| # | Initial condition | Record | Verdict | `vout_ss` mean / σ | Solver diagnostics | Max abs internal node |
|---|---|---|---|---|---|---|
| A | as-committed: unconstrained `.op`, EN DC-high | [`20260925-145526-5168438`](../sim/mc-ic-screen-a/records/20260925-145526-5168438.md) | **185 / 12 fail / 3 error** | 1.78397 V / 1.4639 V | **61 warnings over 43 samples**, 3 with no measurement | **1.34e15 V** (`mc152`, `FB`) |
| B | `.op` seeded **at** regulation (`.ic v(vout)=1.8 …`) | [`20260925-145937-5168438`](../sim/mc-ic-screen-b/records/20260925-145937-5168438.md) | **200 / 0 / 0** | 1.80156 V / 8.5228 mV | none | 3.3 V |
| D | `uic` cold start, EN DC-high | [`20260925-150129-5168438`](../sim/mc-ic-screen-d/records/20260925-150129-5168438.md) | **200 / 0 / 0** | 1.80156 V / 8.5228 mV | none | 3.3 V |
| C | `uic` cold start + EN edge at 100 µs (**shipped**) | [`20260925-131502-808cece`](../sim/mc-output-accuracy/records/20260925-131502-808cece.md) | **200 / 0 / 0** | 1.80157 V / 8.5229 mV | none | 3.3 V |

The A/B/D rows' "max abs internal node" is measured, not asserted: A, B and D
each carry the same 14 hierarchical `.meas` node-dump cards on top of `vout_ss`,
so B's and D's 3.3 V is the largest magnitude *any* of the 15 measured nodes
reaches on *any* of the 200 samples (it is `TS_CMP` on `mc30`, i.e. the supply
rail — nothing internal exceeds VIN), against A's 1.34e15 V.

- **Not a latch.** B starts the loop *at* 1.8 V and all 200 draws stay there —
  including all 12 that failed in A. The loop never falls out of regulation.
- **Not a start-up failure.** D starts every node at 0 V and all 200 draws
  arrive at 1.8 V. The loop always starts.
- **There is exactly one equilibrium.** B and D are **bit-identical on all 200
  samples**; C differs from them by at most **17 µV (9.4 ppm)** on 198 of 200,
  the residual of starting 100 µs later. Three unrelated physically-realizable
  initial conditions — cold, cold-with-enable-sequencing, and seeded at the
  answer — land on the same point to 10 ppm on every draw.
- **A and B agree bit-for-bit on the 185 samples that regulated in A**, so the
  seeding changes nothing where the solve already found the branch; it only
  rescues the 15 that did not.
- **The 43 warned-about samples matter too, but they are a nearly *disjoint*
  set from the 12 — corrected 2026-09-25 against the artifacts.** A's
  `singular matrix` warnings name `xldo.fb` (5), `xldo.xr_fb_b.t2` (7) and
  `xldo.xr_cz.t1` (13) — three of the four `res_xhigh_po` instances — and with
  38 `dynamic gmin stepping` non-convergence warnings make 61 diagnostics over
  43 of 200 draws. An earlier draft of this section said "31 of which *passed*
  anyway", which was `43 − 12` arithmetic on the assumption that the 12
  out-of-window draws are a subset of the 43 warned ones. **They are not**:
  **42 of the 43 passed**, and the warned set intersects the 12 in exactly one
  draw (`mc142`). The already-committed
  [`20260925-110312-8280915`](../sim/mc-output-accuracy/records/20260925-110312-8280915.md)
  says the same thing — it always did — and variant A's record reproduces it
  sample-for-sample. So the honest reading is *stronger*, not weaker, than the
  original: the eleven rail-mode draws and the −18 V draw are states ngspice
  converged to **without complaint**, which is precisely why a settled
  transient looked like evidence of an equilibrium. B/C/D report **zero**
  diagnostics on all 200. The mode's visible 6 % sits alongside a 21.5 %
  rate of draws where the `.op` warned and still landed on the right branch —
  both symptoms of the same unconstrained solve, not one inside the other.

**Where the screen's evidence lives, and why not under
`sim/mc-output-accuracy/`.** Variants A, B and D each got their own experiment
slug — `sim/mc-ic-screen-a/`, `-b/`, `-d/` — rather than being appended to the
shipped bench's `records/`. This is not filing by preference: the `Output` row's
evidence is resolved by `measurements/build_characterization_report.py`'s
`EVIDENCE_MAP`, and `latest_sim_record()` picks the **lexicographically last**
`records/*.json` under the mapped slug. A screen variant dropped into
`sim/mc-output-accuracy/records/` would sort *after* the shipped record
`20260925-131502-808cece` (later timestamp, same-day id) and silently become the
row's evidence — regenerating `measurements/characterization.md`'s `Output` row
from variant A's deliberately-broken bench (185/12/3, `FAIL`) and breaking the
`signoff/` content-hash pin that covers it. Nothing maps a spec row to these
three slugs, the same way `sim/pdk-smoke` is harness-only rather than a spec
claim, so they are inert to that pipeline while still being ordinary, re-runnable
`mc-run.py` experiments with full provenance. Each one's `experiment.json` says
in its own `claim` that it substantiates no spec row.

Provenance of the three, checkable in one command each:

- Variant A's netlist snapshot differs from the **committed** pre-#164 snapshot
  `sim/mc-output-accuracy/netlist-snapshots/20260925-110312-8280915.spice` in
  exactly one line, the `** sch_path:` comment — so variant A demonstrably is
  the as-committed bench, not a re-drawing of it.
- Variants A and D share one testbench *file* (D's manifest points at A's), so
  their netlist snapshots are **byte-identical** (`sha256`
  `c08789a9dc87…`) and the only difference between the two records is the
  analysis card: `tran 10u 3m` vs `tran 10u 3m uic`. That is what makes "`uic`
  alone is what closes it" a measurement rather than an inference.
- Variant B's snapshot is variant A's plus the single `.ic` card (and the
  `sch_path` comment), nothing else.

**5. What shipped, and what deliberately did not.** Only the bench's
initial-condition contract: `tran 10u 3m` → `tran 10u 3m uic` in
`sim/mc-output-accuracy/experiment.json`, and `VEN` from a DC level to
`PULSE(0 'vsup' 100u 1u 1u 100 200)` in
`sim/mc-output-accuracy/testbench/tb_mc_output_accuracy.sch`. Variant D shows
**`uic` alone is what closes it** — the EN edge is house-convention alignment
with `sim/startup`, not the load-bearing half, and it is kept because "EN high
with every node at 0 V" is not itself a state of this block while "EN low with
every node at 0 V" is. `design/ldo_3v3in_1v8out.sch` is **untouched**, per this
file's standing "verification is the product, no speculative fix" convention
(`#70`, `#77`, `#91`, `#107`, `#115`, `#118`): there is no anti-latch to add to
a loop with one equilibrium, and a start-up assist would be sized against a
failure the circuit does not have. **No ratified bound was touched** — the
±2 % `Output` row stands exactly as ratified (issue #1 / DR-006); what changed
is what the bench starts from.

**6. The `Output` row's verdict flips FAIL → PASS, and that is the honest
read.** Record [`20260925-131502-808cece`](../sim/mc-output-accuracy/records/20260925-131502-808cece.md)
supersedes [`20260925-110312-8280915`](../sim/mc-output-accuracy/records/20260925-110312-8280915.md)
(same seed, same N, same DUT): **200/200 PASS**, mean 1.80157 V (+0.087 % of
the 1.8 V window centre), σ 8.52 mV, range 1.77942–1.82499 V, 3σ window
[1.7760, 1.8271] V inside [1.764, 1.836] V with **+8.86 mV** of margin. This is
the same population #118 measured and called a 99.998 %-yield distribution; it
now has no second population sitting next to it. Read with its scope intact:
**one** mismatch-enabled point (`tt_mm`, 27 °C, VIN 3.3 V, 1 mA), not a PVT
sweep, and the other eight `FAIL` rows in
`measurements/characterization.md` are untouched by this issue.

**7. What this does *not* close, and what it puts back in doubt.**

- **`#81`'s 125 °C/50 mA finding is now unverified, not refuted.** Its item 2
  reported a second equilibrium with *physical* node voltages
  (`tt` → `VOUT = 2.093 V`, `FB = 1.114 V`, `N_FBB = 1.048 V`) — a different
  shape from anything above, and its `FB`:`N_FBB` ≈ 0.94:1 against a passive
  2:1 still wants an explanation. But it was reached by a `tran … uic` whose
  `.ic` set only `v(vout)` and left every other node to the same unconstrained
  solve this section has now shown to be unreliable at a far gentler corner.
  That check should be repeated with the full node set constrained before its
  "genuine circuit robustness gap requiring a design change" conclusion is
  relied on — filed as **#169**, **not** claimed closed here. `#138` (the same
  mechanism's 125 °C severity in `dropout-vs-load`) inherits the same caveat.
  **Resolved by #169**: item 2 does not reproduce under any initial condition
  and its numbers are other nodes of the regulating state (see "#169" below),
  so `#138` is a bench question in `#168`'s family, not a design one.
- **Every other bench in `sim/` has the same exposure, and it is measurable
  today.** `line-regulation` and `load-regulation` define their figure as a
  chain of four `.op` solves with `alter` cards between them (see
  `sim/line-regulation/experiment.json` → `deck.analyses`) — no transient, no
  initial condition, pure unconstrained Newton, and the *worst* case of the
  defect rather than a milder one. All 45 committed corner logs of
  [`20260925-114251-1f54ca6`](../sim/line-regulation/records/20260925-114251-1f54ca6.md)
  carry solver warnings: 73 `singular matrix` at `xldo.ea_cz`, 28 at
  `xldo.n_fbb`, 47 at `xldo.amp_enn` — the same fingerprint, on the same
  resistor instances, at every corner. Converting those decks is a harness
  campaign, not this issue, and is filed as **#168**, which also absorbs
  `#133`'s regulation gate (`#118` already showed #133's finding is general: no
  bench in `sim/` asks "was the DUT regulating?" before grading).
- **`sim/startup` is unaffected and was not re-run.** It runs nominal devices
  through its own EN edge and reports 45/45; neither the DUT nor that bench
  changed here, so a re-run would reproduce it identically. Its 45/45 was never
  wrong — it simply cannot see a defect that lives in a *different* bench's
  `.op`.
- **The regulation matrices were not re-run either**, for the same reason: this
  issue changes one testbench's analysis card and nothing in the DUT, so a
  fresh 45-point grid against an unchanged deck and PDK pin would reproduce the
  committed numbers exactly. Per this file's standing "no purely-redundant
  append-only record" convention (`#81`, `#77`, `#107`).

**8. Reproducing any of it.** The local probes are single operating points and
run in seconds; the four campaigns are 200-sample Monte Carlo grids and go to
the batch fleet (`KLT_SIM_BACKEND=batch`) per the host rules.

```bash
source sim/bin/pdk-env.sh
# (a) the resistor's own voltco collapse -- 1 V to 1800 V across one unit
cat > /tmp/probe.spice <<'EOF'
.lib $SKY130_LIB tt
VA A 0 1
XRA A 0 0 sky130_fd_pr__res_xhigh_po W=0.42 L=180 mult=1
.control
dc VA 1200 1800 20
print v(a) v(a)/(-i(va))
quit
.endc
.end
EOF
# (b) the non-physical branch, nominal devices, no mismatch: prepend
#     .nodeset v(xldo.fb)=1984 v(xldo.n_fbb)=996 v(vout)=3.29 v(xldo.ea_out)=1.55
#     to sim/mc-output-accuracy/netlist-snapshots/20260925-110312-8280915.spice,
#     then `op` (lands on it) vs `tran 10u 3m uic` (ignores it, gives 1.8006 V).

# (c) any of the three screen variants, end to end, from committed files
#     (200-sample grids -- these go to the fleet, never hand-launched locally):
python3 sim/bin/mc-run.py sim/mc-ic-screen-a --seed 20260817 --backend batch
python3 sim/bin/mc-run.py sim/mc-ic-screen-b --seed 20260817 --backend batch
python3 sim/bin/mc-run.py sim/mc-ic-screen-d --seed 20260817 --backend batch
```

Or re-derive this section's numbers from the committed responses without
simulating anything — e.g. variant A's twelve out-of-window draws and their `FB`:

```bash
jq -r '.corners[]
       | {s: (.corner_id|split("/")|last),
          v: (.measurements[]|select(.name=="vout_ss").value),
          fb: (.measurements[]|select(.name=="fb_ss").value)}
       | select(.v != null and (.v < 1.764 or .v > 1.836))
       | [.s, .v, .fb] | @tsv' \
  sim/mc-ic-screen-a/klt-responses/20260925-145526-5168438.json

# B and D bit-identical on all 200 (prints nothing if they are):
for v in b d; do jq -S '[.corners[] | {s:(.corner_id|split("/")|last),
    v:(.measurements[]|select(.name=="vout_ss").value)}]' \
    sim/mc-ic-screen-$v/klt-responses/*.json > /tmp/$v.json; done
diff /tmp/b.json /tmp/d.json
```

**One note for whoever re-runs a Monte Carlo campaign.** A given
`monte_carlo.seed` does **not** reproduce the same per-instance draws across
`ngspice` versions: `mc0` of this exact sequence measures 1.797831 V under the
fleet's `ngspice 42` and 1.795 V under a local `ngspice-46`, a 2.5 mV
difference against a 7 µV batch-to-batch delta. The seed contract is
reproducible *given the engine*, which every record already pins in its
**Tools** and **Execution backend** lines — but draw-for-draw comparison
between a local probe and a fleet record is not valid, which is why every
campaign above ran on the fleet. Filed generically as
2AMLogic/klayout-tools#2490 per `CLAUDE.md`'s friction protocol, alongside
2AMLogic/klayout-tools#2489 for the grading half: `klt sim` scored all twelve
of variant A's non-circuit states as ordinary accuracy misses, and the 31
warned-about samples that passed as ordinary passes, because a solve's
convergence diagnostics do not reach `corners[].status`.

### #119: Load transient's recovery-time clause (added to the harness here) fails universally — the peak-excursion clause closes with a C_out fix, screened across 21 of 45 corners; a full re-verification is blocked by host instability, not by the design (2026-09-25)

**Status: a real, in-scope fix ships (testbench `C_out` only —
`design/ldo_3v3in_1v8out.sch` itself is untouched); the AC's "new full-45-corner
record superseding `20260825-081255-4cb27f8`" deliverable does not — three
independent attempts at a clean 45-point re-run were blocked by severe,
non-deterministic per-corner ngspice cost (90 s–25 min, occasionally hitting
the runner's own timeout) and, once, by an unexplained termination of the
harness process mid-run at corner 22/45, on this shared dispatch host. What
follows is real, unfabricated `sim/bin/corner-run.py` output — 21 of the 45
corners, cross-checked against the superseded record's own 8 re-verified
FAILs — presented as **screening data**, the same convention this file's own
"#115" and "R_CZ/C_FF" sections already use for a result that does not clear
the bar for a full append-only record. **#166** tracks the remaining
full-matrix re-run.**

**1. What the superseded record's 20 FAILs were actually bound by — read
directly, not inferred.** `20260825-081255-4cb27f8`'s own measurement list
is `undershoot_v`/`overshoot_v` only; `spec/target-spec.md`'s Load transient
row's *second* clause ("recover to ±1% in ≤20 µs") was never instrumented.
By construction, every one of that record's 20 FAILs is therefore bound by
`undershoot_v` (peak excursion) — `undershoot_v` fails at all 20, `overshoot_v`
co-fails at 4 of those 20 but is never the larger of the two, so it is never
independently binding. There is no ambiguity to resolve about which clause
bound the historical FAILs; the ambiguity this issue actually had to resolve
was whether a *second*, never-measured clause would also bind once
instrumented (it does — see finding 3).

**2. `C_out`/`overshoot_v` root cause: charge-limited, and addressable inside
DR-002.** `spec/decision-records/DR-002`'s ratified window is 0.33–4.7 µF /
0–500 mΩ; the superseded record's testbench sat at 1 µF (DR-002's own
recommended nominal), the low-current end of that window. Peak excursion
during the 1→50 mA step is, to first order, `ΔQ / C_out` — the charge C_out
must supply before the loop's own response brings the pass device's current
up to match the new load — so a larger in-window `C_out` reduces it
proportionally, independent of loop bandwidth. This is a testbench/board
parameter, not a core-loop change: `design/ldo_3v3in_1v8out.sch` is
byte-identical before and after this issue.

**3. The never-before-measured recovery clause — added to the harness here,
per this issue's own scope — fails universally, for two different and
*opposite* reasons, neither of which `C_out` sizing can fix.**
`sim/load-transient/experiment.json` gained three measurements: `recovery_rise_us`
(µs from the 1→50 mA edge until `v(vout)` re-enters and stays inside the ±1 %
band — implemented as `vecmax` of an arithmetic 0/1 window-and-band indicator,
not ngspice's own `<`/`>` operators, which its `.control` parser reads as I/O
redirection), `recovery_fall_us` (same, for the 50→1 mA edge), and
`settle_err_50ma_pct` (a no-bound diagnostic: steady-state 50 mA error, so a
corner that never enters the band is legible as "the DC point is outside the
window", not conflated with a slow transient). Screening 21 of the 45 corners
(`tt`/`ss`/`ff` × all 3 temperatures × all 3 supplies, `C_out` = 4.7 µF, run
via the unmodified `sim/bin/corner-run.py` pipeline, corner-run scratch
directory `20260925-115609-8280915`, superseded before completion — see
finding 5):

| Measurement | Result across the 21 screened corners | Mechanism |
|---|---|---|
| `undershoot_v` | **20/21 PASS** (0.063–0.117 V), **1/21 FAIL** (`tt_-40c_3.63v`, 0.155 V, marginal) | `C_out`-addressable (finding 2) |
| `overshoot_v` | **21/21 PASS** (0.049–0.090 V, or ≈0 V on the one anomalous-branch corner) | `C_out`-addressable |
| `recovery_rise_us` | **0/21 PASS** — 75–130 µs against the 20 µs bound (3.8×–6.5× over), rising with temperature, flat across process | **Bandwidth-bound, not `C_out`-bound** |
| `recovery_fall_us` | **0/21 PASS** — 430–796 µs (21×–40× over) | **`C_out`-bound, in the OPPOSITE direction from `undershoot_v`** |
| `settle_err_50ma_pct` (diagnostic) | −0.079 % to −0.138 %, comfortably inside ±1 % everywhere | confirms recovery FAILs are transient-speed, not DC load-regulation (sim/load-regulation, #118), failures |

**`recovery_rise_us` is bandwidth-bound, and this file's own existing
loop-gain data already explains why `C_out` cannot move it.** Under Miller
compensation the loop's own crossover is `Gm/(2π·C_COMP)` — this file's
"Compensation (sized in #25)" section already measures that crossover at
≈900 Hz at the 1 mA/4.7 µF point, giving a settling time constant on the
same order as the 76–130 µs this screen measures, and *independent of
`C_out`* by construction (my own two-`C_out`-point comparison, 1 µF vs.
4.7 µF, at two spot corners moved `recovery_rise_us` by under 2 %: 128.9 µs
→ 129.7 µs at one corner, 92.5 µs unchanged-within-noise at another — the
undershoot/overshoot at those same two points moved 30–40 % over the same
`C_out` range). This is the same "#115" anti-correlation finding restated in
the transient domain: the corners where this repo's own Stability row does
best (125 °C) are exactly the ones with the *largest* `recovery_rise_us`
here (113–130 µs, vs. 75–93 µs at −40 °C) because the mechanism is
temperature-dependent bandwidth, not the small-signal margin Stability
measures. Closing this gap needs more loop bandwidth, which DR-007/#115's
already-exhausted campaign (§"#25", §"#70", §"#107", §"#115" above) ties
directly to the `Iq < 30 µA` budget — out of a C_out-sizing issue's scope,
and not re-attempted here.

**`recovery_fall_us` is `C_out`-bound, but in the direction that makes
`undershoot_v`'s fix actively worse for it — a genuine, two-sided,
in-window tradeoff.** `M_PASS` is a single PMOS pass device (`design/
ldo_3v3in_1v8out.sch`'s header) — it can source current into `VOUT` but
cannot sink it. Once the 50→1 mA edge leaves `VOUT` overshot, the error
amplifier drives the pass gate toward off, and the *only* path that removes
the excess charge is the 1 mA light load itself: `t_fall ≈ C_out ·
(overshoot_v − 0.01·V_out) / I_light`, a floor set by `C_out` and the
ratified 1 mA light-load stimulus, independent of loop bandwidth. Direct
measurement confirms both the direction and the order of magnitude: moving
the same two spot corners from `C_out` = 1 µF to 4.7 µF raised
`recovery_fall_us` 207 µs → 766 µs and 217 µs → 789 µs (≈3.5×, close to the
4.7× capacitance ratio, exactly as the floor formula predicts) while
`undershoot_v` fell by the same ratio in the *other* direction. This is the
same two-sided-optimum shape this file's own `R_CZ` and `C_FF` compensation
tables already show for unrelated knobs (§"Compensation", §"#115" ¶2) — the
window is wide enough (`Q = 20 µs` bound; the ratified `Iq`/50 mA row) that
no point in it clears both `undershoot_v` and `recovery_fall_us` at once: at
1 µF `recovery_fall_us` is "only" 10–14× over budget but `undershoot_v`
itself already fails at most mid/high-temperature corners (the superseded
record's own 20 FAILs); at 4.7 µF `undershoot_v` clears almost everywhere
but `recovery_fall_us` is 20–40× over. Since `undershoot_v` was this issue's
literal scope (finding 1) and `recovery_fall_us` fails at *every* `C_out`
this repo has measured — including the pre-existing 1 µF point, which was
never a PASS on this clause either — moving to the window ceiling is a
strict improvement on the addressable clause and not a regression on the
unaddressable one (both ends of the window fail `recovery_fall_us`; only
the specific FAIL margin changes).

**4. The fix shipped: `C_out` 1 µF → 4.7 µF (DR-002's own ratified ceiling,
not a new number) in `sim/load-transient/testbench/tb_load_transient.sch`
only.** Of the 8 corners in the 21-corner screen that are also named FAILs
in the superseded record (`tt_27c_2.97v`, `tt_125c_{2.97,3.30,3.63}v`,
`ss_27c_2.97v`, `ss_125c_{2.97,3.30,3.63}v`), **all 8 now clear
`undershoot_v`** — e.g. `tt_27c_2.97v`: 0.268 V → 0.093 V; `ss_125c_2.97v`:
0.191 V → 0.117 V. **One corner not in the original 20 — `tt_-40c_3.63v` —
newly lands on the marginal side** (0.104 V → 0.155 V, 3 mV over the 150 mV
bound): its `overshoot_v` collapses to ≈0 and `settle_err_50ma_pct` reads
−4.3 %, the same "anomalous branch" signature (a different DC/transient
solution than its neighbors) this file's mechanism-4 discussion already
documents at other corners — a corner-specific side effect of the larger
`C_out` shifting which solution the solver lands on, not a general
regression (the other 20 screened corners all improve or are unaffected).
This is disclosed, not smoothed over: a full 45-corner run is the only way
to know whether `sf`/`fs` process corners (0 of 45 screened here) show more
of this branch-shift behavior at 4.7 µF than they did at 1 µF.

**5. Full 45-corner re-verification: attempted three times, not completed —
documented as an operational finding, not folded into a fabricated
record.** `sim/bin/corner-run.py sim/load-transient --supersedes
20260825-081255-4cb27f8` was run unmodified (same tool every other record in
this repo uses) three times against the schematic/testbench state this issue
ships:
- **Attempt 1** reached 21/45 corners with clean, consistent results (the
  table above) before the harness process itself terminated with no
  traceback, no `sim/` write (the tool only persists a record after *every*
  corner completes), and no `journalctl`/OOM-killer evidence naming the
  process — an unexplained loss on a shared host, not a bug in the deck (the
  21 corners that did complete are internally consistent to 3 significant
  figures across process/temperature).
- **Attempts 2 and 3** each hit the harness's own 1500 s per-corner timeout
  on `tt_-40c_2.97v` (`Attempt 3` additionally timed out on
  `tt_-40c_3.30v`, a corner that completed in under 2 minutes in Attempt 1)
  — the same corner ran anywhere from 90 s to 25 min across the three
  attempts with an unchanged deck, which is solver non-determinism (this
  file's own "mechanism 4" dc-solution-multiplicity discussion already
  documents exactly this kind of corner-specific fragility, previously only
  in `dc` sweeps; this issue is the first evidence it also reaches transient
  analyses) compounded by this host's own shared, variable load (`uptime`
  load average 10–37 observed across the attempts on an 8-vCPU box).
This is stated as a fact about this run, on this host, at this time — not a
claim that the design cannot be verified, or that a future run on a quieter
host would not complete cleanly. A background instance of Attempt 3 was
still in flight, past corner 2/45, when this issue's PR was opened; if it
completes, its record supersedes this section's screening numbers exactly
as `sim/README.md` prescribes. **#166** tracks bringing that formal record
home.

**6. What this issue does and does not close.** `spec/target-spec.md`'s
Load transient row is **not** touched (peak excursion and recovery bounds
are both still 150 mV / 20 µs, exactly as ratified). `DR-002`'s window is
**not** touched (`0.33–4.7 µF` unchanged; this issue's fix sits at the
ceiling the window already had). `measurements/characterization.md` is
**not** regenerated by this issue, because no new `sim/` record exists to
regenerate it from — the superseded record `20260825-081255-4cb27f8`
remains, byte-for-byte, the file's own citation, and it is still accurate
to what it claims (25/45 PASS against the two clauses it measured; it does
not claim anything about `recovery_rise_us`/`recovery_fall_us`, which did
not exist as measurements when it was written). The addressable half of the
row (peak excursion) has a real, screened, in-window fix ready to be
confirmed by a clean 45-point run; the unaddressable half
(`recovery_rise_us`, bandwidth; `recovery_fall_us`, PMOS-only-pass-device
architecture) is now — for the first time — actually measured, and both of
its failure mechanisms are root-caused to gaps this repo's own DR-007/#115
lineage already tracks, not new ones this issue discovered independently.

### #169: `#81` item 2's 125 °C/50 mA "second equilibrium" does not exist — its reported numbers are the regulating state's `EA_OUT`/`TS_SNS`/`TS_REF` (measured, 2026-09-25)

**Status: item 2 withdrawn; `design/ldo_3v3in_1v8out.sch` is unchanged.**
#164 left `#81` item 2 "unverified, not refuted" (§7 above) because the check it
rested on — a `tran … uic` whose `.ic` set only `v(vout)` — leaves every other
node to the solve #164 showed unreliable at 27 °C/1 mA. #169 re-ran it at its
own corner under four initial-condition contracts, plus #81's exact method on
#81's exact circuit as a historical control. **Neither outcome #169 anticipated
occurred.** Item 2 is not a real second equilibrium (every contract regulates),
and it is not #164's solver artifact either (every contract regulates *without
a single solver diagnostic*, #81's own included). It is a reporting error: the
three numbers #81 recorded as `VOUT`/`FB`/`N_FBB` at `tt`/`ss`/`fs` are, to
every digit #81 reported, `EA_OUT`/`TS_SNS`/`TS_REF` of the ordinary
regulating state.

**1. The screen.** One circuit per variant — `sim/dropout-vs-load`'s DUT,
`C_OUT` = 1 µF / 10 mΩ, ideal 50 mA sink, `VREF` = 1.2 V, `VIN` held at the
corner supply — varying **only** the initial condition. Each variant is its
own `corner-run.py` experiment slug, for the same reason #164's screen was
(`EVIDENCE_MAP` resolves a row's evidence from the lexicographically last
record under its slug; nothing maps to these, so none can become
`dropout-vs-load`'s `Dropout` evidence). Every variant dumps the same 14
hierarchical nodes and grades the four realizability slacks of
`0 ≤ V(N_FBB) ≤ V(FB) ≤ V(VOUT) ≤ VIN` (#169 Scope item 3) as `min = 0`
measurements, so a violation is a recorded `FAIL`, not a reading.

| Variant | Initial condition | Record | Points | Regulating | Min realizability slack | Solver diagnostics |
|---|---|---|---|---|---|---|
| V | #81's own: `.ic v(vout)=1.8` only, `uic`, EN DC-high | [`20260925-172756-6989d23`](../sim/ic-screen-125c-v/records/20260925-172756-6989d23.md) | 15 | **15/15** | +0.5993 V | none |
| F | the same `uic`, all **eleven** nodes #169 names seeded | [`20260925-172757-6989d23`](../sim/ic-screen-125c-f/records/20260925-172757-6989d23.md) | 15 | **15/15** | +0.5993 V | none |
| B | #164's variant B: the same full `.ic`, **no** `uic` (constrained `.op`, then released) | [`20260925-172757-6989d23`](../sim/ic-screen-125c-b/records/20260925-172757-6989d23.md) | 15 | **15/15** | +0.5993 V | none |
| C | cold: all-zero `uic`, EN edge at 100 µs, 50 mA ramped on at 2.5 ms | [`20260925-172757-6989d23`](../sim/ic-screen-125c-c/records/20260925-172757-6989d23.md) | 15 | **15/15** | +0.5993 V | none |
| H | V's deck exactly, on a **frozen copy of #81's DUT** (`64c17cb`) at #81's `VIN` = 3.60 V | [`20260925-173928-a30ee60`](../sim/ic-screen-125c-h/records/20260925-173928-a30ee60.md) | 5 | **4/5** (`sf` — see 4) | +0.5990 V on the four | none |

V/F/B/C's matrix is all five process corners × 125 °C × {3.30, 3.60, 3.63} V
(3.60 V is #81 item 2's own `VIN`; 2.97 V is deliberately excluded — see each
manifest's `corners_note`). The eleven-node seed for F/B is not invented: it is
variant C's own settled node set at `tt`/3.60 V from a local probe, with the
`VIN`-tracking nodes written relative to `vsup` so the seed is realizable at
every supply (`sim/ic-screen-125c-b/testbench/tb_ic_screen_125c_seeded.sch`
header). "Solver diagnostics" is the `# ==== ngspice stderr ====` section of
every committed corner log, which is where the harness captures `Warning:
singular matrix` / `gmin stepping` messages (the committed `line-regulation`
logs #164 cites carry them there): it is empty on all 65. B is the variant for
which that is load-bearing, since it is the only one that runs a full `.op`.

**2. Warm-constrained and cold agree — to the microvolt.** This is the
comparison #169's Scope item 2 named as the discriminator (#164's B and D were
bit-identical at 27 °C/1 mA). Across all 15 points and all 14 dumped nodes, the
largest difference between **any** two of V, F, B and C is **6 µV** (B against
the others, `VOUT` at `tt_125c_3.30v`); V vs C is ≤ 0.6 µV and F vs C ≤ 1 µV.
`vout_ss` spans **1.79848–1.79870 V** over all 60 runs, the settled window's
peak-to-peak is ≤ 1 µV everywhere, `FB`/`N_FBB` sit at 1.1992–1.1993 V /
0.5997–0.5998 V (the passive 2:1 exactly), and the largest magnitude any dumped
node reaches is 3.63 V — the supply. A cold start with the enable edge, a start
seeded at the answer, a start seeded at the answer and re-solved, and #81's own
start all arrive at the same point. **There is one equilibrium at
125 °C/50 mA, and #81's own method finds it.**

**3. Why #81 recorded something else: the numbers are other nodes.** The
current DUT differs from #81's (#90 re-sized the thermal shutdown, #116/DR-011
the pass device), so a negative result on it could in principle mean those
changes cured item 2. Variant H closes that door by running #81's method on
#81's circuit (the frozen copy at
`sim/ic-screen-125c-h/dut/ldo_3v3in_1v8out_at81.sch` differs from
`git show 64c17cb:design/ldo_3v3in_1v8out.sch` only by its header comment). It
too regulates at `tt`/`ss`/`fs` (`VOUT` 1.79749–1.79758 V, flat from 800 µs —
#81's own time point — to 3 ms). And its node dump contains #81's numbers:

| Corner | #81 reported "`VOUT` / `FB` / `N_FBB`" | H's settled `EA_OUT` / `TS_SNS` / `TS_REF` | H's actual `VOUT` / `FB` / `N_FBB` |
|---|---|---|---|
| `tt` | 2.093 / 1.114 / 1.048 V | 2.09267 / 1.11360 / 1.04796 V | 1.79758 / 1.19858 / 0.59938 V |
| `ss` | 2.014 / 1.191 / 1.073 V | 2.01422 / 1.19072 / 1.07259 V | 1.79749 / 1.19851 / 0.59935 V |
| `fs` | 2.199 / 1.286 / 1.100 V | 2.19873 / 1.28578 / 1.09960 V | 1.79755 / 1.19856 / 0.59937 V |

Nine of nine values agree to all four significant figures #81 quoted. #81's
deck was a local probe that was never committed, so *how* the labels were
transposed cannot be recovered from it — but #81's own text says it also read
`EA_OUT` ("mid-rail") and the `TS_SNS`/`TS_REF` ordering from the same run, so
all three quantities were in the output it was reading. The reading also
dissolves the one detail #81 could not explain: the "`FB`:`N_FBB` ≈ 0.94:1
against a passive 2:1" is `TS_SNS`:`TS_REF`, two thermal-sensor nodes with no
reason to be in any ratio. There was no divider distortion, and the
body-junction-leakage hypothesis #81 offered for it has nothing left to explain.

**4. The one violating point is mechanism 1, not item 1.** H's `sf` point is
the only one of 65 that fails the invariant: `VOUT` = −28.97 V, `FB` =
−19.29 V, `N_FBB` = −9.62 V. It is **not** #81 item 1 / #164's kilovolt
artifact, although #169's Scope rule ("any violation is item 1") would file it
there: the divider algebra *holds* (`FB`/`VOUT` = 0.666, `N_FBB`/`VOUT` =
0.332 — the passive 2/3 and 1/3), no diagnostic was emitted, and `TS_SNS`
(0.936 V) < `TS_REF` (1.050 V) with `TS_CMP` at 0.30 V and `EA_OUT` at the
rail. The pre-#90 thermal shutdown has tripped inside the rated range
(mechanism 1, `#69`, fixed by #90 — V/F/B/C's `sf` rows regulate with `TS_CMP`
at `VIN`), the pass device is off, and the testbench's *ideal* 50 mA sink pulls
the undriven output negative. The invariant's `0 ≤` link presumes a load that
cannot pull a node below ground, which an ideal current sink can. #81 checked
only `tt`/`ss`/`fs` and excluded `sf` for exactly this reason, so the point
bears on nothing #81 claimed; it is why H's record reads `Overall: FAIL`.

**5. What this changes.**

- **`#81`'s "genuine circuit robustness gap requiring a design change" is
  withdrawn.** Its item 1 (unconverged `.op`, `FB` hundreds of volts off the
  divider) stands as #164 explained it; its item 2 was never a circuit state.
  The "#81 resolved" section above is kept as written with a correction note,
  per this file's convention for superseded analyses (`#118`'s section).
- **`dropout-vs-load`'s 125 °C-wide exclusion is a bench problem, not a
  circuit one.** What remains of it is item 1 alone: the `dc` sweep's
  unconstrained, continuation-seeded `.op` at 125 °C — the exposure #164 §7
  found in every `.op`-chain bench and filed as **#168**. Nothing in this
  screen says the 125 °C `dropout_v` numbers are right; it says the reason they
  are unreadable is the harness, not the loop.
- **Sequencing re-pointed.** `#79` (closed `COMPLETED` 2026-08-25 — a
  bias-generator fix for PSRR/Stability that never ran the item-2 check #81
  recommended to it) and `#107` (closed `COMPLETED`) were not held up by item 2
  in practice, so nothing re-opens there, and #81's "Recommendation for #79" is
  moot. **`#138`** is the one open item sequenced behind it: its Ask is to
  re-check a future #79-style design fix against "the existing mechanism-4
  recipe" at 125 °C. With no second equilibrium to fix, #138 is now a
  **bench** question — does `dropout-vs-load`'s 125 °C volatility after #116's
  re-size survive a realizable initial condition? — in #168's family, and
  **not** gated on any design change. This issue does not take that up.
- **No design change, no spec change.** `design/ldo_3v3in_1v8out.sch` is
  untouched; no ratified row is touched. `DR-009` and `DR-011` mention #81
  item 2 in rationale text as a known 125 °C gap; decision records are
  superseded by new records rather than edited, and neither DR's *decision*
  rests on it, so neither is amended here.

**6. Scope, stated plainly.** Nominal devices only (no mismatch) and 125 °C
only — #81 item 2 was reported at 125 °C/50 mA with nominal devices, and #164
already covered 27 °C under mismatch. 2.97 V is not in the matrix. The load is
the ideal sink `dropout-vs-load` uses. Item 1's own 125 °C `.op` failures were
not re-run; they are #164's mechanism and #168's harness campaign.

**7. Reproducing it.** From committed files (≈2–5 min per point on a loaded
host):

```bash
for v in v f b c h; do python3 sim/bin/corner-run.py sim/ic-screen-125c-$v; done
# or, without simulating: #81's numbers inside H's own record
jq -r '.corners[] | [.corner_id] + [.measurements[]
       | select(.name|test("^(vout|ea_out|ts_sns|ts_ref)_ss$")) | "\(.name)=\(.value)"]
       | @tsv' sim/ic-screen-125c-h/records/20260925-173928-a30ee60.json
```

### #323: dropout @ 50 mA at tt / 27 C / 3.30 V — the gate-headroom hypothesis is not supported; the loop loses regulation from amplifier-headroom collapse and an early current-limit clamp, with the pass device at its saturation edge (measured, single corner, 2026-10-11)

**Scope, stated first.** One PVT point only: **tt / 27 C / VIN start 3.30 V /
50 mA ideal sink**, the existing `sim/dropout-vs-load` cold-start
`tran 10u 14m uic` with the constant 266.3 V/s downward VIN ramp and the first
falling VOUT = 1.764 V crossing after 6 ms. This is attribution, not
qualification: it says nothing about the other 44 corners and does not
re-grade the ratified `< 300 mV` row (still FAIL at this point; DR-006 target
and the `pfet_g5v0d10v5` flavor are unchanged). `design/ldo_3v3in_1v8out.sch`
is untouched. The historical 0/45 record `20260926-102849-0b63ae4` is not
used as evidence of today's mechanism.

**1. Baseline (new, append-only).** Record
[`20261011-092557-7a4e0cc`](../sim/dropout-vs-load/records/20261011-092557-7a4e0cc.md)
(`python3 sim/bin/corner-run.py sim/dropout-vs-load --process tt --temp 27
--supply 3.3 --backend local --subset-reason '...'`): source commit `7a4e0cc`
(clean tree), netlist snapshot sha256 `eac4cf44...1f883`
(`netlist-snapshots/20261011-092557-7a4e0cc.spice`), ngspice-42, xschem 3.4.4,
sky130A open_pdks `c6d73a35...`, `sim/spiceinit` sha256 `3cf811e1...`. Result:
**crossing VIN = 2.161658 V, dropout_v = 0.397658 V** (FAIL vs `< 300 mV`),
`vout_at_max_vin_v` = 1.79883 V (regulating, -0.07% from 1.8 V),
zero solver diagnostics (no singular-matrix / gmin / non-convergence lines; the
runner's "ngspice diagnostics" heading is only the FAIL log pointer), 3.3 s wall.
It reproduces the retired-`dc` record's neighbour (0.397657 V, 8 ms ramp) to
1 uV, so the DUT's tt/27C behaviour has not moved. The characterization report
now selects this record and labels the row "FAIL (PVT subset)" with its own
coverage (0/1) and freshness (fresh).

**2. Node/current evidence (baseline, instrumented copy).** The instrumented
deck (`sim/dropout-vs-load/diagnostics/issue-323/probe0.deck.spice`, extra
saves + `wrdata` only) reproduces dropout_v = 0.397658 V exactly. Hierarchical
names resolved from the fresh netlist (`xldo.xm_pass` etc.).

| quantity | settled pre-ramp (VIN 3.30 V, 5.9 ms) | VIN 2.26 V (crossing + 0.1 V) | crossing (VIN 2.162 V) |
|---|---|---|---|
| VOUT | 1.7988 V | 1.7896 V | 1.7640 V |
| EA_OUT (pass gate) | 1.939 V | 0.827 V | **0.711 V** |
| M_PASS Id / Vsg / Vds / Vdsat | 50.0 mA / 1.357 / 1.492 / 0.362 V | 50.0 mA / 1.430 / 0.463 / 0.400 V | 49.7 mA / 1.446 / **0.389** / **0.409** V |
| M_TAIL Id / Vds | 3.274 uA / 0.769 V | 0.945 uA / 0.030 V | **0.313 uA / 0.009 V** (Vdsat 0.076) |
| M_MIRP2 (output-stage pull-up) Id | 1.655 uA | 0.455 uA | 0.126 uA |
| M_MIR2 (pull-down) Id | 1.655 uA | 0.499 uA | 0.191 uA |
| M_CLIM Id (EA_OUT pull-up clamp) | 0.04 pA | 11.5 pA | **49 nA** (Vsg 0.685 V) |
| M_TSHUT Id (thermal clamp) | 0.03 pA | 0.03 pA | 0.03 pA (never active) |
| M_SENSE Id | 12.8 uA | 14.1 uA | 14.5 uA |
| CL_CMP | 3.258 V | 1.966 V | 1.476 V |

- **EA_OUT is not at a rail.** At the crossing it sits 0.71 V above ground; the
  pull-down device M_MIR2 stays saturated (Vds 0.71 V vs Vdsat 0.055 V). The
  gate still has roughly 0.7 V of downward range that the loop does not use.
- **The pass device is at the saturation/triode boundary, not gate-starved.**
  Vsg is 1.446 V, Vds 0.389 V, Vdsat 0.409 V at 50 mA (VIN - VOUT = 0.398 V;
  the ~9 mV difference is the series-resistance drop the model carries
  outside its internal Vds). Pass device Vth is 0.93 V.
- **Amplifier tail headroom collapses exactly at the crossing.** The PMOS
  input pair's tail node sits at ~Vref + |Vgs_in| = 2.15 V; M_TAIL's Vds falls
  from 0.769 V to 9 mV (below its 76 mV Vdsat) as VIN reaches 2.16 V, so tail
  current drops 10x (3.27 -> 0.31 uA) and the amplifier's gain and output-stage
  currents fall with it (M_MIRP2 1.66 -> 0.13 uA).
- **The current-limit clamp starts conducting before the crossing.** CL_CMP
  falls with VIN (1.98 V -> 1.48 V) because the sense mirror current (13-14.5 uA
  x CLN2/CLN1 ratio) wins against the bias-referred M_CLP source current,
  which itself falls with the R_BIAS-derived bias; M_CLIM's Vsg reaches 0.685 V
  and it sinks 49 nA into EA_OUT, ~4000x its 11.5 pA level 0.1 V earlier. It remains
  small in absolute terms but is comparable with the amplifier's own
  collapsing output-stage currents (0.13-0.19 uA).

**3. Diagnostic probes (two, bench copies only; same PVT/stimulus/solver as the
baseline; neither is evidence about the production DUT).** Generated by
`sim/dropout-vs-load/diagnostics/issue-323/make_probe_deck.py`; decks, logs,
gzipped `wrdata` and summaries are committed alongside. Both are identical to
the baseline until VIN < ~2.5 V.

| probe | explicit diff vs baseline deck | dropout_v | crossing VIN | EA_OUT @ crossing | M_PASS Vds / Vdsat @ crossing |
|---|---|---|---|---|---|
| baseline (probe0) | none (instrumentation only) | 0.397658 V | 2.1617 V | 0.711 V | 0.389 / 0.409 V |
| A: ideal tail | `XM_TAIL` (3-line instance) replaced by `ITAIL_IDEAL` 3.2744 uA from a separate 3.3 V rail (= the baseline's settled tail current) | **0.381108 V** (-16.6 mV) | 2.1451 V | 0.690 V | 0.372 / 0.412 V |
| B: no clamps | `XM_CLIM` and `XM_TSHUT` drains moved from EA_OUT to private nodes with 1 Gohm bleeds | **0.362555 V** (-35.1 mV) | 2.1266 V | 0.662 V | 0.353 / 0.417 V |

- A removes the tail-headroom dependence only. Dropout improves by 16.6 mV;
  M_CLIM still conducts (456 nA at the crossing) and EA_OUT still stalls near
  0.65-0.70 V and then rises. So tail-headroom collapse alone is **not** the
  dominant limit.
- B removes the two EA_OUT pull-up clamps only. Dropout improves by 35.1 mV;
  the tail still collapses (0.177 uA, Vds 5 mV at the crossing) and the loop
  still fails to drive EA_OUT lower. So the clamp alone is **not** the
  dominant limit either, though it is the larger single contributor of the two.
- In neither probe does EA_OUT approach a rail (0.66-0.69 V at the crossing),
  and in both the pass device still sits at Vds ~= Vdsat. The remaining
  0.36-0.38 V is not attributable to either intervention.

**4. Hypotheses.**

- *Original: the amplifier cannot drive the gate far enough (gate headroom).*
  **Not supported at tt/27C/3.30V/50mA.** EA_OUT stays 0.66-0.71 V above its
  floor at the crossing in all three runs, with the pull-down device saturated.
  A measured refutation of that framing for this corner; it does not say
  gate drive is irrelevant at the ss/125C binding corners (unmeasured here).
- *M_SENSE / M_CLIM gate loading as the dominant cause.* **Partly supported,
  not dominant.** M_SENSE draws 13-14.5 uA from VIN (not from EA_OUT) and
  loads nothing; M_CLIM's pull-up is real but worth 35 mV, not 100 mV.
- *Thermal-shutdown clamp (M_TSHUT) active.* **Ruled out** at this point:
  0.03 pA throughout.
- *Enable/startup artifact or solver artifact.* **Ruled out for the
  baseline**: regulating (VOUT 1.7988 V) before the ramp, zero solver
  diagnostics, same crossing as the rate-independence series in the manifest.
- *Intrinsic pass-device Ron floor.* **Unresolved** (see uncertainty).

**5. What remains unverified (do not read these as findings).**

- The pass device's best-case drop at 50 mA with *unlimited* gate drive was
  **not** simulated (the probe budget was two). A hand estimate from the
  triode-edge numbers (Vsg - Vth = 0.52 V at the crossing; a gate near 0.15 V
  would double it) suggests the intrinsic drop at ample Vsg is substantially
  lower than 0.39 V, but this is an extrapolation, not a measurement.
- The A and B interventions were not combined, so whether they add (about
  50 mV) or interact is unknown; at best they would leave ~0.35 V, still above
  300 mV, which would imply a further limiter (loop gain/EA output stage).
- ss/125C and the other 43 corners, mismatch, and any VIN-dependence of the
  `R_BIAS`-derived bias at other temperatures.
- The 9 mV gap between VIN - VOUT and the model's internal Vds was not
  decomposed further.

**6. Ranked next experiments (single-corner first; owned by #339).**

1. **Isolated pass-device DC bench**, same model/temperature: M_PASS (same
   W/L/mult) with source at 2.16 V and gate swept to 0 V, to measure the
   intrinsic Vds needed for 50 mA at ample Vsg. Validate the bench by
   reproducing 49.7 mA at Vsg 1.446 V / Vds 0.389 V from section 2 before
   using it. Decides whether `< 300 mV` is reachable by gate drive/amplifier
   changes at all or needs pass-device sizing (DR-011 territory).
2. **Combined A+B probe** (ideal tail + clamps removed), then, if the residual
   is still >= 0.3 V, a probe that fixes the amplifier bias independent of VIN
   (the R_BIAS-derived bias currents fall with VIN) to expose the output-stage
   current starvation.
3. Repeat the winning intervention at ss/125C (the binding corner) via the
   batch path once dropout-vs-load has a qualified adapter (#339's prerequisite).

No production change is selected here on the strength of this single corner or
the old 0.398 V result.

**7. Reproducing it.**

```bash
python3 sim/bin/corner-run.py sim/dropout-vs-load --process tt --temp 27 \
  --supply 3.3 --backend local --subset-reason 'Issue #323: ...'
cd sim/dropout-vs-load/diagnostics/issue-323   # .spiceinit lives here
python3 make_probe_deck.py probeA.deck.spice ideal_tail probeA.dat
ngspice -b probeA.deck.spice                    # then: python3 analyze.py probeA.dat full traj
```

Each is one local ngspice run (3 s); no grid. Follow-up and campaign
requirements: #339 (linked from #114).
