2AMLogic/sky130-ldo/measurements/characterization.md

# LDO characterization report (against the ratified spec)

Generated by [`measurements/build_characterization_report.py`](build_characterization_report.py) — the capstone rollup of the block's own append-only evidence (DRC #16, LVS #17, full PVT-corner + Monte Carlo/yield #19, post-layout extracted-netlist #20), keyed to each row of [`spec/target-spec.md`](../spec/target-spec.md).

**This is not a compliance claim — it is the opposite: a live conformance check against `spec/target-spec.md`, which is ratified (issue #1, DR-006).** Every verdict below is stated explicitly as *against the ratified row*, per the same guardrail issue #19's own records already use. A `PASS`/`FAIL`/`MATCH`/`clean` value here is read verbatim from the cited record's own stated result — this script never recomputes a verdict from raw measurements (see the module docstring in `build_characterization_report.py` for the full extraction/freshness/no-re-derivation rules).

This file is a **generated rollup**, not itself append-only evidence in the `sim/README.md` sense: it is overwritten in place each time the generator runs, and git history — not a per-run record id — is its audit trail. Regenerate it (and commit the result) whenever the evidence it cites changes:

```bash
python3 measurements/build_characterization_report.py --out measurements/characterization.md
# or verify the committed file is not stale:
python3 measurements/build_characterization_report.py --check
```

Re-running this generator against an unchanged tree with the same pinned toolchain (`sim/pdk.json`) reproduces this file byte-for-byte — no wall-clock timestamps and no generating-commit identity are embedded, so `--check` passes both before and after the commit that lands a regenerated report. The per-`sim/` **Freshness** column below is a live check (a fresh `xschem` re-netlist of the current testbench schematic, compared verbatim against the committed netlist snapshot); on a machine without the PDK toolchain it degrades to `unverified` rather than a false claim of freshness (`--no-netlist-freshness` forces this explicitly). The separate **Inputs** column / `Experiment/solver inputs` clause is a headless check (no `xschem`/PDK): it compares the cited record's versioned input fingerprint (analyses, measurement expressions/bounds, declared matrix, solver settings — an allow-list of execution-relevant manifest keys, so prose edits do not invalidate a simulation; `sim/README.md`) with the current `experiment.json` and `sim/spiceinit`, and reports a legacy record without that provenance as `unverified` rather than guessing. It is compared even under `--ignore-sim-freshness`. The layout (DRC/LVS/PEX) **Freshness** column instead compares the schematic/layout commit each record itself cites against the current git history / `LATEST*` pointers, and the stored GDS bytes against the content hash each checker recorded for its input (DRC: the curated deck's `provenance.input.content_hash` and the official deck's `input_sha256`; LVS: `environment.layout_sha256`) — no toolchain required. A record missing that provenance is `unverified`, never assumed fresh.

No generating-commit SHA is stamped into this file, deliberately: a commit that regenerates this report cannot contain its own resulting hash, so such a line would make `--check` fail by construction on the very commit that ships the regenerated file. Provenance instead comes from the record ids cited per row (each of which is itself an append-only, commit-pinned record) plus this file's own git history.

## Per-spec-row characterization

| Parameter | Ratified target | Verdict (vs ratified target) | Evidence | Inputs | Freshness |
|---|---|---|---|---|---|
| Input | 3.3 V ±10% (2.97–3.63 V) | N/A | — | — | — |
| Output | 1.8 V ±2% (fixed; divider as a unit-resistor string) | **PASS** | [`20260925-131502-808cece`](../sim/mc-output-accuracy/records/20260925-131502-808cece.md) | unverified | STALE |
| Load | 0–50 mA (0 mA = no external load; feedback divider is the only inherent preload) | N/A | — | — | — |
| Dropout @ 50 mA | < 300 mV | **FAIL** (PVT subset) | [`20261011-092557-7a4e0cc`](../sim/dropout-vs-load/records/20261011-092557-7a4e0cc.md) | fresh | fresh |
| Line regulation | < 5 mV/V over 2.97–3.63 V, at 1 mA and 50 mA | **PASS** | [`20260926-200304-35b7392`](../sim/line-regulation/records/20260926-200304-35b7392.md) | unverified | STALE |
| Load regulation (0–50 mA) | < 1% (18 mV), counted inside the ±2% window | **FAIL** | [`20260926-010432-228fbc7`](../sim/load-regulation/records/20260926-010432-228fbc7.md) | unverified | STALE |
| Load transient | 1↔50 mA step, ~1 µs edges: peak excursion ≤ 150 mV, recover to ±1% in ≤ 20 µs, over the ratified C_out/ESR window | **FAIL** | [`20260926-013955-6449a98`](../sim/load-transient/records/20260926-013955-6449a98.md) | unverified | STALE |
| PSRR | > 50 dB @ 1 kHz and > 20 dB @ 100 kHz, at 1 mA (light-load, binding) and at 50 mA | **FAIL** | [`20260926-033606-4a9ec09`](../sim/psrr-dc/records/20260926-033606-4a9ec09.md) | unverified | STALE |
| Iq (excl. load current) | < 30 µA at no load **and** at full load (50 mA), every PVT corner; Iq = total VIN current minus load current, EN asserted | **FAIL** | [`20260910-034648-6c0436d`](../sim/iq/records/20260910-034648-6c0436d.md) | unverified | STALE |
| Current limit | constant-current (brickwall) clamp, window TBD over PVT; never engages for I_load ≤ 50 mA; survives continuous Vout = 0 short at Vin_max | **PASS** | [`20260825-105322-933dfdd`](../sim/current-limit/records/20260825-105322-933dfdd.md) | unverified | STALE |
| Startup / soft-start | monotonic into any load 0–50 mA and any C_out in the stability window; controlled ramp; inside ±2% within a few ms of enable; overshoot ≤ +2% | **PASS** | [`20260825-110456-933dfdd`](../sim/startup/records/20260825-110456-933dfdd.md) | unverified | STALE |
| Enable / shutdown | shutdown Iq < 3 µA worst corner; disabled output = pass device fully off, no active discharge; Vin→Vout leakage ≤ 1 µA | **PASS** | [`20260825-111526-933dfdd`](../sim/enable-shutdown/records/20260825-111526-933dfdd.md) | unverified | STALE |
| Thermal | continuous worst-case dissipation set by Vin_max × I_load; short-circuit ceiling set by the current limit; specified to Tj ≤ 125 °C (rated-operation ceiling, unchanged); θJA delegated to package/integration | **PASS** | [`20260926-095154-f6ab418`](../sim/thermal/records/20260926-095154-f6ab418.md) | unverified | STALE |
| Output noise | not specified — waived unless a consumer states a requirement | N/A | — | — | — |
| Area | < 0.1 mm² total core area, pass FET included, excluding pads and sealring | **FAIL** | [`20261016-030807-39ba498`](../layout/ldo-core/reports/20261016-030807-39ba498/record.md) | — | STALE (GDS sha256) |
| Stability | stable 0–50 mA over the ratified C_out/ESR window; PM ≥ 45°, GM ≥ 10 dB worst corner | **FAIL** | [`20260926-040338-4a9ec09`](../sim/loop-gain/records/20260926-040338-4a9ec09.md) | unverified | STALE |

### Evidence detail

- **Input**: N/A — exercised as a stimulus condition (VIN step/sweep) inside every PVT testbench below, not measured by a testbench of its own.
- **Output**: **PASS** (vs the ratified spec row) — `sim/mc-output-accuracy` record [`20260925-131502-808cece`](../sim/mc-output-accuracy/records/20260925-131502-808cece.md), 200/200 individual sample(s) PASS. Experiment/solver inputs: unverified: analyses, measurements, matrix, netlist_patch -- no input fingerprint in this legacy record. Freshness: STALE (a live xschem re-netlist of the current testbench schematic no longer matches the committed netlist snapshot).
- **Load**: N/A — exercised as a stimulus condition (I_LOAD step/sweep) inside every PVT testbench below, not measured by a testbench of its own.
- **Dropout @ 50 mA**: **FAIL** (vs the ratified spec row) — `sim/dropout-vs-load` record [`20261011-092557-7a4e0cc`](../sim/dropout-vs-load/records/20261011-092557-7a4e0cc.md), 0/1 corner(s) PASS. Experiment/solver inputs: fresh (the record's input fingerprint v1 matches the current manifest/solver inputs: analyses, measurements, matrix, solver). Freshness: fresh (a live xschem re-netlist of the current testbench schematic matches the committed netlist snapshot verbatim). Failing measurement(s), per the record: `dropout_v` at 1 corner(s). **PVT subset, not the full matrix this experiment declares** — the record's own stated reason: Issue #323: current-schematic dropout attribution only; no PVT qualification
- **Line regulation**: **PASS** (vs the ratified spec row) — `sim/line-regulation` record [`20260926-200304-35b7392`](../sim/line-regulation/records/20260926-200304-35b7392.md), 45/45 corner(s) PASS. Experiment/solver inputs: unverified: analyses, measurements, matrix -- no input fingerprint in this legacy record; matching: solver. Freshness: STALE (a live xschem re-netlist of the current testbench schematic no longer matches the committed netlist snapshot).
- **Load regulation (0–50 mA)**: **FAIL** (vs the ratified spec row) — `sim/load-regulation` record [`20260926-010432-228fbc7`](../sim/load-regulation/records/20260926-010432-228fbc7.md), 44/45 corner(s) PASS. Experiment/solver inputs: unverified: analyses, measurements, matrix, solver -- no input fingerprint in this legacy record. Freshness: STALE (a live xschem re-netlist of the current testbench schematic no longer matches the committed netlist snapshot). Failing measurement(s), per the record: `load_reg_v` at 1 corner(s); `load_reg_pct` at 1 corner(s).
- **Load transient**: **FAIL** (vs the ratified spec row) — `sim/load-transient` record [`20260926-013955-6449a98`](../sim/load-transient/records/20260926-013955-6449a98.md), 0/45 corner(s) PASS. Experiment/solver inputs: unverified: analyses, measurements, matrix, solver -- no input fingerprint in this legacy record. Freshness: STALE (a live xschem re-netlist of the current testbench schematic no longer matches the committed netlist snapshot). Failing measurement(s), per the record: `recovery_rise_us` at 45 corner(s); `recovery_fall_us` at 45 corner(s). COUT/ESR window coverage (separate from the PVT coverage above): the manifest declares a finite 6-leg grid (3.3e-07 F / 0 ohm, 3.3e-07 F / 0.01 ohm, 3.3e-07 F / 0.5 ohm, 4.7e-06 F / 0 ohm, 4.7e-06 F / 0.01 ohm, 4.7e-06 F / 0.5 ohm) that samples the ratified window; it is not a continuous-window proof. **This record carries no window-grid result: the grid is declared but not yet evidenced (the record measured only the single pre-grid COUT/ESR point), so no claim of COUT/ESR window qualification is made.**
- **PSRR**: **FAIL** (vs the ratified spec row) — `sim/psrr-dc` record [`20260926-033606-4a9ec09`](../sim/psrr-dc/records/20260926-033606-4a9ec09.md), 0/45 corner(s) PASS. Experiment/solver inputs: unverified: analyses, measurements, matrix, solver -- no input fingerprint in this legacy record. Freshness: STALE (a live xschem re-netlist of the current testbench schematic no longer matches the committed netlist snapshot). Failing measurement(s), per the record: `psrr_1khz_1ma_db` at 45 corner(s); `psrr_1khz_50ma_db` at 45 corner(s); `psrr_100khz_50ma_db` at 45 corner(s).
- **Iq (excl. load current)**: **FAIL** (vs the ratified spec row) — `sim/iq` record [`20260910-034648-6c0436d`](../sim/iq/records/20260910-034648-6c0436d.md), 36/45 corner(s) PASS. Experiment/solver inputs: unverified: analyses, measurements, matrix, solver -- no input fingerprint in this legacy record. Freshness: STALE (a live xschem re-netlist of the current testbench schematic no longer matches the committed netlist snapshot). Failing measurement(s), per the record: `iq_full_load_ua` at 9 corner(s).
- **Current limit**: **PASS** (vs the ratified spec row) — `sim/current-limit` record [`20260825-105322-933dfdd`](../sim/current-limit/records/20260825-105322-933dfdd.md), 45/45 corner(s) PASS. Experiment/solver inputs: unverified: analyses, measurements, matrix, solver -- no input fingerprint in this legacy record. Freshness: STALE (a live xschem re-netlist of the current testbench schematic no longer matches the committed netlist snapshot).
- **Startup / soft-start**: **PASS** (vs the ratified spec row) — `sim/startup` record [`20260825-110456-933dfdd`](../sim/startup/records/20260825-110456-933dfdd.md), 45/45 corner(s) PASS. Experiment/solver inputs: unverified: analyses, measurements, matrix, solver, ramp_monotonicity -- no input fingerprint in this legacy record. Freshness: STALE (a live xschem re-netlist of the current testbench schematic no longer matches the committed netlist snapshot). COUT/ESR window coverage (separate from the PVT coverage above): the manifest declares a finite 12-leg grid (3.3e-07 F / 0 ohm / 1e+12 ohm load, 3.3e-07 F / 0.01 ohm / 1e+12 ohm load, 3.3e-07 F / 0.5 ohm / 1e+12 ohm load, 3.3e-07 F / 0 ohm / 36 ohm load, 3.3e-07 F / 0.01 ohm / 36 ohm load, 3.3e-07 F / 0.5 ohm / 36 ohm load, 4.7e-06 F / 0 ohm / 1e+12 ohm load, 4.7e-06 F / 0.01 ohm / 1e+12 ohm load, 4.7e-06 F / 0.5 ohm / 1e+12 ohm load, 4.7e-06 F / 0 ohm / 36 ohm load, 4.7e-06 F / 0.01 ohm / 36 ohm load, 4.7e-06 F / 0.5 ohm / 36 ohm load) that samples the ratified window; it is not a continuous-window proof. **This record carries no window-grid result: the grid is declared but not yet evidenced (the record measured only the single pre-grid COUT/ESR point), so no claim of COUT/ESR window qualification is made.**
- **Enable / shutdown**: **PASS** (vs the ratified spec row) — `sim/enable-shutdown` record [`20260825-111526-933dfdd`](../sim/enable-shutdown/records/20260825-111526-933dfdd.md), 45/45 corner(s) PASS. Experiment/solver inputs: unverified: analyses, measurements, matrix, solver -- no input fingerprint in this legacy record. Freshness: STALE (a live xschem re-netlist of the current testbench schematic no longer matches the committed netlist snapshot).
- **Thermal**: **PASS** (vs the ratified spec row) — `sim/thermal` record [`20260926-095154-f6ab418`](../sim/thermal/records/20260926-095154-f6ab418.md), 15/15 corner(s) PASS. Experiment/solver inputs: unverified: analyses, measurements, matrix -- no input fingerprint in this legacy record; matching: solver. Freshness: STALE (a live xschem re-netlist of the current testbench schematic no longer matches the committed netlist snapshot).
- **Output noise**: N/A — waived by the spec row itself ("not specified — waived unless a consumer states a requirement").
- **Area**: **FAIL** (vs the ratified row; verdict read from the record) — layout record [`20261016-030807-39ba498`](../layout/ldo-core/reports/20261016-030807-39ba498/record.md): `ldo_core` measures 2451.870 um x 183.870 um = 0.4508253369 mm² against the unchanged < 0.1 mm² limit (strict). Convention: Top-cell flattened bounding rectangle over all layers/datatypes (hierarchy, SREF/AREF transforms and path widths included; TEXT and NODE excluded); area = width x height in um^2 converted to mm^2 from the stream's own UNITS record; PASS iff area < 0.1 mm^2 (strict). GDS `layout/ldo-core/reports/20261010-074336-0eb9b4b/ldo_core.gds` (sha256 `80f98681debd11e46c0a9fdb4fd307314db07198dbc485b31973ba2d5531c726`). GDS freshness: STALE (the routed GDS in the current `LATEST` record `20261022-231908-56dd87fe` differs from the measured one; mint a new area record). Coverage (from the record): The measured footprint omits 4 schematic element(s) that are not drawn in this layout (C_COMP, C_CL, C_SS, C_TS). It is not evidence that a complete, capacitor-inclusive core meets the Area row. Official-deck DRC on the same layout record: violations (1209 markers in 3 rule families). LVS at mint time: fresh (`LATEST-LVS` `20261010-074401-0eb9b4b`: LATEST-LVS checked these exact GDS bytes). Standalone capacitor demonstrator `layout/cap-rail-demo/reports/20261010-033947-80bc87e/record.md` is cited separately and does not certify the core.
- **Stability**: **FAIL** (vs the ratified spec row) — `sim/loop-gain` record [`20260926-040338-4a9ec09`](../sim/loop-gain/records/20260926-040338-4a9ec09.md), 7/45 corner(s) PASS. Experiment/solver inputs: unverified: analyses, measurements, matrix, solver -- no input fingerprint in this legacy record. Freshness: STALE (a live xschem re-netlist of the current testbench schematic no longer matches the committed netlist snapshot). Failing measurement(s), per the record: `pm_c033_50ma_deg` at 33 corner(s); `pm_c033_0ma_deg` at 33 corner(s); `pm_c47_0ma_deg` at 11 corner(s); `pm_c47_1ma_deg` at 1 corner(s).

## Layout verification (not itself a spec row)

DRC/LVS/post-layout PEX substantiate that the routed layout matches the schematic these spec-row testbenches above simulate — they are not measurements of a numeric spec parameter themselves, so they are rolled up separately rather than forced into the table above.

| Check | Verdict (record's own) | Record | Freshness |
|---|---|---|---|
| DRC (issue #16) | **PASS** (curated deck: status=clean, violation_count=0; official deck `sky130A_mr.drc`: clean, 0 markers across 247 declared rule categories) | [`20261022-231908-56dd87fe`](../layout/ldo-core/reports/20261022-231908-56dd87fe/record.md) | fresh |
| LVS (issue #17) | **MATCH** (status=match, mismatch_count=5) | [`20261022-232042-56dd87fe`](../layout/ldo-core/reports/20261022-232042-56dd87fe/record.md) | fresh |
| Post-layout PEX (issue #20) | see detail — no single PASS/FAIL ([caveat](../sim/pex-post-layout/README.md)) | [`20261022-232148-56dd87fe`](../sim/pex-post-layout/records/20261022-232148-56dd87fe.md) | fresh |

Post-layout PEX detail (record `20261022-232148-56dd87fe`): `klt sim` (schematic-side leg, standalone): status=fail, corners=45, passed=42, failed=3, errored=0; `klt pex` (schematic + extracted legs + delta): status=fail, passed=43, failed=92, errored=0, pin_count_mismatch=None. This paragraph is generated from the record's own `- Result:` lines and carries no hand-written triage beyond them — the per-record narrative (`klt` pin, per-corner root-cause attribution, upstream/repo-local issue cross-references) is hand-maintained in [`sim/pex-post-layout/README.md`](../sim/pex-post-layout/README.md) instead, so do not hand-edit it in here.

DRC freshness detail (record `20261022-231908-56dd87fe`): fresh (fresh (record cites commit `a09aa83f`, matching the schematic's current last-touching commit); fresh (`ldo_core.gds` hashes to both the curated deck's recorded input content_hash and the official deck's recorded input_sha256)).

## Limitations

- **Ratified spec, unratified implementation.** Every verdict above is against `spec/target-spec.md`'s ratified row (issue #1, DR-006) — a FAIL here means the current implementation, not the target, falls short. Re-verification is required whenever the underlying `sim/` or layout evidence changes, or a future decision record supersedes a ratified row's target (see DR-006's Consequences).
- **N/A rows are a coverage gap, not a pass.** A row marked N/A above has no independent testbench yet — it is neither substantiated nor refuted by this report.
- **A `(PVT subset)` verdict is narrower than a full-matrix one.** That marker means the cited record ran fewer corners than its own `experiment.json` declares (the runner refuses to write such a record without a stated reason, quoted in the Evidence detail above). A subset `PASS` says the corners that ran passed — it does not say the full matrix would.
- **Freshness checks trust the tree, not the working copy.** The schematic-freshness check (layout section) compares against git history, so uncommitted local edits to `design/ldo_3v3in_1v8out.sch` will not be detected as stale until committed.
- **Post-layout PEX (issue #20) has no single PASS/FAIL** — see `sim/pex-post-layout/README.md` for the disclosed `klt`/PDK/layout caveats that bound the extracted-side leg for the cited record, and for that record's own narrative summary. This bullet is generated and deliberately makes no record-specific claim of its own: which caveats bind, and whether they are upstream or repo-local, changes from record to record and is tracked in that file, not here.
