2AMLogic/sky130-ldo/sim/tests/fixtures/issue-374/no-crossing.rc.spice

VVIN VIN 0 PWL(0 0 1m 1)
R1 VIN VOUT 1k
C1 VOUT 0 1n
