2AMLogic/sky130-ldo/sim/dropout-vs-load/diagnostics/issue-357/runs/cl_base_3p3/deck.spice

* current-limit corner deck -- generated by sim/bin/corner-run.py, do not edit
* corner: tt_27c_3.30v
.param vsup=3.3
.option wnflag=1
.temp 27
.lib "/home/ubuntu/.volare/sky130A/libs.tech/combined/sky130.lib.spice" tt
** sch_path: sim/current-limit/testbench/tb_current_limit.sch
**.subckt tb_current_limit
VVIN VIN 0 'vsup'
.save i(vvin)
VEN EN 0 dc 'vsup' pwl(0 0 100u 0 101u 'vsup' 10 'vsup')
.save i(ven)
VVREF VREF 0 1.2
.save i(vvref)
xldo VOUT VREF EN VIN ldo_3v3in_1v8out
COUT VOUT VESR 1u m=1
RESR VESR 0 10m m=1
RLOAD VOUT 0 36 m=1
RFORCE VOUT VF 1e12 m=1
VFORCE VF 0 dc 1.8 pwl(0 1.8 1m 1.8 1.001m 0 10 0)
.save i(vforce)
**.ends

* expanding   symbol:  design/ldo_3v3in_1v8out.sym # of pins=4
** sym_path: design/ldo_3v3in_1v8out.sym
** sch_path: design/ldo_3v3in_1v8out.sch
.subckt ldo_3v3in_1v8out VOUT VREF EN VIN
*.ipin VIN
*.ipin EN
*.ipin VREF
*.opin VOUT
XR_BIAS VIN NB 0 sky130_fd_pr__res_high_po W=0.42 L=1500 mult=1 m=1
XM_BIASN1 NB NB BIAS_ENN 0 sky130_fd_pr__nfet_g5v0d10v5 L=1 W=4 nf=1 ad=1.16 as=1.16 pd=8.58 ps=8.58 nrd=0.0725 nrs=0.0725 sa=0
+ sb=0 sd=0 mult=1 m=1
XM_ENN BIAS_ENN EN 0 0 sky130_fd_pr__nfet_g5v0d10v5 L=0.5 W=10 nf=1 ad=2.9 as=2.9 pd=20.58 ps=20.58 nrd=0.029 nrs=0.029 sa=0 sb=0
+ sd=0 mult=1 m=1
XM_BIASN2 BIASP NB BIAS_ENN 0 sky130_fd_pr__nfet_g5v0d10v5 L=1 W=4 nf=1 ad=1.16 as=1.16 pd=8.58 ps=8.58 nrd=0.0725 nrs=0.0725 sa=0
+ sb=0 sd=0 mult=1 m=1
XM_BIASP1 BIASP BIASP VIN VIN sky130_fd_pr__pfet_g5v0d10v5 L=1 W=10 nf=2 ad=1.45 as=2.9 pd=10.58 ps=21.16 nrd=0.029 nrs=0.029 sa=0
+ sb=0 sd=0 mult=1 m=1
XM_ENP2 BIASP EN VIN VIN sky130_fd_pr__pfet_g5v0d10v5 L=0.5 W=10 nf=1 ad=2.9 as=2.9 pd=20.58 ps=20.58 nrd=0.029 nrs=0.029 sa=0
+ sb=0 sd=0 mult=1 m=1
XM_TAIL EA_TAIL BIASP VIN VIN sky130_fd_pr__pfet_g5v0d10v5 L=2 W=40 nf=8 ad=5.8 as=7.25 pd=42.32 ps=52.9 nrd=0.00725 nrs=0.00725
+ sa=0 sb=0 sd=0 mult=1 m=1
XM_IN1 EA_D1 FB EA_TAIL VIN sky130_fd_pr__pfet_g5v0d10v5 L=2 W=10 nf=2 ad=1.45 as=2.9 pd=10.58 ps=21.16 nrd=0.029 nrs=0.029 sa=0
+ sb=0 sd=0 mult=1 m=1
XM_IN2 EA_D2 VREF EA_TAIL VIN sky130_fd_pr__pfet_g5v0d10v5 L=2 W=10 nf=2 ad=1.45 as=2.9 pd=10.58 ps=21.16 nrd=0.029 nrs=0.029 sa=0
+ sb=0 sd=0 mult=1 m=1
XM_MIR1 EA_D1 EA_D1 AMP_ENN 0 sky130_fd_pr__nfet_g5v0d10v5 L=4 W=10 nf=2 ad=1.45 as=2.9 pd=10.58 ps=21.16 nrd=0.029 nrs=0.029 sa=0
+ sb=0 sd=0 mult=1 m=1
XM_MIR2 EA_OUT EA_D1 AMP_ENN 0 sky130_fd_pr__nfet_g5v0d10v5 L=4 W=10 nf=2 ad=1.45 as=2.9 pd=10.58 ps=21.16 nrd=0.029 nrs=0.029
+ sa=0 sb=0 sd=0 mult=1 m=1
XM_ENN2 AMP_ENN EN 0 0 sky130_fd_pr__nfet_g5v0d10v5 L=0.5 W=10 nf=1 ad=2.9 as=2.9 pd=20.58 ps=20.58 nrd=0.029 nrs=0.029 sa=0 sb=0
+ sd=0 mult=1 m=1
XM_ENP EA_OUT EN VIN VIN sky130_fd_pr__pfet_g5v0d10v5 L=0.5 W=10 nf=1 ad=2.9 as=2.9 pd=20.58 ps=20.58 nrd=0.029 nrs=0.029 sa=0
+ sb=0 sd=0 mult=1 m=1
XM_MIR3 EA_D2 EA_D2 AMP_ENN 0 sky130_fd_pr__nfet_g5v0d10v5 L=4 W=10 nf=2 ad=1.45 as=2.9 pd=10.58 ps=21.16 nrd=0.029 nrs=0.029 sa=0
+ sb=0 sd=0 mult=1 m=1
XM_MIR4 PB EA_D2 AMP_ENN 0 sky130_fd_pr__nfet_g5v0d10v5 L=4 W=10 nf=2 ad=1.45 as=2.9 pd=10.58 ps=21.16 nrd=0.029 nrs=0.029 sa=0
+ sb=0 sd=0 mult=1 m=1
XM_MIRP1 PB PB VIN VIN sky130_fd_pr__pfet_g5v0d10v5 L=4 W=20 nf=4 ad=2.9 as=4.35 pd=21.16 ps=31.74 nrd=0.0145 nrs=0.0145 sa=0 sb=0
+ sd=0 mult=1 m=1
XM_MIRP2 EA_OUT PB VIN VIN sky130_fd_pr__pfet_g5v0d10v5 L=4 W=20 nf=4 ad=2.9 as=4.35 pd=21.16 ps=31.74 nrd=0.0145 nrs=0.0145 sa=0
+ sb=0 sd=0 mult=1 m=1
XM_ENP5 PB EN VIN VIN sky130_fd_pr__pfet_g5v0d10v5 L=0.5 W=2 nf=1 ad=0.58 as=0.58 pd=4.58 ps=4.58 nrd=0.145 nrs=0.145 sa=0 sb=0
+ sd=0 mult=1 m=1
XM_PASS VOUT EA_OUT VIN VIN sky130_fd_pr__pfet_g5v0d10v5 L=0.5 W=100 nf=25 ad=15.08 as=15.08 pd=111.54 ps=111.54 nrd=0.0029
+ nrs=0.0029 sa=0 sb=0 sd=0 mult=50 m=50
C_COMP VOUT EA_CZ 150p m=1
XR_CZ EA_CZ EA_OUT 0 sky130_fd_pr__res_xhigh_po W=0.42 L=52 mult=1 m=1
XR_FB_A VOUT FB 0 sky130_fd_pr__res_xhigh_po W=0.42 L=180 mult=1 m=1
XR_FB_B FB N_FBB 0 sky130_fd_pr__res_xhigh_po W=0.42 L=180 mult=1 m=1
XR_FB_C N_FBB 0 0 sky130_fd_pr__res_xhigh_po W=0.42 L=180 mult=1 m=1
XM_SENSE CL_SNS EA_OUT VIN VIN sky130_fd_pr__pfet_g5v0d10v5 L=0.5 W=0.42 nf=1 ad=0.1218 as=0.1218 pd=1.42 ps=1.42
+ nrd=0.69047619047619 nrs=0.69047619047619 sa=0 sb=0 sd=0 mult=2 m=2
XM_CLN1 CL_SNS CL_SNS AMP_ENN 0 sky130_fd_pr__nfet_g5v0d10v5 L=1 W=20 nf=1 ad=5.8 as=5.8 pd=40.58 ps=40.58 nrd=0.0145 nrs=0.0145
+ sa=0 sb=0 sd=0 mult=1 m=1
XM_CLN2 CL_CMP CL_SNS AMP_ENN 0 sky130_fd_pr__nfet_g5v0d10v5 L=1 W=1.6 nf=1 ad=0.464 as=0.464 pd=3.78 ps=3.78 nrd=0.18125
+ nrs=0.18125 sa=0 sb=0 sd=0 mult=1 m=1
XM_CLP CL_CMP BIASP VIN VIN sky130_fd_pr__pfet_g5v0d10v5 L=1 W=10 nf=2 ad=1.45 as=2.9 pd=10.58 ps=21.16 nrd=0.029 nrs=0.029 sa=0
+ sb=0 sd=0 mult=1 m=1
XM_CLIM EA_OUT CL_CMP VIN VIN sky130_fd_pr__pfet_g5v0d10v5 L=0.5 W=20 nf=4 ad=2.9 as=4.35 pd=21.16 ps=31.74 nrd=0.0145 nrs=0.0145
+ sa=0 sb=0 sd=0 mult=1 m=1
XM_ENP3 CL_CMP EN VIN VIN sky130_fd_pr__pfet_g5v0d10v5 L=0.5 W=2 nf=1 ad=0.58 as=0.58 pd=4.58 ps=4.58 nrd=0.145 nrs=0.145 sa=0
+ sb=0 sd=0 mult=1 m=1
C_CL VIN CL_CMP 1p m=1
XM_INVP ENB EN VIN VIN sky130_fd_pr__pfet_g5v0d10v5 L=0.5 W=2 nf=1 ad=0.58 as=0.58 pd=4.58 ps=4.58 nrd=0.145 nrs=0.145 sa=0 sb=0
+ sd=0 mult=1 m=1
XM_INVN ENB EN 0 0 sky130_fd_pr__nfet_g5v0d10v5 L=0.5 W=1 nf=1 ad=0.29 as=0.29 pd=2.58 ps=2.58 nrd=0.29 nrs=0.29 sa=0 sb=0 sd=0
+ mult=1 m=1
XM_SSDIS SS ENB 0 0 sky130_fd_pr__nfet_g5v0d10v5 L=0.5 W=2 nf=1 ad=0.58 as=0.58 pd=4.58 ps=4.58 nrd=0.145 nrs=0.145 sa=0 sb=0 sd=0
+ mult=1 m=1
XM_SSCHG SS BIASP VIN VIN sky130_fd_pr__pfet_g5v0d10v5 L=8 W=1 nf=1 ad=0.29 as=0.29 pd=2.58 ps=2.58 nrd=0.29 nrs=0.29 sa=0 sb=0
+ sd=0 mult=1 m=1
C_SS SS 0 10p m=1
XM_IN2S EA_D2 SS EA_TAIL VIN sky130_fd_pr__pfet_g5v0d10v5 L=2 W=10 nf=2 ad=1.45 as=2.9 pd=10.58 ps=21.16 nrd=0.029 nrs=0.029 sa=0
+ sb=0 sd=0 mult=1 m=1
XM_TSPS TS_SNS BIASP VIN VIN sky130_fd_pr__pfet_g5v0d10v5 L=1 W=1.25 nf=1 ad=0.3625 as=0.3625 pd=3.08 ps=3.08 nrd=0.232 nrs=0.232
+ sa=0 sb=0 sd=0 mult=1 m=1
XM_TSD1 TS_SNS TS_SNS TS_MID 0 sky130_fd_pr__nfet_g5v0d10v5 L=4 W=80 nf=16 ad=11.6 as=13.05 pd=84.64 ps=95.22 nrd=0.003625
+ nrs=0.003625 sa=0 sb=0 sd=0 mult=1 m=1
XM_TSD2 TS_MID TS_MID AMP_ENN 0 sky130_fd_pr__nfet_g5v0d10v5 L=4 W=80 nf=16 ad=11.6 as=13.05 pd=84.64 ps=95.22 nrd=0.003625
+ nrs=0.003625 sa=0 sb=0 sd=0 mult=1 m=1
XM_TSPR TS_REF BIASP VIN VIN sky130_fd_pr__pfet_g5v0d10v5 L=1 W=7 nf=1 ad=2.03 as=2.03 pd=14.58 ps=14.58 nrd=0.0414285714285714
+ nrs=0.0414285714285714 sa=0 sb=0 sd=0 mult=1 m=1
XM_TSR1 TS_REF TS_REF AMP_ENN 0 sky130_fd_pr__nfet_g5v0d10v5 L=2 W=0.42 nf=1 ad=0.1218 as=0.1218 pd=1.42 ps=1.42
+ nrd=0.69047619047619 nrs=0.69047619047619 sa=0 sb=0 sd=0 mult=1 m=1
XM_TSHUT EA_OUT TS_CMP VIN VIN sky130_fd_pr__pfet_g5v0d10v5 L=0.5 W=20 nf=4 ad=2.9 as=4.35 pd=21.16 ps=31.74 nrd=0.0145 nrs=0.0145
+ sa=0 sb=0 sd=0 mult=1 m=1
XM_ENP4 TS_CMP EN VIN VIN sky130_fd_pr__pfet_g5v0d10v5 L=0.5 W=2 nf=1 ad=0.58 as=0.58 pd=4.58 ps=4.58 nrd=0.145 nrs=0.145 sa=0
+ sb=0 sd=0 mult=1 m=1
C_TS VIN TS_CMP 1p m=1
XM_RCTAIL RC_TAIL NB AMP_ENN 0 sky130_fd_pr__nfet_g5v0d10v5 L=1 W=1 nf=1 ad=0.29 as=0.29 pd=2.58 ps=2.58 nrd=0.29 nrs=0.29 sa=0
+ sb=0 sd=0 mult=1 m=1
XM_RCN1 RC_A TS_SNS RC_TAIL 0 sky130_fd_pr__nfet_g5v0d10v5 L=2 W=10 nf=2 ad=1.45 as=2.9 pd=10.58 ps=21.16 nrd=0.029 nrs=0.029 sa=0
+ sb=0 sd=0 mult=1 m=1
XM_RCN2 RC_B TS_REF RC_TAIL 0 sky130_fd_pr__nfet_g5v0d10v5 L=2 W=10 nf=2 ad=1.45 as=2.9 pd=10.58 ps=21.16 nrd=0.029 nrs=0.029 sa=0
+ sb=0 sd=0 mult=1 m=1
XM_RCD1 RC_A RC_A VIN VIN sky130_fd_pr__pfet_g5v0d10v5 L=2 W=10 nf=2 ad=1.45 as=2.9 pd=10.58 ps=21.16 nrd=0.029 nrs=0.029 sa=0
+ sb=0 sd=0 mult=1 m=1
XM_RCD2 RC_B RC_B VIN VIN sky130_fd_pr__pfet_g5v0d10v5 L=2 W=10 nf=2 ad=1.45 as=2.9 pd=10.58 ps=21.16 nrd=0.029 nrs=0.029 sa=0
+ sb=0 sd=0 mult=1 m=1
XM_RCC1 RC_A RC_B VIN VIN sky130_fd_pr__pfet_g5v0d10v5 L=2 W=17 nf=2 ad=2.465 as=4.93 pd=17.58 ps=35.16 nrd=0.0170588235294118
+ nrs=0.0170588235294118 sa=0 sb=0 sd=0 mult=1 m=1
XM_RCC2 RC_B RC_A VIN VIN sky130_fd_pr__pfet_g5v0d10v5 L=2 W=17 nf=2 ad=2.465 as=4.93 pd=17.58 ps=35.16 nrd=0.0170588235294118
+ nrs=0.0170588235294118 sa=0 sb=0 sd=0 mult=1 m=1
XM_RCEA RC_A EN VIN VIN sky130_fd_pr__pfet_g5v0d10v5 L=0.5 W=2 nf=1 ad=0.58 as=0.58 pd=4.58 ps=4.58 nrd=0.145 nrs=0.145 sa=0 sb=0
+ sd=0 mult=1 m=1
XM_RCEB RC_B EN VIN VIN sky130_fd_pr__pfet_g5v0d10v5 L=0.5 W=2 nf=1 ad=0.58 as=0.58 pd=4.58 ps=4.58 nrd=0.145 nrs=0.145 sa=0 sb=0
+ sd=0 mult=1 m=1
XM_RCOP TS_CMP RC_A VIN VIN sky130_fd_pr__pfet_g5v0d10v5 L=1 W=2 nf=1 ad=0.58 as=0.58 pd=4.58 ps=4.58 nrd=0.145 nrs=0.145 sa=0
+ sb=0 sd=0 mult=1 m=1
XM_RCOS TS_CMP NB AMP_ENN 0 sky130_fd_pr__nfet_g5v0d10v5 L=2 W=0.5 nf=1 ad=0.145 as=0.145 pd=1.58 ps=1.58 nrd=0.58 nrs=0.58 sa=0
+ sb=0 sd=0 mult=1 m=1
XM_RCEO TS_CMP EN VIN VIN sky130_fd_pr__pfet_g5v0d10v5 L=0.5 W=2 nf=1 ad=0.58 as=0.58 pd=4.58 ps=4.58 nrd=0.145 nrs=0.145 sa=0
+ sb=0 sd=0 mult=1 m=1
.ends

.control
save all
* --- leg 1: 50 mA operating point (RFORCE open) -- the clamp must be OFF ---
* Initial-condition contract (sim/README.md, issue #171; converted by issue #177):
* this leg used to be a bare unseeded `op`, which VEN's dc value ('vsup') solved
* with the loop already fully enabled -- exactly the from-nowhere Newton start the
* contract forbids. It is now a `tran ... uic` whose EN edge at t=100-101us brings
* the block up through its own soft-start ramp: the contract's first accepted
* shape (uic + an EN edge), the same one sim/mc-output-accuracy uses post-#164.
* The `uic` keyword is load-bearing and NOT redundant with VEN's pwl starting at
* 0 V: ngspice performs a transient operating-point solve before a non-uic tran,
* and for a source that carries BOTH a dc value and a transient function that
* solve uses the DC VALUE -- ngspice says so itself, on stderr, every run:
*   Note: ven: dc value used for op instead of transient time=0 value.
* so a non-uic tran here would still solve the fully-enabled, loop-closed state
* from ngspice's own guess (issue #177 measured that solve tripping
* `Warning: Dynamic gmin stepping failed` at tt/27C/3.30V, i.e. corner-run.py's
* solver-diagnostic FAIL gate) even though the transient WAVEFORM does start from
* the pwl's t=0 value. `uic` skips that solve outright.
* 5 us max timestep (leg 3 keeps 500 ns because it has to resolve the 1 us
* short edge; this leg has no fast event, so it uses the same 5 us ceiling
* sim/enable-shutdown's tran does -- the EN PWL's 100/101 us corners are
* breakpoints and are honoured regardless).
tran 5u 1.0m uic
meas tran vout_50ma avg v(vout) from=0.9m to=1.0m
meas tran vout_50ma_lo min v(vout) from=0.9m to=1.0m
meas tran vout_50ma_hi max v(vout) from=0.9m to=1.0m
meas tran vin_50ma avg v(vin) from=0.9m to=1.0m
meas tran cl_cmp_50ma avg v(xldo.cl_cmp) from=0.9m to=1.0m
* --- leg 2: DC limit characteristic, VOUT forced from 0 V up to 1.75 V ---
alter rload = 1e12
alter rforce = 1m
dc vforce 0 1.75 0.125
meas dc ilim_short find i(vforce) at=0
meas dc ilim_knee find i(vforce) at=1.75
* --- leg 3: cold EN ramp (t=100-101us), Vout=0 short applied at t=1.0ms (after soft-start settles) and HELD to t=3.0ms ---
* Also `uic`, and for exactly the reason leg 1 is (issue #177). Issue #174's audit
* recorded leg 3 as NOT exposed on the theory that a non-uic tran seeds itself from
* VEN's pwl value at t=0 (0 V, disabled). That theory is wrong about the op solve:
* #177 measured this leg, run non-uic and on its own, tripping the same
* `Warning: Dynamic gmin stepping failed` leg 1 did -- from the dc-valued transient
* operating point, before the first timestep. `uic` removes it, with bit-identical
* measurements (ish_avg -1.53348e-01 A both ways at tt/27C/3.30V).
alter rload = 36
tran 500n 3.0m uic
meas tran ipre avg i(vvin) from=0.9m to=1.0m
meas tran ish_avg avg i(vvin) from=2.0m to=3.0m
meas tran ish_max max i(vvin) from=1.1m to=3.0m
meas tran ish_min min i(vvin) from=1.1m to=3.0m
meas tran vsh_max max v(vout) from=1.1m to=3.0m
let meas_vout_50ma_v = tran1.vout_50ma
let meas_vout_50ma_span_v = tran1.vout_50ma_hi - tran1.vout_50ma_lo
let meas_cl_margin_50ma_v = tran1.vin_50ma - tran1.cl_cmp_50ma
let meas_ilim_short_ma = 1000*dc1.ilim_short
let meas_ilim_knee_ma = 1000*dc1.ilim_knee
let meas_ilim_droop_pct = 100*(dc1.ilim_knee - dc1.ilim_short)/dc1.ilim_knee
let meas_ishort_sustained_ma = -1000*tran2.ish_avg
let meas_ishort_ripple_pct = 100*(tran2.ish_max - tran2.ish_min)/(-tran2.ish_avg)
let meas_vout_short_mv = 1000*tran2.vsh_max
let meas_isup_pre_short_ma = -1000*tran2.ipre
print meas_vout_50ma_v
print meas_vout_50ma_span_v
print meas_cl_margin_50ma_v
print meas_ilim_short_ma
print meas_ilim_knee_ma
print meas_ilim_droop_pct
print meas_ishort_sustained_ma
print meas_ishort_ripple_pct
print meas_vout_short_mv
print meas_isup_pre_short_ma
quit
.endc
.end
