2AMLogic/sky130-ldo/sim/bin/_record_common.py

"""Shared `record.md` header/footer rendering for `sim/bin/corner-run.py`
and `sim/bin/mc-run.py` (issue #46).

Standard library only, matching every `render-*.py` / `*-run.py` script's
own convention. The "who/what/where" provenance framing (record id,
experiment identity, PDK/tool/repo state header; timestamp/supersedes
footer) was byte-identical modulo one Tools-line clause between the two
scripts before this module existed -- pure extraction, no behavior change.

Mirrors the `layout/bin/_record_common.py` convention from issue #41/#44
(PR #42/#45), one directory over.

Also home to `git()` (issue #51), a `-C <repo_root>` git subprocess helper
shared by `corner-run.py` and `measurements/build_characterization_report.py`
-- both previously carried byte-identical copies.

Also home to `load_corner_run_module()` (issue #96), the importlib-by-path
loader for `corner-run.py` (its filename has a hyphen, so it can't be
`import`ed directly) -- `sim/bin/mc-run.py` and
`measurements/build_characterization_report.py` previously carried
byte-identical copies of this same importlib dance.

Also home to `klt_binary()` (issue #224), the `shutil.which("klt")`
fail-fast check -- `sim/bin/mc-run.py` and `sim/bin/yield-run.py` previously
carried byte-identical copies of this function, differing only in the
trailing usage phrase of their error message.
"""

from __future__ import annotations

import hashlib
import importlib.util
import json
import os
import re
import shutil
import socket
import subprocess
import sys
import time
from pathlib import Path


def git(repo_root: Path, *args: str) -> str:
    """Run `git -C <repo_root> <args>`, returning stripped stdout on
    success or `""` on any subprocess failure (non-zero exit, missing
    git, timeout)."""
    try:
        return subprocess.run(
            ["git", "-C", str(repo_root), *args],
            capture_output=True,
            text=True,
            timeout=60,
            check=True,
        ).stdout.strip()
    except (subprocess.SubprocessError, OSError):
        return ""


# --------------------------------------------------------------------------
# effective-input fingerprint (issue #237)
# --------------------------------------------------------------------------
#
# A campaign record's schematic freshness (a live re-netlist compared against
# the committed netlist snapshot) says nothing about the OTHER inputs of a run:
# the experiment manifest's analyses, measurement expressions/bounds and
# declared matrix, and the solver settings. This block fingerprints exactly
# those, so `measurements/build_characterization_report.py` can compare a
# record against the current tree without xschem or the PDK.
#
# Every section is built from an explicit ALLOW-LIST of execution-relevant
# manifest keys (never a deny-list), so prose keys -- `claim`, `title`,
# `note`s, `corners_note`, `unit`, ... -- can be edited freely without
# invalidating a simulation. Bump INPUT_FINGERPRINT_VERSION whenever an
# allow-list or the serialization changes: the checker reports a version
# mismatch as "unverified", never as a (false) match or mismatch.

INPUT_FINGERPRINT_VERSION = 1

PVT_FINGERPRINT_SECTIONS = ("analyses", "measurements", "matrix", "solver")
MC_FINGERPRINT_SECTIONS = ("analyses", "measurements", "matrix", "netlist_patch")


def _canon(value):
    """Normalize a JSON value so numerically-equal spellings serialize alike
    (`27` vs `27.0`)."""
    if isinstance(value, bool) or value is None or isinstance(value, str):
        return value
    if isinstance(value, (int, float)):
        return int(value) if float(value).is_integer() else float(value)
    if isinstance(value, (list, tuple)):
        return [_canon(v) for v in value]
    if isinstance(value, dict):
        return {str(k): _canon(v) for k, v in value.items()}
    return str(value)


def canonical_digest(value) -> str:
    """sha256 of the deterministic (sorted-key, compact) JSON of *value*."""
    text = json.dumps(_canon(value), sort_keys=True, separators=(",", ":"), ensure_ascii=True)
    return hashlib.sha256(text.encode("utf-8")).hexdigest()


def _code_lines(lines) -> list[str]:
    """Drop whole-line `*` SPICE comments and blank lines (prose inside a
    deck's `analyses` list); every other line is execution input."""
    out = []
    for ln in lines or []:
        stripped = str(ln).strip()
        if stripped and not stripped.startswith("*"):
            out.append(stripped)
    return out


def spiceinit_sha256(text: str) -> str:
    """sha256 of an ngspice init-settings file (same digest corner-run.py
    records as `tools.spiceinit_sha256`, issue #190)."""
    return hashlib.sha256(text.encode("utf-8")).hexdigest()


def measurement_fingerprint_entry(m: dict) -> dict:
    """The fingerprinted view of one manifest measurement (issue #335).

    Legacy compatibility: `min_inclusive` / `max_inclusive` default to inclusive
    (True). They are added to the entry ONLY when present and not True, so a
    manifest that omits them, or states the default explicitly, digests exactly
    as it did before the flags existed and existing records stay fresh. Any
    non-default (strict or malformed) value enters the digest, so a
    comparison-policy-only change invalidates input freshness.
    """
    entry = {k: m.get(k) for k in ("name", "expr", "min", "max")}
    for flag in ("min_inclusive", "max_inclusive"):
        if flag in m and m[flag] is not True:
            entry[flag] = m[flag]
    return entry


def pvt_input_sections(raw: dict, spiceinit_text: str | None) -> dict[str, str]:
    """Per-dimension digests of a PVT (`corner-run.py`) manifest's effective
    inputs, plus the `sim/spiceinit` solver settings ngspice reads."""
    deck = raw.get("deck") or {}
    corners = raw.get("corners") or {}
    analyses = {
        "options": list(deck.get("options") or []),
        "params": deck.get("params") or {},
        "analyses": _code_lines(deck.get("analyses") or ["op"]),
    }
    grid = raw.get("window_grid")
    if grid:
        # issue #313: the COUT/ESR legs and their per-leg deck template are
        # execution input. Added only when declared, so every other
        # experiment's digest is unchanged.
        analyses["window_grid"] = {
            "legs": grid.get("legs"),
            "directions": grid.get("directions"),
            "leg_analyses": _code_lines(grid.get("leg_analyses")),
            "resr_park_ohm": grid.get("resr_park_ohm"),
        }
    sections = {
        "analyses": canonical_digest(analyses),
        "measurements": canonical_digest(
            {
                "measurements": [measurement_fingerprint_entry(m) for m in raw.get("measurements") or []],
                "spread_checks": [
                    {k: c.get(k) for k in ("measurement", "min_spread")}
                    for c in raw.get("spread_checks") or []
                ],
            }
        ),
        "matrix": canonical_digest(
            {
                "process": corners.get("process"),
                "temperature_c": corners.get("temperature_c"),
                "supply_v": corners.get("supply_v"),
                "quick_subset": raw.get("quick_subset"),
            }
        ),
    }
    if raw.get("ramp_monotonicity"):
        sections["ramp_monotonicity"] = canonical_digest(raw["ramp_monotonicity"])
    if spiceinit_text is not None:
        sections["solver"] = spiceinit_sha256(spiceinit_text)
    return sections


def mc_input_sections(raw: dict) -> dict[str, str]:
    """Per-dimension digests of a Monte Carlo (`mc-run.py`) manifest's
    effective inputs.

    No `solver` section, deliberately: the klt backend runs ngspice under its
    own configuration and this harness cannot show it reads `sim/spiceinit`,
    so claiming that file as an MC input would be a fabricated dependency.
    The sample count / vary / k_sigma / seed are CLI-overridable, so they are
    recorded in the record's own `monte_carlo_request`, not fingerprinted
    against the manifest's defaults.
    """
    corner = raw.get("mc_corner") or {}
    analysis = raw.get("mc_analysis") or {}
    patch = raw.get("netlist_patch")
    return {
        "analyses": canonical_digest({k: v for k, v in analysis.items() if k in ("kind", "args")}),
        "measurements": canonical_digest(
            [
                {"name": m.get("name"), "spice": m.get("spice"), "limits": m.get("limits")}
                for m in raw.get("mc_measurements") or []
            ]
        ),
        "matrix": canonical_digest(
            {k: corner.get(k) for k in ("process", "temperature_c", "vsup")}
        ),
        "netlist_patch": canonical_digest(
            None
            if not patch
            else [
                {k: s.get(k) for k in ("match", "replace", "count")}
                for s in patch.get("substitutions") or []
            ]
        ),
    }


def build_input_fingerprint(kind: str, sections: dict[str, str]) -> dict:
    """The record's `input_fingerprint` block: version, backend kind
    (`pvt` | `mc`), per-dimension digests, and one overall digest."""
    return {
        "version": INPUT_FINGERPRINT_VERSION,
        "kind": kind,
        "sections": dict(sections),
        "sha256": canonical_digest({"version": INPUT_FINGERPRINT_VERSION, "kind": kind, "sections": sections}),
    }


def load_corner_run_module(bin_dir: Path):
    """Import `corner-run.py` by file path and return the loaded module.

    `corner-run.py`'s filename has a hyphen, so it can't be `import`ed
    directly -- this is the importlib-by-path workaround, shared by
    `sim/bin/mc-run.py` and `measurements/build_characterization_report.py`
    (issue #96).

    `bin_dir` is the directory containing `corner-run.py` (`sim/bin/`). It is
    inserted at the front of `sys.path` (if not already present) so that
    `corner-run.py`'s own `from _record_common import ...` resolves, then the
    module is loaded, registered as `sys.modules["corner_run"]` (`dataclass()`
    needs this in `sys.modules` to resolve), and executed.
    """
    bin_dir_str = str(bin_dir)
    if bin_dir_str not in sys.path:
        sys.path.insert(0, bin_dir_str)
    spec = importlib.util.spec_from_file_location("corner_run", Path(bin_dir) / "corner-run.py")
    module = importlib.util.module_from_spec(spec)
    sys.modules["corner_run"] = module
    spec.loader.exec_module(module)  # type: ignore[union-attr]
    return module


def klt_binary(usage_context: str, error_cls: type[Exception] = RuntimeError) -> str:
    """Return the path to the `klt` binary on `PATH`, or raise `error_cls`
    with an install hint if it is missing.

    `usage_context` is the trailing phrase describing what the caller needs
    `klt` for (e.g. `"run Monte Carlo experiments"`), since that's the one
    part of the error message that differs between callers. `error_cls`
    lets each caller preserve its own exception type for an existing
    `except HarnessError` handler (`mc-run.py` uses `corner_run.HarnessError`;
    `yield-run.py` defines its own `HarnessError`).
    """
    exe = shutil.which("klt")
    if not exe:
        raise error_cls(
            "klt not found on PATH; install klayout-tools "
            f"(https://github.com/2AMLogic/klayout-tools) to {usage_context}"
        )
    return exe


JOB_ID_RE = re.compile(r"klt-sim-[0-9a-f]+")

# Shared-fleet saturation (issue #345): the only failure retried. The refusal
# happens at launch, before a job exists, so a resubmit cannot double-run.
CAPACITY_REFUSAL_TEXT = "exceeds BATCH_MAX_CONCURRENT_INSTANCES"
CAPACITY_RETRY_BACKOFF_S = 90
CAPACITY_RETRY_BUDGET_S = 3 * 3600


def run_klt_sim(
    request_path: Path,
    outdir: Path,
    backend: str,
    pdk_root: Path | None = None,
    *,
    klt_exe: str,
    error_cls: type[Exception] = RuntimeError,
    retry_capacity: bool = False,
    extra_args: tuple[str, ...] = (),
    resolve_paths: bool = False,
    require_corners: bool = True,
) -> tuple[dict, dict]:
    """Invoke `klt sim` once (never replaced by a local run) and return
    `(response, meta)`; the one shared copy of what five scripts re-implemented.

    `klt_exe` comes from the caller's `klt_binary(...)` wrapper (which owns
    the install-hint wording and exception type). `pdk_root`, when given, is
    exported as `PDK_ROOT` (issue #211). `klt.stdout`/`klt.stderr` are always
    persisted in `outdir`, and the stdout JSON must be an object; with
    `require_corners` (default) it must also hold a `corners` list, so an
    error envelope is refused rather than read as a sim result.

    `retry_capacity` retries ONLY a fleet-cap refusal (`CAPACITY_REFUSAL_TEXT`
    with no job id seen) every `CAPACITY_RETRY_BACKOFF_S` for at most
    `CAPACITY_RETRY_BUDGET_S`; any other failure is fatal and unretried.
    `resolve_paths` makes `request_path`/`outdir` absolute (a relative `-o`
    breaks klt's per-corner cwd, klayout-tools#2892). Raises `error_cls`,
    keeping whatever stdout/stderr/job ids exist. `meta` is `returncode`,
    `cmd` and `job_ids_seen`.
    """
    if resolve_paths:
        request_path, outdir = request_path.resolve(), outdir.resolve()
    cmd = [
        klt_exe, "sim", str(request_path), "-o", str(outdir),
        "--backend", backend, "--format", "json", *extra_args,
    ]
    env = None
    if pdk_root is not None:
        env = dict(os.environ)
        env["PDK_ROOT"] = str(pdk_root)
    outdir.mkdir(parents=True, exist_ok=True)

    def job_ids(stdout: str, stderr: str) -> list[str]:
        return list(dict.fromkeys(JOB_ID_RE.findall((stdout or "") + "\n" + (stderr or ""))))

    def diag(stdout: str, stderr: str) -> str:
        (outdir / "klt.stdout").write_text(stdout or "")
        (outdir / "klt.stderr").write_text(stderr or "")
        ids = job_ids(stdout, stderr)
        return (
            f"  cmd: {' '.join(cmd)}\n"
            f"  remote job id(s) seen: {', '.join(ids) if ids else 'none'}\n"
            f"  stdout: {(stdout or '').strip()[:2000]}\n"
            f"  stderr: {(stderr or '').strip()[:2000]}\n"
            f"  diagnostics kept in {outdir}"
        )

    def launch() -> subprocess.CompletedProcess:
        return subprocess.run(
            cmd, capture_output=True, text=True, timeout=None, env=env,
            stdin=subprocess.DEVNULL,
        )

    def capacity_refused(p: subprocess.CompletedProcess) -> bool:
        text = (p.stdout or "") + "\n" + (p.stderr or "")
        return (
            p.returncode != 0
            and CAPACITY_REFUSAL_TEXT in text
            and not JOB_ID_RE.search(text)
        )

    try:
        proc = launch()
        attempts, waited = 1, 0
        while retry_capacity and capacity_refused(proc):
            if waited + CAPACITY_RETRY_BACKOFF_S > CAPACITY_RETRY_BUDGET_S:
                raise error_cls(
                    f"klt sim ({backend}) refused for fleet capacity on all {attempts} "
                    f"attempt(s) over {waited} s (budget {CAPACITY_RETRY_BUDGET_S} s); "
                    "NOT falling back to a local run\n" + diag(proc.stdout, proc.stderr)
                )
            time.sleep(CAPACITY_RETRY_BACKOFF_S)
            waited += CAPACITY_RETRY_BACKOFF_S
            attempts += 1
            proc = launch()
    except subprocess.TimeoutExpired as exc:
        def _s(v):
            return v.decode(errors="replace") if isinstance(v, bytes) else (v or "")
        raise error_cls(
            f"klt sim ({backend}) timed out; NOT resubmitting and NOT falling back to a "
            "local run -- the remote job may still be running\n"
            + diag(_s(exc.stdout), _s(exc.stderr))
        ) from exc
    except OSError as exc:
        raise error_cls(f"could not launch klt sim: {exc}") from exc
    if not proc.stdout.strip():
        raise error_cls(
            f"klt sim produced no stdout (rc {proc.returncode})\n" + diag(proc.stdout, proc.stderr)
        )
    try:
        response = json.loads(proc.stdout)
    except json.JSONDecodeError as exc:
        raise error_cls(
            f"klt sim produced non-JSON stdout ({exc}; rc {proc.returncode})\n"
            + diag(proc.stdout, proc.stderr)
        ) from exc
    detail = diag(proc.stdout, proc.stderr)
    if not isinstance(response, dict) or (
        require_corners and not isinstance(response.get("corners"), list)
    ):
        raise error_cls(
            f"klt sim returned an error envelope / non-sim response (rc {proc.returncode})\n"
            + detail
        )
    return response, {
        "returncode": proc.returncode,
        "cmd": cmd,
        "job_ids_seen": job_ids(proc.stdout, proc.stderr),
    }


def assert_klt_read_the_pinned_pdk(
    response: dict,
    pdk,
    pin: dict,
    allow_mismatch: bool,
    error_cls: type[Exception] = RuntimeError,
) -> None:
    """Check `klt sim`'s OWN provenance names the PDK this harness pinned.

    The pre-run `resolve_pdk()`/`matches_pin` check (issue #2) verifies the
    install *this harness* resolved. It says nothing about the one `klt`
    resolved, and before issue #211 nothing did: `run_klt_sim` passed no
    `PDK_ROOT`, the request's `models.lib` is relative, and on a host with two
    sky130A installs `klt` read the other one -- so a record could name the
    pinned open_pdks commit while the simulation behind it read a different
    build's FET cards. Passing `PDK_ROOT` fixes the cause; this asserts the
    effect, because a provenance claim nothing checks is the kind that rots
    silently. `allow_mismatch` (`--allow-pdk-mismatch`) downgrades it to a
    warning, the same escape hatch the pre-run check offers. Missing
    provenance counts as a mismatch: absent evidence never implies a pin.

    Shared by `mc-run.py` and `corner-run.py --backend batch` (issue #298).
    """
    claimed = ((response.get("provenance") or {}).get("pdk") or {}).get("version") or ""
    if pin["open_pdks_commit"] in claimed:
        return
    message = (
        f"klt sim's own provenance.pdk.version is {claimed!r}, which does not name "
        f"sim/pdk.json's pinned open_pdks commit {pin['open_pdks_commit']}\n"
        f"  this harness resolved: {pdk.dir}\n"
        "  klt resolved something else -- the record's `pdk` block would name the "
        "pin while the simulation read a different model build. Set PDK_ROOT "
        "explicitly, or remove the competing install"
    )
    if not allow_mismatch:
        raise error_cls(message)
    print(f"WARNING: {message}", file=sys.stderr)


def render_record_header(record: dict, tools_line: str) -> list[str]:
    """Render the shared Record ID/Experiment/Claim/Netlist provenance/PDK/
    Tools/Repo state header lines common to both runners' `record.md`.

    `tools_line` is the already-formatted `- **Tools**: ...` value, since
    that's the one line whose content differs between the two callers
    (`mc-run.py` adds a `klt {version}` clause `corner-run.py` doesn't have).
    """
    r = record
    lines = [f"# Record {r['record_id']}", ""]
    lines.append(f"- **Record ID**: {r['record_id']}")
    lines.append(f"- **Experiment**: `{r['experiment']['slug']}` — {r['experiment']['title']}")
    lines.append(f"- **Claim**: {r['experiment']['claim']}")
    lines.append(
        f"- **Netlist provenance**: {r['experiment']['provenance']} "
        f"(`{r['experiment']['provenance_source']}`)"
    )
    pdk = r["pdk"]
    pin_state = "matches sim/pdk.json pin" if pdk["matches_pin"] else "**MISMATCH vs sim/pdk.json pin**"
    lines.append(
        f"- **PDK**: {pdk['variant']} @ open_pdks `{pdk['installed_commit']}` ({pin_state}); "
        f"models `{pdk['lib_file']}`"
    )
    lines.append(f"- **Tools**: {tools_line}")
    lines.append(
        f"- **Repo state**: `{r['git']['sha']}` on `{r['git']['branch']}`"
        + (" (working tree dirty at run time)" if r["git"]["dirty"] else " (clean working tree)")
    )
    return lines


def render_record_footer(record: dict, script_name: str) -> list[str]:
    """Render the shared Timestamp/Supersedes/Written-by footer lines common
    to both runners' `record.md`, parameterized by the writing script's name
    (e.g. `"corner-run.py"`) for the append-only-evidence note."""
    r = record
    lines = [f"- **Timestamp / author**: {r['timestamp']}, {r['author']}"]
    lines.append(f"- **Supersedes**: {r['supersedes'] or '(none)'}")
    lines.append("")
    lines.append(
        f"Written by `sim/bin/{script_name}`. Append-only: never edit this file — "
        "a correction is a new record with a `Supersedes` field (see `sim/README.md`)."
    )
    lines.append("")
    return lines


# --------------------------------------------------------------------------
# atomic record-ID reservation + exclusive publication (issue #310)
# --------------------------------------------------------------------------
#
# Record IDs are second-resolution UTC time + short SHA, so two invocations
# for the same experiment in the same second pick the same ID. An
# "exists()" pre-check cannot close that window (check-then-act), so each
# runner takes an exclusive reservation -- an atomic `mkdir` under the
# git-ignored scratch tree -- BEFORE creating any scratch directory or
# evidence. The loser fails before netlisting or submission. Publication then
# refuses replacement too (`write_new_text` / `copy_new`, O_EXCL) as a second
# defence. Reservations are never released or deleted by the tools: a consumed
# ID stays consumed (see sim/README.md "Concurrent and interrupted runs").

RESERVATION_DIRNAME = ".reservations"


def reserve_record_id(build_dir: Path, experiment: str, record_id: str, error_cls=RuntimeError) -> Path:
    """Atomically reserve `record_id` for `experiment` (the experiment
    directory name). Returns the reservation directory. Raises `error_cls`
    if another invocation already holds it. Never touches an existing
    reservation."""
    parent = Path(build_dir) / RESERVATION_DIRNAME / experiment
    parent.mkdir(parents=True, exist_ok=True)
    resv = parent / record_id
    try:
        resv.mkdir()  # atomic: exactly one concurrent caller succeeds
    except FileExistsError:
        owner = ""
        try:
            owner = (resv / "owner.json").read_text().strip()
        except OSError:
            pass
        raise error_cls(
            f"record id {record_id} for experiment {experiment} is already reserved "
            f"({resv}{'; owner ' + owner if owner else ''}) -- another run holds it or "
            "was interrupted; wait a second and re-run to mint a fresh id. "
            "Reservations are never removed automatically (sim/README.md)"
        ) from None
    (resv / "owner.json").write_text(
        json.dumps({"pid": os.getpid(), "host": socket.gethostname(), "time": time.time()}) + "\n"
    )
    return resv


def write_new_text(path: Path, text: str) -> None:
    """Write `text` to `path`, refusing (FileExistsError) to replace it."""
    with open(path, "x") as fh:
        fh.write(text)


def copy_new(src, dest: Path) -> None:
    """Copy `src` to `dest`, refusing (FileExistsError) to replace it."""
    with open(src, "rb") as fi, open(dest, "xb") as fo:
        shutil.copyfileobj(fi, fo)


# ---- thermal trip/release search helpers (issue #297) ----------------------
# Shared by sim/thermal/run_hysteresis.py and sim/thermal-regen-cmp/run_demo.py.


def read_dat(path: Path, names):
    """Parse an ngspice `wrdata` file: (time, value) column pairs, one pair per
    vector in `names` order. Returns (time vector from column 0, {name: values})."""
    rows = [list(map(float, ln.split())) for ln in path.read_text().splitlines() if ln.strip()]
    t = [r[0] for r in rows]
    return t, {n: [r[2 * i + 1] for r in rows] for i, n in enumerate(names)}


def at(t, y, t_us):
    """Nearest-sample value of `y` at `t_us` microseconds (no interpolation;
    ties pick the first index, out-of-range targets pick an endpoint)."""
    target = t_us * 1e-6
    best = min(range(len(t)), key=lambda i: abs(t[i] - target))
    return y[best]


def tripped(v_cmp: float, supply_v: float) -> bool:
    """Comparator output counts as tripped when strictly below half-supply."""
    return v_cmp < supply_v / 2


def bisect(pred, lo, hi, tol, want_lowest):
    """pred is monotone: for want_lowest, False..False True..True over [lo,hi]
    (find the lowest True); otherwise True..True False..False (highest True)."""
    assert pred(hi) if want_lowest else pred(lo), "bracket end does not satisfy predicate"
    assert (not pred(lo)) if want_lowest else (not pred(hi)), "bracket other end already satisfies predicate"
    while hi - lo > tol:
        mid = round((lo + hi) / 2, 4)
        ok = pred(mid)
        if want_lowest:
            lo, hi = (lo, mid) if ok else (mid, hi)
        else:
            lo, hi = (mid, hi) if ok else (lo, mid)
    return lo, hi
