2AMLogic/sky130-ldo/sim/tests/test_mc_run.py

"""Unit coverage for sim/bin/mc-run.py's pure helper functions.

PDK-free by design (no ngspice/xschem/volare/klt required) so this runs on
every `npm run check:ci` invocation, including in CI where the sky130 PDK is
not installed -- see sim/selftest.sh stage 1/3, and the sibling
test_corner_run.py this file mirrors.

mc-run.py is loaded by file path (not `import mc_run`) because the CLI
convention keeps the hyphenated `mc-run.py` filename, exactly as
test_corner_run.py does for `corner-run.py`.

Scope (issue #217): the three pure helpers PR #216 grew without coverage --
`validate_netlist_patch`, `apply_netlist_patch` and
`assert_klt_read_the_pinned_pdk`. The first two are the `netlist_patch`
negative-control machinery from issue #211, whose whole value is that it
refuses to run rather than quietly sampling an undegraded circuit; the third
asserts `klt sim`'s own provenance names the pinned PDK. Each one's job is to
raise, so each `HarnessError` branch is covered here rather than just the
happy path.
"""

from __future__ import annotations

import contextlib
import hashlib
import importlib.util
import io
import sys
import unittest
from pathlib import Path

SIM_DIR = Path(__file__).resolve().parent.parent
sys.path.insert(0, str(SIM_DIR / "bin"))  # mc-run.py imports _record_common (issue #46)
_spec = importlib.util.spec_from_file_location("mc_run", SIM_DIR / "bin" / "mc-run.py")
mc_run = importlib.util.module_from_spec(_spec)
sys.modules["mc_run"] = mc_run
_spec.loader.exec_module(mc_run)

MANIFEST = Path("sim/mc-fixture/experiment.json")


def _patch(**overrides) -> dict:
    """A minimal well-formed `netlist_patch` block, with overrides applied."""
    patch = {
        "purpose": "negative control",
        "rationale": "halve the pass device width so the loop cannot regulate",
        "substitutions": [{"match": "W=10u", "replace": "W=5u", "count": 1}],
    }
    patch.update(overrides)
    return patch


class TestValidateNetlistPatch(unittest.TestCase):
    def test_none_is_a_no_op(self):
        self.assertIsNone(mc_run.validate_netlist_patch(None, MANIFEST))

    def test_well_formed_patch_passes(self):
        self.assertIsNone(mc_run.validate_netlist_patch(_patch(), MANIFEST))

    def test_multiple_substitutions_pass(self):
        patch = _patch(
            substitutions=[
                {"match": "W=10u", "replace": "W=5u", "count": 2},
                {"match": "L=0.5u", "replace": "L=1u", "count": 1},
            ]
        )
        self.assertIsNone(mc_run.validate_netlist_patch(patch, MANIFEST))

    def test_non_dict_patch_rejected(self):
        with self.assertRaisesRegex(mc_run.HarnessError, "must be an object"):
            mc_run.validate_netlist_patch(["not", "a", "dict"], MANIFEST)

    def test_missing_purpose_rejected(self):
        patch = _patch()
        del patch["purpose"]
        with self.assertRaisesRegex(mc_run.HarnessError, "missing 'purpose'"):
            mc_run.validate_netlist_patch(patch, MANIFEST)

    def test_missing_rationale_rejected(self):
        patch = _patch()
        del patch["rationale"]
        with self.assertRaisesRegex(mc_run.HarnessError, "missing 'rationale'"):
            mc_run.validate_netlist_patch(patch, MANIFEST)

    def test_empty_rationale_rejected(self):
        # A declared defect with a blank rationale is exactly the prose-free
        # patch the manifest convention exists to prevent.
        with self.assertRaisesRegex(mc_run.HarnessError, "missing 'rationale'"):
            mc_run.validate_netlist_patch(_patch(rationale=""), MANIFEST)

    def test_missing_substitutions_rejected(self):
        patch = _patch()
        del patch["substitutions"]
        with self.assertRaisesRegex(mc_run.HarnessError, "missing 'substitutions'"):
            mc_run.validate_netlist_patch(patch, MANIFEST)

    def test_empty_substitutions_rejected(self):
        with self.assertRaisesRegex(mc_run.HarnessError, "missing 'substitutions'"):
            mc_run.validate_netlist_patch(_patch(substitutions=[]), MANIFEST)

    def test_non_list_substitutions_rejected(self):
        patch = _patch(substitutions={"match": "a", "replace": "b", "count": 1})
        with self.assertRaisesRegex(mc_run.HarnessError, "substitutions must be an array"):
            mc_run.validate_netlist_patch(patch, MANIFEST)

    def test_non_dict_substitution_entry_rejected(self):
        patch = _patch(substitutions=["W=10u -> W=5u"])
        with self.assertRaisesRegex(
            mc_run.HarnessError, r"substitutions\[0\] must be an object"
        ):
            mc_run.validate_netlist_patch(patch, MANIFEST)

    def test_missing_match_rejected(self):
        patch = _patch(substitutions=[{"replace": "W=5u", "count": 1}])
        with self.assertRaisesRegex(
            mc_run.HarnessError, r"substitutions\[0\]\.match must be a non-empty string"
        ):
            mc_run.validate_netlist_patch(patch, MANIFEST)

    def test_empty_match_rejected(self):
        patch = _patch(substitutions=[{"match": "", "replace": "W=5u", "count": 1}])
        with self.assertRaisesRegex(
            mc_run.HarnessError, r"substitutions\[0\]\.match must be a non-empty string"
        ):
            mc_run.validate_netlist_patch(patch, MANIFEST)

    def test_non_string_match_rejected(self):
        patch = _patch(substitutions=[{"match": 10, "replace": "W=5u", "count": 1}])
        with self.assertRaisesRegex(
            mc_run.HarnessError, r"substitutions\[0\]\.match must be a non-empty string"
        ):
            mc_run.validate_netlist_patch(patch, MANIFEST)

    def test_missing_replace_rejected(self):
        patch = _patch(substitutions=[{"match": "W=10u", "count": 1}])
        with self.assertRaisesRegex(
            mc_run.HarnessError, r"substitutions\[0\]\.replace must be a non-empty string"
        ):
            mc_run.validate_netlist_patch(patch, MANIFEST)

    def test_empty_replace_rejected(self):
        patch = _patch(substitutions=[{"match": "W=10u", "replace": "", "count": 1}])
        with self.assertRaisesRegex(
            mc_run.HarnessError, r"substitutions\[0\]\.replace must be a non-empty string"
        ):
            mc_run.validate_netlist_patch(patch, MANIFEST)

    def test_no_op_substitution_rejected(self):
        # "a declared defect that changes nothing is worse than no defect at
        # all" -- the reason match == replace is a hard error, not a warning.
        patch = _patch(substitutions=[{"match": "W=10u", "replace": "W=10u", "count": 1}])
        with self.assertRaisesRegex(mc_run.HarnessError, r"is a no-op \(match == replace\)"):
            mc_run.validate_netlist_patch(patch, MANIFEST)

    def test_missing_count_rejected(self):
        patch = _patch(substitutions=[{"match": "W=10u", "replace": "W=5u"}])
        with self.assertRaisesRegex(
            mc_run.HarnessError, r"substitutions\[0\]\.count must be a positive integer"
        ):
            mc_run.validate_netlist_patch(patch, MANIFEST)

    def test_zero_count_rejected(self):
        patch = _patch(substitutions=[{"match": "W=10u", "replace": "W=5u", "count": 0}])
        with self.assertRaisesRegex(
            mc_run.HarnessError, r"substitutions\[0\]\.count must be a positive integer"
        ):
            mc_run.validate_netlist_patch(patch, MANIFEST)

    def test_negative_count_rejected(self):
        patch = _patch(substitutions=[{"match": "W=10u", "replace": "W=5u", "count": -1}])
        with self.assertRaisesRegex(
            mc_run.HarnessError, r"substitutions\[0\]\.count must be a positive integer"
        ):
            mc_run.validate_netlist_patch(patch, MANIFEST)

    def test_non_integer_count_rejected(self):
        patch = _patch(substitutions=[{"match": "W=10u", "replace": "W=5u", "count": 1.0}])
        with self.assertRaisesRegex(
            mc_run.HarnessError, r"substitutions\[0\]\.count must be a positive integer"
        ):
            mc_run.validate_netlist_patch(patch, MANIFEST)

    def test_second_substitution_is_reported_by_its_own_index(self):
        patch = _patch(
            substitutions=[
                {"match": "W=10u", "replace": "W=5u", "count": 1},
                {"match": "L=0.5u", "replace": "L=0.5u", "count": 1},
            ]
        )
        with self.assertRaisesRegex(mc_run.HarnessError, r"substitutions\[1\] is a no-op"):
            mc_run.validate_netlist_patch(patch, MANIFEST)

    def test_error_message_names_the_manifest(self):
        with self.assertRaises(mc_run.HarnessError) as ctx:
            mc_run.validate_netlist_patch(_patch(purpose=""), MANIFEST)
        self.assertIn(str(MANIFEST), str(ctx.exception))


DECK = "\n".join(
    [
        "* fixture deck",
        "XM1 vout vg vin vin pfet_g5v0d10v5 W=10u L=0.5u",
        "XM2 vout vg vin vin pfet_g5v0d10v5 W=10u L=0.5u",
        ".end",
    ]
)
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
