2AMLogic/sky130-ldo/sim/tests/test_check_xschem_duplicate_instance_names.py

"""Fixture-based coverage for
.loom/scripts/check-xschem-duplicate-instance-names.sh (#38).

PDK-free by design (no ngspice/xschem/volare required, just `git` + `bash`)
so this runs on every `npm run check:ci` invocation, including in CI where
the sky130 PDK is not installed.

Each test builds a throwaway git repository under a temp dir with a
`design/*.sch` fixture, then invokes the real script against it (passing the
fixture repo root as the script's ROOT argument) and asserts on exit code +
stderr content -- mirroring how `npm run check:ci` actually runs it against
this repo's own `design/ldo_3v3in_1v8out.sch`.
"""

from __future__ import annotations

import subprocess
import tempfile
import unittest
from pathlib import Path

REPO_ROOT = Path(__file__).resolve().parent.parent.parent
SCRIPT = REPO_ROOT / ".loom" / "scripts" / "check-xschem-duplicate-instance-names.sh"


def _make_fixture_repo(tmp_path: Path, sch_body: str) -> Path:
    """Create a throwaway git repo under tmp_path with design/fixture.sch
    containing sch_body, and return the repo root. The script scans tracked
    files (`git ls-files`), so the fixture must be committed.
    """
    repo = tmp_path / "repo"
    (repo / "design").mkdir(parents=True)
    (repo / "design" / "fixture.sch").write_text(sch_body)

    subprocess.run(["git", "init", "-q"], cwd=repo, check=True)
    subprocess.run(["git", "config", "user.email", "test@example.com"], cwd=repo, check=True)
    subprocess.run(["git", "config", "user.name", "test"], cwd=repo, check=True)
    subprocess.run(["git", "add", "-A"], cwd=repo, check=True)
    subprocess.run(["git", "commit", "-q", "-m", "fixture"], cwd=repo, check=True)
    return repo


def _run_check(root: Path) -> subprocess.CompletedProcess:
    return subprocess.run(
        ["bash", str(SCRIPT), str(root)],
        capture_output=True,
        text=True,
    )


class TestCheckXschemDuplicateInstanceNames(unittest.TestCase):
    def test_script_exists_and_is_executable(self):
        self.assertTrue(SCRIPT.is_file(), f"missing {SCRIPT}")

    def test_no_duplicates_passes(self):
        sch = (
            'C {sky130_fd_pr/pfet_g5v0d10v5.sym} 0 -1300 0 0 {name=M_ENP2\n'
            "L=0.5\n"
            "W=10\n"
            "spiceprefix=X}\n"
            'C {sky130_fd_pr/pfet_g5v0d10v5.sym} 600 -1600 0 0 {name=M_ENP\n'
            "L=0.5\n"
            "W=2\n"
            "spiceprefix=X}\n"
            'C {sky130_fd_pr/pfet_g5v0d10v5.sym} 1700 -1600 0 0 {name=M_ENP3\n'
            "L=0.5\n"
            "W=2\n"
            "spiceprefix=X}\n"
        )
        with tempfile.TemporaryDirectory() as td:
            repo = _make_fixture_repo(Path(td), sch)
            result = _run_check(repo)
        self.assertEqual(result.returncode, 0, msg=result.stderr)
        self.assertIn("OK", result.stdout)

    def test_duplicate_instance_name_fails_with_clear_message(self):
        # Reproduces the original #35/#36 incident: two M_ENP4 instances on
        # different nets in the same schematic.
        sch = (
            'C {sky130_fd_pr/pfet_g5v0d10v5.sym} 3000 -1300 0 0 {name=M_ENP4\n'
            "L=0.5\n"
            "W=2\n"
            "spiceprefix=X}\n"
            'C {sky130_fd_pr/pfet_g5v0d10v5.sym} 3200 -2500 0 0 {name=M_ENP4\n'
            "L=0.5\n"
            "W=2\n"
            "spiceprefix=X}\n"
        )
        with tempfile.TemporaryDirectory() as td:
            repo = _make_fixture_repo(Path(td), sch)
            result = _run_check(repo)
        self.assertEqual(result.returncode, 1)
        self.assertIn("DUPLICATE INSTANCE NAME", result.stderr)
        self.assertIn("M_ENP4", result.stderr)
        self.assertIn("design/fixture.sch", result.stderr)

    def test_single_line_duplicate_also_fails(self):
        sch = (
            "C {devices/lab_pin.sym} 0 -70 0 0 {name=p_rbias1 lab=VIN}\n"
            "C {devices/lab_pin.sym} -20 -100 0 0 {name=p_rbias1 lab=0}\n"
        )
        with tempfile.TemporaryDirectory() as td:
            repo = _make_fixture_repo(Path(td), sch)
            result = _run_check(repo)
        self.assertEqual(result.returncode, 1)
        self.assertIn("p_rbias1", result.stderr)
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
