2AMLogic/sky130-ldo/(commit log)

2026-08-14 feat: stand up the xschem+ngspice sim harness and klt trivial-cell flow (#3)
    Ports sky130-bandgap's PVT corner runner (sim/bin/corner-run.py, adding
    --check-env and --no-write) and gf180-ldo's selftest.sh convention to build
    a real, PDK-pinned sim/pdk-smoke liveness testbench and its first append-only
    evidence record (45-point full PVT matrix, PASS). Ports sky130-bandgap's klt
    gen/drc/extract/lvs trivial-cell flow unmodified in shape, proving DRC-clean
    and LVS match/mismatch (including both negative controls) against this
    repo's own sky130 PDK pin. Wires package.json check:ci/test and
    .github/workflows/ci.yml (previously copied verbatim from sky130-bandgap
    with dangling bandgap-only script/t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
    [tb_pdk_smoke.sch]
2026-08-14 docs(spec): argue the sky130 pass-device framing in DR-001, add DR template (#6)
    Adds spec/decision-records/DR-001-pass-device-supply-framing.md (Status:
    proposed) as the argued input the operator-only ratification issue #1 rules
    on. It recommends the 5.0 V pass device (pfet_g5v0d10v5) over an all-1.8 V
    core re-scope, on the grounds that a 3.3 V +/-10% rail puts ~2x the core
    device's 1.8 V terminal rating on the pass element's gate oxide and (during a
    short) its drain -- a rating violation rather than a trade-off -- while the
    5 V device's 10.5 V drain rating covers the short-survival row outright.
    The price of that framing is quantified from the pinned PDK (sky130A,
    open_pdks c6d73a3) rathe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
2026-08-14 docs(spec): stamp DR-001 ratified, update framing note per #1 ruling (#9)
    Operator ruling on #1 (2026-08-14) ratified DR-001's framing (A):
    pass device sky130_fd_pr__pfet_g5v0d10v5, 3.3 V +/-10% in / 1.8 V out /
    0-50 mA, port parity with 2AMLogic/gf180-ldo. Record the ratification
    in DR-001's status line and an appended status-notes paragraph, flip
    target-spec.md's framing section from "must be resolved" to "ratified
    per DR-001/#1", and cross-link the ruling from README's port-parity
    section. Every numeric row in target-spec.md keeps its DRAFT marker --
    only the framing question is ratified; #1 remains open as the gate for
    the numeric rows.
2026-08-15 docs(spec): draft DR-002/003/004 — ESR window, device characterization, corner-model names (#10) (#11)
    Three proposed decision records completing #1's remaining ratification
    inputs, built on DR-001's ratified pass-device framing:
    - DR-002 mirrors gf180-ldo's DR-0001 C_out/ESR window (0.33-4.7uF,
    0-500mOhm, no minimum ESR) as sky130-ldo's starting point, while flagging
    the stability risk sky130's larger pass-gate capacitance creates for that
    posture (gf180-ldo's own record names this exact risk under a 5V pass
    device).
    - DR-003 extends DR-001's screening deck across the full {tt,ss,ff,sf,fs} x
    {-40,27,125}C grid at the dropout and nominal bias points, refining the
    pass-device s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
2026-08-17 feat(design): add sky130 LDO core-regulation-loop schematic (#23)
    Clean-room xschem schematic for the LDO's error amplifier, pass device,
    feedback divider, compensation and enable/shutdown, built on the ratified
    DR-001 framing (pfet_g5v0d10v5) and sized per DR-003's methodology.
    Netlists cleanly against the pinned PDK; polarity and two shutdown
    shoot-through paths were found and fixed via OP screening checks against
    the real sky130 models (see design/README.md for the full writeup).
    Replaces the stale design/.gitkeep placeholder.
    [ldo_3v3in_1v8out.sch]
2026-08-17 feat(design): add current limit and soft start to the LDO (#22) (#26)
    Implements the DRAFT "Current limit" and "Startup / soft-start" rows of
    spec/target-spec.md on top of the issue #14 core regulation loop, plus the
    two corrections to that loop the protection work turned out to require.
    Current limit (sense-FET brickwall clamp):
    M_SENSE is a minimum-width replica of M_PASS (same L, gate and source,
    nominal 1:5952 ratio); M_CLN1/M_CLN2 attenuate the sense current 12.5:1
    into the high-impedance node CL_CMP where it is compared against the
    bias-referenced M_CLP; over-current pulls CL_CMP low and M_CLIM clamps the
    pass gate toward VIN. A continuous second loop, not a latch, so the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
    [ldo_3v3in_1v8out.sch]
2026-08-17 feat(layout): add placed floorplan skeleton for the sky130 LDO core (#27)
    Generates one `klt gen` block per active device in
    design/ldo_3v3in_1v8out.sch (13 MOS + 2 resistor blocks covering all 4
    resistor instances), composes them via `klt gen-compose`'s explicit
    placement strategy into layout/ldo-core/, and confirms the result is
    DRC-clean. Inter-block routing and LVS are deferred to issue #17,
    matching the sky130-bandgap #15 precedent; the Miller compensation cap
    has no klt gen generator yet (filed 2AMLogic/klayout-tools#1117) and is
    documented as a known gap rather than drawn.
    Closes #15
2026-08-17 feat(sim): stand up load-transient, psrr-dc, dropout-vs-load testbenches (#30)
    Ports the load-transient / psrr-dc / dropout-vs-load testbench structure
    (stimulus shape, measurement expressions, experiment.json schema) from
    the pdk-smoke harness's own conventions and gf180-ldo's sibling scope,
    redrawn against sky130 and instantiating the #14 schematic hierarchically
    via a new companion subcircuit symbol (design/ldo_3v3in_1v8out.sym).
    Each testbench runs through corner-run.py unmodified and produces a real,
    reproducible --quick evidence record citing the DRAFT spec/target-spec.md
    row it targets. All three use VREF=1.2V with the schematic's current 1:2
    feedback-divider ratio (design/README.md'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
    [tb_dropout_vs_load.sch, tb_load_transient.sch, tb_psrr_dc.sch]
2026-08-17 docs(spec): draft DR-005 — thermal-shutdown trip temperature, hysteresis, and reference (#31)
    Fixes trip Tj (150°C nominal, 25°C guard band above the spec's 125°C
    operating ceiling), hysteresis (15°C nominal), the CTAT sense reference
    (internally generated, bias-generator-derived — deliberately not VREF
    and not a bandgap, sidestepping the undefined-VREF-tempco gap), and
    auto-restart (non-latching) behavior, reusing the existing EN-gated
    shutdown path. Status proposed, input to #1; no target-spec.md values
    change.
2026-08-17 docs(layout): commit LDO-core DRC clean report (T1 re-read #12, item 3) (#32)
    Re-run `klt drc` against the real LDO layout (layout/ldo-core, landed by
    #15/PR#27) via layout/bin/run-ldo-layout-flow.sh, minting a fresh evidence
    record (20260817-234055-e500d71) against current main: status "clean",
    violation_count 0, reproducing #15's own DRC-clean result. Documents the
    report's coverage caveat in layout/README.md (met1/met2/via rules are
    skipped because this floorplan skeleton has no routing yet -- #17's job) so
    "clean" is read alongside what layers were actually checked.
    Closes #16
2026-08-18 feat(layout): run first klt LVS attempt against the LDO core layout (#34)
    Adds a reusable klt extract/lvs driver (run-ldo-lvs-flow.sh), a schematic
    netlist -> LVS reference translator (gen-ldo-reference-netlist.py), and a
    record renderer (render-ldo-lvs-record.py), then commits the resulting
    first-attempt record.
    The result is status: mismatch, root-caused rather than papered over: the
    committed ldo-core layout (#15) predates issue #22's current-limit/
    soft-start devices (11 MOS devices + M_PASS's width correction missing),
    and has no inter-block routing yet (deliberately deferred by #15). Not a
    klt defect. Follow-on tracked as #33.
2026-08-18 feat(design): add thermal-shutdown circuit per DR-005 (#35)
    Adds a CTAT sense stack + trip comparator + hysteresis, wired into the
    existing EN-gated shutdown path (M_TSHUT clamps EA_OUT like M_CLIM/M_ENP,
    M_ENP4 defines TS_CMP's off state like M_ENP3), giving auto-restart
    thermal protection without a new shutdown mechanism. Reference is
    bias-generator-derived (not VREF, not a bandgap) per DR-005. Documents
    screening OP checks in design/README.md: correct comparator polarity and
    main-loop non-interference at 27C, the sense/reference gap closing
    monotonically toward trip at 125C (the top of DR-004's characterized
    range), and a clean EN=0 shutdown (175pA, unchanged from the pre-#29
    leakage floo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
    [ldo_3v3in_1v8out.sch]
2026-08-18 feat(design): give the error amp a rail-to-rail output stage and size its compensation (#36)
    * feat(design): promote the error amp to a current-mirror OTA and size its compensation
    The #14/#22 five-transistor OTA drove the pass gate from EA_OUT, which was
    the drain of the PMOS input device M_IN2 and therefore could never rise
    above EA_TAIL (~V_in,cm + V_sg ~ 2.5V). That ceiling -- not a gain
    shortfall -- capped the minimum achievable V_sg(M_PASS) at VIN - 2.5V and
    made the loop rail at light load and high VIN.
    Turn the VREF-side branch current around twice (M_MIR3/M_MIR4 -> PB ->
    M_MIRP1/M_MIRP2) so EA_OUT becomes the drain of a PMOS whose source is VIN
    and the pass gate can be driven all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
    [ldo_3v3in_1v8out.sch, tb_loop_gain.sch]
2026-08-18 feat(layout): generate the LDO-core layout from the schematic netlist, route inter-block nets, and reach LVS match (#39)
    Replace gen-ldo-blocks.py's hand-transcribed device table (stale since
    issue #22, and further behind after #35/#36) with schematic-driven
    generation: the layout reads design/ldo_3v3in_1v8out.sch's own headless
    xschem netlist, so it can never describe a different device set than the
    schematic. M_PASS is now drawn at its full W_total=2500um (25 parallel
    100um units, per mult=25). Adds a single-channel two-layer router that
    wires every block net-for-net plus drawn n-well/substrate body ties, since
    klt gen-compose's own connectivity router only supports two-pin routes.
    klt dr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
2026-08-18 feat(sim): run full 45-point PVT corners + Monte Carlo output-accuracy check (#37)
    * feat(sim): run full 45-point PVT corners + Monte Carlo output-accuracy check
    Runs the full PVT corner matrix (5 process x 3 temp x 3 supply = 45 points)
    declared in each of load-transient/psrr-dc/dropout-vs-load's experiment.json
    (issue #18 landed only a 3-corner quick subset), and adds a Monte Carlo
    mismatch experiment (mc-output-accuracy, via klt sim's native
    request.monte_carlo field) for the "Output" DRAFT spec row, the one row that
    names a population/statistical bound rather than a PVT-corner limit.
    - sim/load-transient: 16/45 PASS, overall FAIL (worst case 0.941V undershoot
    at ff_125c_3.63v vs 0.15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
    [ldo_3v3in_1v8out.sch, tb_mc_output_accuracy.sch]
2026-08-18 refactor(layout): extract shared _load/_git/provenance helpers into _record_common.py (#42)
    render-record.py, render-ldo-record.py, and render-ldo-lvs-record.py each
    carried byte-identical _load()/_git() definitions and a ~15-line git-sha/
    klt-version/PDK-info provenance block. Move both into a new
    layout/bin/_record_common.py module (provenance() returns a Provenance
    dataclass) so the git-provenance/klt-version logic has one maintained copy
    instead of three.
    Verified behavior-preserving by regenerating record.md for all three flows
    (trivial-cell, ldo-core layout, ldo-core LVS) against their checked-in
    fixture reports/JSON envelopes: output is byte-identical except for the
    expected "Repo st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
    [_record_common.py]
2026-08-18 feat(ci): lint design/*.sch for duplicate component instance names (#43)
    * feat(ci): lint design/*.sch for duplicate component instance names (#38)
    Add a headless, PDK-free structural lint (following
    check-xschem-embedded-quotes.sh's existing pattern) that fails
    `npm run check:ci` if design/*.sch instantiates two components under the
    same name= -- the class of hazard that let #35 and #36's parallel M_ENP4
    clamps merge into an unusable netlist ("device already exists, bail out")
    with nothing catching it on every push.
    Empirically verified while implementing this: `corner-run.py --dry-run`
    does NOT reproduce the failure (xschem's netlister emits the duplicate
    silently, exit 0); only a real n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
    [test_check_xschem_duplicate_instance_names.py]
2026-08-18 refactor(layout): dedupe _merge_continuations into _netlist_common (#45)
    _merge_continuations was byte-identical (module docstring aside) in
    gen-ldo-reference-netlist.py and gen-ldo-blocks.py. This is the second
    half of issue #44 -- the _load/_git duplication it also named was
    already fixed by #42's _record_common.py.
    Verified behavior-preserving by running run-ldo-lvs-flow.sh and
    run-ldo-layout-flow.sh before and after the change against the same
    schematic input: identical compose.json/lvs output (module-docstring
    diffs only ignored, timestamps/paths aside).
    Closes #44
2026-08-18 feat(sim): produce a post-layout extracted netlist and run klt pex against the landed LDO layout (#48)
    Adds sim/pex-post-layout/: a klt-sim/klt-pex-native testbench (schematic
    DUT widened to the 28-pin interface klt pex's own extraction promotes,
    since it has no --pins flag), the request klt sim/klt pex both run under,
    and a run-pex.sh + render-pex-record.py pipeline that regenerates the
    testbench from the current schematic + landed layout, runs both legs, and
    records the result as append-only evidence (klt-requests/,
    klt-responses/, netlist-snapshots/, records/ -- same flat per-record-id
    convention sim/dropout-vs-load and sim/mc-output-accuracy already use).
    klt extract --pdk sky130A --par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
2026-08-18 feat(measurements): add generated per-spec-row characterization report (#49)
    * feat(measurements): add generated per-spec-row characterization report
    Adds measurements/build_characterization_report.py, which parses the
    existing sim/ PVT-corner and Monte Carlo records, the layout/ DRC/LVS
    records and sim/pex-post-layout/'s post-layout record, and rolls them
    up into measurements/characterization.md keyed to every row of
    spec/target-spec.md. Verdicts are read verbatim from each record's own
    stated result (never re-derived), rows with no independent testbench
    (Input, Load, Line/Load regulation, Iq, Current limit, Startup/
    soft-start, Enable/shutdown, Thermal, Output noise, Area) are reported
    N/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
2026-08-22 chore: resync .github/CONFIGURATION.md from upstream Loom defaults
    Applied to the working tree by `resync-installed.sh` and then left
    uncommitted. `.github/` is on the Loom-shipped allowlist and is walked by the
    resync, so it updates with the rest — but the resync's own commit step stages
    `.loom/` only, so this file stays dirty in every repo the resync touches.
    That is not cosmetic. `fleet-resync.sh` refuses to run against a repo with
    uncommitted work under `.loom/`, `.claude/`, or `.gitignore`, and a repo left
    dirty this way can trip that guard on a later run and stop receiving upstream
    fixes entirely while still reporting as a healthy fleet member. The identical
    diff was found pending i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
2026-08-24 ci: route repo checks to the self-hosted fleet runner (2am#29)
    Every Actions run in this repo has failed at startup since 2026-08-20 with
    The job was not started because recent account payments have failed or
    your spending limit needs to be increased.
    (#51). It is an account-level billing block, not a code defect: the same
    commit and workflow passed on 2026-08-19 12:15Z and failed on the 2026-08-20
    06:28Z scheduled run with no change in between, and `npm run check:ci` passes
    locally on the current PR head (27 + 26 tests green).
    The split across the fleet is exactly the billing boundary — every PRIVATE
    canary has failed on every run for four days, while the PUBLIC ones
    (gf180-ldo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
2026-08-24 ratification: install the two-key reviewer variant (EE key + market key) (#53)
    Phase C2 of 2AMLogic/2am#372 (autonomous spec ratification). Installs the
    Tier-1-clean EE-key skill verbatim from 2AMLogic/2am's ratification/ee-key/,
    and the generated market-key canary variant (2AMLogic/product's
    generate-canary-variant.py output, lint-clean and selftest-passed) scoped to
    this repo's block class (ldo). Enables Phase C3's ratification of the
    currently-held PR through the two-key path.
    Part of 2AMLogic/2am#384 (one of six canary repos; see that issue for the
    other five).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
2026-08-25 chore: refresh stale DRC/LVS reports for ldo-core (#59) (#63)
    layout/bin/run-ldo-layout-flow.sh and run-ldo-lvs-flow.sh had not been
    re-run since the layout-toolchain refactors (#39/#42/#45/#47/#48) landed,
    so characterization.md's own freshness check marked the ldo-core DRC/LVS
    records as STALE despite both still stating a clean/match verdict.
    Re-ran both flows against the current schematic/layout on main:
    - New DRC record 20260825-015012-3149121: status clean, violation_count=0.
    - New LVS record 20260825-015029-3149121 (extracted layout vs. a reference
    netlist freshly derived via gen-ldo-reference-netlist.py): status match,
    mismatch_count=3 (all disclosed, non-blocking warnings, same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
2026-08-25 docs: update README status line and measurements/ description to reflect completed PVT+MC campaign (#68)
    - Root README status line now describes the design/layout/sim state that
    actually exists (schematic, routed layout, DRC/LVS, 45-point PVT+MC
    campaign, PEX attempt) and the DRAFT-spec FAIL result, linking to
    measurements/characterization.md and issue #60 instead of asserting
    'nothing verified yet'.
    - Root README repository-layout block no longer describes measurements/
    as empty until tape-out.
    - design/README.md's Known gaps 'Corner coverage' bullet now states the
    45-point PVT+MC campaign has run (not '#19's job'), citing its FAIL
    result and pointing at measurements/character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
2026-08-25 docs(design): root-cause the full 45-point PVT+MC campaign FAILs, decompose fixes (#72)
    Issue #60 asked for root-cause analysis of every FAIL row in the fresh
    45-point PVT + Monte Carlo campaign (Output, Dropout, Load-transient, PSRR,
    Stability). Screening reproductions of the closed-loop circuit (single-corner
    .op/dc decks against the committed netlist, not sim/ evidence) identify two
    distinct failure mechanisms plus one independent, previously-undesigned-for
    gap:
    1. Thermal shutdown (#29/DR-005) nuisance-trips at the ff/sf process corners
    at 125C -- the top of this repo's rated operating range, not a fault
    condition -- confirmed via TS_SNS/TS_REF/TS_CMP node measurements. This is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
2026-08-25 feat(sim): ship current-limit, startup and enable-shutdown PVT testbenches (#75)
    * sim: add current-limit, startup and enable-shutdown PVT testbenches
    Three DRAFT spec rows ("Current limit", "Startup / soft-start",
    "Enable / shutdown") had no testbench of their own, so
    measurements/characterization.md reported them N/A -- a coverage gap by
    that report's own Limitations section, even though the circuitry they
    describe landed with #22.
    Each new experiment follows the existing sim/<slug>/ convention (xschem
    testbench with no corner include/.temp/.control, manifest declaring the
    full 45-point PVT matrix plus a 3-point quick_subset, bounds citing the
    DRAFT spec row verbatim rather than an inven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
    [tb_current_limit.sch, tb_enable_shutdown.sch, tb_startup.sch]
2026-08-25 docs(sim): re-run post-layout PEX to restore freshness, update MOS-flavor caveat (#78)
    PR #63's LATEST-LVS bump (#59) left the Post-layout PEX row
    (measurements/characterization.md) reading STALE, since its cited
    klt pex record still pointed at the superseded LVS record it was
    extracted against. Re-run sim/pex-post-layout/bin/run-pex.sh against the
    current LATEST-LVS (20260825-015029-3149121) and mint a new append-only
    record (20260825-052509-6fac47d) citing it. The substantive result is
    unchanged (status=error, 135/135 delta[] rows errored, same
    device_count=72/net_count=28 extraction) -- the underlying klt pex
    blockers (klayout-tools#1157/#1159) are still open and unrelated to LVS
    provenan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
2026-08-25 docs(design): record #70's bias-generator/preload investigation, reverted (Part of #70) (#82)
    Screened two PSRR candidates (a self-biased "beta-multiplier" reference,
    found to settle into a genuine ~1mA runaway branch on a real transient
    startup check rather than its intended few-uA equilibrium; and a
    cascode-only fix on the OTA's own PMOS pull-up mirror, which regulates
    correctly but did not materially move 1kHz PSRR and regressed one corner)
    and one stability candidate (a light-load preload resistor, whose
    promising crossover-frequency trend could not be validated against the
    real 0mA operating branch because of the DC-solution-multiplicity gap
    #71 already tracks). None was shippable, so t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
2026-08-25 feat(sim): ship line-regulation, load-regulation and Iq testbenches (#73)
    Adds sim/line-regulation, sim/load-regulation and sim/iq -- three new
    PVT-corner testbenches against design/ldo_3v3in_1v8out.sch, closing the
    coverage gap measurements/characterization.md flagged for the "Line
    regulation", "Load regulation (0-50 mA)" and "Iq (excl. load current)"
    DRAFT spec rows (all three previously reported N/A).
    All three use discrete .op points at the DRAFT row's own named test
    conditions rather than a continuous .dc sweep: a continuous VIN sweep
    (line regulation) and a continuous I_LOAD sweep (load regulation) were
    tried first and both hit this schematic's already-documented
    DC-solution-multiplic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
    [tb_iq.sch, tb_line_regulation.sch, tb_load_regulation.sch]
2026-08-25 feat(sim): ship thermal-shutdown trip/hysteresis testbench (sim/thermal) (#80)
    Closes the Thermal DRAFT spec row's N/A evidence gap named in
    measurements/characterization.md and design/README.md's Known-gaps section.
    Required an explicit 125C-vs-150C corner-coverage decision first (DR-005's
    150C nominal trip sits above DR-004's 125C-characterized PVT axis) --
    documented as a dated addendum to DR-005: extend, scoped to this one
    testbench, not a change to DR-004's binding for the other four testbenches.
    sim/thermal/ sweeps TEMP continuously (80-180C ascending then descending,
    DC continuation) across the full process x supply_v matrix, measuring
    trip_temp_c/reset_temp_c/hysteresis_c against th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
    [tb_thermal_trip.sch]
2026-08-25 refactor(sim): dedupe render-pex-record.py's git() into shared _record_common (#84) (#85)
    render-pex-record.py carried its own local git() copy instead of the
    sim/bin/_record_common.py helper every sibling record-writer already
    uses, missing the timeout=60 and graceful try/except-to-"" fallback the
    canonical version has. Wire up the same sys.path cross-import pattern
    build_characterization_report.py already uses to import git() from
    _record_common, and drop the local duplicate. load_json() stays local
    since it has a distinct None-on-failure contract.
    Closes #84
2026-08-25 fix(sim): dropout-vs-load dropout_v methodology, diagnose DC-solution multiplicity (#71) (#83)
    Replace dropout-vs-load's dropout_v measurement (Vin-Vout at a fixed
    Vin=1.9V endpoint, deep past the point regulation is lost) with a fine
    (20mV) downward Vin sweep plus a .meas fall=1 locator that finds the Vin
    where Vout first departs 2% from the 1.8V target -- the classic dropout
    definition. The corrected, sim/-evidentiary number at -40C/27C across all
    five process corners is 0.310V-0.554V (record 20260825-055423-c000414,
    supersedes 20260818-032811-81dc232), still above the DRAFT 300mV target.
    Investigated the DC-solution-multiplicity this sweep direction surfaces:
    at -40C/27C it is confirmed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
    [tb_dropout_vs_load.sch]
2026-08-25 fix(sim): give current-limit's leg 3 a cold EN ramp, shift fault past soft-start (#86)
    tb_current_limit.sch tied VEN to a plain DC source, so leg 3's transient (the
    held Vout=0 short) started already enabled -- inheriting the same t=0
    DC-solve-lands-on-the-wrong-branch issue PR #75 fixed in the sibling
    sim/enable-shutdown and sim/startup testbenches (ff/sf 125C thermal-clamp
    nuisance trip, issue #69). That made the ff_125c_3.63v leg-3 result
    inconclusive rather than a real design-defect FAIL.
    VEN now carries the same dual `dc 'vsup'` + rising `pwl` form used in
    tb_enable_shutdown.sch: legs 1-2 (op/dc) are unaffected, and leg 3 starts
    disabled and ramps up at t=100us. The held short's fault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
    [tb_current_limit.sch]
2026-08-25 docs(design): root-cause mechanism 4's 125C severity as a genuine circuit gap (#81) (#87)
    Diagnosed why sim/dropout-vs-load's DC solve is fragile at 125C across all
    five process corners (not just ff/sf, widening #71's finding): most of the
    campaign's extreme numbers are outright Newton non-convergence (garbage
    that fails the feedback divider's own algebra), but the deeper cause is a
    second, genuinely stable, non-regulating equilibrium the loop's own
    dynamics prefer at 125C/50mA -- confirmed via a settled UIC transient with
    VOUT's own capacitor seeded exactly at the intended 1.8V point, which
    reliably drifts away to a different stable branch at every corner tried
    (tt/ss/fs). Nodeset/.ic seedi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
    [tb_dropout_vs_load.sch]
2026-08-25 docs(design): re-derive self-biased bias-generator loop gain, re-validate preload against real branch (#79) (#88)
    Carries #70's investigation forward to a definitive conclusion on both
    open threads, per issue #79's scope:
    - Root-caused #70's self-biased ("beta-multiplier") reference: with
    R_SB degenerating the diode leg (as #70 built it), the DC loop gain
    is LG=2-sqrt(m/K), which is >1 for every K>1 at the natural m=1
    mirror ratio -- structurally regenerative, not a sizing bug. Moving
    R_SB to the externally-driven leg instead gives LG=sqrt(m/K)/(2*
    sqrt(m/K)-1), stable (LG<1) whenever the PMOS mirror ratio m exceeds
    the NMOS width ratio K. Verified in SPICE three ways (a .dc loo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
2026-08-25 docs(design): root-cause thermal-shutdown hysteresis as a marginal loop-gain gap (#77) (#92)
    sim/thermal (#66) found the auto-restart hysteresis (M_TSHYS/M_TSHYSB
    positive feedback into TS_REF, DR-005) reads non-positive at every one of
    15 PVT corners. Investigated whether this is a real circuit-sizing defect
    or a DC-continuation measurement artifact: it is both, and neither
    cleanly.
    - A nodeset-forced bistability probe at tt_27c_3.30v (T=134C, one grid
    step below the vanilla sweep's measured 0C-hysteresis crossing)
    converges to a genuine, self-consistent tripped branch the default
    .dc continuation loses -- confirming a real (if narrow) hysteresis
    window exists and the sweep methodo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
2026-08-25 sim: run the full 45-point PVT matrix for current-limit, startup and enable-shutdown (#74) (#94)
    * feat(sim): run enable-shutdown's full 45-point PVT matrix (#74)
    42/45 PASS. All three quick-subset points still pass; the full matrix
    adds a new finding not visible in the 3-point subset: sf_125c fails at
    all three supplies (vout collapses to ~7-10mV), the same mechanism-1
    thermal-shutdown false-trip (#69) previously documented only for
    ff/sf_125c in the other four testbenches. Supersedes 20260825-044140-703a889.
    Part of #74
    * feat(sim): run startup's full 45-point PVT matrix (#74)
    42/45 PASS. All three quick-subset points still pass; the full matrix
    adds the same new finding as enable-shut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
2026-08-25 fix: stop thermal shutdown nuisance-tripping inside the rated 125C range (#90)
    * fix(design): re-size the thermal-shutdown CTAT pair so it stops nuisance-tripping at 125C
    The trip comparison is 2*Vgs(sense stack) against 1*Vgs(reference), and
    sky130's HV-nfet corner model applies its Vth0 skew geometry-weighted:
    delvto = swx_vth * (0.10*8/L + 0.90) * (0.045*7/W + 0.955) * (...)
    so a short-channel sense device amplifies the corner Vth shift (1.63x at
    L=1/W=80) and the 2-vs-1 count leaves it un-cancelled. That is why the
    rising trip moved 65C across the five process corners and had already
    tripped at ff/sf/125C -- inside the rated Tj <= 125C range, in violation of
    DR-005's own 25C guard b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
    [ldo_3v3in_1v8out.sch]
2026-08-25 refactor(sim): dedupe corner-run.py importlib-by-path loader into _record_common (#97)
    sim/bin/mc-run.py and measurements/build_characterization_report.py each
    carried a byte-identical importlib-by-path workaround to load
    corner-run.py (whose hyphenated filename can't be import-ed directly).
    Extract it into _record_common.load_corner_run_module(), continuing the
    dedup pattern already applied to git() (#51) and the record.md
    header/footer rendering (#46).
    Closes #96
    [_record_common.py, mc-run.py]
2026-08-25 docs(design): re-screen thermal-shutdown hysteresis against #69/#90's re-size, still marginal (#91) (#98)
    #90 (closing #69) re-sized the CTAT sense/reference pair and M_TSHYSB but
    left the comparator untouched and did not re-run sim/thermal, re-opening
    whether #77's non-positive-hysteresis finding survives the new sizing.
    Re-screened the current schematic at all 15 sim/thermal corners with the
    vanilla .dc temp continuation methodology: the same two-signature pattern
    persists (12/15 corners read exactly 0 deg C, 3/15 read small negative
    values). Tried a new candidate #77 did not explore -- widening the
    comparator differential-pair/mirror channel length (M_TCN1/M_TCN2/M_TCP1/
    M_TCP2, L=2 -> L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
2026-08-25 fix(sim): re-run the seven records PR #90 left STALE against #69's re-size (#99)
    Re-runs sim/thermal, sim/line-regulation, sim/load-regulation, sim/iq,
    sim/current-limit, sim/startup and sim/enable-shutdown against the
    post-#69/#90 merged schematic (933dfdd), each new record carrying a
    Supersedes pointer back to the stale (or breadth-losing) record it
    replaces. current-limit/startup/enable-shutdown now run the full
    45-point matrix, confirming #74's diagnosed sf_125c/ff_125c failures
    were #69's mechanism-1 nuisance trip and are now fixed. sim/thermal
    turns #69's .op-screened trip estimate into a measured 15-corner
    record that corroborates #91's manual re-screen. Regenerates
    measurements/chara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
2026-08-25 fix(layout): redraw ldo-core for #69's thermal-shutdown re-sizing (DRC/LVS/PEX) (#100)
    Re-runs the schematic-driven layout/LVS flow against design/ldo_3v3in_1v8out.sch's
    post-#69 device sizes (M_TSD1/M_TSD2 L 1->4, M_TSR1 W/L -> PDK-minimum width,
    M_TSPR/M_TSPS/M_TSHYSB width changes), minting new append-only DRC (clean) and
    LVS (match, same mismatch profile as before -- sizing-only, no topology change)
    records, then re-runs sim/pex-post-layout's post-layout PEX experiment against
    the new extraction with a Supersedes pointer to the prior record.
    - run-ldo-layout-flow.sh / run-ldo-lvs-flow.sh: compute SCHEMATIC_SHA from the
    .sch file alone, matching measurements/build_characterization_repo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
2026-09-05 feat(champion): standing authorization for design-evidence auto-merge (#6850)
    Operator ruling 2026-09-05: Judge-approved, green-CI PRs whose entire
    changed-file set lives in design/, sim/, layout/, measurements/,
    verification/, or docs/ auto-merge without the four-axis human hold.
    Rationale: canary design evidence is fully revertible with no fleet-infra
    blast radius, and the held-PR pattern (sky130-sar-adc#123 sat mergeable for
    days as the sole blocker of a layout chain) costs more than it protects
    here. spec/ and every tool surface fall outside the patterns, so the
    exact-subset rule keeps them on the four-axis judgment automatically.
    C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
2026-09-15 docs(spec): add DR-007 recommending PSRR/Stability rows be superseded (#106)
    * docs(spec): add DR-007 recommending PSRR/Stability rows be superseded
    Issue #70's two decomposed attempts (PR #82, PR #88) both returned
    verified-negative results: no candidate bias-generator/preload fix moved
    1kHz PSRR (root-caused as loop-gain-limited) or 0mA phase margin (the
    pass-stage's load-proportional pole) without exceeding the DRAFT
    Iq<30uA row, and the one candidate that ever moved PM (6x M_TAIL) already
    exceeds budget by 12% while still missing the 45 deg target by 5 deg.
    DR-007 recommends option (b) per CLAUDE.md's "a row that proves unmeetable
    is superseded by a new decision record" discipline: tre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
2026-09-15 docs(design): document DR-007 outcome and spin off topology-redesign issue (#108)
    DR-007 (PR #106) resolved #70's own acceptance criteria: both decomposed
    attempts (PR #82, PR #88) are verified-negative within the single-stage
    topology, and DR-007 recommends superseding the DRAFT PSRR/Stability rows
    rather than a third same-class attempt. Documents the outcome in
    design/README.md and spins off #107 for the topology-class fix DR-007's
    Consequences section identifies but explicitly scopes out of its own PR.
    No circuit or spec change. Closes #70.
2026-09-15 docs(design): close out #60 - root-cause/decomposition complete, #107 owns remainder (#110)
    Re-verifies #60's remaining Acceptance Criteria against fresh evidence now
    that all three of its blockers (#69, #70/#79/#81, #71) are closed. No
    schematic change has landed since the post-#69 thermal-shutdown resize, so
    the existing 2026-08-25 campaign is still the freshest evidence and needed
    no re-run; measurements/characterization.md is verified current via
    build_characterization_report.py --check.
    None of the five original FAIL rows (Output, Dropout, Load transient, PSRR,
    Stability) has flipped to PASS. PSRR/Stability now carry a documented
    spec-change rationale (DR-007, proposed). Dropout, Load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
2026-09-15 docs(design): document verified-negative cascode screening for PSRR/stability (#111)
    * docs(design): document verified-negative cascode screening for PSRR/stability (#107)
    Screens a full NMOS-side cascode current mirror on the OTA's output
    pull-down (M_MIR1/M_MIR2), built and netlisted, against a single-corner
    loop-gain and PSRR check per DR-007's hand-off. 1kHz PSRR is unchanged
    (23.19dB vs 23.25dB baseline), the 0mA phase-margin measurement breaks
    down entirely (no 0dB crossing, vs a measurable-but-failing 19.3deg
    baseline), and the already-passing 50mA/0.33uF corner regresses
    (DC gain 59.51dB -> 53.16dB). Reasons through why a second gain stage
    (already built and shown to oscillate in #2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
2026-09-18 docs(spec): draft DR-006 spec ratification — ratify DR-002/003/004/005 (#50)
    * docs(spec): draft DR-006 spec ratification, ratify DR-002/003/004/005
    Per the 2026-08-19 ratification-via-PR standing policy (2AMLogic/2am#357):
    a builder drafts the ratification/DR as a PR on the evidence, and the
    operator's PR approval is the ratification act.
    DR-006 ratifies spec/target-spec.md's target table unchanged from its
    gf180-ldo-mirrored starting point, and ratifies DR-002 (C_out/ESR window),
    DR-003 (device characterization methodology), DR-004 (corner-name binding),
    and DR-005 (thermal-shutdown trip/hysteresis/reference) as inputs to it. The
    Iq row stays explicitly open -- DR-003 never proposed a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
2026-09-23 sim(pex): re-check the three disclosed klt gaps upstream, pin main@040f3406, record 108/135 (#122) (#143)
    All three disclosed upstream gaps are fixed as of the new pin: #1157 and
    #1159 by 2dc66ece (PR #2336, postdating every release -- hence the
    git-commit pin 040f3406b4858ac7a5b8faa8df5327fd62a65afa, version string
    0.6.0+g040f3406b485, verified reproducible end-to-end), #1369 by PR #1381
    (already in v0.5.0, marker-scoped on hvi 75/20).
    Record 20260923-183915-d9900b5 (supersedes 20260825-125102): extracted
    leg converges, 108/135 delta rows pass. The 27 surviving errors are 9 ss
    corners x 3 measurements with one repo-local root cause: the landed
    ldo_core GDS draws no hvi markers, so all 67 M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
2026-09-23 docs(design): stability binding mechanism, feedforward-zero screen (verified-negative), coupling-thesis test (#115) (#130)
    * docs(design): confirm 0mA-load stability binding mechanism, screen a feedback-divider feedforward zero (verified-negative), test the coupling thesis against 45-corner data (#115)
    Adds a fourth verified-negative compensation-network candidate to the
    lineage DR-007 closed (#25, #70/#79, #107): a feedback-divider feedforward
    capacitor (VOUT || R_FB_A -> FB), a lever none of the prior campaigns
    tried. Screened across C_FF and combined with a doubled R_CZ; best case
    raises pm_c033_0ma_deg from 19.3deg to a two-sided-optimum peak of 29.7deg
    (still 15.3deg short of the ratif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
2026-09-23 spec: ratify the Iq row at < 30 µA via DR-008 (#134)
    * spec: ratify the Iq row at < 30 µA via DR-008 (#121)
    The Iq row was left OPEN by DR-003/DR-006, yet characterization.md
    graded it FAIL against the testbench's pre-ratification DRAFT citation.
    A row with no target cannot be failed.
    DR-008 (proposed; ratifies on PR merge per 2AMLogic/2am#357) sets:
    Iq < 30 µA at no load and at full load (50 mA), every PVT corner;
    stretch < 10 µA, subordinate to DR-002's C_out/ESR window.
    Sources: gf180-ldo parity (its DR-0004 A6), checked against a
    sky130 device-fact budget for the now-existing topology and public
    comps. The number is not derived from the measured 36/45 result. It
    predates every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
2026-09-23 docs: record the error amplifier as kept in-tree vs sky130-opamp (DR-010 + reuse.lock.json) (#137)
    * docs: record the error amplifier as kept in-tree vs sky130-opamp (DR-008 + reuse.lock.json)
    Adds this repo's reuse.lock.json (2am cross-cutting rule 9 ledger) with one
    in_tree entry for the error amplifier, decided `kept` against the same-PDK
    sibling 2AMLogic/sky130-opamp, and the decision record it points at.
    The sibling was re-verified live rather than taken from the issue's cached
    research: design/opamp_core.sch and its DR-001 are both unchanged since
    177ff9ee (2026-09-15), and its committed netlist is still a two-stage
    Miller-compensated standalone op-amp on sky130_fd_pr__{n,p}fet_01v8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
2026-09-23 sim(psrr-dc): measure both ratified load points; 50 mA/100 kHz also fails (#141)
    The ratified PSRR row names four conditions -- two frequencies x two load
    points (>50 dB @ 1 kHz and >20 dB @ 100 kHz, at 1 mA and at 50 mA) -- and
    spec/target-spec.md's own status column said the deck covered only two of
    them ("50 mA point not yet testbenched"). That v1 limitation was correct
    when written and is now obsolete: the pre-#25 five-transistor amplifier had
    no regulating 50 mA operating point to linearize an AC sweep around, and
    re-check measures VOUT = 1.7980 V into 36 ohm at tt/27C/3.30V, regulating.
    The deck now sweeps both load points inside one deck ("alter rload = 36"),
    the same single-deck/mul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
    [tb_psrr_dc.sch]
2026-09-24 docs(spec): DR-008 — Thermal FAIL is the hysteresis bound, not theta-JA; record the delegated theta-JA integration constraint (#132)
    * docs(spec): DR-008 — Thermal FAIL is the hysteresis bound, not theta-JA; record the delegated theta-JA integration constraint
    Investigates #120. The three failing sim/thermal corners (tt_3.63v,
    ss_2.97v, ff_3.63v in record 20260825-104426-933dfdd) fail only the
    hysteresis_c >= 0 bound; trip_temp_c >= 125 C passes at all 15. The
    bench has no thermal network, no ambient and a ~1 mA load -- swept TEMP
    is Tj -- so no theta-JA assumption is involved and the FAIL verdict
    stands (carried to #131, the regenerative-comparator redesign).
    - spec/decision-records/D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
2026-09-24 fix(design): re-size M_PASS/M_SENSE for dropout (DR-011); correct a disproven single-op claim (#116) (#139)
    * fix(design): re-size M_PASS/M_SENSE for dropout (DR-008); correct disproven single-op claim (#116)
    DR-003's pass-device sizing derivation was taken at the wrong bias point
    (deep-triode R_on spent at the row's own 300mV V_sd, and an assumed ideal
    0V gate the amplifier can't supply): the committed 2500um M_PASS matched
    its own (flawed) derivation to 1%, but missed the ratified <300mV/50mA
    dropout row at every reachable gate drive. Re-size M_PASS 2500um->5000um
    and M_SENSE 0.42um->0.84um (holding the 1:5952 current-limit sense ratio).
    A partial predecessor run left an uncommitted, unv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
    [ldo_3v3in_1v8out.sch]
2026-09-24 feat(ci): fail check:ci on duplicate DR-NNN decision-record numbers (#140) (#149)
    Four open PRs each added a different `DR-008-*.md` simultaneously on
    2026-09-23 (#132, #134, #137, #139). Every one was correct at the moment
    it picked "the next free number" — each checked against `main`, where the
    highest record was `DR-007` — and every one merged cleanly, because the
    filenames differ so the diffs are disjoint and git never conflicts.
    Nothing in `npm run check:ci` read `spec/decision-records/` at all, and
    Champion auto-merges `loom:pr` with no human in the loop, so two
    approvals landing in the same window was all it would have taken.
    Decision records are append-only (CLAUDE.md): a duplica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
2026-09-24 layout: commit the klt erc supply spec + flow for T1 item 11 (#112)
    T1 item 11 (power delivery, structural) is graded from a `klt erc`
    supply-spec run. This repo had neither a spec nor a report, so the item
    was unmet and unmeasurable.
    What lands:
    * `layout/ldo-core/erc-supply-spec.json` -- the supply spec, with an
    inline comment block justifying every `stackup` entry, every
    `label_layer`, both `vias[]`, the `devices[]` carve-out and both
    `ties[]` declarations. Every layer/datatype is resolved from TWO
    independent sources and cross-checked: the sky130 PDK's own
    `libs.tech/klayout/tech/sky130A.lyp` and klayout-tools' curated sky130
    deck layer table. None are copied from another P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
    [_record_common.py]
2026-09-24 layout: ERC supply record 20260923-094733-83f99b3 -- T1 item 11 MET (#112)
    `klt erc` against `layout/ldo-core/reports/20260825-123551-3b4e121/
    ldo_core.gds` (the record `reports/LATEST` names) with the supply spec
    committed in the previous commit.
    Verdict, read from the report's connectivity half (NOT its top-level
    `status`, which is the antenna verdict -- klayout-tools#1994):
    * `erc_status: clean`, 0 findings.
    * `VIN` and `0`, both `"kind": "supply"`, each resolve to exactly ONE
    electrical island: zero `erc.unconnected_net`, zero `erc.supply_short`.
    * Zero `erc.missing_tie` from ties the run actually CHECKED -- 2 checked,
    0 skipped as degenerate. `nwell_tie` rests on the drawn nwell (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
2026-09-24 layout/README: record the ERC flow's friction filing (#112)
    One new klt gap surfaced standing up the item-11 supply spec, filed
    generically at klayout-tools#2389: `klt erc`'s envelope never names a
    drawn conductor layer the spec's `stackup` omits, so a committed supply
    spec's connectivity model can silently narrow as a block is re-routed.
    `klt drc` already answers that question about itself
    (`coverage.layers_in_stream_without_rules`); `klt erc` has no
    counterpart.
    `bin/check-erc-supply-spec.py` is the local stand-in for that missing
    disclosure and should shrink to nothing if #2389 lands. Also records that
    four of the capabilities this flow depends on are recent upstream fixes,
    which is what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
2026-09-24 docs: relocate hand-written PEX triage narrative out of characterization.md (#148)
    * docs(measurements): move hand-written PEX triage narrative into sim/pex-post-layout/README.md
    The 'Post-layout PEX detail' paragraph and its matching 'Limitations' bullet
    in measurements/characterization.md carried a hand-composed narrative (klt
    version pin, per-corner hvi-marker root-cause attribution, #142 /
    klayout-tools#2417 cross-references) that build_characterization_report.py
    structurally cannot reproduce: extract_pex_results() only ever joins the
    record's own terse '- Result:' lines, and the triage conclusions are not
    fields in the record JSON. That made --check report the file as stale
    indefinitel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
2026-09-24 feat(signoff): commit a klt signoff block manifest and the T1 verdict of record (#126)
    * feat(signoff): commit a klt signoff block manifest and the T1 verdict of record
    This block's "gap to T1" state was hand-written prose, and the checklist
    moved under it: an eleventh item (Power delivery, structural) landed
    2026-09-17 as klayout-tools#2025, invalidating every prior hand-read.
    Adds signoff/ so the state is graded instead:
    - signoff/block-manifest.json -- block "sky130-ldo", kind "analog"
    (confirmed against the block: one hand-captured xschem schematic, no RTL,
    no synthesis, no P&R, no digital partition), citing the five items this
    repo actually has evidence for. Renders T1 3/11, ti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
2026-09-24 docs: cite spec/target-spec.md as ratified in sim/ manifests and docs (#147) (#151)
    `spec/target-spec.md` is headed "Target specification — RATIFIED" (issue #1 /
    DR-006), but the sim harness still described it as DRAFT. Because
    `sim/bin/corner-run.py` copies each experiment's `claim` string verbatim into
    every append-only record it mints, that stale wording was being embedded
    permanently into new evidence.
    Swept to the house wording established by PR #141's `sim/psrr-dc` rewrite
    ("the row is ratified by issue #1 / DR-006, and the bounds below cite it
    verbatim"):
    - 11 `sim/*/experiment.json` manifests: current-limit, dropout-vs-load,
    enable-shutdown, iq, line-regulation, load-regulation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
2026-09-24 feat(layout): draw the sky130 hvi voltage-domain marker so extraction binds g5v0d10v5 (#142) (#155)
    `ldo_core`'s layout drew every MOS device unmarked, so `klt extract --pdk
    sky130A` had nothing to key a device flavour off and bound all of them to the
    1.8V core flavour (`sky130_fd_pr__{n,p}fet_01v8`) instead of the
    `g5v0d10v5` devices the schematic actually instantiates. The extracted-side
    PEX leg was therefore re-simulating different transistors than the design,
    and on the `ss` corner the substituted `pfet_01v8` model aborted the solve
    outright (BSIM4 `Pclm = -0.00876203 is not positive`), which was the entire
    remaining error population in the previous record.
    Changes
    -------
    * `layout/bin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
2026-09-24 docs: cite spec/target-spec.md as ratified in testbench headers and design/README.md (#152) (#157)
    PR #151 (#147) swept stale DRAFT/"not yet ratified" wording out of the live
    sim manifests (sim/*/experiment.json), sim/README.md, and root CLAUDE.md, now
    that spec/target-spec.md is headed "Target specification -- RATIFIED"
    (issue #1 / DR-006). This issue covers the surfaces #147 deliberately left
    out of scope: the testbench .sch headers a human or agent reads when
    reproducing a claim by hand, and the design/ narrative.
    Swept to the house wording PR #151/#141 established ("the row is ratified
    by issue #1 / DR-006, and the bounds below cite it verbatim"):
    - 10 sim/*/testbench/*.sch headers (co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
    [tb_current_limit.sch, tb_dropout_vs_load.sch, tb_enable_shutdown.sch, tb_iq.sch, tb_line_regulation.sch, tb_load_regulation.sch, tb_load_transient.sch, tb_loop_gain.sch]
2026-09-24 docs: retire forward-looking "once issue #1 rules" phrasing; flip DR-006 to ratified (#153) (#158)
    Issue #1 closed `completed` 2026-09-18 and `spec/target-spec.md` is headed
    `Status: RATIFIED`, but a family of prose that never contained the literal
    `DRAFT` token — so neither #147/#151 nor #152 could match it — still framed
    ratification as pending. This is a prose/comment-only reword: no netlist,
    stimulus, corner, metric or bound changes, and no sim/layout result is
    re-run or altered.
    - `spec/decision-records/DR-006-spec-ratification.md`: Status `proposed` ->
    `ratified`, with §Status notes moved to past tense and a dated append
    (2026-09-24, issue #153) recording the evidence the fli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
    [tb_pdk_smoke.sch]
2026-09-24 docs: state the real full-load extracted-VOUT extremes and narrow the klt-pin claim (#160)
    The "lands between -5.7 V and -61.9 V at 50 mA" phrasing in signoff/README.md
    and sim/pex-post-layout/README.md quoted an interval that 31 of the record's
    45 `vout_full_load_v` delta[] rows fall outside of: -5.65387 is simply the
    tt/2.970V/-40C value, not an extremum. Recomputed from
    sim/pex-post-layout/klt-responses/20260924-181248-50554fe.pex.json, the real
    spread is +1.63499 (ff/3.630V/-40C) down to -61.9373 (ss/3.300V/-40C), with
    44 of 45 corners negative. Both passages now state that distribution with its
    corners. sim/pex-post-layout/README.md's separate corner-named
    anchor-and-worst-case sentence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
2026-09-25 layout: size VIN/VOUT as spec-derived power rails, and measure why the extractor cannot see it (#163)
    * feat(layout): size VIN/VOUT as spec-derived strapped power rails, not 0.30um signal trunks
    gen-ldo-blocks.py routed every net with one global TRUNK_W_UM = 0.30um met1
    trunk, including the two nets that carry the block's full load current. Give
    those two nets their own conductor instead, with the width computed rather
    than chosen:
    - identify_power_nets() reads the load-current nets off the schematic (the
    widest MOS's drain and source), so the layout cannot name a different pair
    than the schematic does;
    - _spec_constants.py parses the ratified Load and Dropout rows out of
    spec/target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
2026-09-25 DC accuracy: one mechanism behind all three rows — and it is not matching, supply rejection or loop gain (#165)
    * sim: run the Output MC row on the batch fleet, and decompose nominal vs spread
    `mc-run.py` gains two things the Output row's re-run needed:
    - `--backend {remote,batch}` passthrough to `klt sim`. The local-parallel
    default is a local ngspice grid, which a shared dispatch host forbids; the
    record now names the backend, the remote job id/instance, and the engine
    version that actually produced the numbers (the `Tools:` line describes
    *this* machine, which on a remote backend did not run a single sample).
    - A nominal-vs-spread decomposition per measurement, so a statistica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
2026-09-25 fix(sim): size load-transient C_out to the DR-002 ceiling; instrument the row's recovery-time clause (#119) (#167)
    Load transient's superseded record (20260825-081255-4cb27f8, 25/45 PASS)
    only ever measured peak excursion (undershoot_v/overshoot_v) -- the row's
    second clause ("recover to +-1% in <=20us") was never instrumented, so by
    construction all 20 of that record's FAILs were bound by peak excursion.
    - sim/load-transient/testbench/tb_load_transient.sch: C_out 1uF -> 4.7uF
    (DR-002's own ratified window ceiling, not a new number). Peak excursion
    is charge-limited (Q=C*dV against the loop's finite large-signal response)
    and closes at this point: 8/8 directly re-verified FAILs from t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
    [tb_load_transient.sch]
2026-09-25 sim: seed mc-output-accuracy's transient from a realizable state — the 27C/1mA rail mode is the bench's .op, not a second equilibrium (#170)
    * sim: seed mc-output-accuracy's transient from a realizable state, not an unconstrained .op
    The mc-output-accuracy bench ran `tran 10u 3m` with EN held DC-high, so every
    sample's 3 ms transient started from whatever ngspice's unconstrained
    operating-point solve returned. On the committed N=200/`tt_mm`/27 C/1 mA
    sequence that solve emitted 61 warnings across 43 samples (`singular matrix` at
    xldo.fb / xldo.xr_fb_b.t2 / xldo.xr_cz.t1, `dynamic gmin stepping failed`) and
    handed 12 of them a start state that is not a circuit state: VOUT pinned at VIN
    wit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
    [tb_mc_output_accuracy.sch]
2026-09-25 sim+docs: #81 item 2's 125C/50mA second equilibrium does not exist -- a five-variant IC screen regulates everywhere; #81's numbers were EA_OUT/TS_SNS/TS_REF (#175)
    * sim: #169 initial-condition screen at 125C/50mA -- four variants (V/F/B/C) re-testing #81 item 2
    Testbenches and manifests only; records follow from the runs.
    * sim: #169 variant H -- #81's own method on a frozen copy of #81's own DUT (64c17cb)
    * sim: #169 screen records -- V/F/B/C regulate at all 60 corner points, H shows #81's numbers are the regulating state's EA_OUT/TS_SNS/TS_REF
    Records minted by sim/bin/cor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
    [ldo_3v3in_1v8out_at81.sch, tb_dropout_vs_load.sch, tb_ic_screen_125c_cold.sch, tb_ic_screen_125c_hist81.sch, tb_ic_screen_125c_seeded.sch, tb_ic_screen_125c_vout_only.sch]
2026-09-25 sim: define the initial-condition contract; fail a corner on a solver diagnostic (corner-run.py) (#176)
    corner-run.py's run_corner() now scans ngspice's combined stdout+stderr for
    three confirmed solver-diagnostic markers ("singular matrix", "gmin stepping
    failed", "out of range for ^") and forces the corner to FAIL -- regardless of
    whether its measurements happen to pass their bounds -- with a
    "solver diagnostic: <line>" reason distinct from an ordinary measurement-
    bound failure. The raw ngspice stdout/stderr is unchanged in the per-corner
    .log; the diagnostic is additionally called out on its own header line.
    sim/README.md gains an "Initial-condition contract" section documenting what
    st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
    [corner-run.py, test_corner_run.py]
2026-09-25 docs(sim): record #174's initial-condition-contract audit verdicts (#181)
    Read-only audit of the remaining benches (current-limit, dropout-vs-load,
    loop-gain, load-transient, psrr-dc, thermal, startup, enable-shutdown)
    against #171's contract. Six benches are exposed to the same unconstrained
    .op defect class #164/#171 describe (follow-ups filed: #177/#178/#179/#180);
    startup and enable-shutdown are confirmed clear via their EN-edge/disabled-
    state seeding. No bench's experiment.json or testbench/*.sch is touched.
2026-09-26 sim: convert line/load-regulation's unseeded .op chains to the #171 initial-condition contract, re-run both 45-corner matrices (#182)
    Both regulation benches defined their entire figure as a chain of `alter` +
    bare `op` cards with no transient, no `uic` and no `.ic` -- the worst case of
    the unconstrained-`.op` defect #164 characterized, and the mechanism behind
    #118's "these verdicts are branch-selection outcomes, not regulation quality"
    finding. Every measured point was read straight off ngspice's own from-nowhere
    Newton solve: 45/45 corners of line-regulation's latest record and 44/45 of
    load-regulation's carried a solver diagnostic, which #171's new gate now fails
    outright.
    Both are conv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
    [tb_line_regulation.sch, tb_load_regulation.sch]
2026-09-26 sim: seed load-transient's tran to the #171 initial-condition contract (#183)
    * sim: seed sim/load-transient's tran to #171's initial-condition contract (variant B)
    `sim/load-transient`'s deck opened with a bare `tran 200n 3m` -- no `uic`, no
    `.ic`/`.nodeset` anywhere -- with `VEN` a plain DC constant at 'vsup', so
    ngspice solved an unconstrained, loop-closed `.op` to seed the transient.
    That is exactly the defect #164 (PR #170) fixed for `mc-output-accuracy` and
    #171 generalized into `sim/README.md`'s "Initial-condition contract (issue
    #171)"; #174's audit filed it as this issue. 23 of the 45 corner logs in the
    superseded `20260825-081255-4cb27f8` record already carry a `singular matrix`
    /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
    [tb_load_transient.sch]
2026-09-26 sim(current-limit): seed legs 1 and 3 with `tran ... uic` — an EN edge alone does not cover the transient's op solve (#185)
    Leg 1 opened this bench's deck with a bare unseeded `op`, which ngspice
    solved with VEN at its `dc 'vsup'` value — the fully-enabled, loop-closed,
    from-nowhere Newton start sim/README.md's initial-condition contract (#171)
    forbids. It is now a `tran 5u 1.0m uic` that reaches the 50 mA point through
    the block's own soft-start ramp after an EN edge at t = 100 µs, with the
    measurement read from t = 0.9–1.0 ms: the contract's first accepted shape.
    Re-checking leg 3 per the issue's second criterion produced a correction to
    exposed" on the theory that a non-`uic` tran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
    [tb_current_limit.sch]
2026-09-26 sim: convert dropout-vs-load's dc VIN sweep to a cold-start ramp and seed thermal's dc temp sweeps (#171 contract) (#186)
    * sim(dropout-vs-load): replace the unseeded dc VIN sweep with a cold-start quasi-static VIN ramp
    The bench's only analysis was `dc VVIN 3.63 1.5 -0.02` with VEN held at a
    constant enabled DC level -- an unconstrained Newton solve at every sweep
    point, the defect class #164/#171 characterize. Its committed record
    20260923-123440-d71f4b3 carries a solver diagnostic on 45 of 45 corners
    (thousands of hits per log), which corner-run.py's #171 gate now forces to
    FAIL regardless of measured values.
    Measured here (tt/125C/3.30V, one corner) before choosing a shape: seeding the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
    [tb_dropout_vs_load.sch, tb_thermal_trip.sch]
2026-09-26 sim: seed loop-gain/psrr-dc's ac analyses per the initial-condition contract (#179) (#188)
    `sim/loop-gain` and `sim/psrr-dc` both opened their decks with an `ac`
    analysis at one or more `alter`-reached bias points, with no `.ic`/`.nodeset`
    seed anywhere — the unconstrained-Newton-start hazard #164/PR #170
    characterized and #171 turned into a repo-wide contract plus a
    `corner-run.py` FAIL gate.
    Two measured facts shaped the fix, neither of which is in the issue's
    suggested approach:
    1. `.ic` is inert here. ngspice honours `.ic` only for the TRANSIENT
    operating point, so an `.ic` card does nothing to an `ac` analysis's own
    linearization solve — and an `.ic` + leading `op` deck acti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
    [tb_loop_gain.sch, tb_psrr_dc.sch]
2026-09-26 docs(sim): correct load-regulation's 200ms-vs-1ms attribution (does not reproduce on the uic deck) (#192)
    The "1.85985 V / 1.83245 V / 1.80332 V, 57 mV, 3x the bound" trajectory that
    justified sim/load-regulation's 200ms transient window was measured on the
    `.ic`/`op`-seeded, non-`uic` cross-check variant, not on the `uic` cold-start
    deck that shipped -- which itself reads 1.81337 V at 0.8-1 ms, settles by
    ~50 ms, and has an 11.0 mV 1ms-window artifact (a PASS, not a FAIL). Also
    fixes the "<=0.1 mV" tail-agreement figure to the measured 0.13 mV. Corrects
    the four editable surfaces (experiment.json claim + deck comments,
    tb_load_regulation.sch header, tb_line_regulation.sch's cross-reference,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
    [tb_line_regulation.sch, tb_load_regulation.sch]
2026-09-26 docs(sim): correct dropout-vs-load's shipped ramp rate to 266.3 V/s / 14ms in two stale prose spots (#191) (#193)
    `sim/dropout-vs-load`'s conversion to a `uic` transient (#178 / PR #186)
    changed the shipped down-ramp from a 20ms/106.5 V/s probe to the final
    8ms/266.3 V/s ramp, but two prose descriptions were left on the old figure.
    Cross-checked against the shipped deck before editing:
    - `experiment.json` `deck.analyses`: `tran 10u 14m uic`
    - `tb_dropout_vs_load.sch` `VVIN`: `PWL(0 0 100u 3.63 6m 3.63 14m 1.5)`
    -> 2.13V over 6ms-14ms = 266.3 V/s
    Corrected:
    - `sim/README.md`'s "`dropout-vs-load` stopped being a `dc` sweep" bullet:
    `tran 10u 26m uic` -> `tran 10u 14m uic`, and "over 6-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
2026-09-26 sim(corner-run): record the .spiceinit ngspice read next to each deck (#194)
    A corner log headered its embedded deck `# ==== deck (exact input given to
    ngspice) ====`, but the deck is only half the input: corner-run.py also
    copies `sim/spiceinit` into the scratch run directory as `.spiceinit`
    (SPICEINIT_FILE, run_corner's `cwd`), and ngspice reads it at startup.
    Neither the corner log nor the summary record named it anywhere.
    That matters because `sim/spiceinit` carries `option klu` — the KLU direct
    linear solver — and #171's gate turns a solver diagnostic into a FAIL
    verdict. #179 hit the consequence directly: extracting `sim/psrr-dc` corner
    `tt_-40c_3.63v` of record 20260926-033606-4a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
    [corner-run.py, test_corner_run.py]
2026-09-26 sim(thermal): the last two #171-gate corners were one node's supply classification in the .nodeset seed, not the trip bifurcation (#189) (#195)
    * sim(thermal): correct EA_TAIL's supply classification in the IC_SEED nodeset (#189)
    #178's `.nodeset` wrote `v(xldo.EA_TAIL)` VIN-relative (`{vsup-0.836}`), but
    EA_TAIL is the SOURCE node of the error amplifier's PMOS input pair, so it sits
    one |Vgs| above the pair's ground-referenced gate voltages (FB/VREF ~ 1.2 V) --
    not one drop below VIN. Three clean cold-start `uic` settles at ss/80 C, one per
    supply on the corner axis, measure its supply slope at 0.24 V/V (2.42179 /
    2.50138 / 2.57694 V at 2.97 / 3.30 / 3.63 V) against 0.97-1.02 V/V for the
    g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
    [tb_thermal_trip.sch]
2026-09-26 sim(dropout-vs-load): drive EN at the VIN rail and hold the ramp rate constant — the fs/125C/2.97V collapse was an enable-path headroom limit the bench convention walked into (#197)
    * sim(dropout-vs-load): drive EN at the VIN rail — 'vsup' now sets VIN, not EN alone
    `dropout-vs-load` was the only bench in sim/ that drove EN off the VIN rail:
    VIN was pinned at 3.63 V for every corner (inherited from the pre-#178 `dc`
    sweep's first point) while 'vsup' drove EN alone, so the `*_2.97v` corners ran
    with EN 0.66 V below VIN. The DUT's enable input is VIN-referenced by
    construction — the M_ENP/M_ENP2/M_ENP3/M_ENP4/M_ENP5 shutdown clamps are PMOS
    with their sources at VIN — so an off-rail E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
    [tb_dropout_vs_load.sch]
2026-09-26 docs(spec): restate the Load transient row's Notes against the full 45-corner record 20260926-013955-6449a98 (#198)
    * docs(spec): restate the Load transient row's Notes against the full 45-corner record
    Replace the stale "a full 45-corner superseding record is pending
    (host-instability-blocked, tracked by #166)" wording, which cited the
    superseded 20260825-081255-4cb27f8 peak-excursion-only run, with the
    result actually on main: record 20260926-013955-6449a98 (minted by
    PR #183), 0/45 PVT corners PASS.
    The Notes now split the row's two clauses the way the record does:
    the peak-excursion clause passes 45/45 at 0.063-0.119 V against the
    ratified <= 150 mV, and the recovery-time clause fails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
2026-09-26 signoff: re-point item 4's LVS citation at a klt-0.6.0 record; defer item 6
    Item 4's citation was klt 0.2.0's 20260825-123628-3b4e121/lvs.json, which
    wrote provenance.input: null and so could never be pinned by the manifest
    itself. Re-point it at 20260924-181216-50554fe/lvs.json (klt 0.6.0,
    provenance.input.content_hash non-null) and pin that hash in
    signoff/block-manifest.json directly. Update artifact-pins.json's item-4
    entries to the new record's GDS/reference.spice and mark the GDS pin
    manifest_pinned. Hand-edit signoff/records/t1-tier-report.json's item-4
    citation to match (see PR description: `check.sh --write` was not safe to
    run on this host).
    Item 4 stays met, per klt signoff --man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
2026-09-26 sim(line-regulation): drive EN at the instantaneous VIN, not the corner's 'vsup'
    This bench's VVIN is its own source, `alter`-ed between 2.97 V and 3.63 V inside
    every corner, while EN's high level was the corner runner's `'vsup'` label. On
    this bench those are different quantities, so at every `*_2.97v` corner the
    VIN = 3.63 V point ran with EN 0.66 V BELOW VIN — the enable-path headroom
    geometry #187 root-caused on sim/dropout-vs-load (five PMOS shutdown clamps
    whose sources are VIN, so their gate drive is VIN − EN). It leaves no solver
    diagnostic, so #171's gate never saw it.
    Convention chosen, of the three #196 put up: EN's high level = the instantaneous
    VIN at every measured point.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
    [tb_line_regulation.sch]
2026-09-26 signoff: re-point item 4 at the CURRENT klt-0.6.0 LVS record (a947aa8), not 50554fe
    Judge review on PR #199: item 4's re-pointed citation
    (20260924-181216-50554fe, PR #155) is a real klt-0.6.0 record with non-null
    provenance.input.content_hash, but it is not the most current LVS record on
    main. Commit 0c65db2 (#163, "size VIN/VOUT as spec-derived power rails")
    redrew the layout after 50554fe was minted, and 20260924-221912-a947aa8 is
    the LVS run against that updated GDS -- which is what
    layout/ldo-core/reports/LATEST-LVS already names. Issue #127's own
    "escalation premise update" comment flagged this; the later "scope narrowed"
    comments this PR's scope was drawn from reverted to naming 50554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
2026-09-26 sim(line-regulation): document the #196 convention, its evidence, and the matrix re-run it leaves open
    sim/README.md gains a "#196" section on the model of #187's: the mechanism as it
    lands on this bench (VIN is the independent variable here, so `'vsup'` and the
    instantaneous VIN are genuinely different quantities), the convention chosen and
    why the other two candidates were rejected, the five-corner confirmation, the
    short-window validation behind it, the behavioural-source cross-check, and a
    sweep of every other bench in sim/ for the same geometry.
    The sweep's result: with line-regulation fixed, no bench in sim/ drives EN below
    VIN at any simulated point — 14 benches plus pex-post-layou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
    [tb_line_regulation.sch]
2026-09-26 sim(line-regulation): cite the follow-up issues #196 leaves behind
    #200 tracks the 45-corner re-run under the committed convention (with the
    measured runtimes and the identical-supply-columns prediction as its own
    acceptance criteria); #201 tracks the psrr-dc AC nuance the bench sweep
    surfaced (EN is a small-signal ground while VVIN carries the 1 V perturbation).
    Part of #196
    [tb_line_regulation.sch]
2026-09-26 signoff: re-point item 6 at the current Monte Carlo record and pin it — the graded reason moves check_failed -> wrong_kind
    Item 6 cited `sim/mc-output-accuracy/klt-responses/20260825-083111-4cb27f8.json`,
    a klt 0.2.0 envelope with `provenance.input: null` that no manifest
    `content_hash` could pin. It was also twice superseded: 20260925-110312-8280915
    supersedes it and 20260925-131502-808cece supersedes that, each by its own
    record's `Supersedes` field, and measurements/characterization.md's Output row
    already cites 808cece. Re-point the manifest at 808cece and pin its
    `provenance.input.content_hash` (sha256:e760a7c3...), which equals that
    envelope's own `environment.netlist_sha256` and the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
2026-09-26 docs(spec): restate the Line/Load regulation rows' Notes against their current records
    The Line regulation row's Notes cell still described record
    20260910-030557-6c0436d ("FAIL (18/45 PVT corners), tracked design gap"),
    three records stale: the row's current evidence is 20260926-200304-35b7392,
    45/45 corners PASS / overall PASS, with line_reg_1ma_mv_per_v
    0.216667-0.595454 mV/V and line_reg_50ma_mv_per_v 0.271212-0.368182 mV/V
    against the ratified < 5 mV/V. The table therefore contradicted the
    measurements/characterization.md rollup it pointed the reader at, and called a
    closed gap a tracked design gap.
    Restate that cell against the current record, and state the interesting part of
    the his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
2026-09-26 sim(psrr-dc): settle the AC-grounded EN question — measured over 45 corners, ≤0.0017 dB, bench unchanged
    `sim/psrr-dc` drives `VVIN` as `DC 'vsup' AC 1` while `VEN` carries no AC
    component, so inside the `ac` analysis `EN` is a small-signal ground and the
    gate drive `VIN − EN` of the five VIN-source-referenced shutdown clamps
    (`M_ENP`/`M_ENP2`/`M_ENP3`/`M_ENP4`/`M_ENP5`, established by #187) ripples at
    the full 1 V amplitude. #196's bench sweep surfaced that and deferred it; #201
    asked for it to be measured before anything changed.
    Measured, both conventions, the full 45-corner matrix twice on one host with
    `--no-write` (neither arm is a new claim about the DUT, so neither mints an
    ev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
    [tb_loop_gain.sch, tb_psrr_dc.sch]
2026-09-27 docs(signoff): item 5 FAIL count 7 -> 6 after Line regulation moved to PASS
    Append the #196 / PR #205 step (record 20260926-200304-35b7392) to item 5's
    parenthetical history in the same shape as the #164 and #189 clauses. The step
    was a bench-convention fix; neither the DUT nor any ratified bound changed.
    #114's stale title is intentionally left to its own pass.
    Closes #207
    Loom-Story: 2AMLogic/sky130-ldo#207
    Loom-Trace-Id: c2d6ef9fa6d85ff73cff72cc27b65ecc
    Loom-Build: 0.19.435 97084dd4cad545b87cd162b68f4329df97ef8ead clean
2026-09-27 docs(signoff): cite sim/README.md -> "#196" in item 5, matching the #164/#189 citation shape
    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
2026-09-27 sim(bin): add yield-run.py, a `klt yield` evidence-record runner (#203)
    Mints an append-only `klt yield` record over an already-committed `klt sim`
    Monte Carlo response: a yield estimate with its confidence interval, a
    distribution/normality fit, Cpk/sigma-to-spec and a sample-size verdict --
    the evidence *kind* T1 item 6 names, which this repo had no producer for.
    The analysis is derived, not measured: it re-reads the per-sample values in
    `klt-responses/<record-id>.json` and runs no simulation, so the runner takes
    a committed response as its input and records the ngspice/PDK/host that
    produced those samples separately, quoted from the source campaign's own
    record, from the klt/klt_yield_na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
2026-09-27 signoff(item 6): cite a real `klt yield` report — unmet/wrong_kind -> met, T1 3/11 -> 4/11 (#203)
    Item 6 asks for one specific evidence kind: "a `klt yield` JSON report -- a
    yield estimate with its confidence interval, sample-size verdict, and
    Cpk/sigma-to-spec against the row's own limits". Since #127 re-pointed the
    item at the current, passing Monte Carlo campaign, that was the item's
    *entire* remaining gap -- the cited check did not fail on its own terms, it
    simply was not the kind asked for, which is what `wrong_kind` meant.
    This mints that report. No new simulation: `klt yield` re-reads the per-sample
    values already committed in `20260925-131502-808cece` (n=200, seed 20260817),
    so th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
2026-09-27 sim(iq): seed the .op chain to the #171 IC contract, fold in #133's regulation gate
    sim/iq/experiment.json's deck.analyses was a chain of two unseeded .op solves
    with an alter between them -- the same unconstrained-.op defect #164
    characterized. All 45 corners of the latest record, 20260910-034648-6c0436d,
    carry a solver diagnostic (singular matrix or out of range for ^), which
    sim/bin/corner-run.py's #171 gate now forces to FAIL outright.
    Converts both points to the contract's uic + EN-edge shape (tran 10u 200m
    uic, VEN stepping high at 101us, both v(vout) and i(vvin) averaged over the
    settled 199-200ms tail), the same shape #172 landed for the sibling
    line-regulation/load-regulation bench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
    [tb_iq.sch]
2026-09-27 sim(negctl): declare the known-bad divider variant for #211's negative control
    `klt yield`'s `negative_control` needs a seeded, known-bad variant of the
    `mc-output-accuracy` campaign — the demonstration that the statistics can
    reject a degraded design rather than only bless a good one (T1 signoff item
    6's own checklist text; issue #211).
    The variant is that campaign's bench verbatim — same testbench schematic
    (referenced, not copied), same tt_mm/27C/3.3V mismatch point, same #164
    initial-condition contract, same `vout_ss` measurement against the same
    ratified 1.764–1.836 V window, same N and seed — with exactly one declared
    defect: the feedback divider's top leg lengthened 180 µm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
    [mc-run.py]
2026-09-27 sim(negctl): run the seeded known-bad variant — item 6's negative control is `detected` (#211)
    T1 signoff item 6 graded `met` on a `klt yield` report (#203/#212) whose own
    run-level warning said the campaign had *"no seeded, known-bad variant
    demonstrating that the statistics above can actually detect a degraded
    design"*. `klt signoff` grades a yield citation on payload status alone, so
    `met` was never evidence that clause held. This closes it with a real
    simulation, not a re-analysis.
    ## What was degraded, and why that
    `sim/mc-output-accuracy-negctl` is the nominal bench *verbatim* — same testbench
    schematic (referenced, not copied), same tt_mm/27 °C/3.3 V mismatch point, same
    #164 `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
2026-09-27 chore: resync installed Loom surfaces
    Loom-Story: 2AMLogic/sky130-ldo#215
    Loom-Trace-Id: unknown
    Loom-Build: 0.19.447 c3e2eb90bfff977866ec988b776bfa9a60451e72 clean
2026-09-27 test: add PDK-free unit coverage for mc-run.py and yield-run.py helpers
    `sim/tests/` covered only `corner-run.py`'s pure helpers, so the
    negative-control machinery issue #211 / PR #216 added to `mc-run.py` and
    `yield-run.py` -- occurrence-count assertions, before/after deck hashes,
    null-sample handling, corner-id suffix stripping, and the nominal
    cross-check -- had no unit coverage at all. `sim/README.md` already states
    the convention (`sim/tests/` = "PDK-free coverage of the runner's pure
    helper functions") and excludes neither script, so this is the gap being
    closed rather than a new convention.
    - sim/tests/test_mc_run.py: 40 tests over `validate_netlist_patch`,
    `apply_netlist_patch` an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
    [test_mc_run.py, test_yield_run.py]
2026-09-27 fix(ci): keep characterization.md byte-identical -- it is sha256-pinned by signoff
    The first commit added prose about the new gate to the *generated* report,
    which changed measurements/characterization.md and broke the
    `signoff-tier-report` CI job: that file is sha256-pinned for T1 item 8 in
    signoff/artifact-pins.json (and transitively in block-manifest.json, the
    generic evidence envelope, and records/t1-tier-report.json), so any text
    change -- prose included -- is a four-file evidence re-pin, not a docs edit.
    Drop the emitted prose so the artifact is byte-identical to main (it hashes to
    the pinned sha256:8fa8cf54... again), and record the constraint in the module
    docstring instead, where t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
2026-09-30 layout: ERC supply spec follows #154's met3 power rail (#112)
    main's LATEST layout record is now 20260924-221821-a947aa8 (#142 hvi
    markers, #154 power rails). Run against that GDS, the ERC pre-flight
    refused the spec with three findings. That is the failure mode the spec
    said it would catch:
    - via2.drawing 69/44 is drawn but not declared;
    - met3.drawing 70/20 is drawn but not declared (#154 straps VIN
    met1+met2+met3; one met3 polygon, 1792 via2 shapes);
    - the substrate well_boxes assertion no longer covers the derived
    substrate-device bbox, which grew in x to 2213.57 um.
    Spec changes:
    - stackup gains met3 (70/20, label 70/5), and vias gains via2 (69/44,
    met2<->met3). Leaving met3 out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
2026-09-30 layout: run klt erc on repo-relative paths so signoff grades item 11 anywhere (#112)
    klt erc echoes its input paths into the envelope's `file` and `spec`
    fields. `klt signoff` 0.6.0, the grader signoff/check.sh pins, reads
    both back when it grades T1 item 11:
    - It re-hashes the GDS that `file` names, trying its own cwd first and
    then the envelope's directory. The result is input_verified true, or
    null if the path does not resolve.
    - It reads the spec document that `spec` names, resolving against its
    own cwd ONLY. If that read fails, item 11 grades
    `supply_spec_incomplete`, because the grader cannot see the spec's
    nets/ties.
    The flow passed absolute paths, so a record graded `met`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
2026-09-30 layout: ERC supply record 20260930-193715-dc2823f -- T1 item 11 MET on main's LATEST GDS (#112)
    Re-mints the item-11 evidence against the layout main actually ships.
    The first record, 20260923-094733-83f99b3, graded layout record
    20260825-123551-3b4e121. That GDS has since been replaced by
    20260924-221821-a947aa8 (#142 hvi markers, #154 met3 power rails). The
    old record stays in place untouched, because records are append-only.
    LATEST-ERC now names the new one.
    Result, from layout/bin/run-ldo-erc-flow.sh with the spec from
    4e58935, klt still pinned at 0.6.0+gcb79a84fe3e4, and repo-relative
    envelope paths from dc2823f:
    - Item 11 verdict: MET.
    - erc_status clean, 0 findings;
    - VIN and 0 e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
2026-09-30 signoff: correlate each paired citation to its own pin, by file
    `signoff/check.sh`'s pinned-hash verification compared each pin against the
    *pooled* set of content_hashes the manifest records for its item. Item 11's
    compound citation has two halves -- the `klt erc` supply-spec run and item 4's
    LVS report -- whose content_hash is legitimately identical, because both read
    the same GDS. So either half's pin satisfied the other half's check, both in
    the forward (pin -> manifest) and reverse (manifest -> pin) direction, and
    deleting one of the two pins outright still passed with no failure reported.
    Nothing was actually unchecked: item 4's own pin independently covers the same
    LVS envelope. But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
2026-09-30 layout: ERC pre-flight re-derives the drawn n-well narrative (#129)
    `check-erc-supply-spec.py` re-derived the *asserted* substrate region on
    every flow run but nothing about a *drawn* well, so the `nwell_tie`
    paragraph of erc-supply-spec.json's `_comment` block had no mechanical
    backstop and went stale silently across the #89 redraw: it kept quoting
    x 2217.32..2383.08 um / 17093 um2 when the GDS it targeted actually
    measured x 2215.32..2381.08 um / 17093.17 um2 (2.0 um off on both edges).
    Nothing machine-read depended on those figures -- `well_layer: "64/20"`
    is a layer reference, not a coordinate -- which is exactly why only a
    check that reads the prose can keep the prose honest. So the ne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
2026-09-30 layout: new ERC supply record for the hardened pre-flight (#129)
    Append-only record 20260930-221337-cbfbb54, minted by
    layout/bin/run-ldo-erc-flow.sh against the same GDS reports/LATEST names
    (layout record 20260924-221821-a947aa8) and the same pinned klt build
    (`0.6.0+gcb79a84fe3e4`) the previous record used. It is needed because
    cbfbb54 changed erc-supply-spec.json, and `erc_supply.json`'s
    `provenance.spec.content_hash` is the hash of the record's own byte copy
    of the spec -- editing the spec without a fresh record would leave the
    committed record's provenance chain unverifiable.
    Verdict unchanged, as expected for a documentation/pre-flight fix:
    `erc_status: clean`, zero findings, all fou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
2026-10-01 chore: resync installed Loom surfaces
    resynced_by: fleet-resync
    invocation: fleet-resync.sh --fleet-only --push
    <!-- loom:provenance v1 build=unknown 19f4e67fd0a0afbd3d8b6606ca91ceac911377a3 clean prompts=none sweep=none story=none trace=78a5dfbdfd8c530aecd1bb436fd096df host=loom-worker-2 base=a324bd1fb357c5481f6f0d8175ad188a706c641b run=loom-run/v1:timer:loom-worker-2/fleet-resync:67c759f7ef3c43e38d3fa8d5f19a2dd1 installs=0.19.593 658650a4f0eff932ac66a8f690eaedf8123fc83b -->
    Loom-Story: none
    Loom-Trace-Id: 78a5dfbdfd8c530aecd1bb436fd096df
    Loom-Build: unknown 19f4e67fd0a0afbd3d8b6606ca91ceac911377a3 clean
2026-10-01 sim: dedup klt_binary() into _record_common.py
    mc-run.py and yield-run.py each carried a byte-identical klt_binary()
    helper (differing only in the trailing usage phrase of the error
    message), the same drift shape _record_common.py's docstring already
    documents twice over for git() and load_corner_run_module(). Extract
    a shared klt_binary(usage_context, error_cls) into _record_common.py,
    parameterizing the one differing line the same way
    render_record_header() parameterizes tools_line; each caller's local
    klt_binary() becomes a thin wrapper that passes its own usage phrase
    and HarnessError type, preserving each script's existing
    except HarnessError handler. Drops mc-run.py's now-unused
    `impor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
    [_record_common.py, mc-run.py, yield-run.py]
2026-10-01 chore: resync installed Loom surfaces
    <!-- loom:provenance v1 build=unknown 56435bf476452911283e43940ecfd9a30f804af9 clean prompts=none sweep=none story=none trace=342405c5ebc99bdbf17afbd983c0c41c host=loom-worker-2 base=66096b316c91f0a7091c492559b7837de04814d6 run=loom-run/v1:timer:loom-worker-2/fleet-resync:20c09f231d424cd5b57ca7991848dd8a installs=0.19.603 8c39bf7cde8a8c03d1aaee441f397c017b6a3a9e -->
    Loom-Trace-Id: 342405c5ebc99bdbf17afbd983c0c41c
    Loom-Build: unknown 56435bf476452911283e43940ecfd9a30f804af9 clean
    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
2026-10-01 chore: resync installed Loom surfaces
    <!-- loom:provenance v1 build=unknown f2868e6b4d60d11a8ab47d25cad9e248229d2f66 clean prompts=none sweep=none story=none trace=4e2766ed5160781df891476246a9be2e host=robb-studio base=8aac5803ff3a662703e7fd5f07bae47d2fbda2c4 run=loom-run/v1:timer:robb-studio/fleet-resync:2d3851d5-1673-43ae-bcc6-e5c971b37f33 installs=0.19.603 74778a6aeea5d9e06b489400942b35f33c8bb766 -->
    Loom-Trace-Id: 4e2766ed5160781df891476246a9be2e
    Loom-Build: unknown f2868e6b4d60d11a8ab47d25cad9e248229d2f66 clean
    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
2026-10-01 chore: resync installed Loom surfaces
    <!-- loom:provenance v1 build=unknown d6714830391f7596338b8de40ee2d0f45dcd12f5 clean prompts=none sweep=none story=none trace=af273f717e759e690d07f372734e9278 host=robb-pro base=f583feaf06bc436a9f27e0e433e5f38dbce1a3d4 run=loom-run/v1:timer:robb-pro/fleet-resync:92e2f9ba-d083-411b-833b-ae52d169ef04 installs=0.19.605 6eb2b65a4496b7becb84ef1f944493a541fd01cd -->
    Loom-Trace-Id: af273f717e759e690d07f372734e9278
    Loom-Build: unknown d6714830391f7596338b8de40ee2d0f45dcd12f5 clean
    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
2026-10-01 chore: resync installed Loom surfaces
    <!-- loom:provenance v1 build=unknown e956e9fee69e53f08b887ca20e14d9058d6f9aee clean prompts=none sweep=none story=none trace=1077dafeb758858c149dd37f4ece3c77 host=loom-worker-2 base=d87528fb0449e06912d8303b3d24e049dddbde47 run=loom-run/v1:timer:loom-worker-2/fleet-resync:e3773167b12d4b3aafa1f76848245174 installs=0.19.609 ff30576dacc8c2734b1c7434bedd29c47122caeb -->
    Loom-Trace-Id: 1077dafeb758858c149dd37f4ece3c77
    Loom-Build: unknown e956e9fee69e53f08b887ca20e14d9058d6f9aee clean
    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
2026-10-01 chore: resync installed Loom surfaces
    <!-- loom:provenance v1 build=unknown 617257919edc1b9b9ee27532c5ec1b8a64523388 clean prompts=none sweep=none story=none trace=dbafe4f8526617aa07c890721298a080 host=robb-studio base=7f95b1d5ecd3c7337110396dbf9585181dcde22f run=loom-run/v1:timer:robb-studio/fleet-resync:1817df66-02cc-4b27-927d-a38485da550a installs=0.19.610 c94891dd526cf6db5ee02045424c6913be522048 -->
    Loom-Trace-Id: dbafe4f8526617aa07c890721298a080
    Loom-Build: unknown 617257919edc1b9b9ee27532c5ec1b8a64523388 clean
    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
2026-10-01 chore: resync installed Loom surfaces
    <!-- loom:provenance v1 build=unknown a2a39ac2736eb2686e2c65412d939e67c0438a7d clean prompts=none sweep=none story=none trace=fc1a121767151aae5bd7427c683b7db6 host=robb-pro base=bd634e456be672bcd3988dac38c5e0608fd3c19c run=loom-run/v1:timer:robb-pro/fleet-resync:708eb7c8-469d-4783-80b7-bafe142df3c4 installs=0.19.612 d25614656adcf70162da95c5e1035e99a0639a1a -->
    Loom-Trace-Id: fc1a121767151aae5bd7427c683b7db6
    Loom-Build: unknown a2a39ac2736eb2686e2c65412d939e67c0438a7d clean
    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
2026-10-01 chore(tooling): update repo-skills to v0.19.5
    Fleet-wide Repo Skills rollout (2026-10-01). compute-drift's axis 6
    reported repo-skills at 11 different versions across the fleet's
    checkouts; this brings sky130-ldo from v0.10.0 to v0.19.5 (rjwalters/repo
    @ ff282cd), staging only the installer's own surface.
    Loom-Trace-Id: 038dce5d677bceeeca3c111787ac5b68
    Loom-Build: unknown unknown unknown
    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
2026-10-01 chore: resync installed Loom surfaces
    <!-- loom:provenance v1 build=unknown 126c80914e42f913c4fc778d3ddce96daa2c7a77 clean prompts=none sweep=none story=none trace=15a20fbea7a00d0922b943088c80e19d host=loom-worker-1 base=6bdcc45ac3cd79e5a2292d5c2933c92e33ff9ed5 run=loom-run/v1:script:loom-worker-1/fleet-resync:ecc423da-4625-49de-b25a-692fd669a029 installs=0.19.612 d47e0c57a6bea6f7b61ef9ce62632d70c39ef5d5 -->
    Loom-Trace-Id: 15a20fbea7a00d0922b943088c80e19d
    Loom-Build: unknown 126c80914e42f913c4fc778d3ddce96daa2c7a77 clean
    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
2026-10-01 chore: resync installed Loom surfaces
    <!-- loom:provenance v1 build=unknown 126c80914e42f913c4fc778d3ddce96daa2c7a77 clean prompts=none sweep=none story=none trace=a0a42bd10fcfa6d7cbcc9c021c406848 host=loom-worker-2 base=4fc48b0b536f24c610f22a9d19e4a0f04b6ed897 run=loom-run/v1:timer:loom-worker-2/fleet-resync:9e174e6bb0fa41d786e4a86e45632b6f installs=0.19.612 6f0871dc66e62b36d8382ced980d2805bfd97e50 -->
    Loom-Trace-Id: a0a42bd10fcfa6d7cbcc9c021c406848
    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
2026-10-01 chore: resync installed Loom surfaces
    <!-- loom:provenance v1 build=unknown 8891f74a5d568fe3d13937ef37fd64371dd2738f clean prompts=none sweep=none story=none trace=1e216ea76cbd2b72542049c4c18c2817 host=loom-worker-1 base=552642c5fe7fb1845aea2c002578b908ceb8c367 run=loom-run/v1:timer:loom-worker-1/fleet-resync:679feba6c0f347d39eb5943ed77dc87b installs=0.19.612 62fa67f8756bdf59fdf744be053e5ef1709f1335 -->
    Loom-Trace-Id: 1e216ea76cbd2b72542049c4c18c2817
    Loom-Build: unknown 8891f74a5d568fe3d13937ef37fd64371dd2738f clean
    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
2026-10-01 chore: resync installed Loom surfaces
    <!-- loom:provenance v1 build=unknown 6f3411c8a63e68097dde01bce8a8422230f54218 clean prompts=none sweep=none story=none trace=9aa0a46bb352b9665fdaa5f5b3b85dd7 host=robb-pro base=c3da2b591f28b3df5c289d5ae85896106049d70b run=loom-run/v1:timer:robb-pro/fleet-resync:ca419e1d-6646-4678-ac7a-b263e4b5119e installs=0.19.612 7731400b3e3e1df39074564166edf656feb0999c -->
    Loom-Trace-Id: 9aa0a46bb352b9665fdaa5f5b3b85dd7
    Loom-Build: unknown 6f3411c8a63e68097dde01bce8a8422230f54218 clean
    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
2026-10-02 chore: resync installed Loom surfaces
    <!-- loom:provenance v1 build=unknown 13c0a3ef467a888520a6529ab34486ab8be826be clean prompts=none sweep=none story=none trace=41356080f367e491d5ff03f17bb98c27 host=loom-worker-2 base=35e574a5175e636168484a79d9a8a45a2ebe7161 run=loom-run/v1:timer:loom-worker-2/fleet-resync:44455fbcbab745abb92cea192fafbb1d installs=0.19.614 3c79f7b1d0cc14723e049cff4250ff7330804326 -->
    Loom-Trace-Id: 41356080f367e491d5ff03f17bb98c27
    Loom-Build: unknown 13c0a3ef467a888520a6529ab34486ab8be826be clean
    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
2026-10-02 chore: resync installed Loom surfaces
    <!-- loom:provenance v1 build=unknown ea2dd21f2ba310ec007d047ddfecc6cd27d220ac clean prompts=none sweep=none story=none trace=f04a67f3922788d2ccdd66578c8d18f9 host=loom-worker-1 base=75b2b2afb2779d0e18ba42350e8120703316b793 run=loom-run/v1:timer:loom-worker-1/fleet-resync:1c3b601dd998488595adc09040c007d4 installs=0.19.614 79f4897c5d3c78dbfc1b022f77d244838dbf4ccb -->
    Loom-Trace-Id: f04a67f3922788d2ccdd66578c8d18f9
    Loom-Build: unknown ea2dd21f2ba310ec007d047ddfecc6cd27d220ac clean
    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
2026-10-02 chore: resync installed Loom surfaces
    <!-- loom:provenance v1 build=unknown 6f3411c8a63e68097dde01bce8a8422230f54218 clean prompts=none sweep=none story=none trace=acb28d0049e0cc75536f96d503f6e814 host=robb-studio base=3aaea4c0b3d441ac92754338454b6ed3f2690250 run=loom-run/v1:timer:robb-studio/fleet-resync:85d2b1b5-e81d-40c3-ab6a-9a00efbc4ee2 installs=0.19.616 d86523eeadb32b95777f3cd3a76dd2f72f0bf792 -->
    Loom-Trace-Id: acb28d0049e0cc75536f96d503f6e814
    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
2026-10-02 chore: resync installed Loom surfaces
    <!-- loom:provenance v1 build=unknown 2b50bd69eddd038dd738465aa58a9ebca11410ac clean prompts=none sweep=none story=none trace=324e4f607054d0396cfdf8fdc01e93ae host=robb-pro base=5b3c8669146d257da66fc53be28cdf04c5c111c4 run=loom-run/v1:timer:robb-pro/fleet-resync:a63799f1-2ad7-4946-b81d-2ec231bc2d2f installs=0.19.617 81cb2ad7e091b19d6a2b95d1add6938c2100d46b -->
    Loom-Trace-Id: 324e4f607054d0396cfdf8fdc01e93ae
    Loom-Build: unknown 2b50bd69eddd038dd738465aa58a9ebca11410ac clean
    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
2026-10-02 chore: resync installed Loom surfaces
    <!-- loom:provenance v1 build=unknown 00d92b326aed50280cd90dc116b7caec27668251 clean prompts=none sweep=none story=none trace=9a5d23cc82b6d3a1c83bfee47bd04970 host=loom-worker-2 base=4c0f37c4e3367ec186058525eedeb9c96c668a69 run=loom-run/v1:timer:loom-worker-2/fleet-resync:12136a7a025d49f3a60b5edb04a3ff81 installs=0.19.619 4c0f505e4f0b76f8ccec07bda6d8b839030c077b -->
    Loom-Trace-Id: 9a5d23cc82b6d3a1c83bfee47bd04970
    Loom-Build: unknown 00d92b326aed50280cd90dc116b7caec27668251 clean
    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
2026-10-02 chore: resync installed Loom surfaces
    <!-- loom:provenance v1 build=unknown 456dad6d90259846313dc3bb80bf4e5471ef2d76 clean prompts=none sweep=none story=none trace=bb9688c03fb5211d06f48c8838a5505c host=robb-studio base=73b14dc84602b1077c3f4c66dd19527e559da20b run=loom-run/v1:timer:robb-studio/fleet-resync:e965c017-8ec7-485d-b46e-aeb399b81fb4 installs=0.19.620 0d28ba49f5a88fdb37271de9cb0144eb3442c6e3 -->
    Loom-Trace-Id: bb9688c03fb5211d06f48c8838a5505c
    Loom-Build: unknown 456dad6d90259846313dc3bb80bf4e5471ef2d76 clean
    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
2026-10-02 chore: resync installed Loom surfaces
    <!-- loom:provenance v1 build=unknown 6c6d2b6565dc13eff4c6811b9c670f452106516b clean prompts=none sweep=none story=none trace=539be979ae694d66ede516a7b5d17e41 host=robb-pro base=885afefcb92da1422d5cf633604d024e10292ef9 run=loom-run/v1:timer:robb-pro/fleet-resync:9444d216-de08-442f-8352-ba59f6e81bb3 installs=0.19.621 a90dc1d794eb9ff70aaf939ebf495abe716f3bdd -->
    Loom-Trace-Id: 539be979ae694d66ede516a7b5d17e41
    Loom-Build: unknown 6c6d2b6565dc13eff4c6811b9c670f452106516b clean
    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
2026-10-02 chore: resync installed Loom surfaces
    <!-- loom:provenance v1 build=unknown f6d28134bfe476967e005d97424073085f55e8a3 clean prompts=none sweep=none story=none trace=27eb90670d441065f593e941066ee005 host=loom-worker-2 base=828c9f270a1f420dcfd2376ea84ce64df2c550bb run=loom-run/v1:timer:loom-worker-2/fleet-resync:04001bba930241cf9e325bf304a9270a installs=0.19.623 ccc19c2bbe2aa65328427730fa53f70eb56128c6 -->
    Loom-Trace-Id: 27eb90670d441065f593e941066ee005
    Loom-Build: unknown f6d28134bfe476967e005d97424073085f55e8a3 clean
    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
2026-10-02 chore: resync installed Loom surfaces
    <!-- loom:provenance v1 build=unknown bc461736314499b6c2c4c0ad51fb2294f60336f5 clean prompts=none sweep=none story=none trace=c3ea68717dd3a908dbbd60a35bc8b5d6 host=robb-studio base=9442a27d86338a732a3160869bb1a8460a55e47c run=loom-run/v1:timer:robb-studio/fleet-resync:8d4c49e2-3258-4080-b0c8-082499053654 installs=0.19.623 a50aaf70069f8897c41a64b7d90783c5ab8294e0 -->
    Loom-Trace-Id: c3ea68717dd3a908dbbd60a35bc8b5d6
    Loom-Build: unknown bc461736314499b6c2c4c0ad51fb2294f60336f5 clean
    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
2026-10-02 chore: resync installed Loom surfaces
    <!-- loom:provenance v1 build=unknown bc461736314499b6c2c4c0ad51fb2294f60336f5 clean prompts=none sweep=none story=none trace=8bee8a664bfc89e0bbfbb3c2de7342ba host=loom-worker-2 base=1a8f9841c98daf45c31a21be259ab0c8cff99725 run=loom-run/v1:timer:loom-worker-2/fleet-resync:de2ceceb48ea4927a1334d08dc0082fe installs=0.19.624 5f49564fa78ae06f8c48d5224dae9ded04200bb7 -->
    Loom-Trace-Id: 8bee8a664bfc89e0bbfbb3c2de7342ba
    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
2026-10-03 chore: resync installed Loom surfaces
    <!-- loom:provenance v1 build=unknown 752d316233ed1a3da9e4f69ad760eb99bb477747 clean prompts=none sweep=none story=none trace=7851839b67c00a023e97cbdea1f580e1 host=robb-pro base=20785b6f94774f691ea2c38bbb65d1f79eae16ba run=loom-run/v1:timer:robb-pro/fleet-resync:ae492b66-dca0-4da4-acab-8d26778f2d5c installs=0.19.624 121fac45f5006879bf58a18c951b9243d9099a18 -->
    Loom-Trace-Id: 7851839b67c00a023e97cbdea1f580e1
    Loom-Build: unknown 752d316233ed1a3da9e4f69ad760eb99bb477747 clean
    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
2026-10-03 chore: resync installed Loom surfaces
    <!-- loom:provenance v1 build=unknown b34a08286a42f47f917ec46647d4d167c1f5207c clean prompts=none sweep=none story=none trace=a8e453124b899b440f42c9d83837c7b6 host=loom-worker-2 base=53be41498d8b88252c6b67e358305f86997e720a run=loom-run/v1:timer:loom-worker-2/fleet-resync:f02dd5df715347fe90fe14b9353a1b66 installs=0.19.624 0162badc662fb30c070e70611aa8ff74a8486d54 -->
    Loom-Trace-Id: a8e453124b899b440f42c9d83837c7b6
    Loom-Build: unknown b34a08286a42f47f917ec46647d4d167c1f5207c clean
    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
2026-10-03 chore: resync installed Loom surfaces
    <!-- loom:provenance v1 build=unknown 3437cece5ab759f772122f8d18a6d2f05d246cde clean prompts=none sweep=none story=none trace=bba21427f750636f851279cfae92b4e5 host=loom-worker-1 base=13c3920f258b709141ae7c04615e145ad6f12e16 run=loom-run/v1:timer:loom-worker-1/fleet-resync:9440cda9476f404caa282e360a81ee03 installs=0.19.636 e41edfbb52c13982f7d8b0577f42957427a6514c -->
    Loom-Trace-Id: bba21427f750636f851279cfae92b4e5
    Loom-Build: unknown 3437cece5ab759f772122f8d18a6d2f05d246cde clean
    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
2026-10-03 chore: resync installed Loom surfaces
    <!-- loom:provenance v1 build=unknown 28040ed11a4369e20f3b7b0154a3fb2a2c35d38c clean prompts=none sweep=none story=none trace=0cd87d01c45d97a2ee57a99363fc0db2 host=robb-studio base=37ba09061b904b617d6cd39af724d4f3ff18d5e3 run=loom-run/v1:timer:robb-studio/fleet-resync:74b93657-6b04-4ac5-bc77-e0a1682b0595 installs=0.19.636 e41edfbb52c13982f7d8b0577f42957427a6514c -->
    Loom-Trace-Id: 0cd87d01c45d97a2ee57a99363fc0db2
    Loom-Build: unknown 28040ed11a4369e20f3b7b0154a3fb2a2c35d38c clean
    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
2026-10-03 chore: resync installed Loom surfaces
    <!-- loom:provenance v1 build=unknown 388c7fe0cad997f7a887f70c9f2cfe8781a2d512 clean prompts=none sweep=none story=none trace=2046ffd42f138a06b914f34851de3440 host=loom-worker-2 base=7a203fa531e687c3cb82ef9524022556af9a9956 run=loom-run/v1:timer:loom-worker-2/fleet-resync:17c9456bb1934c70a545b12081496cce installs=0.19.647 d1fe5dead4202be12a964ab891fd5980e7836170 -->
    Loom-Trace-Id: 2046ffd42f138a06b914f34851de3440
    Loom-Build: unknown 388c7fe0cad997f7a887f70c9f2cfe8781a2d512 clean
    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
2026-10-03 chore: resync installed Loom surfaces
    <!-- loom:provenance v1 build=unknown 8078c29e691123d91cd761a786f99cfd25f1809d clean prompts=none sweep=none story=none trace=45869a6374635c036a11a6f379fe31a4 host=robb-pro base=c5dc916ef86ef5f162cea0acea6d7953b9cde9af run=loom-run/v1:timer:robb-pro/fleet-resync:b0a94991-052d-4e7d-ba2b-78b971096849 installs=0.19.647 709ca4396e074e5a4d1c5e19721f6ddac7154ca2 -->
    Loom-Trace-Id: 45869a6374635c036a11a6f379fe31a4
    Loom-Build: unknown 8078c29e691123d91cd761a786f99cfd25f1809d clean
    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
2026-10-03 chore: resync installed Loom surfaces
    <!-- loom:provenance v1 build=unknown f9cba29b0602624a23daa17ae04d31d82e10fa91 clean prompts=none sweep=none story=none trace=754b3688f97b6c34894d8cfbf272b81a host=loom-worker-1 base=33b1b7750d013c784eadb35b41027b457c69b1c1 run=loom-run/v1:script:loom-worker-1/fleet-resync:11eb117a-9ff3-4411-88d4-fdd7d6748639 installs=0.19.649 6f2f13b1c31ce420e2250ae040d8e1050c0e761b -->
    Loom-Trace-Id: 754b3688f97b6c34894d8cfbf272b81a
    Loom-Build: unknown f9cba29b0602624a23daa17ae04d31d82e10fa91 clean
    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
2026-10-03 chore: resync installed Loom surfaces
    <!-- loom:provenance v1 build=unknown f9cba29b0602624a23daa17ae04d31d82e10fa91 clean prompts=none sweep=none story=none trace=544a028e3829d4020b8aaa144e5fa628 host=robb-studio base=a776c19400bbba9e7d0e0fd91bdaf96e508f72d8 run=loom-run/v1:script:robb-studio/fleet-resync:5b5b8b83-7139-447d-88bd-417dcf375aa6 installs=0.19.649 6f2f13b1c31ce420e2250ae040d8e1050c0e761b -->
    Loom-Trace-Id: 544a028e3829d4020b8aaa144e5fa628
    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
2026-10-03 chore: resync installed Loom surfaces
    <!-- loom:provenance v1 build=unknown f9cba29b0602624a23daa17ae04d31d82e10fa91 clean prompts=none sweep=none story=none trace=1057aaaf811f6dd2d64a3bb6d4b3ac49 host=robb-pro base=7d7e120c3e8ae83c0b59ee1ea1223a2e8affcba3 run=loom-run/v1:timer:robb-pro/fleet-resync:785c1ea0-d7f2-4810-99e9-cd9368aebe0c installs=0.19.649 2118aabb5a925f1ec4669b4d3d31176a46d8f2a6 -->
    Loom-Trace-Id: 1057aaaf811f6dd2d64a3bb6d4b3ac49
    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
2026-10-03 chore: resync installed Loom surfaces
    <!-- loom:provenance v1 build=unknown 72f61d9aa0fe08f1ef59f1a97a314e474455801e clean prompts=none sweep=none story=none trace=577d2185973ec59f059fa15bf5b5e514 host=loom-worker-1 base=b22676666eb4640ce6895099c0d873939c81d5c7 run=loom-run/v1:script:loom-worker-1/fleet-resync:5728a930-137f-4d2f-a962-1cdd7a6a1d46 installs=0.19.652 235a64727b907d65529151af0a962b14f16462a0 -->
    Loom-Trace-Id: 577d2185973ec59f059fa15bf5b5e514
    Loom-Build: unknown 72f61d9aa0fe08f1ef59f1a97a314e474455801e clean
    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
2026-10-03 chore: resync installed Loom surfaces
    <!-- loom:provenance v1 build=unknown 72f61d9aa0fe08f1ef59f1a97a314e474455801e clean prompts=none sweep=none story=none trace=845aaa0eb340f80f12095e2e8b421ed1 host=robb-pro base=049dac0e7e07b1dbf724d8256241f84fc6284cda run=loom-run/v1:script:robb-pro/fleet-resync:344add4b-df8a-49e8-8563-2765673acc76 installs=0.19.652 235a64727b907d65529151af0a962b14f16462a0 -->
    Loom-Trace-Id: 845aaa0eb340f80f12095e2e8b421ed1
    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
2026-10-03 chore: resync installed Loom surfaces
    <!-- loom:provenance v1 build=unknown 21130104346fe9c464ce8a3fdf82c1d3e9667639 clean prompts=none sweep=none story=none trace=36308fff5a3c323c3d1bf6fffb6cd122 host=robb-studio base=cc0b292c5f90a1b1d783f2fc24ab1d56d7fbbd7d run=loom-run/v1:timer:robb-studio/fleet-resync:89972fbd-0774-4402-bbb7-26c33a851735 installs=0.19.652 fb69233bd8f1dfc2bdee37d8b934f99274dc0193 -->
    Loom-Trace-Id: 36308fff5a3c323c3d1bf6fffb6cd122
    Loom-Build: unknown 21130104346fe9c464ce8a3fdf82c1d3e9667639 clean
    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
2026-10-04 chore: resync installed Loom surfaces
    <!-- loom:provenance v1 build=unknown 61870b40779d205c1555e801c6e1d95df083cdea clean prompts=none sweep=none story=none trace=fb9213e215442932d2af05f3b14977de host=robb-pro base=3e776c49bb9416162a5022a217f33a17506b8177 run=loom-run/v1:timer:robb-pro/fleet-resync:4c70cd1d-08cd-4add-8e2a-9a75160d163f installs=0.19.655 36c39e3c6f56e1979647ec235b4bd19c77db22f3 -->
    Loom-Trace-Id: fb9213e215442932d2af05f3b14977de
    Loom-Build: unknown 61870b40779d205c1555e801c6e1d95df083cdea clean
    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
2026-10-04 chore: resync installed Loom surfaces
    <!-- loom:provenance v1 build=unknown 61870b40779d205c1555e801c6e1d95df083cdea clean prompts=none sweep=none story=none trace=baa6c2cfcae1a320917c00ff2eb8b630 host=loom-worker-2 base=c4e14ed61cee35710e90b6b47b3c40bd222a55ee run=loom-run/v1:timer:loom-worker-2/fleet-resync:741a7f0f16df4fb1be4e657aeacd1244 installs=0.19.655 fc667a4faae1227f8a6837431f8a0c2d0aeaa7dd -->
    Loom-Trace-Id: baa6c2cfcae1a320917c00ff2eb8b630
    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
2026-10-04 chore: resync installed Loom surfaces
    <!-- loom:provenance v1 build=unknown b922acb2ac655cbccd71daa9e3f05a325a094ca5 clean prompts=none sweep=none story=none trace=833eeb34d4ca65c3f8c6f7824ddca3a3 host=robb-studio base=01de9a0d9f1a752e4aa3c870f6afb94a38710d5e run=loom-run/v1:timer:robb-studio/fleet-resync:0d44f6dc-6a62-4d43-b49d-7cfdd7dbd823 installs=0.19.663 0a51e373e7fe1be156c5774b2c827d4b745368a3 -->
    Loom-Trace-Id: 833eeb34d4ca65c3f8c6f7824ddca3a3
    Loom-Build: unknown b922acb2ac655cbccd71daa9e3f05a325a094ca5 clean
    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
2026-10-04 chore: resync installed Loom surfaces
    <!-- loom:provenance v1 build=unknown 746ecb5f9d7e64ba1d2526f1e997530ad4f3dd43 clean prompts=none sweep=none story=none trace=f09501431241df2ec5688e334ba43dfe host=loom-worker-2 base=8c3e4447929ba2430e53fefc674484c50e3fa420 run=loom-run/v1:timer:loom-worker-2/fleet-resync:70797dad61fb4e21806716d54f1ce910 installs=0.19.669 59a1f84e3742827a8033bb153ebbedc1759bee72 -->
    Loom-Trace-Id: f09501431241df2ec5688e334ba43dfe
    Loom-Build: unknown 746ecb5f9d7e64ba1d2526f1e997530ad4f3dd43 clean
    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
2026-10-04 chore: resync installed Loom surfaces
    <!-- loom:provenance v1 build=unknown 8080d0485cc1312129ee642b084944c56d1be074 clean prompts=none sweep=none story=none trace=ed180bcab6828041123ad54d8ddb4037 host=robb-pro base=bf8118a22a28090eb21bbed2e9f92b9741d8dc2b run=loom-run/v1:timer:robb-pro/fleet-resync:e97b2f08-4ad9-4b66-a166-5b19820e2d1f installs=0.19.669 59a1f84e3742827a8033bb153ebbedc1759bee72 -->
    Loom-Trace-Id: ed180bcab6828041123ad54d8ddb4037
    Loom-Build: unknown 8080d0485cc1312129ee642b084944c56d1be074 clean
    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
2026-10-04 chore: resync installed Loom surfaces
    <!-- loom:provenance v1 build=unknown 83cb6647167ffc000d2c2f479b4e816b68f863f4 clean prompts=none sweep=none story=none trace=ccabffa1e1ba495895b262086030816c host=robb-studio base=01d965941f32d3136bc85fe97e9616b2c98722e6 run=loom-run/v1:timer:robb-studio/fleet-resync:88a78f1f-d978-47b5-99c3-2aabde811d17 installs=0.19.676 cd4f30bd892ea2595d8218b08150633504b0dd14 -->
    Loom-Trace-Id: ccabffa1e1ba495895b262086030816c
    Loom-Build: unknown 83cb6647167ffc000d2c2f479b4e816b68f863f4 clean
    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
2026-10-04 chore: resync installed Loom surfaces
    <!-- loom:provenance v1 build=unknown 32174d0f7e80508fa66c1a11a2c0fb28c515607e clean prompts=none sweep=none story=none trace=436d7c19b10cd5807625a7ce7190a82f host=loom-worker-2 base=51fd56be985498591798b3d497576cf01552c3df run=loom-run/v1:timer:loom-worker-2/fleet-resync:19ae50771cc04d8db7b1403c1e66bbea installs=0.19.682 9eccfa110fa294fa32a62ffe8eff669cfcf1a3a6 -->
    Loom-Trace-Id: 436d7c19b10cd5807625a7ce7190a82f
    Loom-Build: unknown 32174d0f7e80508fa66c1a11a2c0fb28c515607e clean
    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
2026-10-04 chore: resync installed Loom surfaces
    <!-- loom:provenance v1 build=unknown 72290fa960e0773b2c50d74042e24914c7327637 clean prompts=none sweep=none story=none trace=f7b6952a649a174398a48b90b6ab4793 host=robb-pro base=a7b8466553c5af80c2778cd863caa0ca1fae7c28 run=loom-run/v1:timer:robb-pro/fleet-resync:72f32482-5cc4-4b38-ab9e-4d2ef0b64e94 installs=0.19.684 bdb8fb331eb51c7def4cdd2c38b611af06f25f6d -->
    Loom-Trace-Id: f7b6952a649a174398a48b90b6ab4793
    Loom-Build: unknown 72290fa960e0773b2c50d74042e24914c7327637 clean
    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
2026-10-04 chore: resync installed Loom surfaces
    <!-- loom:provenance v1 build=unknown 76cda58637be0e74c4cb5b4c8dbc2000e2a9c3d4 clean prompts=none sweep=none story=none trace=614cbada5ce873c2b34a511816309cfc host=robb-studio base=4deb2d5caae01a9d9cd0d5abaf8cc471480f61b4 run=loom-run/v1:timer:robb-studio/fleet-resync:7e559a3b-ffdd-409b-8dd2-ae906a273b0a installs=0.19.692 d4974b9f5ff7843a3cfc06378ea2a69bc120e0f4 -->
    Loom-Trace-Id: 614cbada5ce873c2b34a511816309cfc
    Loom-Build: unknown 76cda58637be0e74c4cb5b4c8dbc2000e2a9c3d4 clean
    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
2026-10-04 chore: resync installed Loom surfaces
    <!-- loom:provenance v1 build=unknown f84bac5c232c093f83c1adc2533d8c75b021cda2 clean prompts=none sweep=none story=none trace=e687830614e4bd1c551ab6cf6186f8f3 host=loom-worker-2 base=4c44d658520e2fbab10d12b4bc81482700867af5 run=loom-run/v1:timer:loom-worker-2/fleet-resync:2db2c4373ac24de1b7a364e69eaea1ca installs=0.19.695 b0d5b09f207fda439390ea1dd249ad10e7009dfc -->
    Loom-Trace-Id: e687830614e4bd1c551ab6cf6186f8f3
    Loom-Build: unknown f84bac5c232c093f83c1adc2533d8c75b021cda2 clean
    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
2026-10-04 chore: resync installed Loom surfaces
    <!-- loom:provenance v1 build=unknown ac5c275d1c616a9723e747f5a66de93dc80d3512 clean prompts=none sweep=none story=none trace=c777c3912bd31972e9aa3ccab712ae01 host=loom-worker-1 base=fc25b9b65174b8d8f6f18dd4b300947b32c575a7 run=loom-run/v1:script:loom-worker-1/fleet-resync:b51a1b33-4958-4408-be36-166e12e8360b installs=0.19.697 ada83a5c7ff66b56b0060ef0be368c9fe56eb3c6 -->
    Loom-Trace-Id: c777c3912bd31972e9aa3ccab712ae01
    Loom-Build: unknown ac5c275d1c616a9723e747f5a66de93dc80d3512 clean
    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
2026-10-04 chore: resync installed Loom surfaces
    <!-- loom:provenance v1 build=unknown a19f642f5c09599c4c64827d81d228eb031be73e clean prompts=none sweep=none story=none trace=34a80e22764eb5055e37faec0eaf65fb host=robb-pro base=a890b08ce564c146e7a95f819f2166c0b959e1a1 run=loom-run/v1:script:robb-pro/fleet-resync:689be620-3ff2-4ff5-a2ce-f6825f6379e2 installs=0.19.698 aa619a1d07e36e8d90ac01fea63dc39285c93567 -->
    Loom-Trace-Id: 34a80e22764eb5055e37faec0eaf65fb
    Loom-Build: unknown a19f642f5c09599c4c64827d81d228eb031be73e clean
    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
2026-10-04 chore: resync installed Loom surfaces
    <!-- loom:provenance v1 build=unknown 693bdd794cb34afdefd7f0c4596824cd53078a61 clean prompts=none sweep=none story=none trace=aa18f1ec102a98d77ffc51c9be6ffbb3 host=robb-studio base=35f828db761eb5b9d2154307f31ec15bff77626f run=loom-run/v1:script:robb-studio/fleet-resync:3cb89ca8-62c2-4a69-8434-c4aaa3b64eaf installs=0.19.698 a58f00e0681c50d6bfc5089d0af4b3715198319f -->
    Loom-Trace-Id: aa18f1ec102a98d77ffc51c9be6ffbb3
    Loom-Build: unknown 693bdd794cb34afdefd7f0c4596824cd53078a61 clean
    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
2026-10-04 chore: resync installed Loom surfaces
    <!-- loom:provenance v1 build=unknown 7a41c2e69ef89d60ed3bd190b94838021bf18d0f clean prompts=none sweep=none story=none trace=d0f04f38b507d85402723643fcf47197 host=loom-worker-1 base=b28016636cd55c623a8624b496dcd72e643d5831 run=loom-run/v1:script:loom-worker-1/fleet-resync:8fdc8c1c-f844-4c33-bc80-b424e5b4cf3d installs=0.19.703 89d5a428c652f957d7fad8a546589042d39911bc -->
    Loom-Trace-Id: d0f04f38b507d85402723643fcf47197
    Loom-Build: unknown 7a41c2e69ef89d60ed3bd190b94838021bf18d0f clean
    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
2026-10-05 chore: resync installed Loom surfaces
    <!-- loom:provenance v1 build=unknown ebb37db560de172930e261675a35bd52e429f650 clean prompts=none sweep=none story=none trace=a40e86a64366c7a1e36aea026901334f host=loom-worker-2 base=171902bfd3909d5882d074da5299869ee542b770 run=loom-run/v1:script:loom-worker-2/fleet-resync:90b6cd74-6cc0-4f58-98ee-6ede0ac6f50c installs=0.19.703 f63c3c82e6bf202f2ca7b205b532f681c5ebb2c8 -->
    Loom-Trace-Id: a40e86a64366c7a1e36aea026901334f
    Loom-Build: unknown ebb37db560de172930e261675a35bd52e429f650 clean
    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
2026-10-05 chore: resync installed Loom surfaces
    <!-- loom:provenance v1 build=unknown 7a41c2e69ef89d60ed3bd190b94838021bf18d0f clean prompts=none sweep=none story=none trace=fc04851db12f586b5d58155325131b6e host=robb-studio base=0ecf83387c6b50a2916a1b4afe596e39c15d8510 run=loom-run/v1:timer:robb-studio/fleet-resync:a7d5da6f-a896-4d6f-8d00-aebf47f9b266 installs=0.19.703 2ad9a08fb93de4d7dfac9d2b501d12c684c9c2cc -->
    Loom-Trace-Id: fc04851db12f586b5d58155325131b6e
    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
2026-10-05 chore: resync installed Loom surfaces
    <!-- loom:provenance v1 build=unknown afe7e99e397c242cc319fa80702fb3b23e23f5a7 clean prompts=none sweep=none story=none trace=e46782e1dd9c94461b4cf934ce05296b host=loom-worker-2 base=96a02bff05ceaeef6e3fe4f183627776c10235ca run=loom-run/v1:timer:loom-worker-2/fleet-resync:caa89259b1fd414ebd2f07500621166d installs=0.19.703 972fe7321be6a9efe2653579379ea3bc40b899b2 -->
    Loom-Trace-Id: e46782e1dd9c94461b4cf934ce05296b
    Loom-Build: unknown afe7e99e397c242cc319fa80702fb3b23e23f5a7 clean
    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
2026-10-05 chore: resync installed Loom surfaces
    <!-- loom:provenance v1 build=unknown b44cb904ebb599db793066ccc631c846862abfbd clean prompts=none sweep=none story=none trace=9590fed7c1b1c9f549ccf3cba24292d7 host=robb-pro base=38fafaca2a383add8769e89e857896184e858168 run=loom-run/v1:timer:robb-pro/fleet-resync:dbc6174e-403d-422d-98b6-73a4b6dbf44f installs=0.19.708 dc8faf1eae3143feda6301887c303b1ee45db7f4 -->
    Loom-Trace-Id: 9590fed7c1b1c9f549ccf3cba24292d7
    Loom-Build: unknown b44cb904ebb599db793066ccc631c846862abfbd clean
    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
2026-10-05 chore: resync installed Loom surfaces
    <!-- loom:provenance v1 build=unknown 4548905848fcb7cb875c1c0518f2fd88eb65818e clean prompts=none sweep=none story=none trace=aff5e139797705f6fa0811f102ecd103 host=loom-worker-1 base=3603e060829d73fe0d69668abbfa44c446bebb6e run=loom-run/v1:timer:loom-worker-1/fleet-resync:ba6a9e5686a64abaa842d71acaeae2ca installs=0.19.718 00d99344506bcf00e1aec7e910abe3d13df2d240 -->
    Loom-Trace-Id: aff5e139797705f6fa0811f102ecd103
    Loom-Build: unknown 4548905848fcb7cb875c1c0518f2fd88eb65818e clean
    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
2026-10-05 chore: resync installed Loom surfaces
    <!-- loom:provenance v1 build=unknown e7efbaa6e7b97a7d72da6032044c67525291f4d1 clean prompts=none sweep=none story=none trace=d74a33a6f35e329b3e795991e790ebfd host=robb-studio base=f4132ee922f8310ad65da897f99bdea3d07de37b run=loom-run/v1:timer:robb-studio/fleet-resync:304f49c8-5b3e-46a9-a557-945b9ae177f0 installs=0.19.718 00d99344506bcf00e1aec7e910abe3d13df2d240 -->
    Loom-Trace-Id: d74a33a6f35e329b3e795991e790ebfd
    Loom-Build: unknown e7efbaa6e7b97a7d72da6032044c67525291f4d1 clean
    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
2026-10-05 chore: resync installed Loom surfaces
    <!-- loom:provenance v1 build=unknown 347b71e65e709d9fd49aba75d3fb67877fc08818 clean prompts=none sweep=none story=none trace=f9653dd318724c98136e7cef63e551ed host=robb-pro base=9dd8de2e1b72b07006162f6da67419aa5be1759d run=loom-run/v1:timer:robb-pro/fleet-resync:cdc95970-9fb1-49fa-a0e6-037a3fab2099 installs=0.19.728 991dcebf6f6b2de6571f1d3400bec083498c6438 -->
    Loom-Trace-Id: f9653dd318724c98136e7cef63e551ed
    Loom-Build: unknown 347b71e65e709d9fd49aba75d3fb67877fc08818 clean
    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
2026-10-05 chore: resync installed Loom surfaces
    <!-- loom:provenance v1 build=unknown 5c0d18101f48fecb656f10fa37afa9b09bf41631 clean prompts=none sweep=none story=none trace=ddcf49552af364cbf6e884bd59584c1f host=loom-worker-1 base=8a1047f7bb371036ca059ffca9cd8369f9a7345d run=loom-run/v1:timer:loom-worker-1/fleet-resync:5eb526a05f244f1985770579e7620ff1 installs=0.19.731 7484b71fce5179a025950e71a82855afaf6fd730 -->
    Loom-Trace-Id: ddcf49552af364cbf6e884bd59584c1f
    Loom-Build: unknown 5c0d18101f48fecb656f10fa37afa9b09bf41631 clean
    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
2026-10-05 chore: resync installed Loom surfaces
    <!-- loom:provenance v1 build=unknown 0b160514b6658e3ab26a71c6525791da25b46fcf clean prompts=none sweep=none story=none trace=311c3eb2c0ab9550d3de38df5523f3d7 host=robb-studio base=109db558607653d12b885bf11eabf163fb985f92 run=loom-run/v1:timer:robb-studio/fleet-resync:e6dec631-b42b-4cf2-b854-cc363cfde6e0 installs=0.19.731 d6146becf339a3d4e55e26e8807ac4571213a00b -->
    Loom-Trace-Id: 311c3eb2c0ab9550d3de38df5523f3d7
    Loom-Build: unknown 0b160514b6658e3ab26a71c6525791da25b46fcf clean
    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
2026-10-05 chore: resync installed Loom surfaces
    <!-- loom:provenance v1 build=unknown 5c0d18101f48fecb656f10fa37afa9b09bf41631 clean prompts=none sweep=none story=none trace=f1e8d4c6e73b8eec3e87a8da52e10f2d host=robb-pro base=757975ec5edbcd5b47472a097e4d719394a93d2c run=loom-run/v1:timer:robb-pro/fleet-resync:5518fd33-81cb-479f-93f0-287ea4b08876 installs=0.19.733 4e67131ce3a1317d8cb8904ec342541cc2f45665 -->
    Loom-Trace-Id: f1e8d4c6e73b8eec3e87a8da52e10f2d
    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
2026-10-05 chore: resync installed Loom surfaces
    <!-- loom:provenance v1 build=unknown ca170d11544ef499cc9500a45bbad152edacfbd1 clean prompts=none sweep=none story=none trace=6dcfc713b6a851b40932158c2eeb70af host=loom-worker-3 base=5866d63eecdf6892709d4fb21855f7985d271a2b run=loom-run/v1:timer:loom-worker-3/fleet-resync:20ce0908ea5a468a9e055470104047ed installs=0.19.734 7ba6ea50c36dfdd2b5e2922dd22c65560980a5a2 -->
    Loom-Trace-Id: 6dcfc713b6a851b40932158c2eeb70af
    Loom-Build: unknown ca170d11544ef499cc9500a45bbad152edacfbd1 clean
    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
2026-10-05 chore: resync installed Loom surfaces
    <!-- loom:provenance v1 build=unknown 03f1c42302d15f8a83425a84a4e36ca484f3f625 clean prompts=none sweep=none story=none trace=f1bc879f8aa652d550764ffcd36e27d1 host=loom-worker-1 base=cafff970a3031ad36856c655a4f2dcb08ffa8c70 run=loom-run/v1:timer:loom-worker-1/fleet-resync:f302a3cc8558413492093df510b02418 installs=0.19.734 967abe71d019ce6606018b4e57dee0223b84d96f -->
    Loom-Trace-Id: f1bc879f8aa652d550764ffcd36e27d1
    Loom-Build: unknown 03f1c42302d15f8a83425a84a4e36ca484f3f625 clean
    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
2026-10-05 chore: resync installed Loom surfaces
    <!-- loom:provenance v1 build=unknown ce7557ba58624d48fedbca2bc037dfa8ce3943e7 clean prompts=none sweep=none story=none trace=e1f2558834c47835cd9a53ec8c9a2ffa host=loom-worker-3 base=0fc7986cef3c8f48532b73d4a24fb98370cc5cc5 run=loom-run/v1:timer:loom-worker-3/fleet-resync:50f5f0046e2c4890961b3221bd360247 installs=0.19.734 ba9edb650872e5265eaca0c47f75e3cb828ecad2 -->
    Loom-Trace-Id: e1f2558834c47835cd9a53ec8c9a2ffa
    Loom-Build: unknown ce7557ba58624d48fedbca2bc037dfa8ce3943e7 clean
    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
2026-10-05 chore: resync installed Loom surfaces
    <!-- loom:provenance v1 build=unknown f92eaec38470a7b0732e065f4864faec9a1905d6 clean prompts=none sweep=none story=none trace=07aa020a8179d52651250562e9808b98 host=robb-studio base=42ed145590a7a8b3582e54bfc235818ddc1702cb run=loom-run/v1:timer:robb-studio/fleet-resync:3b3ebdf2-b5f7-48ed-b7bb-5fb945094061 installs=0.19.734 78f3e99c44d0af6d4598adf7577bb6676baf3e8f -->
    Loom-Trace-Id: 07aa020a8179d52651250562e9808b98
    Loom-Build: unknown f92eaec38470a7b0732e065f4864faec9a1905d6 clean
    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
2026-10-06 chore: resync installed Loom surfaces
    <!-- loom:provenance v1 build=unknown ca170d11544ef499cc9500a45bbad152edacfbd1 clean prompts=none sweep=none story=none trace=fca9c14d74d6d634726f5823c51bc62a host=loom-worker-2 base=f71393222851ff5514a276f49748776918e4ce0c run=loom-run/v1:timer:loom-worker-2/fleet-resync:23a23f0878c1494cb720941baddfea81 installs=0.19.741 3cede3920c6b567d5400789187a904970d46b0fb -->
    Loom-Trace-Id: fca9c14d74d6d634726f5823c51bc62a
    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
2026-10-06 chore: resync installed Loom surfaces
    <!-- loom:provenance v1 build=unknown e38a22941348fd8e83d1f4b06130d2a214adfb50 clean prompts=none sweep=none story=none trace=a7fe3a9a1fedfce89846c20f2e98ac31 host=robb-pro base=e63a34fe115b55fa7b28da025553ddbbd628a127 run=loom-run/v1:timer:robb-pro/fleet-resync:2d770a42-f0e7-4695-abfa-b912e75382e6 installs=0.19.744 8bc5bcce93c4d9721817387afe8b4b6d79f26054 -->
    Loom-Trace-Id: a7fe3a9a1fedfce89846c20f2e98ac31
    Loom-Build: unknown e38a22941348fd8e83d1f4b06130d2a214adfb50 clean
    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
2026-10-06 chore: resync installed Loom surfaces
    <!-- loom:provenance v1 build=unknown f66ea90ff1bdec51aa4c8dc3f4b2e8d26e3dfd2d clean prompts=none sweep=none story=none trace=66d96c3bb00b04fae967865ee02fc4de host=loom-worker-3 base=2a7cbcc56b8d35b5effb2ed9ce3c6d40b066f41b run=loom-run/v1:timer:loom-worker-3/fleet-resync:eb2dceb410e848a19d58f96f678c995e installs=0.19.749 6135634b053dc30ef5aa8e6d733bfe79bb2ac734 -->
    Loom-Trace-Id: 66d96c3bb00b04fae967865ee02fc4de
    Loom-Build: unknown f66ea90ff1bdec51aa4c8dc3f4b2e8d26e3dfd2d clean
    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
2026-10-06 chore: resync installed Loom surfaces
    <!-- loom:provenance v1 build=unknown ade8a2c60cc8370d04d72f331141acb6fb32e121 clean prompts=none sweep=none story=none trace=6245fb88b5bdf9f7ccecb6b2168dc335 host=robb-studio base=0869c00bb8f4e296569f877180131414ab6f5206 run=loom-run/v1:timer:robb-studio/fleet-resync:b305aed2-1a25-4576-aca7-9b017ac4377e installs=0.19.755 8d97d322e1cb3723988504337089beca73d0511c -->
    Loom-Trace-Id: 6245fb88b5bdf9f7ccecb6b2168dc335
    Loom-Build: unknown ade8a2c60cc8370d04d72f331141acb6fb32e121 clean
    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
2026-10-06 chore: resync installed Loom surfaces
    <!-- loom:provenance v1 build=unknown 2489bb7d5203844b3fbe8efbe007f44aa074685d clean prompts=none sweep=none story=none trace=0b5c9263a55c09e6fbd870b2d9ff5d9b host=loom-worker-2 base=4076f3e8c7620b642e51e911b03589c506f9256c run=loom-run/v1:timer:loom-worker-2/fleet-resync:d3f5a5beb1144f72ac8be575767b3e03 installs=0.19.760 3a509582b179d91c2d5b5a65a7ba4650c3c08985 -->
    Loom-Trace-Id: 0b5c9263a55c09e6fbd870b2d9ff5d9b
    Loom-Build: unknown 2489bb7d5203844b3fbe8efbe007f44aa074685d clean
    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
2026-10-06 chore: resync installed Loom surfaces
    <!-- loom:provenance v1 build=unknown 986d16b700174622774ff68af4ef323e8d0e23ba clean prompts=none sweep=none story=none trace=cb518f1f5785c258556383940a46c461 host=loom-worker-1 base=3b631668d18e7c5550912150cc21a16cdebc0da6 run=loom-run/v1:timer:loom-worker-1/fleet-resync:97df92c5eca846de85e979810663a94b installs=0.19.765 c6cec65c4f320f11153c72e840e49a5d6a6f1afc -->
    Loom-Trace-Id: cb518f1f5785c258556383940a46c461
    Loom-Build: unknown 986d16b700174622774ff68af4ef323e8d0e23ba clean
    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
2026-10-06 chore: resync installed Loom surfaces
    <!-- loom:provenance v1 build=unknown 85e52221261264d7f7643251de706f00c8db289f clean prompts=none sweep=none story=none trace=a2434124d73d8cca0ca77230fc85adf5 host=robb-pro base=176452e93da512c7a321a3756036c4c95b140152 run=loom-run/v1:timer:robb-pro/fleet-resync:abffb067-59ed-4a6e-94b6-8cf3500c935c installs=0.19.768 c9f7ca975144d991bce40f492403b8292e8b7fae -->
    Loom-Trace-Id: a2434124d73d8cca0ca77230fc85adf5
    Loom-Build: unknown 85e52221261264d7f7643251de706f00c8db289f clean
    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
2026-10-06 chore: resync installed Loom surfaces
    <!-- loom:provenance v1 build=unknown 31b34ebfd7d4539094523eaa7b56a104bebe5fc0 clean prompts=none sweep=none story=none trace=16fac36f144dc183c71465eb36c89afc host=loom-worker-3 base=c70bf4d2073a15d99df50070e57d212d8633b63b run=loom-run/v1:timer:loom-worker-3/fleet-resync:c763e24590314b918c8ee8df5d2de1db installs=0.19.769 af995a5725fdadf708127f006aa8f248b482d7d7 -->
    Loom-Trace-Id: 16fac36f144dc183c71465eb36c89afc
    Loom-Build: unknown 31b34ebfd7d4539094523eaa7b56a104bebe5fc0 clean
    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
2026-10-06 chore: resync installed Loom surfaces
    <!-- loom:provenance v1 build=unknown 7bed309263b3785eae46a9cbc53b3b24a52b10d2 clean prompts=none sweep=none story=none trace=843adbd5eac450c43d3a2c43da1bf729 host=robb-studio base=55d2eaab2528ffcca4ef1f53334de12718cc139f run=loom-run/v1:timer:robb-studio/fleet-resync:f83d5ba4-81f7-479a-9768-6af33d4cc825 installs=0.19.783 a9b459e0c2b1916ceb116db33053e7eb0df57e7b -->
    Loom-Trace-Id: 843adbd5eac450c43d3a2c43da1bf729
    Loom-Build: unknown 7bed309263b3785eae46a9cbc53b3b24a52b10d2 clean
    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
2026-10-06 chore: resync installed Loom surfaces
    <!-- loom:provenance v1 build=unknown 07bc40ba9ab0f7dfe7cd0990377b7ac07a52d220 clean prompts=none sweep=none story=none trace=563f186108419cf03cef002a62c3b201 host=loom-worker-2 base=a49aaf64683ebc75fddcb326423285a6f5382cf4 run=loom-run/v1:timer:loom-worker-2/fleet-resync:944beccd157a4197b81feafdd19f443e installs=0.19.785 2f0a9dbb4f06053f747b8a5615a3519f8e30b527 -->
    Loom-Trace-Id: 563f186108419cf03cef002a62c3b201
    Loom-Build: unknown 07bc40ba9ab0f7dfe7cd0990377b7ac07a52d220 clean
    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
2026-10-06 chore: resync installed Loom surfaces
    <!-- loom:provenance v1 build=unknown 31b34ebfd7d4539094523eaa7b56a104bebe5fc0 clean prompts=none sweep=none story=none trace=ea6600df41a4b420b6d8e967f839ccfd host=loom-worker-3 base=64ca1da3679f0f4e3f7c2f0f12aa21a6c79aff04 run=loom-run/v1:timer:loom-worker-3/fleet-resync:c80415b48fd5404bbd599c4f6cc8a448 installs=0.19.793 7ceff96944c39d33e3c2f1141ca650c2c4c05679 -->
    Loom-Trace-Id: ea6600df41a4b420b6d8e967f839ccfd
    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
2026-10-06 chore: resync installed Loom surfaces
    <!-- loom:provenance v1 build=unknown 596a53e525683919daae1b43e6babe9bf847a02f clean prompts=none sweep=none story=none trace=b9c0cb42a5a72ecc21726229c957ef1f host=loom-worker-2 base=3911821c40b72673783e54e25719c7040258b7a2 run=loom-run/v1:timer:loom-worker-2/fleet-resync:21d578f5cc0b4b7ba5f10759f5f30ae8 installs=0.19.801 524bdb33cb26c8355454d7550413c89e72c06fae -->
    Loom-Trace-Id: b9c0cb42a5a72ecc21726229c957ef1f
    Loom-Build: unknown 596a53e525683919daae1b43e6babe9bf847a02f clean
    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
2026-10-06 chore: resync installed Loom surfaces
    <!-- loom:provenance v1 build=unknown 40b591a33adb895d4f46977105f9b264d8a2599b clean prompts=none sweep=none story=none trace=e41c725fe0c176312eb412bc69fe5b01 host=robb-studio base=08517027f883badb6b637d0ef29ecdd8187d9e76 run=loom-run/v1:timer:robb-studio/fleet-resync:37d704dd-4dfd-4341-adb4-6551637ad147 installs=0.19.802 72ce1f7385747dd773d1644408ec22072b8a5d20 -->
    Loom-Trace-Id: e41c725fe0c176312eb412bc69fe5b01
    Loom-Build: unknown 40b591a33adb895d4f46977105f9b264d8a2599b clean
    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
2026-10-06 chore: resync installed Loom surfaces
    <!-- loom:provenance v1 build=unknown 31b34ebfd7d4539094523eaa7b56a104bebe5fc0 clean prompts=none sweep=none story=none trace=5ad0480c4b21b80f9c852c448319e7a1 host=loom-worker-3 base=b7ca7adecff334d35f5b044116f46e9cd8784f26 run=loom-run/v1:timer:loom-worker-3/fleet-resync:48e836f11f9547ddb96de5aa0d072a05 installs=0.19.810 933f828e779602e492e4e157812988a4b8128111 -->
    Loom-Trace-Id: 5ad0480c4b21b80f9c852c448319e7a1
    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
2026-10-07 ci: run on GitHub-hosted runners; the shared self-hosted runner is retired
    This repo routed same-repo events to the fleet's self-hosted "heavy"
    runner because it was private, and GitHub-hosted minutes for private
    repos in this org were billing-blocked. The repo is public now, so hosted
    minutes are free, and the operator's direction (2026-10-06) is public
    repos on GitHub-hosted, private repos on the ci-spot fleet, with the
    always-on runner retired (2AMLogic/2am#3182).
    Every job already ran on ubuntu-latest for fork PRs, so each job's
    hosted path is the one fork PRs exercised; nothing in the steps changes.
    Loom-Story: 2AMLogic/2am#3182
    Loom-Trace-Id: dcbf8377552e47b4b60c27d163f69364
    Loom-Bui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
2026-10-07 chore: resync installed Loom surfaces
    <!-- loom:provenance v1 build=unknown f71cf25de9e75bae6060da4a599df8fbabe75890 clean prompts=none sweep=none story=none trace=64943e35511da4833bbd385cf288be8a host=loom-worker-2 base=9f0f6566b66ed02710dc86eb62814de54370271d run=loom-run/v1:timer:loom-worker-2/fleet-resync:d69eb1b87d4849ae810a145b1b667d2f installs=0.19.822 1c6969ea8726c800a353c236d9f23456a5706f1a -->
    Loom-Trace-Id: 64943e35511da4833bbd385cf288be8a
    Loom-Build: unknown f71cf25de9e75bae6060da4a599df8fbabe75890 clean
    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
2026-10-07 chore: resync installed Loom surfaces
    <!-- loom:provenance v1 build=unknown 31b34ebfd7d4539094523eaa7b56a104bebe5fc0 clean prompts=none sweep=none story=none trace=cb192cb8f72cf6f2711f73f7ee12bebc host=loom-worker-3 base=a6840256ba9a087610bdf6df787a97974c75ace7 run=loom-run/v1:timer:loom-worker-3/fleet-resync:c1e385c3607e43ad8bed9c7d29811c66 installs=0.19.830 a966f7b89b714704fa1225b96e2dbee50480a4c6 -->
    Loom-Trace-Id: cb192cb8f72cf6f2711f73f7ee12bebc
    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
2026-10-07 chore: resync installed Loom surfaces
    <!-- loom:provenance v1 build=unknown 8abdd34fddc879aff407380278baa713eca6b758 clean prompts=none sweep=none story=none trace=ea945665dad5ccb3880de51c4448e8b9 host=robb-pro base=12787d2412e2fd843d570f48798c2edb209e94aa run=loom-run/v1:timer:robb-pro/fleet-resync:1466e397-b80c-46ea-a42c-26a7fbd4e00e installs=0.19.831 61814c9c1912925cdff7418842ff3ea17cd56fe4 -->
    Loom-Trace-Id: ea945665dad5ccb3880de51c4448e8b9
    Loom-Build: unknown 8abdd34fddc879aff407380278baa713eca6b758 clean
    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
2026-10-07 chore: resync installed Loom surfaces
    <!-- loom:provenance v1 build=unknown 628be5bb140bcff803d159201bd61e1b868901b0 clean prompts=none sweep=none story=none trace=093df1dc315c5e78dcccfca9d699d5f5 host=loom-worker-2 base=98dba34776fc05acf9fbe31a65df2751b94618de run=loom-run/v1:timer:loom-worker-2/fleet-resync:0b0ea5e184c0429a9c431fcca6c791ad installs=0.19.832 1a0fc15974bf0575a9155fb8276f7529fc813542 -->
    Loom-Trace-Id: 093df1dc315c5e78dcccfca9d699d5f5
    Loom-Build: unknown 628be5bb140bcff803d159201bd61e1b868901b0 clean
    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
2026-10-07 chore: resync installed Loom surfaces
    <!-- loom:provenance v1 build=unknown 069e3b45d86c08f0d60c8fc2b0096de441e99bdc clean prompts=none sweep=none story=none trace=b1ba9d6b2b581e47827d9c099f717b04 host=loom-worker-1 base=8297ba47ffa72a0b56d68b78302dbca10801ef20 run=loom-run/v1:timer:loom-worker-1/fleet-resync:aada8278bd4843bcaecce69fdf91251e installs=0.19.838 e70aa17f8dead31bda49cf044c3fc28119df6e90 -->
    Loom-Trace-Id: b1ba9d6b2b581e47827d9c099f717b04
    Loom-Build: unknown 069e3b45d86c08f0d60c8fc2b0096de441e99bdc clean
    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
2026-10-07 chore: resync installed Loom surfaces
    <!-- loom:provenance v1 build=unknown 31b34ebfd7d4539094523eaa7b56a104bebe5fc0 clean prompts=none sweep=none story=none trace=ef030e94bce76f728497f5927960865f host=loom-worker-3 base=dde4672c97554d62485774db7dffdeb48f33193b run=loom-run/v1:timer:loom-worker-3/fleet-resync:28ba4284bfa446c888b501714eda0509 installs=0.19.840 59b533a2a1ed5e186fbf8446b5acbe42d7231854 -->
    Loom-Trace-Id: ef030e94bce76f728497f5927960865f
    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
2026-10-07 chore: resync installed Loom surfaces
    <!-- loom:provenance v1 build=unknown bc59c70c3412a87b31a0dbe65cd6abf968744328 clean prompts=none sweep=none story=none trace=766033e4e881801f24971d664c490ea3 host=robb-studio base=ff2200e21306e67480c188d7e6c071a4172577a8 run=loom-run/v1:timer:robb-studio/fleet-resync:6b3b079a-890e-4a79-9c3a-0b4bb33ff7c4 installs=0.19.840 59b533a2a1ed5e186fbf8446b5acbe42d7231854 -->
    Loom-Trace-Id: 766033e4e881801f24971d664c490ea3
    Loom-Build: unknown bc59c70c3412a87b31a0dbe65cd6abf968744328 clean
    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
2026-10-07 chore: resync installed Loom surfaces
    <!-- loom:provenance v1 build=unknown a068938e7a6c13759bcb3943e408273a3d352257 clean prompts=none sweep=none story=none trace=76bec863c8f6aff2d49b3aa2be128619 host=robb-pro base=9a66fea2c60d839ef2bc65bd93f97f93a0de80d4 run=loom-run/v1:timer:robb-pro/fleet-resync:d9927fc6-ee80-4b6a-ba2b-f13576bd5f9b installs=0.19.846 837b14d7440b89ae8a2cec6d045483ac33659af5 -->
    Loom-Trace-Id: 76bec863c8f6aff2d49b3aa2be128619
    Loom-Build: unknown a068938e7a6c13759bcb3943e408273a3d352257 clean
    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
2026-10-07 chore: resync installed Loom surfaces
    <!-- loom:provenance v1 build=unknown 628be5bb140bcff803d159201bd61e1b868901b0 clean prompts=none sweep=none story=none trace=5a6f676b4652a1a750bbce1386c68d06 host=loom-worker-2 base=04a12d59eba40458459f863d4b917399d49ea7bf run=loom-run/v1:timer:loom-worker-2/fleet-resync:bd416e653be04ef4b13353430625e379 installs=0.19.850 3bb4bfc90603b6ad65cabca9b3eb42a59f1a9d3a -->
    Loom-Trace-Id: 5a6f676b4652a1a750bbce1386c68d06
    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
2026-10-07 chore: resync installed Loom surfaces
    <!-- loom:provenance v1 build=unknown 40215645df8a13508180b248b44244dc488bb078 clean prompts=none sweep=none story=none trace=29fde30615e6e47f39b41aa314c2c883 host=loom-worker-1 base=8d0431d0372f896cdb2eddaf3eb2384a390581f9 run=loom-run/v1:timer:loom-worker-1/fleet-resync:d1fbedfcc7824ae59233c0ea94dc4650 installs=0.19.853 2889d5ed585b4da0935543cb916381cc03b19746 -->
    Loom-Trace-Id: 29fde30615e6e47f39b41aa314c2c883
    Loom-Build: unknown 40215645df8a13508180b248b44244dc488bb078 clean
    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
2026-10-07 chore: resync installed Loom surfaces
    <!-- loom:provenance v1 build=unknown 31b34ebfd7d4539094523eaa7b56a104bebe5fc0 clean prompts=none sweep=none story=none trace=cdf49c615da3f5ce46e9fcda1a24f787 host=loom-worker-3 base=172a4923e84b9308aa120b6007102bb11021585e run=loom-run/v1:timer:loom-worker-3/fleet-resync:cab31e05b8a24df09bc88f53ee3fb501 installs=0.19.857 7a0b529e6f57a79713f6924bf58d8392ff404259 -->
    Loom-Trace-Id: cdf49c615da3f5ce46e9fcda1a24f787
    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
2026-10-07 chore: resync installed Loom surfaces
    <!-- loom:provenance v1 build=unknown 4b44e7c5db0de1d2b5927de7de229120d546aad3 clean prompts=none sweep=none story=none trace=dfa656ee3483a044378501f49d36f812 host=robb-studio base=5f9f93ac4751994a8bb6c0f1e0b6bb9e04467a30 run=loom-run/v1:timer:robb-studio/fleet-resync:d80d6bc0-eb68-4a07-8226-2d947d328b3a installs=0.19.859 0aefebd79aba8ab33470f1af4b96847fc794bd0d -->
    Loom-Trace-Id: dfa656ee3483a044378501f49d36f812
    Loom-Build: unknown 4b44e7c5db0de1d2b5927de7de229120d546aad3 clean
    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
2026-10-07 chore: resync installed Loom surfaces
    <!-- loom:provenance v1 build=unknown b591c8cf436f0d4aa5870a9bc7cd5f7194e0e778 dirty prompts=none sweep=none story=none trace=6eca4b0c47205457aae7a3d721c17f17 host=robb-pro base=e3db89a1709baf444bccd4db9091c98f5b93bab9 run=loom-run/v1:timer:robb-pro/fleet-resync:64af20b3-58cb-47f2-b770-117197cb41e9 installs=0.19.864 128a7eba2bb5f7bcf8891ba284b14cb7ebf8dd3d -->
    Loom-Trace-Id: 6eca4b0c47205457aae7a3d721c17f17
    Loom-Build: unknown b591c8cf436f0d4aa5870a9bc7cd5f7194e0e778 dirty
    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
2026-10-07 chore: resync installed Loom surfaces
    <!-- loom:provenance v1 build=unknown b551219fd5b8347113c0cbc79ea416e81c39fa9d clean prompts=none sweep=none story=none trace=5ac7c8c62dad54841e21dd94f0920de3 host=loom-worker-2 base=6e49cc17dd6c33e63bff06b9de0fcef33d18c42a run=loom-run/v1:timer:loom-worker-2/fleet-resync:d10fb10789e94930ab1af368c15a8f8b installs=0.19.864 128a7eba2bb5f7bcf8891ba284b14cb7ebf8dd3d -->
    Loom-Trace-Id: 5ac7c8c62dad54841e21dd94f0920de3
    Loom-Build: unknown b551219fd5b8347113c0cbc79ea416e81c39fa9d clean
    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
2026-10-07 chore: resync installed Loom surfaces
    <!-- loom:provenance v1 build=unknown 90fbd167e4e376894396e651676cf58fc9aa223a clean prompts=none sweep=none story=none trace=196876656e912171b28029ceca9f772d host=loom-worker-1 base=239333d25dfe29bde5d122f04a5168839daac185 run=loom-run/v1:timer:loom-worker-1/fleet-resync:7b46720ff3a84a8184f2f2b3bc039260 installs=0.19.868 ee904e1c151bc9cf15b0eb55dfe9d57ad6136cff -->
    Loom-Trace-Id: 196876656e912171b28029ceca9f772d
    Loom-Build: unknown 90fbd167e4e376894396e651676cf58fc9aa223a clean
    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
2026-10-08 chore: resync installed Loom surfaces
    <!-- loom:provenance v1 build=unknown 5a3df331a0612dee585ef905015af01d08e3467f clean prompts=none sweep=none story=none trace=5690fa95febe608e500a46dde8a6ee92 host=loom-worker-2 base=fd479240b40258eec2fb67a83e1a0dd2c7f61d3c run=loom-run/v1:timer:loom-worker-2/fleet-resync:5c9c35d59b704bff9d8bf096ee7ba7be installs=0.19.876 b16d54e63fbbec4d7f15f13c1f43a5e5b38145ce -->
    Loom-Trace-Id: 5690fa95febe608e500a46dde8a6ee92
    Loom-Build: unknown 5a3df331a0612dee585ef905015af01d08e3467f clean
    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
2026-10-08 chore: resync installed Loom surfaces
    <!-- loom:provenance v1 build=unknown 134eb3ff06c1a86f49a911c6c17464f55e719736 clean prompts=none sweep=none story=none trace=c7df110d490314040dcd1347b2481843 host=loom-worker-1 base=dcb72d184f3ff551a35c609c585ba082c14fb2ff run=loom-run/v1:timer:loom-worker-1/fleet-resync:53d0cec2cd61484eb9a0f8fb1f24ac5e installs=0.19.879 c15619905bdd8a24506c3853f45490d26e8f1cad -->
    Loom-Trace-Id: c7df110d490314040dcd1347b2481843
    Loom-Build: unknown 134eb3ff06c1a86f49a911c6c17464f55e719736 clean
    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
2026-10-08 chore: resync installed Loom surfaces
    <!-- loom:provenance v1 build=unknown 8f86de23319d8f6cf049557dcc9cf2e321211d9d clean prompts=none sweep=none story=none trace=17de45f778fbfd714af8afad02c96375 host=loom-worker-3 base=c3cb4b202203e86079700f0844b843ea2d34420c run=loom-run/v1:timer:loom-worker-3/fleet-resync:9e3e5d4a08824de3b7bc02940be2a0da installs=0.19.882 c9f85af3d967986cdd7a3f27e088a16f88712b05 -->
    Loom-Trace-Id: 17de45f778fbfd714af8afad02c96375
    Loom-Build: unknown 8f86de23319d8f6cf049557dcc9cf2e321211d9d clean
    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
2026-10-08 chore: resync installed Loom surfaces
    <!-- loom:provenance v1 build=unknown 4a5fb2b6276e17ff26ee1382acfe2ea7360ebea5 clean prompts=none sweep=none story=none trace=67857e1b7189785825a2dfc70921cf85 host=loom-worker-2 base=afbd39f1f3944f982c0961c3b03107767e1a06ea run=loom-run/v1:timer:loom-worker-2/fleet-resync:dd6a5f3dceff4d8d8602a07a1dc89c95 installs=0.19.892 ce93e8a919d79a6f027bab268846a52084f9d94e -->
    Loom-Trace-Id: 67857e1b7189785825a2dfc70921cf85
    Loom-Build: unknown 4a5fb2b6276e17ff26ee1382acfe2ea7360ebea5 clean
    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
2026-10-08 chore: resync installed Loom surfaces
    <!-- loom:provenance v1 build=unknown b591c8cf436f0d4aa5870a9bc7cd5f7194e0e778 dirty prompts=none sweep=none story=none trace=28e7ca5fdb768489aa38bf002407d5a5 host=robb-pro base=fea187299ae19d22b4d1ef40ec9be98e042d21dd run=loom-run/v1:timer:robb-pro/fleet-resync:eb5f838e-a774-4e20-8102-c37ee3ff31ca installs=0.19.895 9b30d293bcba1e79d49cabfc1c5bb5b6f4c0dc77 -->
    Loom-Trace-Id: 28e7ca5fdb768489aa38bf002407d5a5
    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
2026-10-08 chore: resync installed Loom surfaces
    <!-- loom:provenance v1 build=unknown 5684fc8c8ac418d95ad66a002d001eaea1283c9a clean prompts=none sweep=none story=none trace=c864acd3b9a5dbb419fddd8bd2a6283b host=loom-worker-3 base=f43ca88924db198a98abecd02ebfc0997c92fa4b run=loom-run/v1:timer:loom-worker-3/fleet-resync:4771e7c630c34445b7f28539669d76e3 installs=0.19.898 3d55b9a1669c132d130d98f10a292c1325322c30 -->
    Loom-Trace-Id: c864acd3b9a5dbb419fddd8bd2a6283b
    Loom-Build: unknown 5684fc8c8ac418d95ad66a002d001eaea1283c9a clean
    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
2026-10-08 docs(sim/enable-shutdown): record max-only shutdown-current bounds as deliberate (#145)
    Loom-Story: 2AMLogic/sky130-ldo#145
    Loom-Trace-Id: d49cb6be89b1aad0b7317d34c7a3707a
    Loom-Build: 0.19.898 3d55b9a1669c132d130d98f10a292c1325322c30 clean
2026-10-08 Standalone regenerative thermal comparator with tt/3.30V hysteresis demonstration (#229)
    Loom-Story: 2AMLogic/sky130-ldo#229
    Loom-Trace-Id: 1d228991ddc3bdd915d3a1966e149544
    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
    [001_hot_130C_vx-0.25.csv, 002_hot_140C_vx-0.25.csv, 003_hot_150C_vx-0.25.csv, 004_hot_160C_vx-0.25.csv, 005_hot_170C_vx-0.25.csv, 006_hot_180C_vx-0.25.csv, 007_hot_190C_vx-0.25.csv, 008_cold_exc_130C_vx+0.25.csv]
2026-10-08 chore: resync installed Loom surfaces
    <!-- loom:provenance v1 build=unknown 04a1189116c7320def7d9ce357d2d9268405ae92 clean prompts=none sweep=none story=none trace=8e55b27fc60ffb045554bd413ad8f3c8 host=robb-pro base=972fd01cf5670600ed0ee14495a3df5cdfb937a9 run=loom-run/v1:timer:robb-pro/fleet-resync:83b69005-7c5b-44b3-96f8-33f07bf82f4b installs=0.19.917 d3c1ea3a4c81e01ce5487dc3e4bbdd86534e677e -->
    Loom-Trace-Id: 8e55b27fc60ffb045554bd413ad8f3c8
    Loom-Build: unknown 04a1189116c7320def7d9ce357d2d9268405ae92 clean
    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
2026-10-08 Extend simulation freshness to experiment and solver inputs (#237)
    New PVT/MC records carry a versioned input_fingerprint (allow-list of
    execution-relevant manifest keys; PVT adds the sim/spiceinit hash, MC makes no
    solver claim). The characterization report adds a headless Inputs column and
    clause, compared even under --ignore-sim-freshness; legacy records read
    unverified. Report and signoff pins regenerated; no records modified or re-run.
    Loom-Story: 2AMLogic/sky130-ldo#237
    Loom-Trace-Id: aba0ec24bbac7fa9b4b9f6c24e52305f
    Loom-Build: 0.19.868 ee904e1c151bc9cf15b0eb55dfe9d57ad6136cff clean
2026-10-08 Measure routed core area against the ratified 0.1 mm² limit (#236)
    Stdlib GDS bounding-rectangle measurement (hierarchy, dbu, path widths,
    strict threshold), a new content-pinned area record (FAIL, 0.4468 mm²),
    Area row wired to the record verdict with GDS-sha256 freshness, and
    re-pinned characterization/signoff artifacts.
    Loom-Story: 2AMLogic/sky130-ldo#236
    Loom-Trace-Id: 94e1b862c7df88f1a8a3c0b143deee05
    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
2026-10-08 Integrate regenerative thermal comparator into the LDO; transient-staircase thermal bench and runner (#230)
    Loom-Story: 2AMLogic/sky130-ldo#230
    Loom-Trace-Id: c13da88ea08348731b046f49d1fec2c8
    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
    [ldo_3v3in_1v8out.sch, tb_thermal_trip.sch]
2026-10-08 thermal runner: drop the dc-sweep nodeset seed for the uic cold start (#230)
    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
2026-10-08 Record integrated tt/3.30V thermal hysteresis (13.1 C), docs, stale-artifact inventory, regenerated characterization (#230)
    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
    [001_hot_130C_ix+0.5uA.csv, 002_hot_140C_ix+0.5uA.csv, 003_hot_150C_ix+0.5uA.csv, 004_hot_160C_ix+0.5uA.csv, 005_hot_170C_ix+0.5uA.csv, 006_hot_180C_ix+0.5uA.csv, 007_hot_190C_ix+0.5uA.csv, 008_cold_exc_130C_ix-0.5uA.csv]
2026-10-08 chore: resync installed Loom surfaces
    <!-- loom:provenance v1 build=unknown d2a55ce217b3ad1793611a2c54946676bb55b512 clean prompts=none sweep=none story=none trace=459637e4e8503593bdf58360865a7524 host=robb-pro base=9110981deade5abe88816e1ffd2a73702bbc697a run=loom-run/v1:timer:robb-pro/fleet-resync:95b3cf92-9cd9-4c36-8bbd-bdcace7c3874 installs=0.19.935 d347079cd0bad2db2c11ee4f0b760f04b2601d21 -->
    Loom-Trace-Id: 459637e4e8503593bdf58360865a7524
    Loom-Build: unknown d2a55ce217b3ad1793611a2c54946676bb55b512 clean
    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
2026-10-09 chore: resync installed Loom surfaces
    <!-- loom:provenance v1 build=unknown 05dba463c5b293d38f0ca071725983862498b3f3 clean prompts=none sweep=none story=none trace=14298316053024bcf5120bff695771ab host=robb-pro base=7907775db9716676511eca1d53055b17b17ba200 run=loom-run/v1:timer:robb-pro/fleet-resync:2f384483-6d77-4ba2-9888-aa1e4b5be36c installs=0.19.953 b93d7a955d63411cb4c94b986fd5138d27dedb0f -->
    Loom-Trace-Id: 14298316053024bcf5120bff695771ab
    Loom-Build: unknown 05dba463c5b293d38f0ca071725983862498b3f3 clean
    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
2026-10-09 chore: resync installed Loom surfaces
    <!-- loom:provenance v1 build=unknown 7f06b288b150f2fe0a4b24c331a9b3ec093d709d clean prompts=none sweep=none story=none trace=a90c217ff3a3bd9e3a30282b8cadc24d host=robb-pro base=bc9e89286b81717036634959130b82c98f237939 run=loom-run/v1:timer:robb-pro/fleet-resync:6e5ec9f3-d6ef-4953-80f7-c93035e2d359 installs=0.19.966 9bed656320e53ba6c64305daa60613431a7ed02d -->
    Loom-Trace-Id: a90c217ff3a3bd9e3a30282b8cadc24d
    Loom-Build: unknown 7f06b288b150f2fe0a4b24c331a9b3ec093d709d clean
    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
2026-10-09 chore: resync installed Loom surfaces
    <!-- loom:provenance v1 build=unknown 30c7a7ee2f74a6a2b5bb0f19fd9f049ec8ae8b5c clean prompts=none sweep=none story=none trace=7bc5ba399ff199d049d83d711920a157 host=robb-pro base=8026b1c9df243c57bef4784b6a564a26d60b3d5f run=loom-run/v1:timer:robb-pro/fleet-resync:8e237160-c4d0-4ce3-85ac-c96aff5cf221 installs=0.19.982 2bc4cba624b9053535663441e6f0daf08a7acf2e -->
    Loom-Trace-Id: 7bc5ba399ff199d049d83d711920a157
    Loom-Build: unknown 30c7a7ee2f74a6a2b5bb0f19fd9f049ec8ae8b5c clean
    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
2026-10-09 fix(characterization): propagate schematic staleness through PEX source provenance (#245)
    PEX freshness now requires the LATEST-LVS pointer match AND the cited LVS
    record's schematic provenance to be current; missing/unreadable evidence is
    unverified. Regenerated rollup and dependent signoff pins.
    Loom-Story: 2AMLogic/sky130-ldo#245
    Loom-Trace-Id: 92d8a027439a96f526dedf3b444279fb
    Loom-Build: 0.19.972 113c7f31d7d16f75d30c470023e0b65b29b1fe94 clean
2026-10-09 Area budget and compaction-feasibility study (#246)
    Loom-Story: 2AMLogic/sky130-ldo#246
    Loom-Trace-Id: 1578902b4d69b393f626afcfe71a47dc
    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
2026-10-10 chore: resync installed Loom surfaces
    <!-- loom:provenance v1 build=unknown a7d2b01d8eb7d09e597a4638e5cb3cdd8bab9156 clean prompts=none sweep=none story=none trace=35c1337ee84607e87ba2038523d63198 host=robb-pro base=48f793dc88bd5e19d181982c40fb5f9b680fe69d run=loom-run/v1:timer:robb-pro/fleet-resync:6bf32a81-6c4a-48c5-a51e-1ad65c6bedfd installs=0.19.1000 a6f00d6dedf47eb4cc18f9b59af4746561783f75 -->
    Loom-Trace-Id: 35c1337ee84607e87ba2038523d63198
    Loom-Build: unknown a7d2b01d8eb7d09e597a4638e5cb3cdd8bab9156 clean
    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
2026-10-10 test(layout): unit tests for check-erc-supply-spec.py (#249)
    Loom-Story: 2AMLogic/sky130-ldo#249
    Loom-Trace-Id: 14e210f068794ce92abe8eb631a58ee9
    Loom-Build: 0.19.996 0d2be7e9ae05753e2c9232a83b7399d45de5396e clean
2026-10-10 refactor(layout): share X-card token parsing between LVS and layout generators (#252)
    Loom-Story: 2AMLogic/sky130-ldo#252
    Loom-Trace-Id: 478ea5a825b91c759f455ce19fe7f957
    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
2026-10-10 fix(characterization): reject non-boolean campaign overall_pass verdicts (#255)
    Loom-Story: 2AMLogic/sky130-ldo#255
    Loom-Trace-Id: 73fabb5621b18a27c7702167dada02b2
    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
2026-10-10 layout: folded-resistor qualification flow for resistor-only test blocks (#253)
    Draws each long schematic resistor unsplit, as an N-segment series bank
    (klt gen res_array rows=num plus caller-owned li1 series straps and merged
    implant/marker layers), and as an open-chain negative control; runs klt DRC
    plus the PDK signoff runset, klt extract (default, deferred offset,
    parasitics), klt lvs against the unsplit reference with combine_devices and
    a perturbed-R control, and one single-operating-point ngspice .op of the
    PDK model chain. Equivalence tolerance is fixed up front as 3x the unsplit
    device's local-mismatch sigma from the model library.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
2026-10-10 layout: keep host paths out of folded-res-qual records (#253)
    Run klt gen/drc/extract and the PDK runset from the record directory with
    record-relative paths, and replace the resolved PDK prefix echoed into the
    signoff runset's report/log with a placeholder.
    Loom-Story: 2AMLogic/sky130-ldo#253
    Loom-Trace-Id: 3c0633544239cabc4a6187af40cde64f
    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
2026-10-10 layout: scrub the record path from the PDK runset log too (#253)
    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
2026-10-10 layout: folded-resistor qualification record and findings (#253)
    Mints layout/folded-res-qual/reports/20261010-032804-ea209d2 on the pinned
    klt (040f3406) and PDK (c6d73a35). All three folded banks (R_BIAS x16,
    R_BIAS x4, R_FB_A x2) are klt-DRC clean and LVS-match the unsplit
    reference, with open-chain and perturbed-R negative controls mismatching.
    At tt/27C the PDK model puts the 16-segment R_BIAS bank +1.060% high
    (tolerance 0.246%, NOT EQUIVALENT); the 4-segment R_BIAS and 2-segment
    R_FB_A banks are within tolerance. LVS cannot see the difference because
    the series fold charges the head offset once (filed generically as
    2AMLogic/klayout-tools#3017). Records the PDK-signoff coverage gaps,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
2026-10-10 layout: add unmerged-marker DRC control to folded-res-qual flow (#253)
    Adds a <case>_unmerged stream (folded bank, all straps, per-row markers
    left as res_array draws them) run through the PDK signoff runset as an
    expected-to-fail control; the flow fails if it adds no rule class over
    the merged folded stream. Fixes the analysis docstring's test-file name.
    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
2026-10-10 layout: mint folded-res-qual record 20261010-033502-704005c with unmerged-marker control (#253)
    New append-only record; 20261010-032804-ea209d2 is left untouched and
    LATEST now names the new record. The unmerged control fails as expected
    (rpm.2/rpm.1a on the res_high_po banks, urpm.2 on the res_xhigh_po bank),
    replacing the README's earlier reliance on an unrecorded probe. README:
    P wording in finding 1, and finding 5 labelled as an unrecorded host
    build outside the pin.
    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
2026-10-10 layout: MiM capacitor + supply-rail overlay demonstrator flow (#254)
    Bounded demonstrator, not the core: draws the schematic's four capacitors
    (read from its own xschem netlist) as stacked sky130 MiM arrays
    (cap_mim_m3_1 under cap_mim_m3_2) over the planned core outline, plus the
    two load-current rails re-sized by the unchanged #154 rule on a proposed
    metal assignment that confines met3 rail use to the pass-device column.
    run-cap-rail-demo-flow.sh checks it with the curated klt drc deck, the
    PDK's own sky130A_mr.drc, klt extract (devices + parasitics) and klt lvs
    against a schematic-derived reference with two negative controls, and
    renders a feasibility verdict against the unchanged Area ro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
2026-10-10 layout: first cap-rail overlay demonstrator record 20261010-033947-80bc87e (#254)
    Minted by layout/bin/run-cap-rail-demo-flow.sh at 80bc87e (klt
    0.7.0+gb82427b30c96, open_pdks c6d73a35). Curated klt drc clean; PDK
    sky130A_mr.drc 0 markers; klt lvs match 8/8 devices, 7/7 nets against
    the schematic-derived reference (0.1% tolerance, largest used 0.031%;
    pins name-anchored), both negative controls mismatch. Extracted MiM per
    schematic capacitor within +0.031% of the schematic values.
    Feasibility verdict: geometrically feasible on this plan -- 0.0768 mm^2
    planned rectangle (23% below the unchanged 0.1 mm^2 limit) with all four
    capacitors overlaid as stacked MiM; beside-the-core (0.1216 mm^2) an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
2026-10-10 docs(cap-rail-demo): sensitivity of the verdict to #253's R_BIAS fold finding (#254)
    #253 landed during review: the 16-row R_BIAS fold the #246 bank assumes is
    not electrically equivalent; equivalent folds stop at ~4 segments
    (375.84 x 2.88 um). Placing that strip across the core width adds at most
    2039 um^2 (~0.0789 mm^2, ~21% below the limit). Arithmetic only.
    Loom-Story: 2AMLogic/sky130-ldo#254
    Loom-Trace-Id: d10adc2c05c8ae6ab78e97cc97e42c4f
    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
2026-10-10 docs(readme): replace stale hand-copied verdicts with links to generated report (#264)
    Loom-Story: 2AMLogic/sky130-ldo#264
    Loom-Trace-Id: dbce0c526a88cd5b06b5bf50115714c1
    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
2026-10-10 layout(folded-res-qual): predeclare #263 PVT/mismatch coverage matrix and gates before any run (#263)
    Loom-Story: 2AMLogic/sky130-ldo#263
    Loom-Trace-Id: bba493a2872db7bd18c2449072651f45
    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
2026-10-10 layout(folded-res-qual): PVT/mismatch study helpers, driver and tests (#263)
    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
2026-10-10 layout(folded-res-qual): driver records a BLOCKED study when every batch unit fails; --klt accepts a command (#263)
    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
2026-10-10 layout(folded-res-qual): shared named bias source (alter-able) and .meas-form measurements for older klt clients (#263)
    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
2026-10-10 test(layout): PDK-free unit tests for gen-ldo-blocks planners (#265)
    Loom-Story: 2AMLogic/sky130-ldo#265
    Loom-Trace-Id: 501f774f66624f2e81220408da353fa5
    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
2026-10-10 layout: dual-deck DRC gate (curated + official sky130A_mr) for ldo-core flow (#260)
    Loom-Story: 2AMLogic/sky130-ldo#260
    Loom-Trace-Id: 9960107cb57fd0dce5ab4bd16ac150a0
    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
2026-10-10 layout: first dual-deck ldo-core record 20261010-045715-e17e713 (FAIL: 15060 official markers, 7 families) (#260)
    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
2026-10-10 measurements: read the official DRC deck fail-closed for the DRC row; add tests (#260)
    Builds on 883fba1. Instead of scraping the record.md table, the DRC row's
    parenthetical now comes from drc_row_detail(), which reads the curated
    deck from drc.json and the official sky130A_mr.drc deck through the same
    fail-closed layout/bin/_official_drc.official_result the flow uses:
    clean / violations (violation_count and family count) / ERROR. A record
    that predates the dual-deck gate says "official deck: not run in this
    record" rather than showing curated fields alone.
    Adds TestDrcRowDetail (official violations beside curated clean, official
    clean, nonzero-exit and truncated reports read as ERROR, pre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
2026-10-10 signoff: re-pin item 8 to the regenerated characterization report (#260)
    measurements/characterization.md was regenerated for the new LATEST layout
    record (20261010-045715-e17e713), so its sha256 moved from 4d6f6c8f... to
    0ef90b3f.... Move the pin in the same four places as #245 did:
    artifact-pins.json, block-manifest.json, the generic envelope's
    provenance.input.content_hash, and t1-tier-report.json. No change to the
    verdict itself: still T1 5/11 met, tier=None. signoff/check.sh passes on
    klayout-tools==0.6.0.
    Loom-Build: 0.19.996 0d2be7e9ae05753e2c923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
2026-10-10 layout(folded-res-qual): BLOCKED #263 record (batch fleet version skew then capacity refusal) and README (#263)
    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
2026-10-10 layout(folded-res-qual): #263 resume attempts - raw deterministic batch reports, MC still blocked (#263)
    Loom-Build: 0.19.1009 8889f7bd1eccfb4bc8239e7f5669b65f9815c30e clean
    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
2026-10-10 layout: consolidate git() and run_klt_json() helpers into _record_common (#273)
    Loom-Story: 2AMLogic/sky130-ldo#273
    Loom-Trace-Id: 02bd424c3e4efa8c720e3168af16ab68
    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
2026-10-10 layout: fix via.1a_b, m2.5, via2.5, nwell.9 official-DRC families; mint new core/LVS/area records (#267)
    VIA1 0.15 um, met1/met2 landings extended >=0.085 past vias (also clears
    the via.5a markers the 0.15 via would otherwise expose), met2 power pad
    0.30x0.37, hvi covers the whole n-well box.
    Loom-Story: 2AMLogic/sky130-ldo#267
    Loom-Trace-Id: 59b82394acfb17cb207eb461a8f7c9ad
    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
2026-10-10 characterization: regenerate report for new layout records; re-pin item 8 (#267)
    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
2026-10-10 chore: resync installed Loom surfaces
    <!-- loom:provenance v1 build=unknown c156f673e072832aaacb4cd1ec65b742e7f45867 clean prompts=none sweep=none story=none trace=9de99c124c651049199abe9a75070dc7 host=robb-pro base=89e5594ca60c05cdabaee4ce8e4407d063342e95 run=loom-run/v1:timer:robb-pro/fleet-resync:f790885c-7154-4b3d-acd9-71fd537cd20b installs=0.19.1010 d1d5fcecb79550fe39658555a4419f98cec060fb -->
    Loom-Trace-Id: 9de99c124c651049199abe9a75070dc7
    Loom-Build: unknown c156f673e072832aaacb4cd1ec65b742e7f45867 clean
    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
2026-10-10 chore: resync installed Loom surfaces
    <!-- loom:provenance v1 build=unknown 52f79668bb5f93c1828b7f1ea4f7013b917b847b clean prompts=none sweep=none story=none trace=7057f3175071f1f6e34b354fab40a0ce host=robb-studio base=54f0e73c37e508ab471eb5cc24ac3fd0d9f8dec1 run=loom-run/v1:timer:robb-studio/fleet-resync:d8918779-1625-4202-b151-71f64465e8cd installs=0.19.1010 d1d5fcecb79550fe39658555a4419f98cec060fb -->
    Loom-Trace-Id: 7057f3175071f1f6e34b354fab40a0ce
    Loom-Build: unknown 52f79668bb5f93c1828b7f1ea4f7013b917b847b clean
    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
2026-10-10 layout: extract renderer verdict functions and add PDK-free verdict tests (#278)
    Extract item_11_met (ERC), lvs_is_match/verdict_heading (LVS) and
    bbox_agrees (area) as pure functions; behaviour-preserving. Add
    layout/tests/test_render_verdicts.py with a passing case and a negative
    control per verdict clause.
    Loom-Story: 2AMLogic/sky130-ldo#278
    Loom-Trace-Id: dea684793a66fa0381459b263a27744d
    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
2026-10-10 ci: lint every tracked shell script with bash -n via git ls-files discovery
    Loom-Story: 2AMLogic/sky130-ldo#280
    Loom-Trace-Id: 5206bcd4692c73df1f2348b470fbce98
    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
2026-10-10 ci: guard against modifying/deleting committed sim records (#283)
    Loom-Story: 2AMLogic/sky130-ldo#283
    Loom-Trace-Id: 484dd5f144e6febed927a5e5e15d2f20
    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
2026-10-10 docs: split sim/README.md into harness reference plus sim/docs per-section files (#284)
    Move-only: nine ## sections moved verbatim to sim/docs/, a Contents index
    added, two sibling-relative record links re-pathed. Closes #284.
    Loom-Story: 2AMLogic/sky130-ldo#284
    Loom-Trace-Id: 075d68a7dcfda50af73b8b5f3cd49f77
    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
2026-10-10 report: content-based GDS freshness for LVS and dependent PEX (#287)
    Loom-Story: 2AMLogic/sky130-ldo#287
    Loom-Trace-Id: d413b54c95d8e87e9501220ef6757469
    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
2026-10-10 fix(sim): evaluate xschem 3.4.4 expr() params in netlist_body; retain failure diagnostics (#288)
    Loom-Story: 2AMLogic/sky130-ldo#288
    Loom-Trace-Id: 5eb1c008e4a77ab6701a80c90186d5d5
    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
    [corner-run.py, test_corner_run.py]
2026-10-10 ci: pin and gate the ngspice/xschem versions the way the PDK is pinned (#291)
    Declare tested ngspice/xschem versions in sim/pdk.json; --check-env WARNs on
    drift and FAILs under --require-pdk; records carry declared versions and an
    on_baseline flag; pdk-smoke logs resolved versions.
    Loom-Story: 2AMLogic/sky130-ldo#291
    Loom-Trace-Id: be9135d6637e6cd0bd353a30d37b98e4
    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
    [corner-run.py, test_corner_run.py]
2026-10-10 ci: add pinned ruff F-class lint gate for tracked Python (#293)
    Loom-Story: 2AMLogic/sky130-ldo#293
    Loom-Trace-Id: 55a32168b31d32f66c6822457c420797
    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
2026-10-10 ci: install pinned uv in the checks job for test:lint-py (#293)
    check:ci -> test -> test:lint-py runs `uvx --from ruff==0.17.0`, but the
    `checks` job had no uv, so it failed with `xargs: uvx: No such file or
    directory`. Install uv==0.12.23 via pip (same approach as the
    signoff-tier-report job, but version-pinned for a reproducible lint
    toolchain) before running check:ci.
    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
2026-10-10 sim: PDK-free unit tests for PEX bench generator and record renderer (#296)
    Loom-Story: 2AMLogic/sky130-ldo#296
    Loom-Trace-Id: 0fd6c4e3f1a5315a16180d2d830099fb
    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
2026-10-10 chore: resync installed Loom surfaces
    <!-- loom:provenance v1 build=unknown 525fe43b7b1b2a0271084bba444c934a1541a8d8 clean prompts=none sweep=none story=none trace=0d4424bd058cf912b74934ec0e7bf37e host=robb-pro base=2a5100d3879b9b8fe1c08a66b60e1bf140bb321d run=loom-run/v1:timer:robb-pro/fleet-resync:4812047c-8b9b-4da2-a5dc-13e6f6420a04 installs=0.19.1018 13e54f1cfc513507a7ef84ec6908085638d9c187 -->
    Loom-Trace-Id: 0d4424bd058cf912b74934ec0e7bf37e
    Loom-Build: unknown 525fe43b7b1b2a0271084bba444c934a1541a8d8 clean
    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
2026-10-10 sim: PEX testbench normalizes xschem expr() geometry via shared guarded helper; retain failed-run evidence (#277)
    Loom-Story: 2AMLogic/sky130-ldo#277
    Loom-Trace-Id: 9f7c9c18d663bd3495ae975eb7f1be1d
    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
    [corner-run.py, test_pex_post_layout.py, xschem_exprs.py]
2026-10-10 spec: decision-record status index and CI consistency lint (#292)
    Loom-Story: 2AMLogic/sky130-ldo#292
    Loom-Trace-Id: f64872f174e63e8a994324f015ab09af
    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
2026-10-10 chore: resync installed Loom surfaces
    <!-- loom:provenance v1 build=unknown 525fe43b7b1b2a0271084bba444c934a1541a8d8 clean prompts=none sweep=none story=none trace=d4059def94f46d8d158946acddd4d602 host=robb-studio base=c1170222854181ad70e0c5c402460e2ac7ce8027 run=loom-run/v1:timer:robb-studio/fleet-resync:4a4d1995-968e-44c5-b5fe-804b4d477795 installs=0.19.1019 febfc4335d0554865fadbecba718245cd88c6678 -->
    Loom-Trace-Id: d4059def94f46d8d158946acddd4d602
    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
2026-10-10 measurements: verify DRC freshness against the checked GDS bytes (#304)
    The DRC row's Freshness was derived from the record's schematic commit
    alone, so a record whose stored GDS no longer matched what the checkers
    read still rendered `fresh`. Add check_drc_input_freshness, the DRC
    analogue of check_lvs_geometry_freshness, and combine it with the existing
    schematic check in build_layout_section:
    - curated deck: the GDS drc.json names (resolved by basename inside the
    record dir) must hash to provenance.input.content_hash;
    - official deck: when mr-drc.run.json exists it must carry input_sha256
    for the same bytes; a run record without it leaves the official
    verdict's input unbound, so th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
2026-10-10 sim: add opt-in klt sim batch backend to corner-run.py (smoke-only) (#298)
    --backend {local,batch} (default local). Batch is bounded to the unchanged
    sim/pdk-smoke shape; requests are grouped per supply (quick tuples stay
    singletons), graded locally (limits, spread, strict solver-diagnostic gate),
    and recorded with raw request/response/log evidence and reported execution
    provenance. Structural/transport failures abort without a record or local
    fallback. The klt PDK-provenance check is now shared via _record_common.
    Loom-Story: 2AMLogic/sky130-ldo#298
    Loom-Trace-Id: 5f2129e67c8df2fde856d641112a7cc9
    Loom-Build: 0.19.1009 8889f7bd1eccfb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
    [_record_common.py, corner-run.py, mc-run.py, test_corner_run.py]
2026-10-10 sim/pex-post-layout: retain failed batch-submit evidence for 45-corner schematic leg (Part of #277)
    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
2026-10-10 startup: measure ramp monotonicity (max drawdown) per cold-enable leg (#309)
    Adds a PDK-free checker, per-leg raw trace retention, checker settings in the
    record fingerprint/provenance, docs, and stdlib tests. Local-only; batch
    backend still refuses the manifest. spec/ and old records untouched.
    Loom-Story: 2AMLogic/sky130-ldo#309
    Loom-Trace-Id: 7a45a26c1d790d5ef260e6ecc1ed7b65
    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
2026-10-10 sim: atomically reserve evidence record IDs before concurrent runs (#310)
    Loom-Story: 2AMLogic/sky130-ldo#310
    Loom-Trace-Id: f148c49af37f29ba08cb23795e709190
    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
2026-10-10 startup: fix ruff F541 in corner-run report line; restore experiment.json array formatting (#309)
    Drop the placeholder-less f-string prefix flagged by CI lint, and
    re-collapse the scalar arrays in sim/startup/experiment.json to their
    original one-line form so the diff carries only the semantic changes
    (wrdata lines and the ramp_monotonicity block). JSON content unchanged.
    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
    [corner-run.py]
2026-10-10 sim: drop unused imports and dead worker-script expression (#310)
    Addresses judge feedback on PR #312: ruff F401 on shutil (yield-run.py)
    and json (test_record_reservation.py); remove the no-op
    'map(Path, ...) if False else' in the test worker script.
    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
2026-10-10 measurements: regenerate characterization row for ramp_monotonicity input dim; re-pin item 8 (#309)
    The startup experiment now carries a ramp_monotonicity block that is
    part of the input fingerprint, so the generator lists it among the
    unverified dimensions of the legacy startup record. Apply that one-line
    change to measurements/characterization.md (verdicts unchanged) and
    re-pin its sha256 in signoff/ (artifact-pins, block-manifest, generic
    envelope, t1-tier-report), as #304 did. signoff/check.sh and
    npm run check:ci pass locally.
    Loom-Build: 0.19.1009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
2026-10-10 sim/thermal: share trip-search helpers via _record_common; add PDK-free tests (#297)
    Loom-Story: 2AMLogic/sky130-ldo#297
    Loom-Trace-Id: 7acb633292cc75f21038839fdd140245
    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
2026-10-10 chore: resync installed Loom surfaces
    <!-- loom:provenance v1 build=unknown 5d5f41d89eef35adf478b92b96af06c6d86d27a6 clean prompts=none sweep=none story=none trace=05d2a40831b35ba1c48afada00c29519 host=robb-pro base=7901891c2add0dc12b81e1166d138e1a826c480a run=loom-run/v1:timer:robb-pro/fleet-resync:c58bb82e-a213-439d-b829-04234e141de9 installs=0.19.1028 48ce8a23fdab3059d078e9fffca79e4d4c911d60 -->
    Loom-Trace-Id: 05d2a40831b35ba1c48afada00c29519
    Loom-Build: unknown 5d5f41d89eef35adf478b92b96af06c6d86d27a6 clean
    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
2026-10-10 layout: refresh erc-supply-spec.json and mint ERC record 20261010-225954-95dca45 (#276)
    Loom-Story: 2AMLogic/sky130-ldo#276
    Loom-Trace-Id: d5df904642866fa57cbf595aaa5ec117
    Loom-Build: 0.19.1026 09a449709f5a1c6ae81b471ef56d466247e50808 clean
2026-10-10 chore: resync installed Loom surfaces
    <!-- loom:provenance v1 build=unknown aa536103d6239818bb974a51d2f7f268eff38bad clean prompts=none sweep=none story=none trace=126a1328a3664e2119a0978086db9bea host=robb-studio base=95dca45a915b15687153c3b521c3064b28bbbf9b run=loom-run/v1:timer:robb-studio/fleet-resync:fbc4e361-e290-4d81-ae3a-8b5fde796815 installs=0.19.1032 13ca937a7d6ba8768c296b0c126f2ce48f5f7ca4 -->
    Loom-Trace-Id: 126a1328a3664e2119a0978086db9bea
    Loom-Build: unknown aa536103d6239818bb974a51d2f7f268eff38bad clean
    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
2026-10-10 layout: PDK-free verdict tests for cap-rail, folded-res, trivial-cell and official-DRC scripts (#306)
    Extract each inline verdict/classification into a pure helper and call
    it from the existing main(), with no change to output:
    - render-cap-rail-record.py: gate_flags() and feasibility_verdict()
    - run-folded-res-pvt.py: control_decision() -> (ok, message, exit_code)
    - render-folded-res-qual-record.py: displayed_verdict()/electrical_cells()
    (a case with no matching electrical row now renders n/a instead of
    raising on the missing row)
    - render-record.py: trivial_cell_checks() and overall_pass()
    - _official_drc.py: summarize_marker_families(report, max_samples), a
    stdlib-only seam diagnos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
2026-10-11 sim: PSRR C_eff x ESR reduced-sweep manifest, per-point netlist, worst-point selection + PDK-free tests (Phase 1 of #314)
    Loom-Story: 2AMLogic/sky130-ldo#314
    Loom-Trace-Id: 079b8c94242a066498f7bd98cdd3e327
    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
2026-10-11 sim: drop extraneous f-prefix in psrr_cap_sweep.py (ruff F541) (#314)
    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
2026-10-11 sim: COUT/ESR window grid for load-transient with conservative aggregation and coverage disclosure (#313)
    Phase A: declare the finite DR-002 grid, walk it in-deck with independent
    per-leg reset/seed, zero-ESR via a direct-capacitor branch, grid-aware
    aggregation in corner-run.py, report coverage disclosure, PDK-free tests,
    docs, and re-pinned item 8. No campaign evidence is minted.
    Loom-Story: 2AMLogic/sky130-ldo#313
    Loom-Trace-Id: ad1c8499f295a8f47097d3c69cb5c3ef
    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
    [tb_load_transient.sch]
2026-10-11 sim/pex: retain swx_nrds diagnosis (xschem 3.4.4 raw expr -> PDK swx_nrds cascade) + fixture regression (#277)
    Measured one-corner/one-device reproduction: swx_nrds is defined on the
    g5v0d10v5 subckt instance .param line in the PDK; a raw xschem 3.4.4
    expr('...') geometry parameter makes numparam drop that line, so every
    rsh={swx_nrds} model card reports it undefined. The shared normalizer makes
    the 3.4.4 netlist numerically identical to 3.4.7 and the corner simulates
    cleanly. Fleet still rejects jobs (runner klt 0.5.0 vs client 0.7.0), so the
    45-corner leg remains unverified; no local grid was run.
    Loom-Story: 2AMLogic/sky130-ldo#277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
    [test_pex_post_layout.py]
2026-10-11 spec: defer row status counts to generated report; add check:spec-status guard (#325)
    Loom-Story: 2AMLogic/sky130-ldo#325
    Loom-Trace-Id: 9bfe7468d40be27c278988de960720d8
    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
2026-10-11 sim: klt sim request path for the PSRR C_eff x ESR reduced sweep (#314)
    One klt sim request per quick_subset corner; the 9 points x 2 loads are
    ordered analysis_steps with explicit COUT/RESR/CDIR/RLOAD alters, zero ESR
    via a direct CDIR branch (as #313), and a repeat of the nominal point as an
    order-independence check. Batch by default, local only for one corner.
    Loom-Build: 0.19.1039 e83d19dc0a9b217339ea2f14040c50ad6f46700d clean
    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
2026-10-11 sim: refuse a PSRR sweep record when a corner never ran; document fleet outcome (#314)
    A batch job refused by the fleet runner (klt 0.5.0 vs 0.7.0 client,
    exit 87) returns no engine log. That is an infrastructure failure and
    must abort without a record, not be minted as an all-missing grid.
    README records the attempt (job ids, capacity refusals) and the
    single-corner local spot check that reproduces record 20260926-033606-4a9ec09.
    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
    [psrr-cap-sweep-run.py, psrr_cap_sweep.py, test_psrr_cap_sweep.py]
2026-10-11 layout: area records disclose capacitor, DRC, LVS-freshness coverage (#318)
    render-ldo-area-record.py now writes a coverage block (area.json) and a
    Coverage limitations section (record.md) read from the measured layout
    record's own files: drawn MOS/resistor inventory and pass width, undrawn
    schematic elements, the official-deck DRC result for that exact record,
    LVS freshness against the measured bytes, and the standalone capacitor/rail
    demonstrator cited separately. Measurement and strict comparison unchanged.
    Loom-Story: 2AMLogic/sky130-ldo#318
    Loom-Trace-Id: cef60ff9d98dfb9f5f52b739daafef37
    Loom-Build: 0.19.1039 e83d19dc0a9b217339ea2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
2026-10-11 layout: mint area record for current routed core; reconcile floorplan prose (#318)
    - New append-only area record 20261011-035237-e9ce4c5 for LATEST layout
    record 20261010-045715-e17e713 (GDS sha256 c9d35b88..., unchanged):
    2451.870 x 183.860 um = 0.4508 mm^2, FAIL vs the unchanged strict
    < 0.1 mm^2 Area row; klt stats bbox cross-check agrees. LATEST-AREA
    moved; earlier records untouched.
    - The record discloses the four undrawn capacitors, official-deck DRC FAIL
    (15060 markers / 7 families) on the same layout record, stale LVS
    (LATEST-LVS checked a different GDS), and cites the standalone cap/rail
    demonstrator separately.
    - floorplan.md: current inventory (48 MOS / 5 res), pass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
2026-10-11 docs: move design/README.md investigation log to design/investigation-log.md; fix stale Freshness (#332)
    Loom-Story: 2AMLogic/sky130-ldo#332
    Loom-Trace-Id: b576ab56b3c892db7ef5ca768f9b9e77
    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
2026-10-11 docs: tidy cross-reference wording (#332)
    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
2026-10-11 docs: add Iq to open-gaps FAIL list in design README (#332)
    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
2026-10-11 chore: resync installed Loom surfaces
    <!-- loom:provenance v1 build=unknown cf08873555e2eb95da295dcbee98b0dc34473381 clean prompts=none sweep=none story=none trace=67fbc483c3ca3e442d7928804c11ff06 host=robb-pro base=47d18b9fafca343a6934ad42dfb923a8da4973d0 run=loom-run/v1:timer:robb-pro/fleet-resync:e3f97888-2b26-404a-bd47-86fd28a4eced installs=0.19.1041 b65c266b47d796bf37d1c04c6f616be0bc699056 -->
    Loom-Trace-Id: 67fbc483c3ca3e442d7928804c11ff06
    Loom-Build: unknown cf08873555e2eb95da295dcbee98b0dc34473381 clean
    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
2026-10-11 chore: resync installed Loom surfaces
    <!-- loom:provenance v1 build=unknown e91831edf7b55b29d3a2d88e266916fab9ce2563 clean prompts=none sweep=none story=none trace=f72dd67520a2c3802aa0495b80ac65a5 host=robb-studio base=aea6ceac3d19bc9bdaf356f1f9ed479ea8856da2 run=loom-run/v1:timer:robb-studio/fleet-resync:91d2434e-eae5-45de-9305-d78c43fc7c7a installs=0.19.1042 5b6ebdcc40bfccc9357e15196984061f1d5e6178 -->
    Loom-Trace-Id: f72dd67520a2c3802aa0495b80ac65a5
    Loom-Build: unknown e91831edf7b55b29d3a2d88e266916fab9ce2563 clean
    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
2026-10-11 docs: refresh work log and current issue roadmap
2026-10-11 sim: explicit lower/upper bound inclusivity in corner-run grader (#335)
    Loom-Story: 2AMLogic/sky130-ldo#335
    Loom-Trace-Id: 80efc4161c9716f8ff18f1c4ac842526
    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
2026-10-11 sim+design: dropout attribution study at tt/27C/3.30V/50mA, fresh baseline (#323)
    Mint single-corner baseline 20261011-092557-7a4e0cc (dropout_v 0.397658 V),
    two diagnostic bench-copy probes, and the design note. Re-pin item 8 for the
    regenerated characterization. No DUT, spec, flavor or DR change.
    Loom-Story: 2AMLogic/sky130-ldo#323
    Loom-Trace-Id: 4de61efa8cef01d878c4cac58f54da39
    Loom-Build: 0.19.1047 b801ec198a3113b88fa9292ccd75f934ab0c1679 clean
2026-10-11 layout: capacitor-implementation comparison study (#319)
    Compare one-level MiM, stacked MiM, the PDK's cap_vpp cells and cap_var
    varactors for the 162 pF budget against the ratified Area row, from the
    pinned sky130A model/layout files plus klt sim evidence. New append-only
    record layout/cap-study/20261011-094917-7a4e0cc/ (record.md, matrix.json,
    commands.md, op/ and cv/ runs).
    Outcome (c) inconclusive/unmeasured: the operating-point matrix is 2/126
    measured because the batch fleet runner refuses this client
    (klayout-tools#2948; job klt-sim-b5af2f44739e), and the grid was not run
    locally. Completion is tracked in #341. Tool gaps filed generically as
    klayout-tools#3100.
    Stdlib-only helper (l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
2026-10-11 sim/loop-gain: extend AC deck to 18-leg C_eff x ESR x load boundary grid incl. exact-zero ESR (#338)
    Loom-Story: 2AMLogic/sky130-ldo#338
    Loom-Trace-Id: 226553feb6b87860d20d891af7ccd04c
    Loom-Build: 0.19.1050 abf3f7109328fd66ec77827f5fd849f5279fee82 clean
2026-10-11 sim: 0 mA phase-margin mitigation screen, bleed + passive compensation, with Iq accounting (#324)
    Loom-Story: 2AMLogic/sky130-ldo#324
    Loom-Trace-Id: 28ff6bc7db324bdd3b604fd9f8a95028
    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
2026-10-11 sim/loop-gain: fix ruff F841 in mitigation_probe, commit ngspice logs (#324)
    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
2026-10-11 sim: run the load-transient COUT/ESR window grid on the klt batch backend
    Extend corner-run.py's batch allowlist to sim/load-transient. A new
    PDK-free translator (sim/bin/batch_window_grid.py) maps each
    window_grid leg block onto a single-step klt `analysis_steps` request:
    `reset` becomes one request per supply x leg (each leg is its own ngspice
    process), alters keep the local deck's values via a shared leg_values(),
    `meas tran` cards pass through, and vector `let` helpers are inlined into
    the graded expressions. Leg results are merged back into one result per
    corner and graded and aggregated (grid_coverage) as for a local run.
    Every other slug is still refused, and so is any edited window-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
2026-10-11 chore: resync installed Loom surfaces
    <!-- loom:provenance v1 build=unknown 5ec729b9f7dd55a2082752611e4c4964f49661fb clean prompts=none sweep=none story=none trace=efc2abc8b72538df6d1a6ea9d329603d host=robb-pro base=3b7726a8100878198f8874e9c3c882e6fa08b69b run=loom-run/v1:timer:robb-pro/fleet-resync:0d396c06-f26e-423e-97ac-6d3ac04a8e51 installs=0.19.1054 f6a73bc7fc942d7b297514b2e3f57a0ca2076010 -->
    Loom-Trace-Id: efc2abc8b72538df6d1a6ea9d329603d
    Loom-Build: unknown 5ec729b9f7dd55a2082752611e4c4964f49661fb clean
    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
2026-10-11 docs: finding for #347 - pinned Ruff F lint already covers diagnostic drivers; no enforcement change
    Loom-Story: 2AMLogic/sky130-ldo#347
    Loom-Trace-Id: 61c364a334f9e59af7fdd4413d275c45
    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
2026-10-11 chore: resync installed Loom surfaces
    <!-- loom:provenance v1 build=unknown 745f69d0daad6c23e76cc006720fa4fbeaa3d887 clean prompts=none sweep=none story=none trace=3baabc4a039fd85029fff227a6ae690a host=robb-studio base=bf6e83636227ecaf6821d9e005ca15c9fd11312a run=loom-run/v1:timer:robb-studio/fleet-resync:3b3207d7-055d-49b5-a387-db375213668d installs=0.19.1060 3336676408ee1d4f1df2dc7f23adbb6c3170674e -->
    Loom-Trace-Id: 3baabc4a039fd85029fff227a6ae690a
    Loom-Build: unknown 745f69d0daad6c23e76cc006720fa4fbeaa3d887 clean
    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
2026-10-11 sim: dropout screening - isolated pass bench + combined ideal-tail/no-clamps probe at tt/27C/50mA (#339)
    Pass-device capability is not the limit (50 mA at 0.12-0.17 V with ample Vsg);
    ideal tail + no clamps together give a valid 0.164 V vs 0.398 V baseline.
    Single condition, diagnostic only; no spec/production/record change.
    Loom-Story: 2AMLogic/sky130-ldo#339
    Loom-Trace-Id: 0d01d67a1eaf691e40611b88756cad94
    Loom-Build: 0.19.1055 4737928b703aa8a4c87d04eefbf7299fb933eab4 clean
2026-10-11 fix(sim): make issue-339 analyze.py parse on Python 3.11 (#339)
    Hoist the nested same-quote f-string in cmd_compare (PEP 701, 3.12-only)
    into a tail_s variable so CI's Python 3.11 test:compile/test:unit pass.
    Analysis logic unchanged: compare.table.txt regenerated under 3.11.17 and
    3.12.3 is byte-identical. Update analyze.py sha256 in provenance.json and
    note the post-run edit and the source_commit_at_run semantics. No
    simulation re-run.
    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
2026-10-11 sim: load-adaptive R_CZ compensation prototype screening - sense-path control, paired tt/ss/ff loop-gain, Iq, current-limit, load-step (#349)
    Measured REVISE outcome; no spec, DR or production schematic change. Unresolved
    0 mA stability failures and baseline ff/125C full-load Iq failure retained.
    Loom-Story: 2AMLogic/sky130-ldo#349
    Loom-Trace-Id: ca884a95999596a8c0294b3896c4802c
    Loom-Build: 0.19.1065 33bb950d65b9038d5cf119a252820edca1192edf clean
2026-10-11 fix(sim): drop unused local in issue-349 compare.py (ruff F841) (#349)
    Dead `cells = []` in the sense-path table loop. Regenerated tables.md is
    byte-identical; no result.json records the compare.py hash.
    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
2026-10-11 test(layout): PDK-free unit coverage for cap-study orchestrator run-cap-study.py (#351)
    Loom-Story: 2AMLogic/sky130-ldo#351
    Loom-Trace-Id: 1147ad2d051a5a9c8eea35d0c996df73
    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
2026-10-11 sim: add shared _probe_common helper for ngspice diagnostic probes (#353)
    Loom-Story: 2AMLogic/sky130-ldo#353
    Loom-Trace-Id: 5d3fce1a9bfc17d6ebe3333670807f99
    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
2026-10-11 sim: add shared batch-runner preflight probe (#356)
    Loom-Story: 2AMLogic/sky130-ldo#356
    Loom-Trace-Id: e8d7624aeaa57dbbbf0275180411f5d5
    Loom-Build: 0.19.1068 fcc4454e112d13e088464bb0a178b75c0dc96c0f clean
2026-10-11 chore: resync installed Loom surfaces
    <!-- loom:provenance v1 build=unknown b37a005ac1889262fb9e5338f7cff4e9ed4987da clean prompts=none sweep=none story=none trace=25c158d7e9591610b251780caaff1c5f host=robb-pro base=59d479e4eaf7268bed110d7c7acbf1464978982f run=loom-run/v1:timer:robb-pro/fleet-resync:7f020bca-6920-47f7-a5e4-bbd5c82d9bb8 installs=0.19.1072 29b48db1ead9c4501304e0114a5c33310e1d589f -->
    Loom-Trace-Id: 25c158d7e9591610b251780caaff1c5f
    Loom-Build: unknown b37a005ac1889262fb9e5338f7cff4e9ed4987da clean
    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
2026-10-11 sim: batch preflight accepts only a completed usable smoke response (#359)
    classify() previously returned ACCEPTED for an empty corner list, a
    running job, an errored corner, or error diagnostics without a
    runner_code, and could raise on malformed diagnostics. Exit 0 now
    requires a remote job id, a terminal successful remote state ("done",
    or "failed" with a ran-to-report exit_code 0/3/4 per klt's batch
    backend), exactly one corner identified as the tt / 27 C smoke point by
    process and temperature (as corner-run.py matches), a completed corner
    status (pass/fail), and no error-severity diagnostic or runner code.
    Shapes are validated defensively: malformed corners, diagnostics
    containers, entr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
2026-10-11 sim: bounded missing-crossing loop-gain diagnosis with response-level extractor (#360)
    Loom-Story: 2AMLogic/sky130-ldo#360
    Loom-Trace-Id: 57804535af091ead330060f49c5b6b66
    Loom-Build: 0.19.1071 dcab8265613676d08b763cddc911b93c7ab7d9d4 clean
2026-10-11 sim(#357): declare dropout candidate screen plan, stimuli and tolerances before execution
    Candidate generator (NMOS-input OTA + VREF-referenced bias + re-referenced
    current-limit clamp reference), single-run probe driver, analysis with
    #339 validity gates, and the declared sequential command list. No
    simulation results yet.
    Loom-Story: 2AMLogic/sky130-ldo#357
    Loom-Trace-Id: b24ff0d2fa7a3354963d39a81ca9f03a
    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
2026-10-11 sim(#357): rev0 screen evidence; declare and lock rev1 (Iq + disabled-state revision)
    rev0: dropout 0.166674 V valid at tt/27C (baseline 0.397658 V reproduced
    exactly), but iq_full_load 30.86 uA > 30 uA (new regression) and a
    singular-matrix diagnostic in the enable-shutdown disabled state. rev1
    sizing derived on DC benches (sz03-sz06 retained) before any rev1 loop run.
    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
2026-10-11 sim(#357): physical low-headroom amplifier + re-referenced clamp candidate screen
    rev1 (the single evidence-driven revision) at tt/27C: valid dropout
    0.163237 V vs current-DUT 0.397658 V (repeat 0.0000 mV), pass device
    unchanged, VIN-only power. Current limit 152.5 mA at 3.3 V (base 153.3),
    VIN-independent at 2.1 V (165.5 mA; base collapses to 73.7). Iq full
    load 28.82 uA (base 27.61, bound < 30). Enable/shutdown clean; thermal
    two-state pattern identical to baseline at 3.3 V and 2.1 V. rev0 kept as
    evidence (Iq 30.86 uA regression, EN singular-matrix diagnostic).
    Decision: advance to a production-adoption review; PVT not qualified.
    Lo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
2026-10-11 sim(#357): fix ruff F-lint findings (no behaviour change; netlists regenerate identically)
    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
2026-10-11 sim(#357): track raw solver logs, regenerate provenance, test manifest is tracked
    Address review: 78 ngspice logs were ignored by *.log and absent from HEAD.
    Unignore dropout-vs-load diagnostics run logs, rebuild provenance.json over
    tracked files only (drop __pycache__), add a test that every manifest path is
    git-tracked and hash-matches.
2026-10-11 sim(#357): thermal trace validity fails closed before trip/hold/pass-off extraction
    Validate nonempty data, complete column pairs, finite strictly-increasing time,
    finite vectors and coverage through the declared 170 us stop before sampling
    (rc.at() clamps to an endpoint). Named INVALID reason propagates to the thermal
    summary. Fixtures exercise the real thermal_result() path: truncated, nonfinite
    time, non-monotonic time, nonfinite vector, missing/non-numeric columns, empty,
    plus a complete valid trace. Provenance hashes refreshed; committed evidence
    and summary.txt unchanged.
2026-10-11 sim(#357): thermal validity requires early-sample coverage; render INVALID in thermal table
    - probe.py: reject one-row and late-start (>19 us) traces before sampling
    - summarize.py: thermal_table() guards pass-off/Id columns on validity and prints the named reason
    - tests: late-start/single-row fixtures; thermal_table() with an INVALID run among valid ones
    - provenance.json: refresh probe.py and summarize.py hashes only
2026-10-11 sim(#357): settled loaded thermal actuator witness (paired conducting control vs forced trip)
    Adds a bounded thermal-settled bench: 150 C / tt, 3.3 V and 2.1 V, baseline and
    rev1, an untripped settled loaded control vs a forced trip. Declared gate rejects
    a witness that is off in both states. Attempt 1 (ths_*) retained; 2.1 V controls
    were unsettled. Attempt 2 (thl_*) demonstrates pass-off for all four pairs.
    Existing evidence untouched; provenance refreshed.
2026-10-11 sim: zero-load phase-dip mechanism and bounded light-load lever screen (#365)
    Loom-Story: 2AMLogic/sky130-ldo#365
    Loom-Trace-Id: 86e3eac6b954e2a2cf0992d74c5e2847
    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
2026-10-11 docs(#365): disclose local multi-leg decks; mark lever B provisional; fix hash manifest
    - README section 1: the five local ngspice -b runs were multi-leg decks at one
    PVT point (tt/27C/3.30V), run as an exception after the batch preflight
    failed (exit 3, klt version mismatch), not single-condition probes. base_tt
    is the mechanism probe; lever and transient legs would normally have gone
    through the batch path.
    - Lever-B result and the qualification handoff are labelled PROVISIONAL until
    a fleet re-run.
    - hashes.sha256: drop the uncommitted __pycache__ .pyc entry and refresh the
    README hash; sha256sum -c passes.
    Doc-only; no simulation was re-run.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
2026-10-11 sim: gate load-regulation endpoints on Output window; strict delta maxima (#364)
    Loom-Story: 2AMLogic/sky130-ldo#364
    Loom-Trace-Id: a02f53090c5ab4360bb80011461ee54d
    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
2026-10-11 chore: resync installed Loom surfaces
    <!-- loom:provenance v1 build=unknown 81a6b4499cb57b3620785bc1625c300da34f0735 clean prompts=none sweep=none story=none trace=d08bbd290651d7bcbda8b216c0dfbcdf host=robb-studio base=7235600ca3f47d46c7adac465cf215da8766f396 run=loom-run/v1:timer:robb-studio/fleet-resync:71e05e3d-931c-46b4-b6d2-5f3f992c1e19 installs=0.19.1073 abb0872ba7d1d3f6f3a14f71f51a562e89308181 -->
    Loom-Trace-Id: d08bbd290651d7bcbda8b216c0dfbcdf
    Loom-Build: unknown 81a6b4499cb57b3620785bc1625c300da34f0735 clean
    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
2026-10-11 sim: gate line-regulation endpoints on Output window; strict slope maxima (#369)
    Loom-Story: 2AMLogic/sky130-ldo#369
    Loom-Trace-Id: 532eeea2b1e6a10eb1eca445fae30802
    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
2026-10-11 sim: gate load-transient legs on in-window pre-step output (#372)
    Loom-Story: 2AMLogic/sky130-ldo#372
    Loom-Trace-Id: 0f28180f162abb25cdfc0fa321ec0796
    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
2026-10-11 sim: admit dropout-vs-load cold-start crossing to the klt batch backend (#374)
    Add a narrowly validated dropout adapter to corner-run.py's opt-in batch
    backend. sim/bin/batch_dropout.py (PDK-free) translates the manifest's
    `tran 10u 14m uic` + `meas tran` crossing/avg cards + graded expression into
    one klt `analysis_steps` step per supply group. klt renders that step back
    into the local deck's own control commands.
    - Shape gate before netlisting: one cold-start tran, td-delayed crossing or
    window-avg cards only, expressions over card names only.
    - Renewal pin: the manifest's analyses/measurements/matrix input-fingerprint
    digests are pinned, so any execution change refuses batch until th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
2026-10-11 sim: grade settled tail extrema alongside regulation endpoint averages (#377)
    Each of the two load-regulation and four line-regulation endpoints now also
    measures min/max of v(vout) over the same 199-200 ms settled tail as its
    average (same tranN plot), graded min >= 1.764 V and max <= 1.836 V
    (ratified Output window, inclusive). Averages, delta/slope formulas and
    strict bounds, stimuli, cold-start protocol and duration are unchanged; no
    ripple bound is added. Extrema are sampled over the simulator's timepoints.
    Headless tests drive the actual manifests through run_corner /
    parse_measurements / grade_bounds (stubbed ngspice), plus a PDK-free toy
    deck through real ngspice (skipped without ng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
2026-10-11 sim: opt-in strictly admitted batch adapter for the line-regulation cold-start endpoints (#379)
    Loom-Story: 2AMLogic/sky130-ldo#379
    Loom-Trace-Id: 62d9c5cfe1c66e42e2aa6af07976d160
    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
2026-10-11 sim: opt-in strictly admitted batch adapter for the load-regulation cold-start endpoints (#381)
    Loom-Story: 2AMLogic/sky130-ldo#381
    Loom-Trace-Id: b18897a67f2145e37584897ba5e7c90f
    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
2026-10-11 sim/tests: admit load-regulation strictly in the #377 batch-backend test (#381)
    check_batch_supported now admits sim/load-regulation at its pinned
    endpoint-adapter shape, so the #377 test that still expected a refusal
    failed CI. Rename it, assert both regulation manifests are admitted via
    the endpoint adapter, and keep asserting the sibling benches (iq,
    psrr-dc, startup) are refused.
    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
2026-10-12 chore: resync installed Loom surfaces
    <!-- loom:provenance v1 build=unknown ddfb67ccf9a5115d62dd86924613a468b9328f44 clean prompts=none sweep=none story=none trace=772605234b9d8cafd6a4049200f7425c host=robb-pro base=2b6ab2784a133c222dea0e2234ff9f91ac2c73d8 run=loom-run/v1:timer:robb-pro/fleet-resync:1ef28ffc-0277-424f-9224-7ee6eca46377 installs=0.19.1083 77a174ea7fcaddbb25d0082956cd25d8633fc2df -->
    Loom-Trace-Id: 772605234b9d8cafd6a4049200f7425c
    Loom-Build: unknown ddfb67ccf9a5115d62dd86924613a468b9328f44 clean
    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
2026-10-12 chore: resync installed Loom surfaces
    <!-- loom:provenance v1 build=unknown be358990895362019614bd207bcbe36bc9eeff2c clean prompts=none sweep=none story=none trace=f1dc643b95859c8f26e892ddb5e2c5d7 host=robb-studio base=5925a77564fc90c9f3f53388ea50ed76327cfcc2 run=loom-run/v1:timer:robb-studio/fleet-resync:da486ca2-3e94-4a85-abd3-88707942489a installs=0.19.1087 51ac271f990b317a52ebf27cc21f34561e1179fb -->
    Loom-Trace-Id: f1dc643b95859c8f26e892ddb5e2c5d7
    Loom-Build: unknown be358990895362019614bd207bcbe36bc9eeff2c clean
    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
2026-10-12 chore: resync installed Loom surfaces
    <!-- loom:provenance v1 build=unknown a579728c137cc11d08a48b178e0ff9aa21683e72 clean prompts=none sweep=none story=none trace=10832f2750dbcd63f6c6f301a6f4da9b host=loom-worker-2 base=66d0548788b18a8232d7b3f357897979a5d18e9c run=loom-run/v1:timer:loom-worker-2/fleet-resync:180f6d5054f0479ab3990b86ab4522a5 installs=0.19.1087 51ac271f990b317a52ebf27cc21f34561e1179fb -->
    Loom-Trace-Id: 10832f2750dbcd63f6c6f301a6f4da9b
    Loom-Build: unknown a579728c137cc11d08a48b178e0ff9aa21683e72 clean
    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
2026-10-12 chore: resync installed Loom surfaces
    <!-- loom:provenance v1 build=unknown 02ecafe7734bf5faa945ce88940589f00eca78e9 clean prompts=none sweep=none story=none trace=5f71c537126994dc4c45179122427514 host=robb-pro base=f08f89b991154863ba85e288a2069e4d0a40d665 run=loom-run/v1:timer:robb-pro/fleet-resync:6293e6da-8a67-45aa-b277-c9ef85ddb810 installs=0.19.1101 27422582cd2d34d8ed5f60ce987007bc4bd61081 -->
    Loom-Trace-Id: 5f71c537126994dc4c45179122427514
    Loom-Build: unknown 02ecafe7734bf5faa945ce88940589f00eca78e9 clean
    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
2026-10-12 chore: resync installed Loom surfaces
    <!-- loom:provenance v1 build=unknown 5918da96dcd60c9a677a195737c86ea38972d215 clean prompts=none sweep=none story=none trace=49bb7a8942d6a23bf41754ca27ff2368 host=loom-worker-2 base=5dd334d4a3f3d55bf3198fcfe34fef60425d210e run=loom-run/v1:timer:loom-worker-2/fleet-resync:2e973f04abd1447d8ee4b696c2e7d2b4 installs=0.19.1108 72427939d156341080a7006ae6fbb5ec96b2368e -->
    Loom-Trace-Id: 49bb7a8942d6a23bf41754ca27ff2368
    Loom-Build: unknown 5918da96dcd60c9a677a195737c86ea38972d215 clean
    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
2026-10-12 chore: resync installed Loom surfaces
    <!-- loom:provenance v1 build=unknown 01467247f32c59822968bf02d3214d9a3d613452 clean prompts=none sweep=none story=none trace=0e97e9733eef09a33959cf96e6271f40 host=robb-studio base=ce481163127b2e67c150c9d6452ef619aa75fcf0 run=loom-run/v1:timer:robb-studio/fleet-resync:53a4d390-3842-4216-9018-5dced9d0ea17 installs=0.19.1109 d9498fcd419776b2517e30b99c88e76bbe92d2f4 -->
    Loom-Trace-Id: 0e97e9733eef09a33959cf96e6271f40
    Loom-Build: unknown 01467247f32c59822968bf02d3214d9a3d613452 clean
    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
2026-10-12 chore: resync installed Loom surfaces
    <!-- loom:provenance v1 build=unknown acadc2b4b0e852f2d889ac9dec616e1548705802 clean prompts=none sweep=none story=none trace=a69edb348af7f0e67b3bc77bc33b1bfc host=loom-worker-2 base=1ad4e85fc07b1b0228d02e8e134e80bfba75c441 run=loom-run/v1:timer:loom-worker-2/fleet-resync:0923627ffda84cf69ec2486475772b10 installs=0.19.1126 7736d1276b6d01778fba3461114c858ef1bf5e2d -->
    Loom-Trace-Id: a69edb348af7f0e67b3bc77bc33b1bfc
    Loom-Build: unknown acadc2b4b0e852f2d889ac9dec616e1548705802 clean
    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
2026-10-12 chore: resync installed Loom surfaces
    <!-- loom:provenance v1 build=unknown 8d832cc8035d4ba07872510416468da0790332cd clean prompts=none sweep=none story=none trace=09a53bf60e96fc30a753caffd1de8c92 host=robb-studio base=33091447d1f7688d07b2004500dfef2bf6dd823a run=loom-run/v1:timer:robb-studio/fleet-resync:baf4c30c-65d9-4d4e-a740-f6a80cbb975c installs=0.19.1132 8695bdd2b7b963dca9b76f4643a9d7c744294426 -->
    Loom-Trace-Id: 09a53bf60e96fc30a753caffd1de8c92
    Loom-Build: unknown 8d832cc8035d4ba07872510416468da0790332cd clean
    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
2026-10-12 chore: resync installed Loom surfaces
    <!-- loom:provenance v1 build=unknown aa1ed0d7d5499d2705977d971673d919dbbbaf4e clean prompts=none sweep=none story=none trace=2522608826ef5d5e4a88a9667055aeb7 host=loom-worker-2 base=2ab13746181f536f486d7f465a0fa8b753c49dde run=loom-run/v1:timer:loom-worker-2/fleet-resync:8f26b719c712455381744111c50e90b4 installs=0.19.1142 b91ae5d1b5204f499a1abb875a6cf5bffc1d90b1 -->
    Loom-Trace-Id: 2522608826ef5d5e4a88a9667055aeb7
    Loom-Build: unknown aa1ed0d7d5499d2705977d971673d919dbbbaf4e clean
    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
2026-10-12 chore: resync installed Loom surfaces
    <!-- loom:provenance v1 build=unknown 8b64614d017d6ce7491c3a2ac9da51e5e2901c97 clean prompts=none sweep=none story=none trace=66044c049ba635bcd6a4797c3a77e84b host=robb-pro base=b3ec016c57e6babf06ffa8ed437d9e71cfc55298 run=loom-run/v1:timer:robb-pro/fleet-resync:68f56594-05d0-4cc0-9c07-36263359d698 installs=0.19.1144 9e4381cbbd2386393e44c7a979583252948a3998 -->
    Loom-Trace-Id: 66044c049ba635bcd6a4797c3a77e84b
    Loom-Build: unknown 8b64614d017d6ce7491c3a2ac9da51e5e2901c97 clean
    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
2026-10-13 chore: resync installed Loom surfaces
    <!-- loom:provenance v1 build=unknown e66f00108a9519331aa981da8a01c6569ca623a9 clean prompts=none sweep=none story=none trace=d3e476cf8c03d5ed37f8e146b3632190 host=robb-studio base=e6074d129ceb53a2b4c92cdf264887c9ce1b6863 run=loom-run/v1:timer:robb-studio/fleet-resync:1d7ace45-2daf-4c92-a752-67b11e982245 installs=0.19.1146 972552531e3e890528f13c6cc8fb7406877c96f9 -->
    Loom-Trace-Id: d3e476cf8c03d5ed37f8e146b3632190
    Loom-Build: unknown e66f00108a9519331aa981da8a01c6569ca623a9 clean
    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
2026-10-13 chore: resync installed Loom surfaces
    <!-- loom:provenance v1 build=unknown 98d08ab78cc223361354ee9947d996b1cb914b30 clean prompts=none sweep=none story=none trace=8b73addcdeaa8fbd65998649f42a8c50 host=loom-worker-2 base=13db2c473be9138eb2a19c5430e93ab711a5588d run=loom-run/v1:timer:loom-worker-2/fleet-resync:3bfb13d52fca425f9cfced4541954cb6 installs=0.19.1148 1448fdfa79ac2dcab7fad6b95b72697b450f2a4a -->
    Loom-Trace-Id: 8b73addcdeaa8fbd65998649f42a8c50
    Loom-Build: unknown 98d08ab78cc223361354ee9947d996b1cb914b30 clean
    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
2026-10-13 chore: resync installed Loom surfaces
    <!-- loom:provenance v1 build=unknown d0bfbbc7ac309581d7abe02c4a269c7704010ee0 clean prompts=none sweep=none story=none trace=0ad6d167235000f3b5648cbd63d761ce host=robb-pro base=b7c6a3258de04eddbb23efc8ceaa3cb96a9e1e2b run=loom-run/v1:timer:robb-pro/fleet-resync:4f7cbe22-40b6-49ff-8811-003ae8577c28 installs=0.19.1151 021b947d121929157cd83df0576e7f2aa12500d7 -->
    Loom-Trace-Id: 0ad6d167235000f3b5648cbd63d761ce
    Loom-Build: unknown d0bfbbc7ac309581d7abe02c4a269c7704010ee0 clean
    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
2026-10-15 sim: extend startup to a 12-leg C_out x load x ESR cold-enable grid
    Part of #336. Adds the ESR axis (0/10m/500 mOhm) to sim/startup via the
    window_grid mechanism, with a CDIR zero-ESR branch in the testbench,
    per-leg trace files, ramp-monotonicity verdicts counted in the grid
    verdict, headless tests, README/characterization disclosure and a
    single-corner pilot note. The 45-point campaign is not minted here.
    Loom-Issue: 2AMLogic/sky130-ldo#336
    Loom-Story: 2AMLogic/sky130-ldo#336
    Loom-Trace-Id: 812b834b93f56150b73352f1a6efc972
    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
2026-10-16 sim: post-layout PEX rerun against #267 geometry (schematic leg 41/45; extracted leg blocked by batch model-lib path)
    Append-only record 20261016-030826-f604ae0 with retained failure diagnostics.
    Extracted leg errored on all 135 rows (klayout-tools#3296); no local fallback.
    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
2026-10-16 study: cap-study single-corner probe shows one settled state at ff/27C/2.97V/50mA
    Nine local runs (default, tight tolerances, gear, finer step, three initial
    conditions) settle to the later batch record's state; the earlier record's
    value is not reproduced and its cause is not found.
    Closes #398
    Loom-Story: 2AMLogic/sky130-ldo#398
    Loom-Trace-Id: 8f3853a6401e94c79af6ce80ea77e7f3
    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
2026-10-16 study: correct cap-study probe run count (nine -> eight)
    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
2026-10-16 sim/pex-post-layout: PDK-relative models request, netlist via klt (#267)
    The absolute $PDK_ROOT models.lib failed on the batch runner (klayout-tools#3296);
    a 2-corner batch probe of the PDK-relative form produced real extracted-leg
    numbers. Also netlist the schematic through 'klt netlist' rather than raw xschem.
2026-10-16 sim/pex-post-layout: record batch_concurrency_cap failure for PDK-relative rerun; de-vacuate enclosure test (#267)
    Fleet at BATCH_MAX_CONCURRENT_INSTANCES=8 refused both legs at submit; no local
    fallback. Failure evidence retained under failures/20261016-161847-854ab16/.
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2026-10-17 layout: read cap-rail and folded-res .lyrdb reports via fail-closed parse_lyrdb
    Drops the two private lenient readers; a truncated, malformed or wrong-top-cell
    report now fails the gate with the reason recorded instead of passing or
    raising a bare traceback.
2026-10-22 feat(pex): bump klt pin and run klt pex with --resistance-graph
    Pin klt to dc136150 (carries klayout-tools#4038), re-verify ldo-core DRC/LVS
    at the new pin (reference netlist now adds the deck's width-normalized head
    term), pass --resistance-graph to run-pex.sh, and mint a PEX record that
    flags every net that fell back to legacy resistance (0 of 28 graph-derived).
    Part of #162
    Loom-Issue: 2AMLogic/sky130-ldo#162
2026-10-22 fix(signoff): re-pin item 8 to the regenerated characterization rollup
2026-10-23 feat(sim): store new run evidence in the artifact store, commit only manifest + summary
    corner-run, mc-run and yield-run stage their JSON twin, netlist snapshot,
    logs and request/response files under git-ignored sim/.work/, push them with
    klt artifact put, and commit manifests/artifacts/<bench>-<run-id>.manifest.json
    plus the records/<rid>.md summary. Fails closed before simulating when the
    broker env, the put verb or the broker is unavailable. Adds a CI check that
    rejects non-artifact: uris and committed bytes duplicating stored objects.
2026-10-23 fix(measurements): mint fresh core-area record against current routed GDS
    Part of #114
2026-10-23 fix(ci): accept committed official-deck DRC rendering; re-pin item 8 to regenerated rollup
2026-10-27 feat(signoff): wrap PVT records into klt sim envelopes for T1 item 5
    Wrap route (no re-simulation): signoff/make_item5_envelope.py emits eleven
    klt sim-shaped envelopes carrying the ratified bound per row, pinned to the
    netlist each record simulated. Manifest declares spec_rows."5" (iq
    unratified, area/output-noise gaps); check.sh grader pin 0.6.0 -> 0.8.0
    (first release reading spec_rows). Item 5 now grades check_failed naming rows.
2026-10-28 docs(signoff): describe area declared gap as a failing lower-bound row
    Reword the area gap in the manifest and README to state it is a failing
    layout row (0.451931 mm2 vs < 0.1 mm2, capacitors undrawn), cite the layout
    record and klt economy --budget-um2; re-render the T1 report.
    Part of #458
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2026-11-01 feat: PVT PSRR/stability grid and minted Iq record for the DR-013 R_BIAS candidate
    Adds sim/bin/bias-retopo-pvt.py, which expresses the psrr-dc and loop-gain
    benches as plain `klt sim --backend batch` requests (ac .meas cards for PSRR,
    klt `transfer` metrics for PM/GM/fc, one instrumentation VCVS for the loop-gain
    denominator) without touching corner-run's batch allowlist, and no local
    fallback. New append-only records: 45-point PSRR x 2 loads, 45-point x 18-leg
    stability, and a minted 45-point sim/iq record. DR-013 gets an additive
    dated Evidence update; its decision text and Status are unchanged.
2026-11-04 docs(spec): correct DR-013 ratification history and engine provenance (#493 send-back)
    - DR-013 was ratified by the operator on #470 on 2026-11-01 (r5-q34); #482
    ratified only the #478 additions. Amendment and README row now say so.
    - All 12 responses record engine_host=worker and worker ngspice-46; only the
    client-side probe binary differs. Provenance note rewritten accordingly.
2026-11-05 sim(iq): mint superseding 45-corner record on the batch backend under the #171 contract
    Record 20261105-052332-05df7a01: 40/45 PASS, 0/45 solver diagnostics,
    45/45 inside the Output window; five 3.63 V fast-corner full-load Iq FAILs.
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2026-11-05 sim(loop-gain): fleet screen of a sub-mA load-sensed adaptive R_CZ (two reference choices)
    Netlist-edit candidate (not the production schematic) that shorts an extra R_CZ
    segment above a load threshold, keyed off the existing current-limit sense
    mirror. 94 batch requests (AC, op/Iq, 0<->1 mA and 1<->50 mA transients) and a
    fleet re-run of the x16 transient pair. Verdict: candidate A revise (zero/10 uA
    repaired at ~0 Iq, 30-300 uA band unsolved by a load-only threshold), candidate B
    reject (regresses 0.33 uF at 100 uA, Iq 30.02 uA). Current-limit interaction unrun.
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2026-11-10 refactor: share verdict and report logic between paired comparison scripts
    Move the row builder, verdict precedence, report dict and row printing
    into sim/bin/_paired_compare.py. Tolerances, endpoint lists, derived-value
    functions and loaders stay in each script; report JSON and printed output
    are unchanged.
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2026-11-12 feat(report): grade the Thermal row from the 15-corner integrated-comparator hysteresis record
    The Thermal row graded the pre-#230 DC-temp record, which cannot resolve a
    hysteresis window. The generator now reads the qual-15corner hysteresis
    result.json and grades it against the existing experiment.json bounds,
    carrying the ff 180 C cap, uncovered scenarios and off-baseline toolchain
    into the row. No new simulation; item 8 pin re-minted.
2026-11-12 layout: regenerate core from integrated-comparator netlist and re-pin signoff items 3, 4, 11
    Re-run layout, LVS, ERC and area flows against the netlist with the M_RC*
    comparator devices; mint new append-only records (curated+official DRC clean,
    LVS match, ERC clean_partial, area FAIL 0.451931 mm2 vs <0.1 mm2, recorded as
    measured). Flow scripts netlist via `klt netlist` instead of raw xschem. The
    ERC supply spec's asserted well/substrate figures are re-derived from the new
    GDS. Signoff manifest/pins/verdict re-pinned; check.sh is hash-clean.
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2026-11-12 sim: mint PSRR C_eff x ESR reduced-sweep evidence record from fleet run
    Run psrr-cap-sweep-run.py on the batch backend (3 corners x 9 points x 2 loads),
    commit the minted record with its requests/responses/engine logs, and pass
    --wait-for-capacity 600 on batch submits. Worst sampled point per sub-metric is
    recorded under the fixed selection rule; no threshold or spec row changed.
    Part of #314
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2026-11-12 fix: record repo-relative GDS path in layout-flow DRC, re-pin item 3 to a new DRC record
    Adds a DRC-only append-only record on the already-pinned GDS so item 3
    grades input_verified: true, and updates signoff README items 3/4/11 to
    cite the current records.
2026-11-13 refactor(sim): extract the batch-fleet campaign core into _fleet_campaign.py
    The three `klt sim --backend batch` campaign drivers in `sim/bin/` carried one
    copy-pasted core each, and the two R_CZ drivers loaded `bias-retopo-pvt.py`
    through an importlib-by-path dance purely to reach its generic helpers. The
    copies had drifted (missing-`value` tolerance reached only one of the three),
    so a fix to one did not reach the others.
    Move the shared pieces into `sim/bin/_fleet_campaign.py`, beside the existing
    `_record_common.py` / `_probe_common.py` helpers: `preamble()` (worker cap,
    refuse-to-overwrite, `pdk.json` + `PDK_ROOT`), `netlist()` (candidate patch now
    an explicit argument instead of a cal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
2026-11-13 chore(signoff): re-mint the item 10 attestation for the new sim/README.md
    This PR's sim/README.md addition (the "Writing a new batch-fleet campaign
    driver" section) moved that file's bytes, and T1 item 10 attests it as a
    hygiene source -- so the committed envelope no longer reproduced and
    signoff/check.sh stage 1b failed with
    item 10 attestation drifted -- re-mint with klt signoff --attest 10
    Re-minted with the pinned grader check.sh itself uses:
    uvx --from klayout-tools==0.9.0 klt signoff --attest 10 \
    --inventory signoff/evidence/item10-inventory.json \
    -o signoff/evidence/item10-attestation.generic.json
    7/7 checks pass (five hygiene files present, `npm run lint` an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
2026-11-14 chore(signoff): re-mint the item 10 attestation for the updated README.md
    This PR's README.md edit (the T1 9/11 headline correction) moved the file's
    content hash, so the committed item 10 attestation envelope no longer
    reproduced and signoff/check.sh stage 1b failed the "Re-grade this block's
    T1 state" CI step.
    Re-minted with the grader check.sh itself pins (KLT_VERSION=0.9.0):
    Only README.md's content_hash moves (1e7341eb -> f8070fbf), the measured
    hash of README.md at this head; the attestation still reports 7/7 che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
2026-11-14 refactor: one shared file-SHA-256 helper and one strict digest normalizer
    Five independent file-SHA-256 sites — two of them returning a differently
    spelled digest under the same name `sha256_file` — and two read-side digest
    normalizers that disagreed about which recorded strings are digests at all
    are replaced by `layout/bin/_digest.py`:
    - `sha256_file(path)` — 1 MiB chunked, bare lowercase hex;
    - `sha256_file_prefixed(path)` — the `sha256:`-prefixed spelling `klt`
    provenance uses, for the envelope-writing callers, so one name no longer
    means two formats;
    - `normalize_sha256(value)` — the strict read-side normalizer (strips either
    spelling, tolerates padding and uppercase, r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
